natecostello/van_two_point_oh/README.md

# van_two_point_oh
Our second rodeo.

This is repository of design information for our second van build.  Ideally the contents will someday back a website.

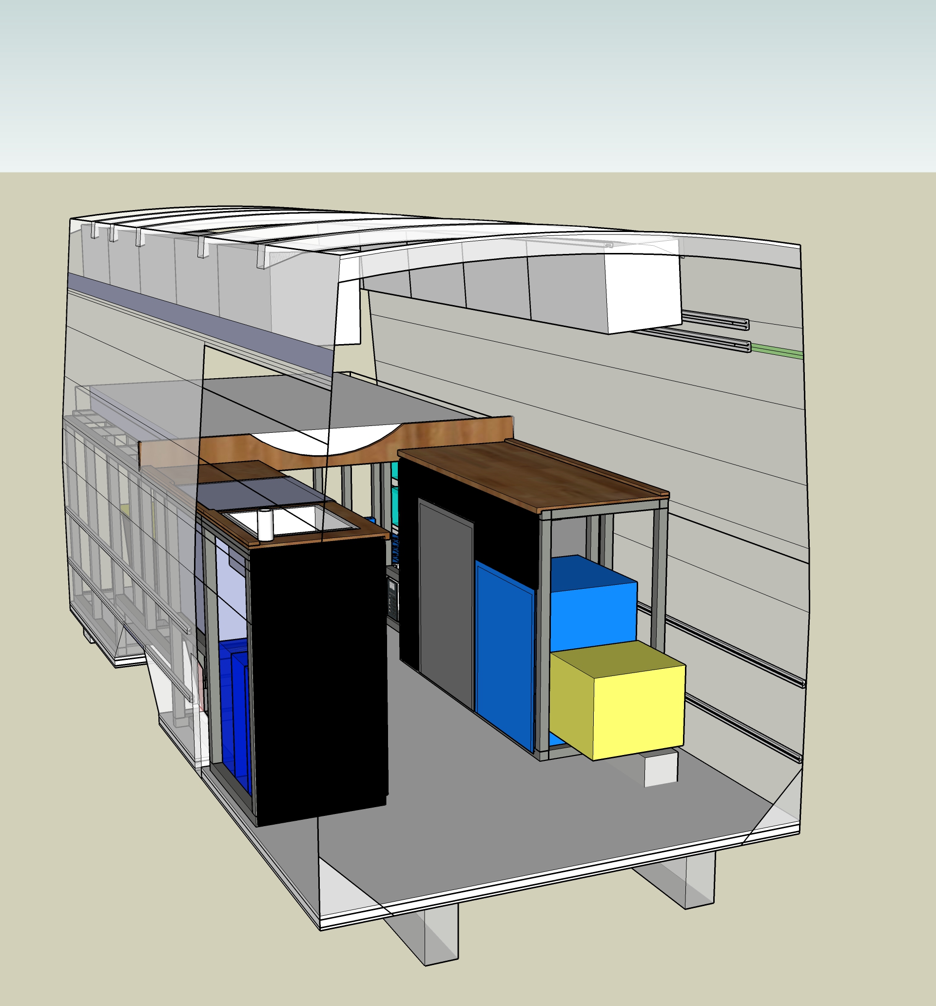
[picture p1: transit-layout-3D.jpg]
