natecostello/van_two_point_oh/van/mechanical/mechanical_overview/mechanical.mdx

---
type: categorypage
section: van
categories: 
 # one or more categories is permitted
 - structural
 - mechanical

title: '"relating to, governed by, or in accordance with the principles of mechanics"'
navTitle: Mechanical
author: Nate
date: 2021-06-06
tags:
	# no tags
metatags:
	# no metatags
cover: 
	# image file
 img: mechanical.jpeg
	# if attribution is needed
 source: Van One Point Oh
	# url: url
tldr:
---

This page provides an overview of all things mechanical.

# Structures
The structures in the van are build primarily from 8020 extrusions.

# Anchoring
All structures in the van are anchored by way of L-Track or 8020 that is inturn fastened to the van using bolts and plus-nuts.

# Fluid Systems
Water is blah
Gas is Blah.
