natecostello/van_two_point_oh/blog/2021-11-11-bus-bar-plating/bus-bar-plating.md

2021-11-10:
Plated for a few hours

2021-11-11:
Plated all remaining parallel bars

2022-2-7
Plated all remaining bars

3-16-22
Electroplated negative output bus bars

3-17-22
Electroplated positive output bus bars
