natecostello/van_two_point_oh/blog/2021-12-31-propane-system/propane-tank.md

2021-12-31
Designed and ordered propane tank brackets
Ordered bracket hardware

2022-1-4
Finished propane system design and ordered all pieces

2022-1-10
Fit check of tank + brackets (SAT)
Need to pick up two 1/4 MNPT couplings.
Installed all couplings on tank
Installed, torqued, locktited tank.

2022-1-24
Routed Propane Line

2022-1-25
Soph routed solenoid/level sensor wiring

2022-2-11
Soph primed/painted tank brackets

2022-2-15
Soph wired the stove and solenoid (internal) and relay
Soph wired the solenoid and level sensor

2022-3-26
Torqued compression fittings
Tested solenoid electrically

2022-3-27
Got tank filled
Leak tested with soap bubble test - SAT
Tested stove - SAT
