natecostello/van_two_point_oh/blog/2021-12-31-wall-panels/wall-panels-raw.md

2021-11-9:
Picked up 6 sheets of 1/4 PVC
Cut wall panel pieces (not sure if we actually used these)

12-31-2021
Confirmed upper factory holes are M8-1.25 and that thread starts ~ 1/2 below surface of wall/neoprene (so add to any length).
Also confirmed that lower strip of L-track will interfere with any bolt heads using those holes.

1-3-2022
Designed and placed order for wall panel stiffener brackets.

1-4-2022
Designed and placed order for wall panel 8020 attachment brackets.

1-6-2022
Cut two wall stiffeners
Modified one wall stiffener with wood "wedges" to account for angle.

1-11-2022
Test fit "wedged stiffener, to much wedge, not worth it
Upholstered sliding door panel as a trial and installed

1-12-2022
Cut wall panel 8020 brackets

1-13-2022
Cut wall stiffener brackeets
Soph installed plus nuts in wall stiffiner brackets
Soph installed puls nuts in wall panel 8020 brackets

1-15-2022
Marked, drilled, primed, painted holes for stiffiner bracket plus nuts
Cut 2 additional stiffiner panels
Angle drilled 8020 bolting holes to ensure flush/perpendicular bolting

1-16-2022
Installed plusnuts for angle stiffener brackets
Installed stiffener brackets and locktited
Installed wall panel 8020 brackets and locktited
Temp installed wall stiffeners for templating
Ordered fasteners and threaded inserts for fan and light switch mounting

Notes:
Fan Mount plate thickness for fastener length: 0.5 inches
Wall panel thickness for fastener length: 0.5 inches
Stiffener thickness for fastener length: 0.5 inches
Fan fastener head max diameter: 0.27 inches
Therefore need 1.25-1.5 inch long fasteners ([these](https://www.mcmaster.com/98164A444/)). 
(went short to allow mouting up in stiffener bracket region)

Light switch thickness for fastener length: 1.06 inches
Wall panel thickness for fastener length: 0.5 inches
Stiffener thickness for fastener length: 0.5 inches
Therefore need 1.75 to 2 inch long fastener

1-17-2022
Templated wall stiffener panels for fan, espar, and panel fasteners
Picked up two more expanded PVC sheets at homedepot

1-18-2022
Finished templating wall stiffener panels
Drilled wall panel stiffeners
Gun didn't work so couldn't urethane
Cut wall panels to width and length (except fwd panel)
Fitup wall panels and marked holes with transfer screws and random fasteners

1-19-2022
Added holes to passenger and driver side mid and aft wall panels.
Fit checked holes in passenger and driver mid and aft wall panels.
Sophia Upholstered passenger and driver side mid and aft wall panels.

1-20-2022
4 coats of spar urethane on wall panel stiffeners
Installed threaded inserts in passenger stiffener
Sophia added holes to the upholstered panels
Added disconnects to Passenger Fan
Added mating disconnects to Passenger Fan wiring (next time offset connectors for easier feed through)
Modified light switch to come apart easier
Installed passenger wall panels (holes are tight).  Requires stove bracket loosening and sliding stove forward...keep in mind.
Installed light switch
Installed passenger fan

1-23-2020
Sophia installed threaded inserts on panels
Sophia swapped L-track spacers for 1/2 inch

1-26-2022
Soph added 5/16 plus nut for passenger fwd panel fastening
Soph added through bolted passenger fwd panel in two more locations on fwd edge
Soph increased hole size on driver side panel
Soph installed driver mid panel

1-31-2022
Installed driver aft panel
Installed driver fan
Tested both fans SAT

2-28-22
Soph cut forward driver panel

3-1-22
Soph covered and installed forward driver panel
