natecostello/van_two_point_oh/blog/2021-7-4-battery-interconnect-fab-trial/battery-interconnect-fab-trials.md

---
type: post
section: blog
categories: 
 # one or more categories is permitted
 - electrical
navTitle: 
title: Battery Interconnect Fabrication Trials
author: Nate
date: 2021-07-04
tags:
 - build
 - electrical
 - battery
 
metatags:
	# no metatags
cover: 
	# image file
 img: interconnect-cover.jpeg
	# if attribution is needed
	# source: [vecteezy]
	# url: url
tldr: 'We performed some fabrication trials of our series and parallel interconnects.  We concluded that portions of the design were not able to fabricated.  Based on these lessons we planned another design iteration.'
---
**TLDR: We performed some fabrication trials of our series and parallel interconnects.  We concluded that portions of the design were not able to fabricated.  Based on these lessons we planned another design iteration.**

We laid out our plans and design for our battery interconnects in a [previous post](/blog/2021-6-26-battery-interconnect-design/battery-interconnect-design).  Start there if you want some context.  This is post is about the difference between theory and practice.  Hah.  

## The Process

We received our initial (test) batch of flat copper bus bars from [sendcutsend.com](http://sendcutsend.com) on Friday, and got super excited.  We spend Saturday thinking about how we might actually form them into the desired shape.  Honestly, we'd been mulling that over since the design post or before, but nothing focuses the thought like the immediacy of a task.  Despite a lack of a final plan, we went to Home Depot to pick up some M6 bolts, nuts, wood dowels, and some bar stock that we figured would be useful in any case.
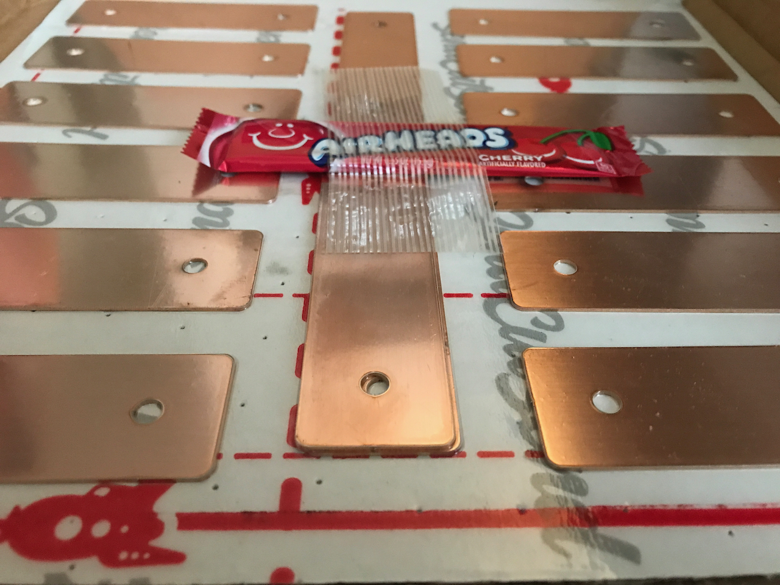
[picture p106: blog/2021-7-4-battery-interconnect-fab-trial/sendcutsend.jpeg]
sendcutsend delivery

_These people rock.  Seriously.  Fast service, accurate tolerancing, and free airheads.  What!_

One of us awoke this morning with a vision for bending and set off for the garage and the table saw within it.  The sensible other joined later.

Our approach involved all wooden parts, except the bolts and nuts.  We use a short piece of dowel cut in half to start the bend.  We help that by driving the ends of the busbar inward.  The wood pieces are sized to fit together so that when everything is fully scrunched, the holes are in the right locations.  That was the idea at least.

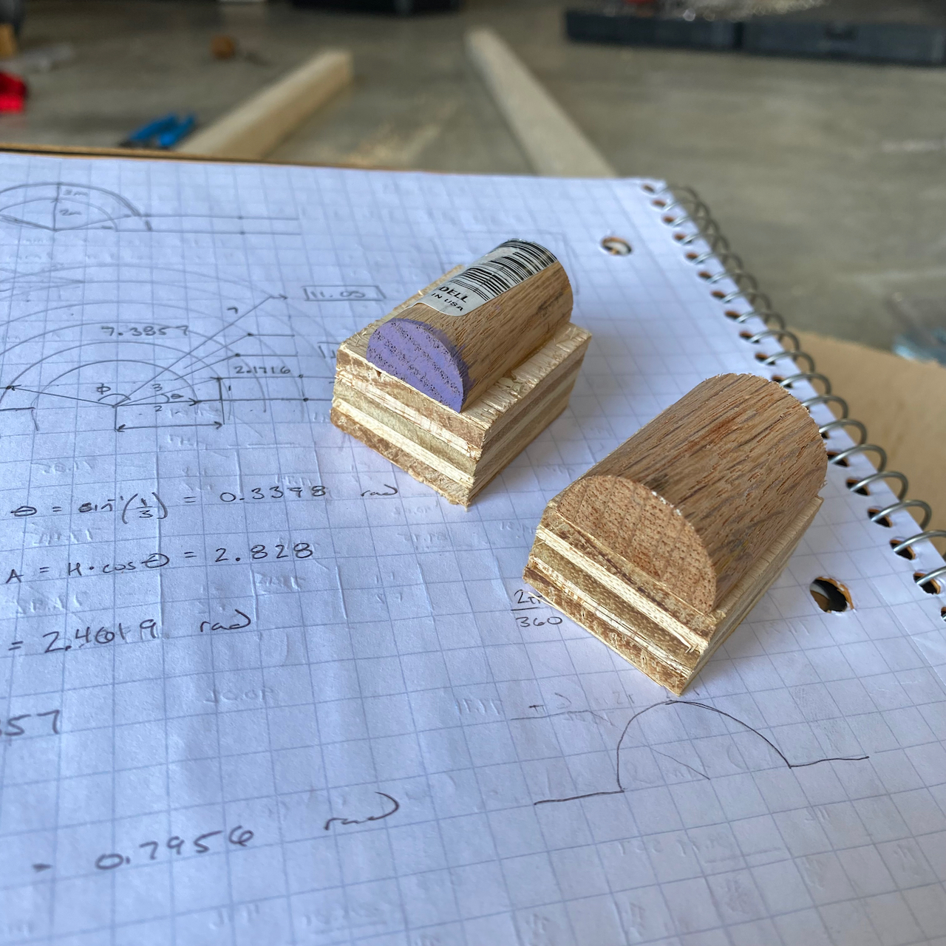
[picture p107: blog/2021-7-4-battery-interconnect-fab-trial/mandrels.jpeg]
mandrels

_These are two mandrels, one for 3/4 inch diameter bends, and one for 1 inch diameter bends (just in case).  They are sitting on some bending math_

The flat bus bar passes over two M6 bolts on two independent pieces of wood that can slide closer or farther from each other.  Those pieces of wood are kept from moving "out of plane" by two other pieces of wood that hold them down but let them slide.
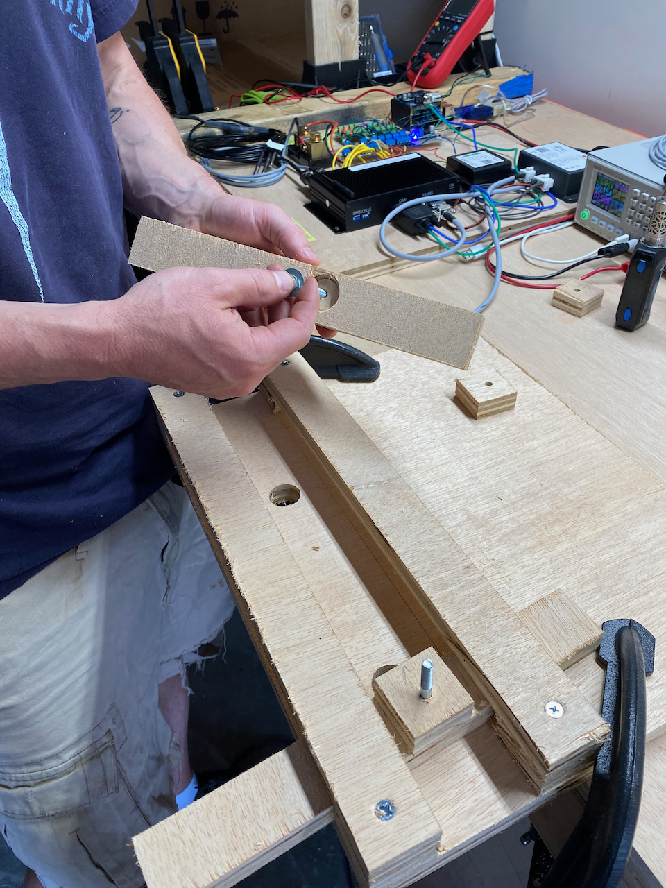
[picture p108: blog/2021-7-4-battery-interconnect-fab-trial/wood-bolt.jpeg]
wood sliders


Two more peices of wood go over the bolts and it all gets tightened down with nuts and washers.  Then come the "mandrel" and clamps.  We use one clamp to force the mandrel down into the bus bar.  Then we use the other clamp to push the two sliding pieces of wood toward each other.

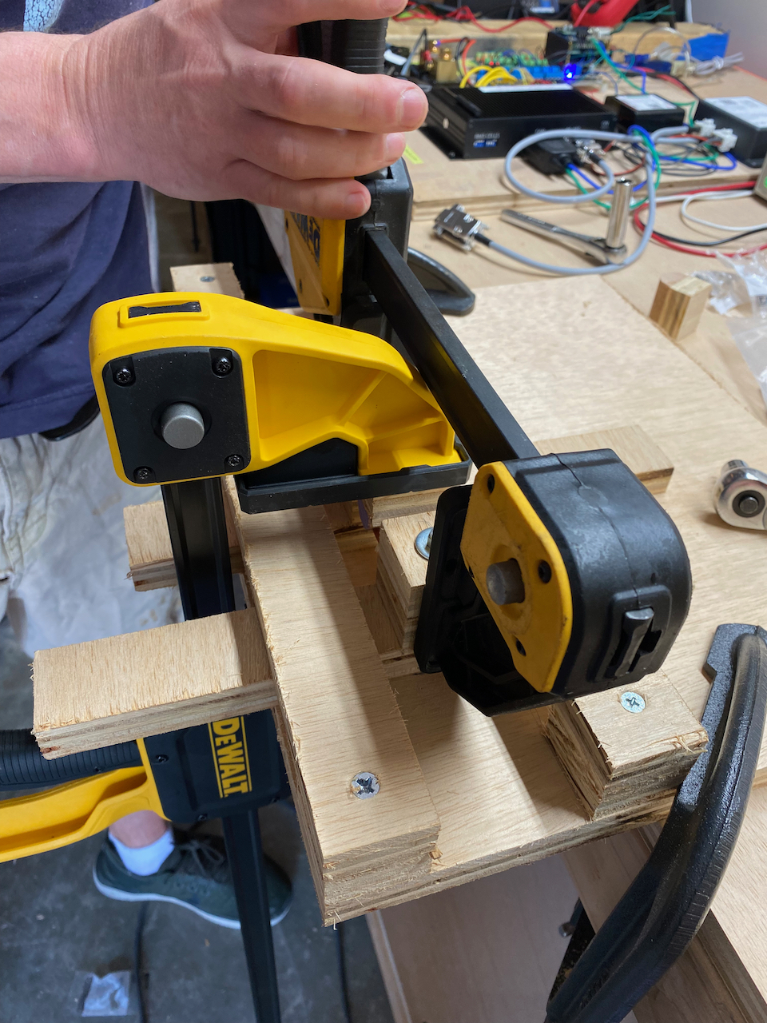
[picture p109: blog/2021-7-4-battery-interconnect-fab-trial/clamps.jpeg]
clamps


We alternate the clamps until the two sliders are as close to each other as they can get.  At that point they are touching the mandrel which prevents further movement.  Thats it.  You have a fully formed busbar.  

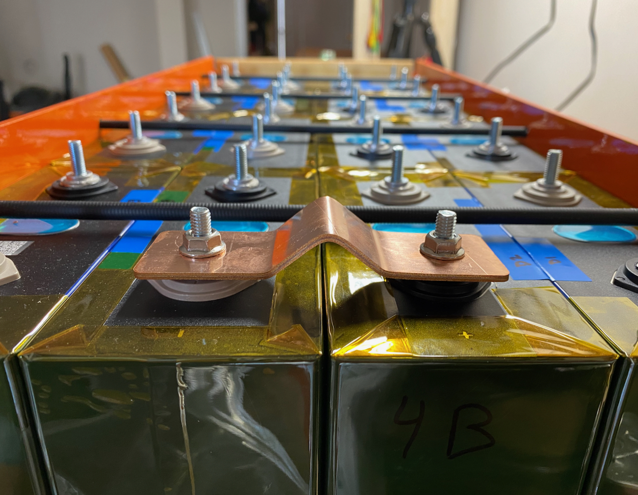
[picture p110: blog/2021-7-4-battery-interconnect-fab-trial/interconnect-installed.jpeg]
Final interconnect


I'm sure that all sounds confusing.  This time-lapse will make it more clear.

`vimeo: https://vimeo.com/571057210`

## The Learning

We learned a few things:

- We might want to go slightly larger on the holes.  Like 0.25 mm or something.  They are pretty tight on the posts.
- We are able to form a stack of two bars at once so the parallel connection fabrication method is proven.
- The process produces triangular vs round bends (no surprise given the process).
- We CANNOT form a stack of five bars at once.  We think we are at the limits of geometry and copper compliance.  But we think we have a solution with using multiple sets of slightly longer bars and different mandrels to make a stack of five stack tightly.  This is required for the endmost series connection which is in the athwart direction.

Based on that last lesson, we may retreat to straight slotted bars for the other series connections due to the lower fore-aft cell growth and no concern about contact area for those connections.

Then we watched fireworks.  Happy July 4th!
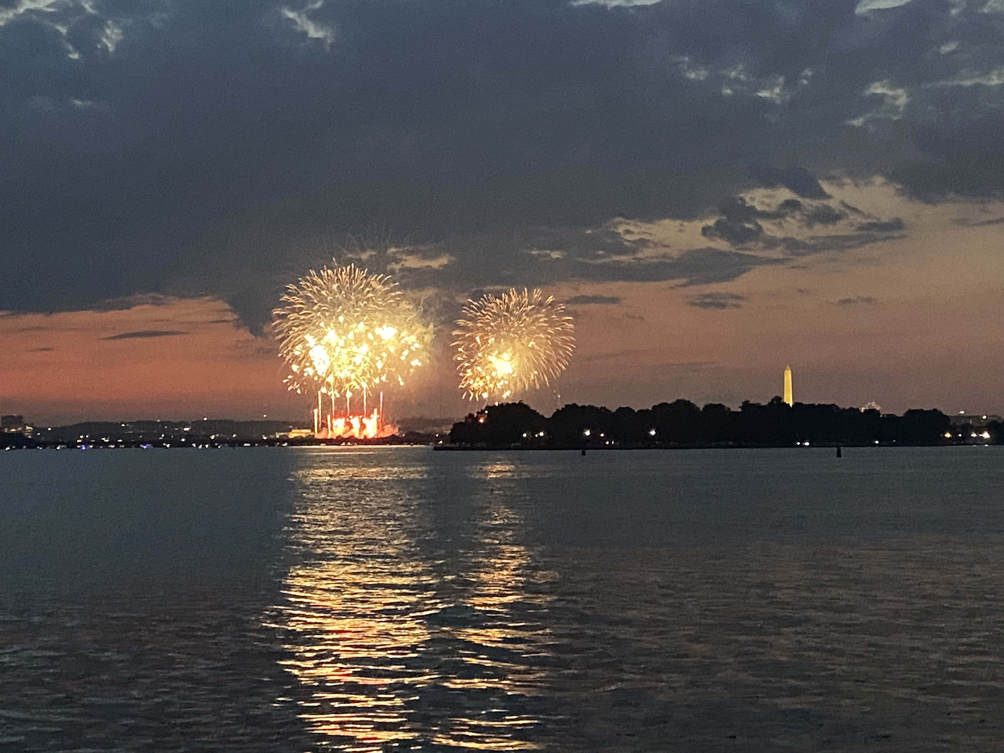
[picture p111: blog/2021-7-4-battery-interconnect-fab-trial/fireworks.jpg]
fireworks over the potamac
