natecostello/van_two_point_oh/blog/2022-10-19-mistygate/mistygate.md

Going the slider route.

These are low-profile enough to clear the door:
https://www.accuride.com/en-us/products/2907-light-duty-low-profile-slide-with-over-travel

The length will be the 24" model.
Weight: 

Will need to double up 8020 to mount on bottom, maybe top.  Will mount flat overhanging bar to the face, and then tuck 1/4 wood panel behind, hole saw'ed out in an array for ventilation.

Can mount to 80/20 using https://www.tnutz.com/product/qt-015/ #8-32 tnuts and screws.  Will need to source low head #8 machine screws.  These [screws](https://www.mcmaster.com/90357A003/) could/might/did work.

Will VHB 1/8 by 3" Flat bar to top and bottom slider
Weight: 24"*2 is 1.76 lbs

Grate material will VHB behind the flat bar.

10-19-2022
Ordered low profile 8-32 1/2" screws.
Ordered sliders.

10-29-2022
Installed sliders

?
Purchased grate material

12-16-2022
Purchased Aluminum flat bar

1-1-2023
Installed aluminum bar with VHB
Installed grate, but too floppy and not holding (should have scuffed)

1-2-2023
Ordering 1/2 1/8 aluminum flat bar for verticals
https://docs.google.com/spreadsheets/d/1BjMtbgCNEiRAJeGTX1tJmbIwtguQ2OwXgFV9McPPzyY/

1-3-2023
Picked up flat bar
Wrapped in black contact paper and VHB'd into place
Realized it was to easy to turn into a parallelagrem
Trimmed grate to fit in front of bars and zip tied into place
Zip ties to large and bump 8020 on open and close

1-4-2023
Replaced zipties with smaller ones, now no interferance
Disabled lower lock on sliders with metal clips

2-16-2023
Disassembled mistygate and drilled out lower locking mechanism.  Much smoother.

2-17-2023
Rebuilt mistygate with rub between lower rail and nosing eliminated, better ziptie-ing.  Works great.
