natecostello/van_two_point_oh/blog/2022-2-11-main-lights/main-lighting.md

2022-2-11
Routed new 12/2 cable from panel area to upper d-pillar
crimped extensions on LED strips
Cut and installed track
installed LED strips
wired controller
installed controller with 3m super velcro to top of driver's l-track
wired controller, and synced controls.
test SAT!
