natecostello/van_two_point_oh/blog/2022-2-3-overhead-shelf/overhead-shelf.md

2022-2-3
Soph installed the van-wife shelf
Open question about extra brackets (soph emailed them)
