natecostello/van_two_point_oh/blog/2022-3-5-side-tables/sidetables.md

3-5-2022
Picked up okoume for side tables
Cut side tables at wood shop

3-6-22
Formica'd one side table top

3-8-22
Formica's one side table top
Trimmed formica
Eurethaned side table panels

3-10-22
Finished side table design
Cut end panels
Added pocket screw holes
Cut tops

3-12-22
Urethaned all side table pieces
Assembled one side table

UPDATE:
Assembled second side table 3-14?
Installed side tables 3-14?
Installed outlets?
