natecostello/van_two_point_oh/blog/2022-3-8-reading-lights/reading-lights.md

3-7-2022
Soph drilled, fitcheck panels, painted and primed.

3-8-2022
Installed and wired reading lights into panels using and installed panels usng spacers and clipnuts and #6 hardware.
Wired reading lights.
