natecostello/van_two_point_oh/blog/2022-3-?-slider-storage/slider-storage.md

not sure
installed slider structure

not sure
installed sliders

3-25-22
Cut and drilled slider angle

3-26-22
Cut and urethaned slider drawer panels
Pocket drilled slider panels
Build slider drawer

5-9-22
uninstalled slider and replaced with bins

test-delete
