natecostello/van_two_point_oh/blog/2022-5-14-BMS-firmware-update/firmware.md

REC provided a [firmware update](bms_1Q_1845_end_voltage_drop_zero_curent.bin) that should provide the cycling behavior we desire.  Specifically, once the battery is full, all charging should stop and the battery should discharge until a given point until charging reverts to bulk.

Got a hardware/software mismatch message when resetting BMS.
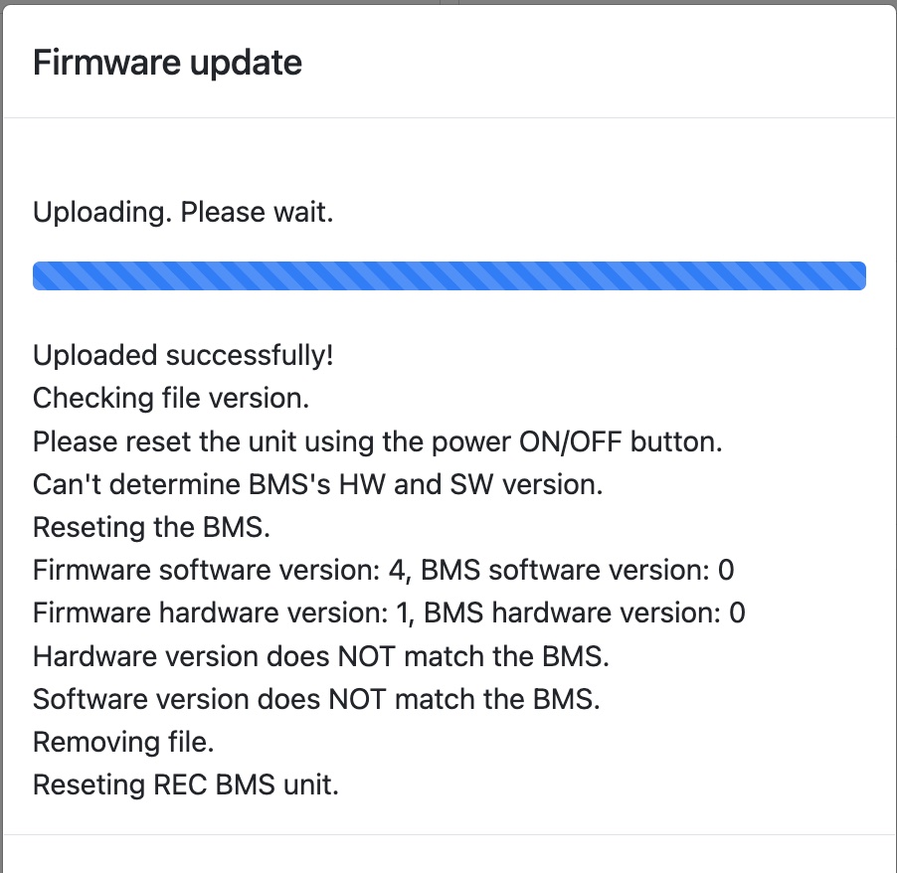
[picture p154: blog/2022-5-14-BMS-firmware-update/update-message.jpg]


Will try to reset with shorepower applied so router remains powered and connection to wifi module is maintained in case this is the problem.

This worked and update occurred successfully.
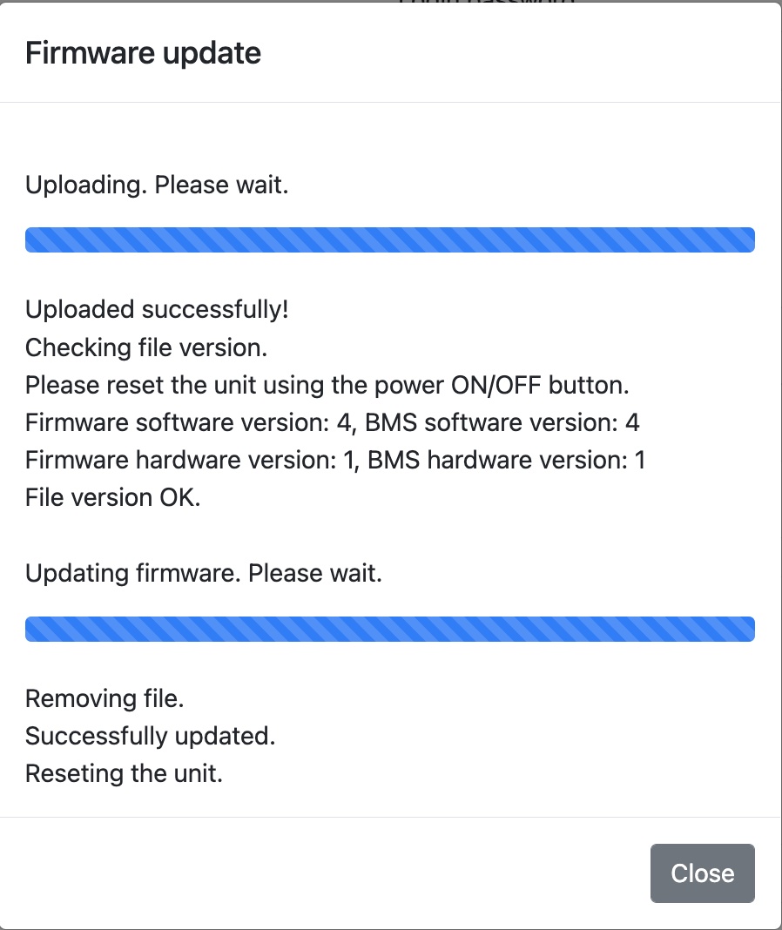
[picture p155: blog/2022-5-14-BMS-firmware-update/update-message-successful.jpg]


BMS Software version is now 2.8 (was 2.6).

Will run a shorepower charge to observe behavior at end of charge.  Recall SOCH is 0.15 so it should cycle down to 85% SOC prior to resuming a bulk charge.

2022-5-19
Based on emails from Tine, begrudgingly set CHAR to 3.5V and MAXH to 0.15 (MAXC-CHAR).

5-27-2022
Terminated logging pi with a DTM connector to interface with wakespeed CAN and ring terminals for 12V power.
Unsolderd/Soldered logging pi for standard vs OBD2 can.

2022-5-29
Connected loggingPi to power, and verified accessible over SSH.

Connected wakespeed to Victron CERBO, removed Victron CAN terminator, and added wakespeed CAN terminator at wakespeed.

Connected loggingPI to wakespeed CAN via harness DTM connector.

Verified REC was still communicating with CERBO via the local web interface.

Verified loggingPI can read REC data over CAN using this script: https://github.com/natecostello/REC-BMS_CAN

2022-6-10
Identified that SOC has dropped below 85% yet charging hasn't started.  Based on a read of the manual for the latest firmware, this is because SOC must be < 100 - SOCH AND Max cell Voltage < CHAR - CHIS.  In our case that is equal to 3.25V.  Based on this we are going to modify CHIS to adjust for our lower CHAR.  Default: CHAR (3.58) - CHIS (0.25) = 3.33. Cell voltage should be below 3.33V at 85% SOC, so we will us CHIS = 3.5-3.33 = 0.17

Based on this change we saw PV charging start and the CCL ramp from zero up to 280A.

Also modified BMS auto testing code to log charging events (or any event).  Charging off shore at near multiplus limit and logging response (to finally get some detailed data).

2022-6-29
Changed SOCH to 0.6 to allow to cycle down to 40% SOC.  With Alternator charging its been cycling 80-100 daily.  Will reconsider once a switch for alternator charging is implemented.
