natecostello/van_two_point_oh/van/electrical/alternator_charging/alternator_charging.md

---
type: article
section: van
categories: 
 # one or more categories is permitted
 - electrical
navTitle: 
title: Alternator Charging
author: Nate
date: 2020-10-26
tags:
 - 24v
 - design
 - concept
 - electrical
 - van
 - alternator
 - charging
 - factory

metatags:
	# no metatags
cover: 
	# image file
 img: alternator-cover.JPG
	# if attribution is needed
	# source: [vecteezy]
	# url: url
tldr:
---

**TLDR:** The APS [24V 185A alternator](185-hpi-series-high-output-alternators.pdf) will provide a ~4800KW charge rate during highway driving (70 mph) and SEIC high idle (2050 RPM) conditions.

Alternator charging using a dedicated 24V alternator will provide for rapid battery charging.  We plan to make use of Ford's Stationary Elevated Idle Control (SEIC) to maximize charge while parked and needing to charge.

## Factory Alternator Charging

Factory alternator charging was originally being considered to supplement the dedicated 24V alternator.  This could add up to ~2000W charge rate.  We elected not to implement this due to lack of need, additional complexity and weight.  See the deprecated version of this page for design information related to this option and lots of additional save-for-posterity information.

## Second Alternator Charging

Two alternators are under consideration for the second alternator charging source.  Nations, per discussions via email, can provide a [24V 150A alternator](24v-150-specs.pdf).  American Power Systems, per telephone discussion, can provide a [24V 185A alternator](185-hpi-series-high-output-alternators.pdf).

APC vs Nations
_Note: 630 RPM is base idle, 800 RPM is the SEIC minimum, 2050 RPM is 70 mph cruise, 2400 is the SEIC maximum._ 

### Comparison Details

The details are in this [google spreadsheet](https://docs.google.com/spreadsheets/d/1PZ28vauZOBcX5VKHcEtaARwbSTpMoWLsqBCX2Hrulv8/edit?usp=sharing). I took the data sheets for the two candidate alternators, and used a 6th order polynomial fit on the performance data points.  The crank pulley diameter is 6 inches, inferred from APS alternator test data and help from the forum.  From the polynomial fit and the respective pulley ratios, the estimated performance curves can be overlaid.  The 3.5 pulley ratio was taken from the Nations datasheet as "typical" but is not confirmed.

While the idle performance of the Nations alternator is superior, substantially higher charge rates are possible with the APC alternator under higher SEIC and cruise conditions.  On that basis, we have selected the APS.  Based on an email with Jim at APS, the APS alternator cuts off below 1905 RPM.  In a followup email he confirmed the cutoff occurs at 1905 alternator-RPM which corresponds to 650 engine-RPM.  This cutoff would predict no alternator charging at idle.  **Update:** Based on testing, this prediction is correct.  The APS option does not provide any charging at normal minimum idle.

### Regulator

We plan to use a Wakespeed WS500 for regulation and charge control from the second alternator.  It is proven to integrate well with the REC BMS and Victron ecosystem.

### Snubber

We will use this [Stirling Alternator Protection Device](sterling-alternator-protection-device) to function as a last line of defense to an inadvertent "load shed" that can damage an alternator.  If the alternator is sourcing high current to a load (i.e. battery) and the connection is broken without warning a high voltage is developed at the output of the alternator that can fail the high power rectifier diodes in the output stage of the alternator.  This voltage transient is either due to the alternator suddenly being in a max field, high speed, yet open circuit condition OR due to inductive kick from the alternator's inductance trying to maintain current flow under a step change to high impedance.  Probably the latter, maybe both.  I haven't gone into the details but know from experience the transient is completely credible and likely.  This should never happen.  Before the BMS ever opens the main contactor as a protective measure, it is supposed set its Charge Current Limit to 0 amps via CANBus and set CHARGE-ENABLE to "low" seconds before it opens the relay.  But in case the software protection fails, and the primary hardware backup protections fails, this provides a second hardware backup to physically limit the magnitude of the transient voltage developed by the alternator.
