natecostello/van_two_point_oh/van/electrical/circuits/circuits.md

---
type: article
section: van
categories: 
 # one or more categories is permitted
 - electrical
navTitle: 
title: Circuits
author: Nate
date: 2020-10-26
tags:
 - wiring
 - design
 - concept
 - electrical
 - van

metatags:
	# no metatags
cover: 
	# image file
 img: circuits.jpeg
	# if attribution is needed
	# source: [vecteezy]
	# url: url
tldr:
---

This article describes the power circuits planned for the van and evaluates required wire gauge for those circuits.  All calculations are contained in [this google spreadsheet](https://docs.google.com/spreadsheets/d/1JnF0Kgj202dYR1sIlWKawStD7OvVsGdwfCOEQsTpghI/edit?usp=sharing).

## Outlet, Switch, Control Locations

120VAC outlets will be in the following locations:

* Comm Area
* Garage Area
* Counter Level - Driver Side 
  * [This](https://www.farmandfleet.com/products/148585-carlon-shallow-box.html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) (1.25 depth) or [This](https://www.zoro.com/cantex-electrical-box-square-pvc-ez08sf/i/G3145073/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) (1.25 depth) could place these against bed
* Counter Level - Passenger Side
* Under Counter - Driver Side
* Under Counter - Passenger Side
* Slide Door Area

USB C Outlets will be in the following locations:

* Counter Level - Driver Side
* Counter Level - Passenger Side

12VDC Outlets will be in the following locations:

* Upper Shelf - Driver Side
* Comm Area

Heater Control will be located in/on the driver side bed side cabinet.

Max Fan Control will be located in/on the driver side bed side cabinet.

Water Pump On/Off will be located on the side of the sink cabinet, easily accessible from outside with the door open.

Gas Solenoid On/Off will be integrated into the oven on/off switch.

Light On/Off/Dim will be located on the side of the sink cabinet, easily accessible from outside with the door open.  There will also be a switch located in the bed area on the passenger side in the bed side cabinet.

## 120VAC Circuits

Based on the 30A rating of our Shorepower ELCI Breaker and the AC Main Breaker, all AC wire between the Shorepower connection and the AC Main Breaker Panel will be 12AWG triplex marine wire.  Branch circuit AC wire and AC wire between the factory-alternator-inverter will be 14AWG triplex marine wire.

### Shorepower

The shorepower circuit will run from the outlet under the driver side rear bumper, up inside the D-pillar, forward through the driver wall void to the shorepower ELCI main breaker.  From that breaker it will tie locally to the shorepower/factory-alternator-inverter transfer switch.  The transfer switch will then tie to the AC input power connection on the Multiiplus 24/3000.  One way length is 11.8 ft (93+24+24").

### Factory-Alternator-Inverter

The factory-alternator-inverter circuit will run from the inverter location, forward of the freezer cabinet, aft through the driver wall void to the transfer switch adjacent to the AC Main Panel.  One way length is: 10.7 ft (80+48").

### Branch Circuit

The branch circuit will run from the AC Main Panel, aft through the driver wall void, to a GFCI outlet in the driver side rear garage, forward through the driver wall void, to an outlet inside the aft most driver galley cabinet, up to an outlet in the driver bed/counter region, down to the driver wall void, up and inside the C-pillar, across the C-pillar roof beam, down and inside the passenger C-pillar, into the passenger wall void, to an outlet inside the aft most passenger galley cabinet, up to an outlet in the passenger/counter region, down through the passenger galley to an outlet on the side of the sink cabinet.  The one way length is: panel to driver side rear garage and back (93+24+93+24) + inside the driver galley and up to the driver counter and back (60+60) + down to, up though over, and down through the c-pillar (268) + to passenger cabinet and up to passenger counter and back (68+68) + to end of sink cabinet (67).  Total one way length is 68.75 ft.  [Post-install update: we added a short run of triplex from the outside rectangular hole in the by the bumper to parallel off the GFCI]

## 24VDC Circuits

### Water Pump

The Water Pump is a Shurflo Aqua King II Supreme 5.0.  Shutoff current is 6A at 25.6V.  Open flow current is 2A at 25.6V.  The pump will be located in the sink cabinet.  The feed and return will run from the 24V electrical panel up and inside the driver C-pillar column, across the C-pillar roof beam, down and inside the passenger C-pillar column and into the sink cabinet.  Estimated round-trip length is 55.8ft (2x(268+67)").  Acceptable wire gauge is 12AWG.

### Fridge and Freezer

The Fridge and Freezer combined are 83W, corresponding to ~3.5A at 24V.  They will share a circuit.  The feed and return will run from the 24V electrical panel, forward through the driver wall void, and into the top of the fridge cabinet (where the fridge and freezer compressor are located).  Estimated round-trip length is 13.3 ft (2x80").  Acceptable wire gauge is 16AWG.

### Air Compressor

The onboard air system will notionally use a [Viair 400C](viair-300c-manual.pdf) compressor with a peak draw of 12A.  Based on the wire diagram for the dual compressor configuration, separate relays are controlled by the pressure switch, thus separate feeds from the power source are fine.  Thus we assume 12A and will add a second wire run for a dual system if desired down the road. The feed and return will run from the 24V electrical panel forward through the driver wall void, though the C-pillar, down through a wall void floor cut, under the van along frame and to the passenger rear corner.  Estimated round trip length is 33 ft (2x(93+77+30)").

Based on the wire gauge guide in the manual, it follows the ABYC Critical (3%) voltage drop guidance for 24V assuming the manual wire length is round trip.  Based on this, required wire guage is 10AWG or sharpen the pencil on length (cutting 30" gets below 3% with 12AWG).

### USB Outlets

USB outlets will be located PORT and STBD at the foot of the bed/start of counter.  Each side will have a bluesea below deck panel, modified with a 24V breaker, and will house two double-USB sockets.  The USB PD spec allows for power up to 100W via USB-C.  We will assume this standard, which would require 200W at each outlet location.  This corresponds to 8.3A each, thus they will each have their own circuit.

The driver feed and return will run from the 24V electrical panel up to the outlet.  Estimated round trip length is 10 ft (2x60").  Acceptable wire guage is 16AWG.

The passenger feed and return will run from the 24V electrical panel forward through the driver wall void, up and inside the driver C-pillar column, across the C-pillar roof beam, down and inside the passenger C-pillar column, aft through the passenger wall void, and up to the outlet.  Estimated round trip length is 56 ft (2x(268+68)").

Required wire gauge (using passenger side limiting case) is: 10AWG.  Assuming 12AWG at 25C, voltage drop is 3.15, and under 3% if 36" can be eliminated.  We will plan to use 12AWG.

__Note: The USB PD 3.1 spec allows for power up to 240W via USB-C.  The cable requirements to supply two 240W sockets at 24V is excessive (8AWG or greater).__

### LED Strip Lights

Four runs of LED strip lighting will run fore-aft in the van along the ceiling and walls.  [This Govee package](/van/functional/lighting/lighting) is the preferred option.  Power for the full length is 60W corresponding to 2.5A.  One switch will be located on the side of the sink cabinet near the entry way.  Another switch will be located on one side of the bed.  The dimmer/control will be located adjacent to the switch by the bed.  Feed and return will run from the 24V electrical panel, forward through the driver wall void, up and inside the driver C-pillar column, across the C-pillar roof beam, down and inside the passenger C-pillar column, out and up to the switch on the forward side of the sink cabinet.  From that switch it will run back inside the passenger wall void aft of the c-pillar and up to a switch by the passenger side bed.  [Post-install update: For the run between the galley and bed switches, we ran 12x3 triplex since three wires are required.]

Estimated round trip length is 78.3 ft (2*(268+67+67+68)"). Acceptable wire gauge is 12AWG.

We will also want to run two sets of 4 wire to splice in after the controller that runs to the start of the LED strip lighting.  The best location for the start of the LED strip lighting is the forward edge of the ceiling. [Post-install update: For the run from the lighting controller to the lights we ran two sets of 16x4 ancor trailer wire.]

**Update:**

We are pivoting to [these](https://www.ledsupply.com/led-strips/tunable-white-cob-led-strip-lights) lights instead and wireless controls.  We are also moving theh lower light strips down to the surface of the bed side tables and counter top.  We are ending the ceiling lights at the curved transition of the roof.  This means four run that are > 12ft.  This corresponds to a total load of 205W or 8.5A up to the driver.  From the driver on to the LED strips it is 2.2A.  Driver will be located above ceiling panel on driver side at rear.  Estimated round trip length to driver is 32.2 ft (2*(93+80+20)) at 8.5A.  From the driver, the limiting run is over to passenger side, down d-pillar, up to aft end of side table (plus margin) for 30 ft 2*(40+80+40+20) at 2.2A.  Based on these numbers, 12AWG duplex from the panel to the driver is acceptable.  14AWG triplex from the driver to lights is acceptable.

Wireless (Battery Powered) Controllers will be located at the passenger door and near foot of bed.

### Reading Lights

The two reading lights will be located in the rear overhead pillar.  The feed and return will be run from the electrical panel aft through the driver wall void, up and inside the D-pillar and to the overhead rear pillar.  Estimated round trip length is 42.3 ft (2*254"). Acceptable wire gauge is 16AWG.

### Exterior Lighting:

Exterior lighting will be handled in the future.  It will probably consist of four separate circuits (Front, rear, PORT, STBD).

### Bed-side Fans

The two Sirocco II fans combined are ~12W corresponding to ~0.5A at 24V.  They will share a circuit.  The feed and return will run from the 24V electrical panel, up to the driver fan, down, forward through the driver wall void, up and inside the driver C-pillar column, across the C-pillar roof beam, down and inside the passenger C-pillar column, aft through the passenger wall void, and up to the passenger fan.  Estimated round-trip length is 76 ft (2x(60+60+268+68)").  Acceptable Wire gauge is 16AWG.

### Propane Solenoid

The propane solenoid load is ~20W corresponding to ~0.8A at 24V.  The feed and return will run from the 24V electrical panel up and inside the driver C-pillar column, across the C-pillar roof beam, down and inside the passenger C-pillar column and into the stove cabinet to a relay, from the relay into the passenger wall void, though a wall void floor cut, under the van along the frame to the propane tank behind the rear differential.  Estimated round-trip length is 72.7 ft (2x(268+36") + 2x(36+36+60)".  Acceptable wire gauge is 16AWG.

### Outlets (Driverside Overhead Shelf)

Originally planned for this cable to be 12V however the required guage is a deal breaker, so we will run 24V and convert locally if needed.  This cable run will be for future expansion.  Assume 200W at 8.33A load.  The feed and return will run from the 24V fuse block forward though the driver wall void, up and inside the C-pillar, forward through the upper driver wall void to the overhead shelf region.  Estimated round trip length is 41.2 ft (2x247").  Acceptable wire gauge is 12 AWG.

## 12VDC

### Communication/Computation

These loads are all local to the 12V fuse block such that their wiring will not be factored into any bulk cable purchase/size determination.

### Heater:

The B4L max load is <= 100W corresponding to ~8A at 12V.  The feed and return will run from the 12V fuse block aft through the driver wall void, to the heater ~~just aft of the driver rear wheel~~ just forward of the freezer.   Estimated round trip length is ~~2x52"~~ 2x(68+40).  Required wire gauge is 12AWG.  [Post-install Update: We just used the stock power line from the heater, which should be sized appropriately.]

### MaxxFan

The MaxxFan load is ~38W corresponding to ~3A at 12V.  The feed and return will run from the 12V fuse block aft though the driver wall void, up inside the D-pillar, across the D-pillar roof beam to the fan.  Estimated round trip length is 2x254".  Wire gauge is 12AWG.

### Oven

The oven max load is not listed in the manual but is expected to be minimal (LEDs, sparkers, and relay modification) and bounded by any other 12V components.  The feed and return will run from the 12V fuse block up and inside the driver C-pillar column, across the C-pillar roof beam, down and inside the passenger C-pillar column and into the stove cabinet.  Estimated round trip is 50.7 ft (2x(268+36)").  Acceptable wire guage is 16AWG.

## Routing Length Notes

* 24V electrical panel forward through the driver wall void, up and inside the driver C-pillar column, across the C-pillar roof beam, down and inside the passenger C-pillar column = 268"  
* Passenger C-pillar column, out and up to the switch on the forward side of the sink cabinet = 67"
* 24V electrical panel, forward through the driver wall void, and into the top of the fridge cabinet = 80"
* Passenger C-pillar to foot of passenger side of bed = 68"
* 24V panel to foot of driver side of bed = 60"
* 24V panel to base of driver D-pillar = 93"
* Base of driver D-pillar, down to passenger D-pillar = 77"
* Base of passenger D-pillar to compressor mounting area = 30"
* Driver C-pillar to forward of freezer estimated to 40"
