natecostello/van_two_point_oh/van/electrical/inverter/inverter.md

---
type: article
section: van
categories: 
 # one or more categories is permitted
 - electrical
navTitle: 
title: Inverter
author: Nate
date: 2020-11-03
tags:
 - inverter
 - design
 - concept
 - electrical
 - van

metatags:
	# no metatags
cover: 
	# image file
	# img: img
	# if attribution is needed
	# source: [vecteezy]
	# url: url
tldr:
---

The van will use an inverter/charger to convert DC to AC power to supply AC loads.  It will also allow battery charging while on shore power.

## Selection

Based on our experience, we will be using a Victron inverter/charger.  The two choices, given our 24V DC system, are the Multiplus 3000VA  and the Multiplus Compact 2000VA inverter/chargers.

Advantages/Disadvantages
