natecostello/van_two_point_oh/van/electrical/knock-off-panels/knock-off-panels.md

This is a place holder for custom panels for contura switches and usb plugs.
