natecostello/van_two_point_oh/van/electrical/ShorePower-AuxSolar-Connection/Shore-Power-and-Aux-Solar-Connection.md

---
type: article
section: van
categories: 
 # one or more categories is permitted
 - electrical
navTitle: 
title: Shore Power and Auxilliary Solar Connection
author: Nate
date: 2020-10-26
tags:
 - shore power
 - solar
 - design
 - concept
 - electrical
 - van

metatags:
 # none
cover: 
	# image file
	# img: img
	# if attribution is needed
	# source: [vecteezy]
	# url: url
tldr:
---

Our shore power and auxilliary solar panel connection will copy the Lorax by connecting under the rear pillar.  He provides some details in [this post](https://www.fordtransitusaforum.com/threads/the-lorax-build-thread.72698/post-1074290). 

The solar panel connection is from AM Solar, [here](https://amsolar.com/rv-connections/plug-prtbl-batt-8ga).
