natecostello/van_two_point_oh/van/functional/heating/espar_location.md

---
type: article
section: van
categories: 
 # one or more categories is permitted
 - functional

title: Heating
navTitle: 
author: Nate
date: 2020-11-04
tags:
 - van
 - functional
 - concept
 - design
 - heating
 - espar
 - hvac
 - climate
	# no tags
metatags:
	# no metatags
cover: 
	# image file
	# img: img
	# if attribution is needed
	# source: [vecteezy]
	# url: url
tldr:
---

The Espar EasyStart Pro controller appears to be an improvement on the EasyStart Timer we used for Van 1.0.  It has integrated diagnostics and an integrated temperature sensor.  It's about $195 at [esparparts.com](https://www.esparparts.com/).  Their Transit kit includes the EasyStart Pro.

[Link to forum post of transit under-passenger-seat install](https://www.fordtransitusaforum.com/threads/successful-espar-b4l-m2-heater-install-notes.82387/post-1071077)

[Link to forum post of transit behind-driver-seat install](https://www.fordtransitusaforum.com/threads/need-espar-heater-location-pros-and-cons.82516/post-1072428)
