natecostello/van_two_point_oh/van/functional/refrigeration/refrigerator.md

---
type: article
section: van
categories: 
 # one or more categories is permitted
 - functional

title: Refrigeration
navTitle: 
author: Nate
date: 2020-11-17
tags:
 - van
 - functional
 - refrigeration
 - concept
 - design
 - appliance
	# no tags
metatags:
	# no metatags
cover: 
	# image file
 img: fridge-cover.jpeg
	# if attribution is needed
	# source: [vecteezy]
	# url: url
tldr:
---

**TLDR: For lots of reasons (arrangement flexibility, efficiency, maintainability, etc) we are going with Vitrifrigo.**

Fridge: Vitrifrigo 4.7cuft 62.6lb 24V - Model: C130RBP4-F-1 (FRIDGE ONLY)

Freezer: Vitrifrigo 1.8cuft 60 lbs - Model: C55RBN4-F-1

## Fridge/Freezer Options

Vitrifrigo has a separate compressor/condenser that might be good for arranging and optimizing airflow.  Thats what was used by [Lorax](https://www.fordtransitusaforum.com/threads/the-lorax-build-thread.72698/post-997532).  Local dealer is Annapolis Cruisair 410-224-0970

Note: the C75 External is equivalent external to the C60 Internal cooling model.

I took some measurements of our Isotherm Cruise 130 to establish our current usable volume.  If you just discount space for the cooling unit, we have 119L.  If you also discount for the freezer, which has never really been used, you get 95L.  Usable volume of the Vitrifrigo 75 and 55 is 130L total,  75L of fridge volume and 55L of freezer volume.  A standard RedBaron frozen pizza fits on its edge vertically, and standard ice cube trays also fit.

A forum user found some online materials that suggest the external cooling unit can be placed up to [4 ft away from the fridge/freezer](https://www.fordtransitusaforum.com/threads/the-lorax-build-thread.72698/post-1073410).

@DaveInSeattle provided a [lot more information](https://www.fordtransitusaforum.com/threads/the-lorax-build-thread.72698/post-1073460) after I asked:

> Here's the deal: The external compressor is connected with 2 lines of soft copper tubing, about 4' long. You can position the unit anywhere you like subject to these restrictions:
>
> 1. You need at least 36" square inches of ventilation on the front side of the unit - cooler air flowing into the unit.
> 2. You need at least 36" square inches of ventilation on the back side of the unit where the slightly warmer air can be moved away with minimal resistance.
> 3. Copper tubing will break if you mess with it too much. Design your build so that the frig and compressor can be installed and removed with minimal flexing of the tubing.
> 4. I see a build up of dust and whatever on the cooling fins of the radiator. Best if you can place it where a soft brush vacuum can hit it once or twice a year to keep the cooling as efficient as possible.

The point about accessibility for cleaning is another benefit I hadn't considered, but is substantial.

We've decided to maximize fridge and freezer space which is reflected in our preferred candidate arrangement.  Specifically:

### Fridge

Vitrifrigo 4.7cuft 62.6lb 12V/24V/120VAC

Model: C130RBP4-F-1 is the Fridge only version (verified with Vitrifrigo Rep)

Supplier Quote $1196

Ordered 3/3/21 for Delivery 5/20/21

### Freezer

Vitrifrigo 1.8cuft 60 lbs 12V/24V/120VAC

Model: C55RBN4-F 

Supplier Quote $1333

Ordered 3/3/21 for Delivery 5/20/21

### Operational Observations Notes

12-31-2022 0000-1200
Turned of all loads except:
Fridge and Freezer
Archer C7
Cerbo
Logging Pi
Freezer Ran continuously until ~0528, then began cycling.
Fridge cycles on and off every 70 seconds or so (about a 50% duty cycle)
Van Internal Temps: 76-72F

Average F/F Power was 60.5W for 12 hour period
Average F/F Power was 53.6W for period when freezer was cycling
Running F/F Power is 88W.
