natecostello/van_two_point_oh/van/parietal/adhesives/adhesives.md

---
type: article
section: van
categories: 
 # one or more categories is permitted
 - parietal
navTitle: 
title: Adhesives
author: Nate
date: 2021-07-05
tags:
 - adhesives
 - parietal
 - van
metatags:
	# no metatags
cover: 
	# image file
	# img: img
	# if attribution is needed
	# source: [vecteezy]
	# url: url
tldr:
---

We need adhesives for:
- minicell to sheet metal per hein recommended installation
- neoprene to wall panels
- vinyl to neoprone
- neoprene to sheet metal
- felt to sheet metal
- thinsulate to sheet metal

[Thread](https://www.fordtransitusaforum.com/threads/alternatives-to-the-3m-90-spray-adhesive.84812/) on alternatives to 3M 90:
- Hein suggest Loctite 300 or gorilla glue spray adhesive.
- [A tape alternative for thinsulate to sheetmetal](https://www.fordtransitusaforum.com/threads/alternatives-to-the-3m-90-spray-adhesive.84812/post-1120020)

A forum member [recommends](https://www.fordtransitusaforum.com/threads/covering-exposed-metal-with-fabric.65553/post-939864) weldwood Landau.  That version of Weldwood is recommended for automotive, is labled as heat-resistant.
