natecostello/van_two_point_oh/van/structural/8020-panel-mount/8020-panel-mounting.md

---
type: article
section: van
categories: 
 # one or more categories is permitted
 - structural

title: 8020 Panel Mount Design
navTitle:
author: Nate
date: 2021-12-28
tags:
 - van
 - structural
 - '8020'
 - concept
 - design
metatags:
	# no metatags
cover: 
	# image file
# img: cover.jpeg
	# if attribution is needed
	# source: [vecteezy]
	# url: url
tldr:
---

There does not appear to be a cheap, solid, turn-key solution to mounting inset (half-inch) panels in 8020 framing.

Catalog solutions:

Custom solutions:

1/4-20 drop in t-nuts are available for 15 series 8020 from tnutz.com.  Using 1/4-20 hard

10-32 drop in t-nuts are also available for 15 series 8020 from tnuts.com.  Using #10 hardware will minimize likelihood of head interference with the perpendicular angle surface. Half-inch fastners will work with 1/16th thick angle and the 8020.  For mounting half-inch thick panels a 3/4 inch fastener will work for that connection.

For quarter-inch thick panels we would want 1x1x1/16 aluminum angle.  For half-inch thick panels we would want 1x1/2x1/16 aluminum angle.

For the holes the panels mount to, we can use clip nuts which are available from mcmaster.

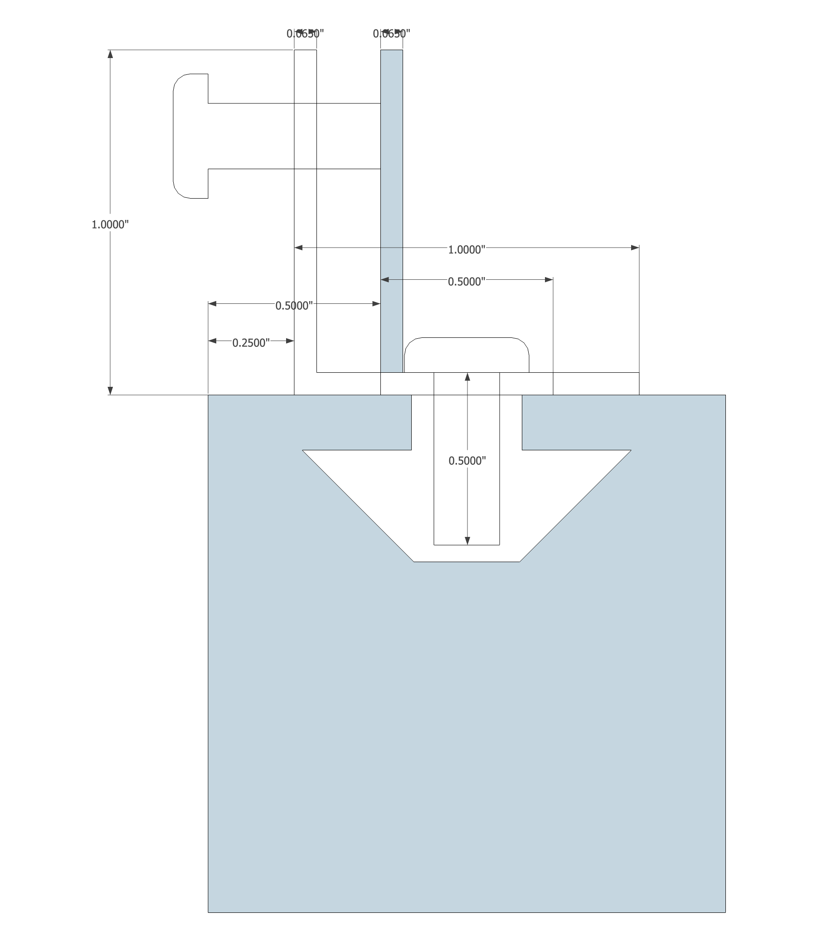
[picture p177: van/structural/8020-panel-mount/panel-mount-10-hardware.png]
sketch
