natecostello/van_two_point_oh/van/structural/bed-surface/bed-surface.md

Weight of bed surface panel from model: 5.78 lbs
