natecostello/van_two_point_oh/van/structural/overhead_storage/overhead_storage.md

---
type: article
section: van
categories: 
 # one or more categories is permitted
 - structural
 - functional

title: Overhead Storage
navTitle:
author: Nate
date: 2020-10-27
tags:
 - van
 - structural
 - functional
 - storage
 - concept
 - design
metatags:
	# no metatags
cover: 
	# image file
	# img: img
	# if attribution is needed
	# source: [vecteezy]
	# url: url
tldr:
---

Based on available L-track placements, we need to look at 14x14 inch bags.

TODO: Measure wall and ceiling L-track

Candidates:

[30x15x14](https://www.duffelbags.com/duffel-bags/travel-gear-bag-xlarge): Not clear which dimension is H or W.  ~$35 SKU:EV-1015XL - Via Phone: 14Hx15W

[30x15Wx14H](https://www.duffelbags.com/duffel-bags/large-polyester-duffel-3sizes): ~$75 SKU:NP-5275-77

[30x14x14](https://www.duffelbags.com/duffel-bags/classic-gear-bag-large): $34 SKU:EV-1005LD

[30x15Wx14H](https://www.duffelbags.com/duffel-bags/duffelgear-grand-canyon-duffel-30inch): $24 SKU:DFL30-36

Based on a crude fit test on Monday 8-30-2021, we've narrowed the sizes to 14x14 and 14Hx15W Bags.  Once we do an actual fit test with L-track in place this could change, but for now, those will be our first trials.

Eliminated Candidates (for now):

[Unknown but interesting](https://www.duffelbags.com/duffel-bags/deluxe-club-sports0bag): 
~$30 SKU:NUC-DB1204 - Via Phone 20X10X10

[25x12Wx13H](https://www.duffelbags.com/duffel-bags/duffelgear-1000series-tuffduffel-25inch): $30 DFL1025

[36x16x15](https://www.amazon.com/gp/product/B08NRNSSX6/ref=ox_sc_act_title_1?smid=A2C1PAWGD7RAJ1&psc=1): ~45

[15x15x30](https://www.outdoorshopping.com/os/Outdoor-Products-Black-Mountain-Duffle-Bag-Large-Gym-Travel-Work-15-inchesX-30-inches.html)
