natecostello/van_two_point_oh/van/structural/pass-throughs/Pass-throughs.md

---
type: article
section: van
categories: 
 # one or more categories is permitted
 - structural

title: Cable and Hose Pass-Throughs
navTitle:
author: Nate
date: 2021-01-12
tags:
 - van
 - structural
 - wire
 - hose
 - gland
 - pass-through
 - concept
 - design
metatags:
	# no metatags
cover: 
	# image file
	# img: img
	# if attribution is needed
	# source: [vecteezy]
	# url: url
tldr:
---

# Requirements

* Waterproof
* Room for future expansion
* Maintainable/Servicable

# Underside Pass-throughs

My favored concept uses a 3 inch threaded PVC nipple.  It will pass through a ~3 inch hole drilled/cut though a flat area in the steel floor as well as the insulation and top floor as well as a waterproof junction box with a ~3 inch hole in its base.  3 inch female threaded PVC flanges will capture the nipple between the inside floor outside as well as capture the waterproof junction box.  Sealing material will be used at the perimeter of the junction box and the junction box hole between the box and the exterior floor.  Holes will be drilled into 4 sides of the junction box with cable glands providing the waterproof barrier into the junction box.

[Example junction box](https://www.amazon.com/LeMotech-250mm-150mm-130mm-IP67/dp/B075DJ642L/ref=psdc_495308_t4_B0786ZT7G3?th=1)

[Example PVC nipple](https://www.supplyhouse.com/Spears-889-030-3-x-3-PVC-Sch-80-Threaded-Nipple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)

[Example PVC flange](https://www.pvcfittingsonline.com/855-030-3-schedule-80-pvc-van-stone-flange.html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)

# Roof Pass-throughs

The roof pass through will use a similar technique, though multiple smaller holes and PVC may be used to accomodate large dimensioned terminal boxes to maximize room for expansion.  VBH would aid in securing.

To keep below the top of the rail and allow nestling under "deck" or solar panels, height is of interest:

[2.3" high 3x4 10mm diameter wire](https://www.amazon.com/YXQ-Electrical-Connector-Dustproof-Waterproof/dp/B071ZRQN42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)

[~2" high possibly up to 6 inputs up to 15mm](https://www.amazon.com/Junction-Waterproof-Connector-Electrical-Protection/dp/B08MTKNN4X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)

[1.65" high up to 3, inputs up to 10mm](https://www.amazon.com/dp/B08MNX6NC6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)

[2.17" high 3 and 3 or 4 and 4 high not sure gland size](https://www.amazon.com/dp/B08MYV93S2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)

This is the best option I've seen so far: [2.16" (internal) high 4 glands up to 15mm](https://www.amazon.com/Electrical-Junction-Vane-Waterproof-Connector/dp/B07JJDF6T6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)

[2" (internal) 8 glands up to 15mm ](https://www.amazon.com/Electrical-Junction-Vane-Waterproof-Connector/dp/B07JWJTCBT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)

[2.2" (internal i think) plenty of glands not sure of gland size](https://www.amazon.com/dp/B075WZFWFV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)

[2.3" lots of room for glands, could probably support up to 14mm diameter cable](https://www.amazon.com/Otdorpatio-Waterproof-Electrical-Electronic-200x120x75/dp/B09B6Q9FS3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)

[2" three glands, up to 15mm](https://www.amazon.com/Junction-Waterproof-Connector-Electrical-Protection/dp/B08PT5CWY9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)

This might be the one [2.44" 10 glands, up to 14mm.](https://www.amazon.com/Waterproof-Junction-Electrical-Connector-Terminal/dp/B07VGCZD2D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)

[2.44" many variants up to .55 wire (PEBA)](https://www.amazon.com/Waterproof-Junction-Electrical-Connector-Terminal/dp/B07VN5D2QW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)

[1.41" 3 and 2 glands up to .55 (MAKARELE)](https://www.amazon.com/Waterproof-External-Junction-Connector-Electric/dp/B098DJWYFL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)
