natecostello/van_two_point_oh/van/structural/reading-light-mount/reading-light-mount.md

All fastener holes are clearance for #6.

We'll need shortish #6-32 for attaching light to mount.  We'll need longer #6 32 screw and nuts for attaching mount to van. - nope used clip nuts and machine screws used fro mounting wall fans.
