natecostello/van_two_point_oh/van/technical/tools/tools.md

---
type: article
section: van
categories: 
 # one or more categories is permitted
 - technical

title: Tools
navTitle: 
author: Nate
date: 2020-11-13
tags:
 - tools
 - technical
 - van
metatags:
	# no metatags
cover: 
	# image file
 img: 
	# if attribution is needed
 source: 
	# url: url
tldr:
---

The right tool for the right job!  This [thread](https://www.fordtransitusaforum.com/threads/must-have-tools-for-camper-conversion.79127/#post-1038918) is a good startingn point.

**Transfer Punch Set** - These are used to "transfer" a pattern of holes from one piece to another.  Note, when transfering holes from thin materials, the raised part that dimples the material can prevent the circumference of the transfer punch from locating itself relative to a hole.

Examples: [Harbor Freight Transfer Punch set](https://www.harborfreight.com/28-piece-transfer-punch-set-3577.html)

**Centering Transfer Center Punch** - This is useful if there isn't enough "meat" or thickness around a hole to locate a traditional transfer punch.  An example is trying to center a hole through L-track where the bottom of the chamfer is too thin to properly locate a transfer punch.

Examples: [Penn Tool Hole Transfer Center Punch](https://www.penntoolco.com/precise-econo-pic-hole-transfer-center-punch-3-16-1-1-16-tt-551/)

**Transfer Screw Set** - These are useful to locate holes on the backside of a piece.  Say I have 4 1/4-20 threaded holes in a wall and you need to mount a panel to that wall.  You insert the transfer screws int to the threaded holes, place the panel against the wall, and dimple the backside by pressing the panel against the transfer screws.  Remove and drill the proper locations.

Examples: [Transfer Screw Set on Amazon](https://www.amazon.com/HHIP-3601-0250-Piece-Transfer-Screw/dp/B00N411MCC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)

**Center Scribe** - Useful to scribe a center line down a long strip of metal (e.g. 1/2 series 80/20 or L-track) to aid in drilling/transfering holes.

Example: [Center Scribe](https://www.amazon.com/Center-Finder-Tweippy-Woodworking-Marking/dp/B0823ZPC1X)

**Metal Saw** - For cutting 80/20 and other stuff.

Humble Road uses the [Makita LC1230](https://www.makitatools.com/products/details/LC1230) which runs about $540.

I have been looking at [Evolution S380CPS](https://store.evolutionpowertools.com/collections/evolution-chop-saws/products/s380cps) which runs about $440.

I think the Evolution has the edge.

**Stop Block System** - Useful for cutting precise lengths of 80/20.

Example: [Kreg system](https://www.kregtool.com/shop/cutting/miter-saw-cutting/precision-trak-stop-kit/KMS8000.html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) ($140)

**Hot Wire Foam Cutter** - Will be used to cut the foam used to fill the channels in the van before the top upper layer of XPS.

Example: [Hercules Hot Wire Foam Cutter](https://www.amazon.com/gp/product/B07HY8PFD8/ref=ox_sc_act_title_1?smid=A2IGZ09LPUKLVH&psc=1) ($140)

**Cheap But Accurate DMM (Logging a plus)** - Will be used for battery construction and cell balancing.

Example:[ut61e](https://www.eevblog.com/forum/testgear/new-uni-t-ut61-series-(ut61e)/)

Look into sigrok for logging without installing stupid software.  Also considering picking up one of [these](https://www.ebay.ca/itm/AD584-High-Precision-Voltage-Reference-Module-4-Channel-2-5V-7-5V-5V-10V/311498494419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) to check it.  Note, the 61e+ is not supported by sigrok.  The 61e is supported.  There are also good python repositories that support the 61e.

**Oscilloscope with CAN Decode** - Would be useful.  And I've always wanted one. UPDATE: GIFTED!

Example: [Siglent 4 Channel with CAN etc](https://www.amazon.com/Siglent-SDS1104X-oscilloscope-channels-standard/dp/B0771N1ZF9?ref_=ast_slp_dp) ($499)

**Top Balancing System** - Will be used to top balance cells for battery construction.

Example: [ESP32 based system](https://diysolarforum.com/threads/top-balancing-setup-w-arduino-monitoring.15773/).  This system uses a [HRPG-300-3.3](https://www.mouser.com/datasheet/2/260/HRPG-300-SPEC-1511701.pdf) which is capable of 60A at 3.8V.  This would charge 16 280AH cells in approximately 37 hours from 50% SOC.  It would require use of [shotty diodes](https://www.digikey.com/en/products/detail/stmicro/STPS20SM60D/2827130) in parallel detailed in that the above thread.

**High Capacity DC PSU** - Could be used to top balance cells and to test the 12V and 24V electrical system ahead of battery light off.  Can also be used as a virtual solar array to provide input to MPPT.

Example:[Riden RD6018](https://www.amazon.com/dp/B08JPKQD41/ref=cm_sw_r_tw_dp_2KKXKZ460C1FY0MTXQV3) ($199)

**Capacity Tester** - This will be used to test individual cell capacity to allow matching/verifying cells.  The example below all so has serial out, so logging of tests via raspberry pi should be pretty easy.

Example: [Atorch 4-wire](https://www.amazon.com/Electronic-upgraded-electronic-adjustment-discharge/dp/B08MQG1FQ8) ($100)

**Plus-Nut Setting Tool** - This Tool is used to set plus nuts consistantly

Example: [Astro Pnuematic Tool 1450](https://www.amazon.com/gp/product/B01JBNNJ3Q/ref=ppx_yo_dt_b_asin_title_o05_s04?ie=UTF8&psc=1) is recommended in this [forum thread](https://www.fordtransitusaforum.com/threads/must-have-tools-for-camper-conversion.79127/post-1038821).

Example: [Air Powered Option](https://www.amazon.com/KIARUO-Self-locking-Gun%EF%BC%8CQuick-Change-Industrial-Adjustable/dp/B07Y73GDYW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) is highly recommended by this [youtube video](https://www.youtube.com/watch?v=sHiorTMzo1U).

THIS WAS A GAME CHANGER!

**Air Compressor** - Due to the scarcity and price increases of spray adhesives, we are purchasing sprayable adhesive in liquid form and will spray with compressed air.  This requires an air compressor.

Example: [Central Pneumatic 10 Gal 2.5 HP](https://www.harborfreight.com/air-tools-compressors/air-compressors-tanks/10-gallon-25-hp-125-psi-oil-lube-air-compressor-62441.html) (178.97) - This compressor has greater than 6CFM at 40 PSI so it will support the HVLP guns we are looking at.

**Spray Gun** - One for spraying adhesive, and one for urethane.

Example: [Central Pneumatic HVLP](https://www.harborfreight.com/20-oz-hvlp-gravity-feed-air-spray-gun-62300.html) (16.99) - Not sure if we need the version with the regulator.

**Hand Planer** - used to match thickness of foam and ribs
Example: Ryobi
