natecostello/van_two_point_oh/van/technical/workbench/workbench_notes.md

## Cut potential notes:

73.5" - longest 80/20 cut
6' 1.5" - longest 80/20 cut

Assume left of blade is 12"
right of blade is 1.5"
=> assume anything less than 13" must be cut on right side of blade, which means you need 11.5" on the right (if you hang over the extra. 12.5")
=> you need 5' 2" on left (if you hang over the extra 8")
5' 2" + 1' 1.5" + 11.5" = 6' + (2 + 1.5 + 11.5)" = 6' + 15" = 7' 3" 
8' - 10" = 7' 2"

## Bench Shopping List
For 2.5' x 8':
2.5' x 8' 3/4 (2)
8' 2x4 (4)
2' 3" 2x4 (4)
2' 3" 2x4 (3)
6" 4x4 (3)
7' 11.5" 2x4 (1)

## Shelf Shopping List:
93 5/8" 2x4 (6)
48" 2x4 (4) * These need to be the same length, fairly precise
93 5/8" - 7 7/16" = 86 3/16"   (2)
10 pieces total (~ $50)
