natecostello/van_two_point_oh/van/vehicular/exterior_lighting/exterior_lighting_notes.md

---
section: "van"
category: "vehicle"
title: "Exterior Lighting"
author: "Stello"
data: " 2020-12-8"
tags: ["vehicle", "lighting", "exterior", "control"]
tldr:
---

For control of exterior lighting/stuff [consider this](https://www.switchpros.com/).
