natecostello/van_two_point_oh/van/vehicular/front_bumper/front_bumper_notes.md

---
type: article
section: van
categories: 
 # one or more categories is permitted
 - vehicular
navTitle: 
title: Front Bumper
author: Nate
date: 2020-12-13
tags:
 - bumper
 - vehicular
 - design
 - concept
 - van

metatags:
	# no metatags
cover: 
	# image file
	# img: img
	# if attribution is needed
	# source: [vecteezy]
	# url: url
tldr:
---

[This post identifies a good product for animal protection](https://www.fordtransitusaforum.com/threads/using-brush-guard-from-different-vehicle-on-ford-transit-250.82864/post-1077009).  At least one person was able to get a hitch receiver.  If it had recovery points it'd be perfect.

The Aluminess bumper is also under consideration.  We need to confirm that it is compatible with the adaptive cruise (and not just parking sensors).  Email sent.

Per 2020-07-07 Phone Call:
Bumper is compatible with adaptive cruise and has area for relocation of sensor (see small black plexiglass blank).  Addition of front hitch receiver does not interfere with adaptive cruise.

[This product is also promising.](https://portal.ecb.com.au/products/224176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)
