natecostello/van_two_point_oh/van/vehicular/rear-door-carriers/rear-door-carriers.md

---
type: article
section: van
categories: 
 # one or more categories is permitted
 - vehicular
navTitle: 
title: Rear Door Carriers
author: Nate
date: 2021-07-04
tags:
 - cargo
 - vehicular
 - design
 - concept
 - van

metatags:
	# no metatags
cover: 
	# image file
	# img: img
	# if attribution is needed
	# source: [vecteezy]
	# url: url
tldr:
---

Aluminess makes a driver side tire carrier/ladder combination that works for us.  They also make a passenger side box carrier that should work for mounting a mini-splits.

The tire carrier/ladder combination is compatible with our hinge type (180 degree).  We need to confirm that the passenger side is also compatible with the 180 degree hinge (email sent).

Per 2020-07-07 Phone Call:

Both rear door carriers are compatible with both hinges types.

Lead time for the driver side ladder/tire carrier combo: Mid-October +/- 2 weeks
Lead time for the passenger side box carrier: Mid-September, but could be Mid-October +/- 2 weeks
Order placed with deposit of ~1/2 total

I asked about weights and got the following response:

> * Transit driver side rear door ladder: Approximate weighs 25 pounds.
> * Tire carrier and a passenger side rear door box carrier (no box): Approximate weighs 18 pounds.

Related, according to the forum, the [spare tire weighs 74 lbs](https://www.fordtransitusaforum.com/threads/oem-steel-vs-aluminum-wheel-weight.12562/post-199434).
