natecostello/van_two_point_oh/van/vehicular/roof_arrangement/roof_rack_and_arrangement_notes.md

---
type: article
section: van
categories: 
 # one or more categories is permitted
 - vehicular
navTitle: 
title: Roof Rack and Arrangement Evaluation
author: Nate
date: 2021-01-16
tags:
 - '8020'
 - design
 - concept
 - aluminess
 - vehicular
 - roof
 - van
metatags:
	# no metatags
cover: 
	# image file
	# img: img
	# if attribution is needed
	# source: [vecteezy]
	# url: url
tldr:
---

**TLDR:** We selected a rack design using Hein's roof rack mounting feet and Aluminum angle.  This rack design results in minimum weight, minimum cost, and minimum aerodynamic impact.  It also is extremely flexible.  Unfortunately, it has the least usable roof space after solar is installed.  It also doesn't look the coolest.  The Aluminess touring rack was strongly considered.  The low pro rack is incompatible with our fan location, so that was a dealbreaker.

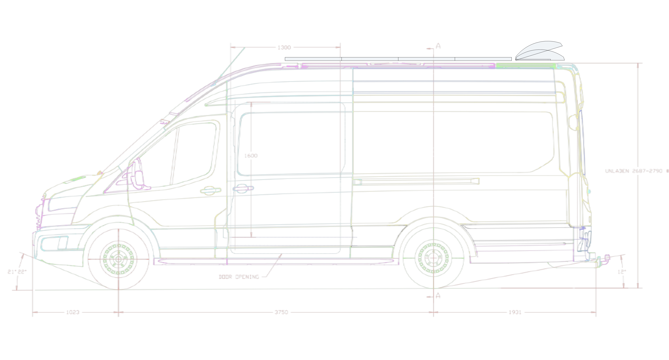
[picture p198: van/vehicular/roof_arrangement/transit-roof-layout-section.jpg]
section view of roof

_A section view of the selected arrangement.  Smooth air flow was an important consideration to us._

## Weight

### Aluminess 

I haven't been able to pin down a weight for an Aluminess rack.  [Barefoot theory](https://bearfoottheory.com/aluminess-review-sprinter-van-roof-rack-accessories/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,of%20holes%20in%20your%20roof.) states hers is 125 lbs. With a longer touring style rack, I'd estimate ours would be at least 150 lbs.

### 80/20

Two 136 inch runners and three 58 inch crossbars yield 50 lbs (plus a lb or so for hardware) for standard or 35 lbs for the ultra light.  It does look like the maximum length for shipping is 102 inches, so this would be a special trip.

### Aluminum Angle

1.75x1.75x0.25 inch 6061-T6 Angle is 0.0783 lbs/in and is available from Metal Supermarket.  Two 136 inch angle runners and three 58 inch standard 15 series 80/20 crossbars yield 40 lbs (plus a lb or so for hardware).  This would yield a near flush mount for the top of the Rich Solar panels (1.4" thick) and flush mount for 80/20 crossbars.  The crossbars would need a chamfer on the lower edge to avoid interfering with the web on the angle.  Moment of Inertia is ~0.222 in<sup>4</sup>.  I think this is the pick.  We'll order 150 inch lengths for margin.

1.75x1.75x0.125 inch 6063-T52 Angle is 0.0417 lbs/in and is available from Metal Supermarket.  Two 136 inch angle runners and three 58 inch standard 15 series 80/20 crossbars yield 30 lbs (plus a lb or so for hardware).

## Aerodynamic Impact

### Aluminess 

Difficult to quantify.  Barefoot theory states she lost 2-3 mpg with her aluminess rack.  Placing solar panels at maximum forward position would certainly interrupt flow off the slopped portion of the roof.  Placing solar panels starting that the flat portion might mitigate things somewhat.

### 80/20

Difficult to quantify, but certainly will definitely perform better than the Aluminess rack.  It will also allow for an air damn to aid air flow easily.

### Aluminum Angle

Difficult to quantify, but certainly will definitely perform better than the Aluminess rack and a little better than the 80/20 option due to the lower height.  This option places the panels closest to the roof.  It will also allow for an air damn to aid air flow easily.

## Cost

### Aluminess 

$4450 with shipping (not including tax).  Aluminess [stated](email_with_alumines_shipping_cost.pdf) the cost for shipping to MD would be $650 to home or $500 to a commercial address.

### 80/20

$272 for the extrusions (no shipping or tax), $390 for Hein's mounts. 

### Aluminum Angle

$170 for the 6063 angle (no shipping or tax), $93 for the extrusions (no shipping or tax), $390 for Hein's mounts. 

$333 for the 6061 angle (no shipping or tax), $93 for the extrusions (no shipping or tax), $390 for Hein's mounts. 

## Solar

### Aluminess

Aluminess has [confirmed](emails_with_aluminess.pdf) that width shown in thier [dimensioned drawing](Transit_148_EB_Tall Roof.PDF) is center to center of the lower loop of the rack and that the inner width of the upper loop is 63".    [Panasonic 330W](https://panasonic.net/lifesolutions/solar/pdf/96/spec/N330_325SJ47Datasheet_190401_ol_LS.PDF) solar panel dimensions are 62.6" so they will tuck between the upper rails with a custom mounting solution.  Four [Grape Solar](https://grapesolar.com/wp-content/uploads/GS-STAR-190W-US-Spec-Sheet.pdf) 190W or four [Rich Solar](https://richsolar.com/products/200-watt-24-volt-solar-panel) 200W panels could be used at the expense of roof space for roof deck.  Placing the panels so they don't interrupt flow of the sloped roof negates some arrangement benefit of Aluminess.  Total solar would be 660W, 760W, 800W with the Aluminess rack option.

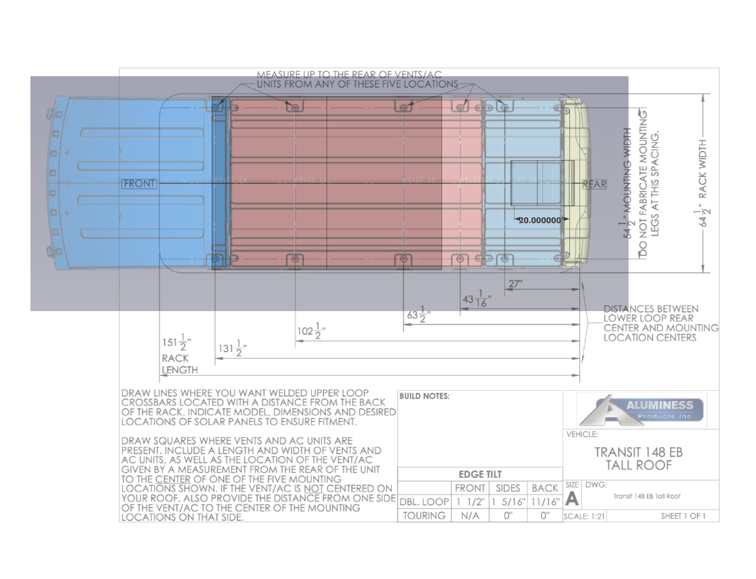
[picture p199: van/vehicular/roof_arrangement/Transit_Roof_Layout_Aluminess.jpg]
Aluminess


### 80/20

[Panasonic 330W](https://panasonic.net/lifesolutions/solar/pdf/96/spec/N330_325SJ47Datasheet_190401_ol_LS.PDF) panels would overhang the 80/20 rails too much for our taste.  

[Grape Solar](https://grapesolar.com/wp-content/uploads/GS-STAR-190W-US-Spec-Sheet.pdf) 190W panels (58.3 x 26.6 x 1.6 in) will rest just under 1/2 inch inside the outer edge of the 80/20 rails.  To clear the curvature of the roof they need to rest on top anyways (with a spacer if using Hein's lowest mounts).  Total solar would be 760W.  To provide voltage headroom over a 24V system, the Grape Solar panels (12V) would need to be wired in series requiring an even number of panels. A small amount of room to sit with legs hanging over the back would remain.

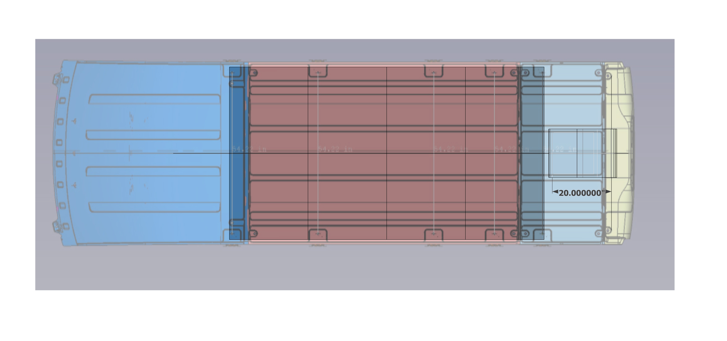
[picture p200: van/vehicular/roof_arrangement/Transit_Roof_Layout_8020.jpg]
80/20


[Rich Solar](https://richsolar.com/products/200-watt-24-volt-solar-panel) panels (58.7 x 26.8 x 1.4 in) will rest just under 1/4 inch inside the outer edge of the 80/20 rails. To clear the curvature of the roof they need to rest on top (with a spacer if using Hein's lowest mounts).  Total solar would be 800W.  These panels will provide voltage headroom over a 24V system in series or parallel (V<sub>mp</sub> 37.6V).  A small amount of room to sit with legs hanging over the back would remain.

### Aluminum Angle

Panasonic 300W panels would overhang the angle AL rails too much for our taste.  

[Grape Solar](https://grapesolar.com/wp-content/uploads/GS-STAR-190W-US-Spec-Sheet.pdf) 190W panels (58.3 x 26.6 x 1.6 in) will rest inside the inner edge of the angle AL rails.  They will clear the curvature of the roof with Hein's new higher mounts.  Total solar would be 760W.  To provide voltage headroom over a 24V system, the Grape Solar panels (12V) would need to be wired in series requiring an even number of panels. A small amount of room to sit with legs hanging over the back would remain.

[Rich Solar](https://richsolar.com/products/200-watt-24-volt-solar-panel) panels (58.7 x 26.8 x 1.4 in) will rest inside the outer edge of the 80/20 rails. They will clear the curvature of the roof with Hein's new higher mounts.  Total solar would be 800W.  These panels will provide voltage headroom over a 24V system in series or parallel (V<sub>mp</sub> 37.6V).  A small amount of room to sit with legs hanging over the back would remain.

### Low Pro Rack

Spacing between athwart rack supports on the Low Pro Rack is under 58".  Panasonic panels would over hang substantially.  [Grape Solar](https://grapesolar.com/wp-content/uploads/GS-STAR-190W-US-Spec-Sheet.pdf) would sit above almost flush (due to inward angle at the top of the athwart supports).  Total solar would be 760W.  To provide voltage headroom over a 24V system, the Grape Solar panels (24V) would need to be wired in series requiring an even number of panels.  [Rich Solar](https://richsolar.com/products/200-watt-24-volt-solar-panel) would sit above almost flush (due to inward angle at the top of the athwart supports).  Total solar would be 800W.  These panels will provide voltage headroom over a 24V system in series or parallel (V<sub>mp</sub> 37.6V).

## Fan Location

The fan will be mounted behind the rear-most roof rib, as forward as possible.  Based on the interior measurements, this would but the forward edge of the roof cut 20" from the door rib (note this will involve drilling through the lip of the rear-most-roof_rib).  The door rib location is estimated on the roof model.

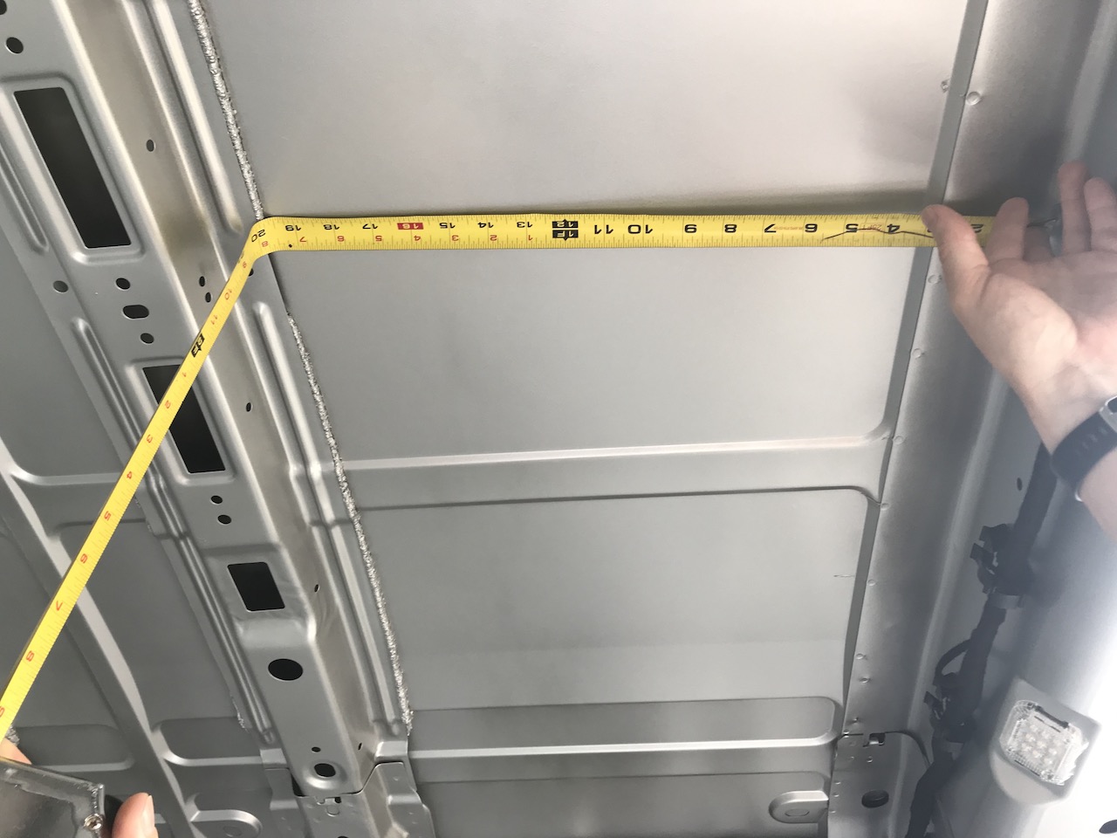
[picture p201: van/vehicular/roof_arrangement/rear_to_ceiling_rib_small.jpeg]


### Aluminess

The rear-most cross brace and the rear loop the Aluminess rack will clear the fan.

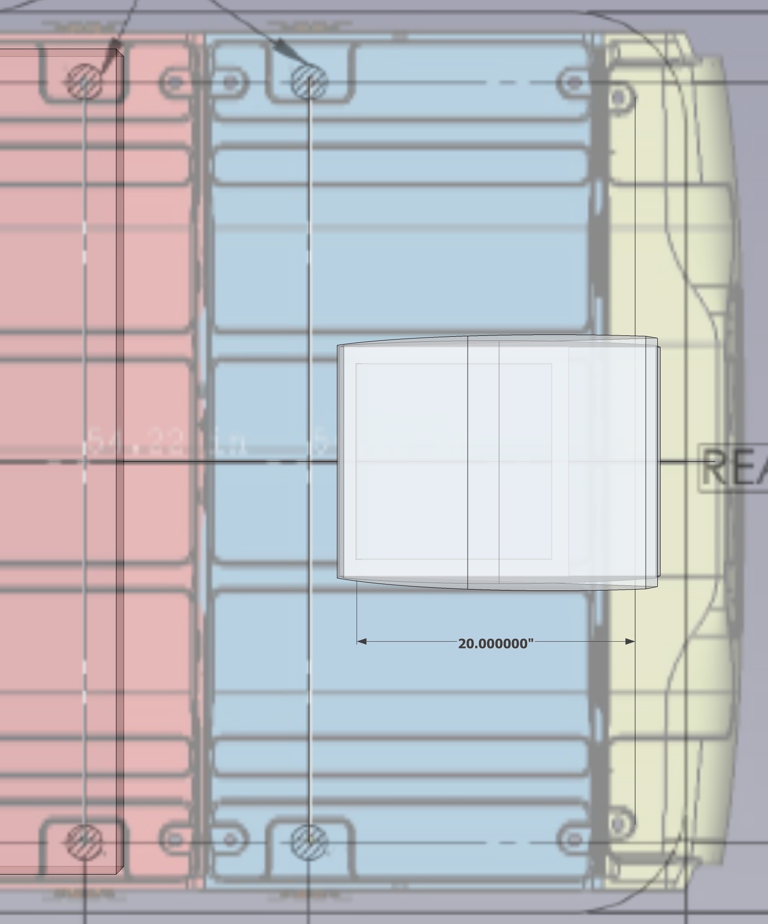
[picture p202: van/vehicular/roof_arrangement/fan_behind_rear_most_rib_alumness.jpg]


### 80/20 and Aluminum Angle

As the location of all cross braces can be chosen at will, the 80/20 and Aluminum angle rack are compatible with the planned fan install location.

### Low Pro Rack

The Low Pro Rack is not compatible with the planned fan location.  Upon that determination it wasn't looked at any further.  

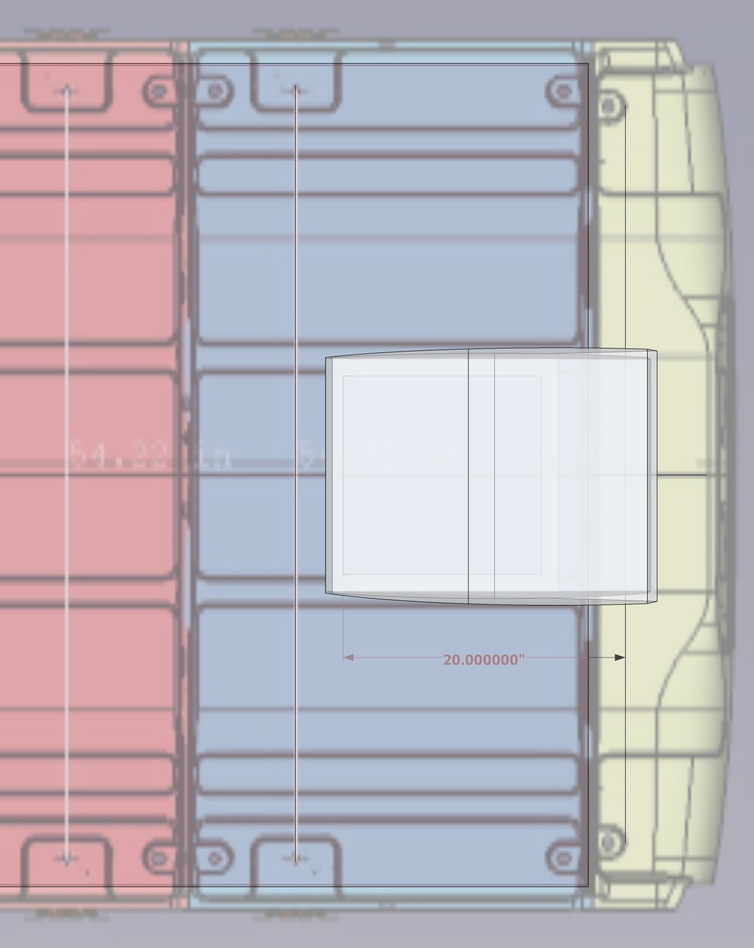
[picture p203: van/vehicular/roof_arrangement/fan_behind_rear_most_rib_low_pro.jpg]


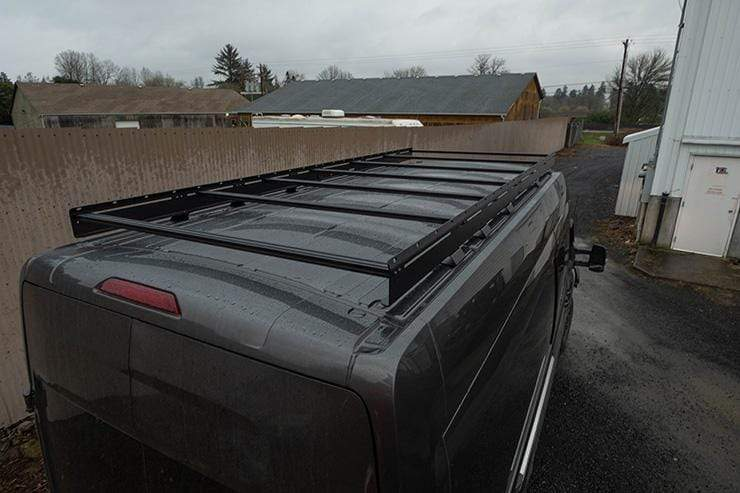
[picture p204: van/vehicular/roof_arrangement/transit-low-pro-roof-rack-148-high-roof-3_1800x1800.jpg]


This interference was confirmed by the company.  The provided the following dimension that confirms it, given that the fan itself is 23" long when closed:

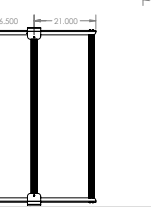
[picture p205: van/vehicular/roof_arrangement/rear_mount_to_rear_cross_brace.png]


I could add a flat bracket that bolts to where the rear cross-beam is and shifts the rear crossbar backwards.  That would be pretty easy to fab, but creates and even longer cantilevered rear.

## Antenna

The forum has stated that all 2020 Transits have a shark fin antenna.  Best we can tell the antenna location would interfere with the roof arrangements being considered.  The BEMM provides relocation guidance.  TODO: Evaluate antenna location/relocation/integration with other comms and roof arrangements.
