natecostello/van_two_point_oh/van/vehicular/weight-balance/weight-balance.md

---
type: article
section: van
categories: 
 # one or more categories is permitted
 - vehicular
navTitle: 
title: Weight and Balance
author: Nate
date: 2021-07-16
tags:
 - design
 - concept
 - weight
 - vehicular
 - balance
 - van
metatags:
	# no metatags
cover: 
	# image file
	# img: img
	# if attribution is needed
	# source: [vecteezy]
	# url: url
tldr:
---

To the extent that it doesn't significantly impact usability and maintainability, we will attempt to locate components in a way to optimize load and balance between axles and sides of the van.

[This spreadsheet](https://docs.google.com/spreadsheets/d/19zj8zePUruV7xZi8W45DDLBeJLT8us-NeaLOh08bvxs/edit?usp=sharing) is useful for calculating axle loading and athwart-van balance.
