natecostello/van_two_point_oh/blog/2022-11-3-starlink/starlink-12-or-120-volt-and-wifi-router-delete-ver2.pdf

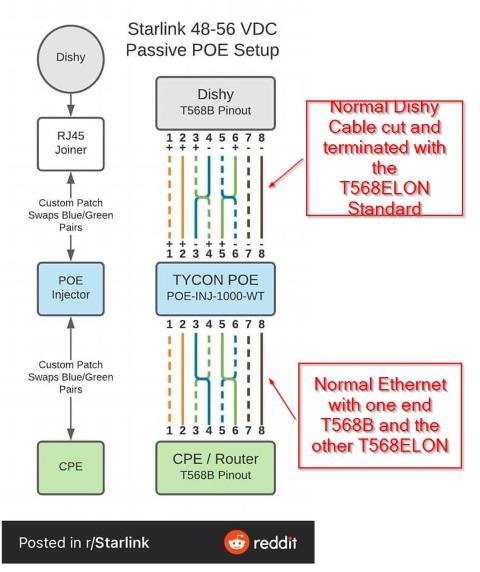
[picture p206: figure]

JBAT | Page | 1

# Starlink 12 volt and WiFi Router Delete Square Dishy

### (updated 6/12/2022)

## Intro

You may not know, but you can eliminate the Starlink router, and power your square Dishy with 12 volts DC or 120 volts AC as long as you convert it to 48 volts DC. This is great for Boaters or RV’ers.

## Wireing

Most of this information is floating around Facebook Groups, and Reddit. I did not figure out the RJ45 pinouts. I modified the picture from Reddit that explains the connectors a bit better. Most of the world uses the RJ45 standard T568B, but to get Power over the correct pairs using Power over Ethernet (PoE), then you need to swap pairs of wires going into and out of the PoE. I call this new standard T568ELON.

Most PoE’s are not a match for Starlink, so you need to swap wires 3,4 and 5,6 to get the correct polarity, but then the cable will not work for data. So you swap those pairs before the PoE injector, and then swap them back after the PoE injector. That way the pinouts will be correct on both the far ends for data transfer.

## Cut and Exposed

I cut the wire about 2’ from the router end. It is shielded twisted pair ethernet. Here is what it looks like before trimming back the shielding and clear plastic coat.

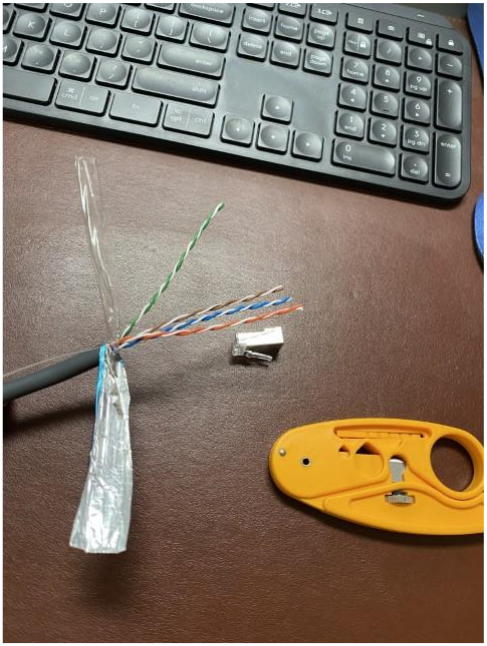
[picture p207: figure]

## Layout of the T568ELON standard

This wire is the 2’ chunk going into the old Starlink router. This makes a great one to practice on. I’m doing this so I can use a shielded RJ45 coupler, and connect the wire back together in case I want to use the Starlink router again.

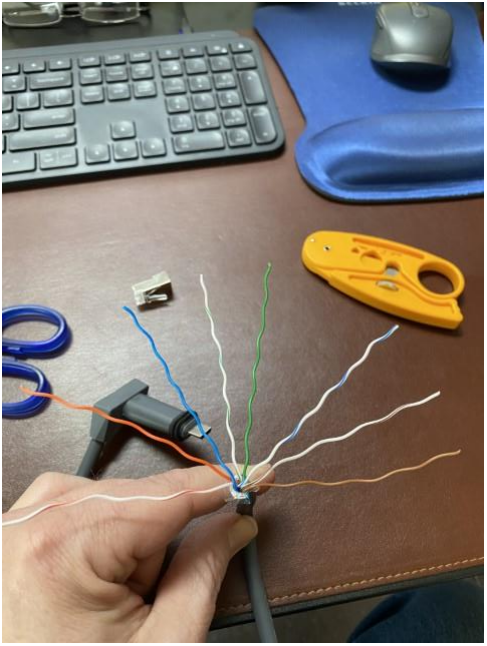
[picture p208: figure]

## Specs are for the square dishy

Specs are for the square dishy are 95w but others that have tested found it to peak in the 70-ish watt range. There’s a good post on Reddit with data tracking the draw with a similar setup.

From left to right. With the clip down and pointing away from you.

T-568ELON
Orange-White
Orange

Blue
Green-White

Green
Blue-White

Brown-White
Brown

================
Normal is T-568B

Orange-White
Orange

Green-White
Blue

Blue-White
Green

Brown-White
Brown

## Pig tail for the original SL Router

My Starlink Router to inline coupler pig tail is done. Again this will only be used if I want to go back to using the system like it came from the factory.

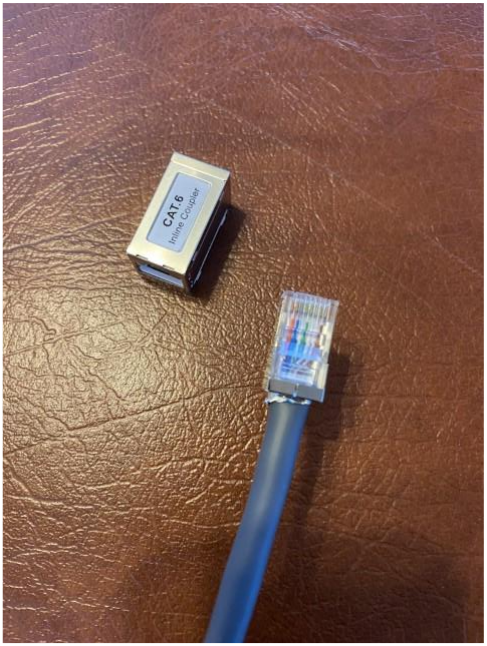
[picture p209: figure]

## Pig tail for my Personal Router

I made a pig tail from a commercial shielded ethernet cable. I just cut one end off and put on an RJ45 end with the T568ELON standard. This will connect from the PoE to my personal Asus Router.

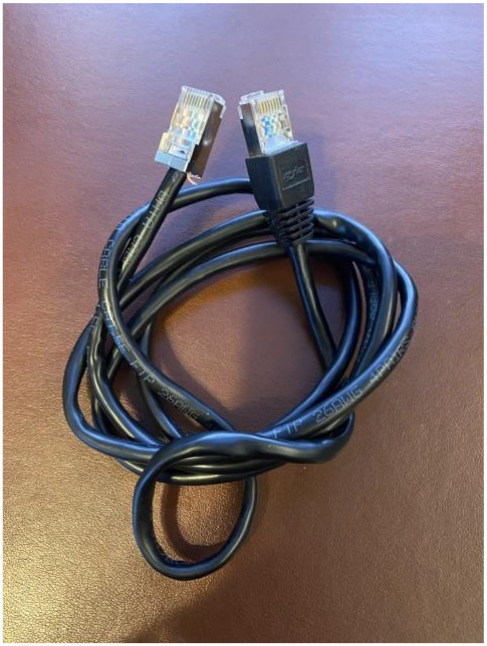
[picture p210: figure]

## The Dishy Cable

This is the other end of my, now, 73’ cable. With RJ45 end using the T568ELON standard.

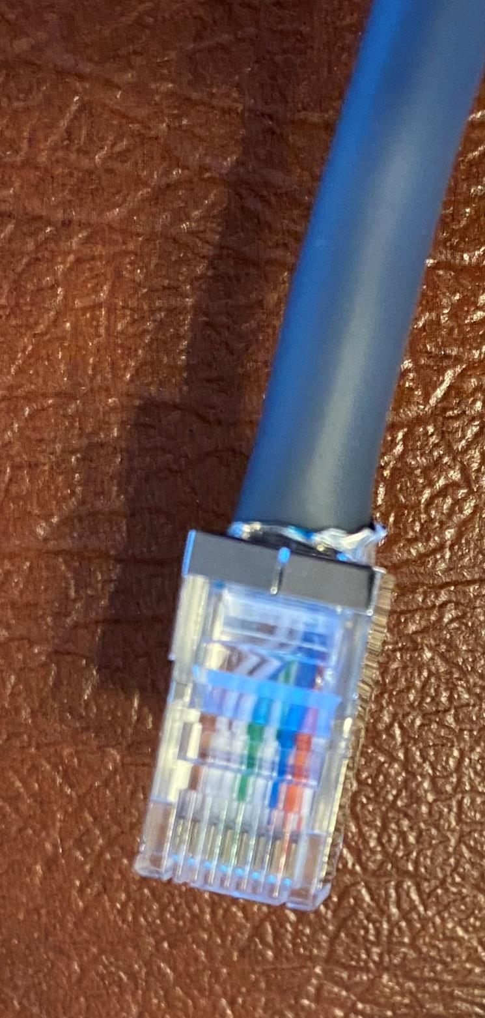
[picture p211: figure]

## Power!!

This is the 12 volt to 48 volt Power supply, and PoE Injector I got off of Amazon. The dishy needs 48 Volts. I have had problems with not enough amps on my 12v input. If you have problems test your 48 voltage during a dish boot up.

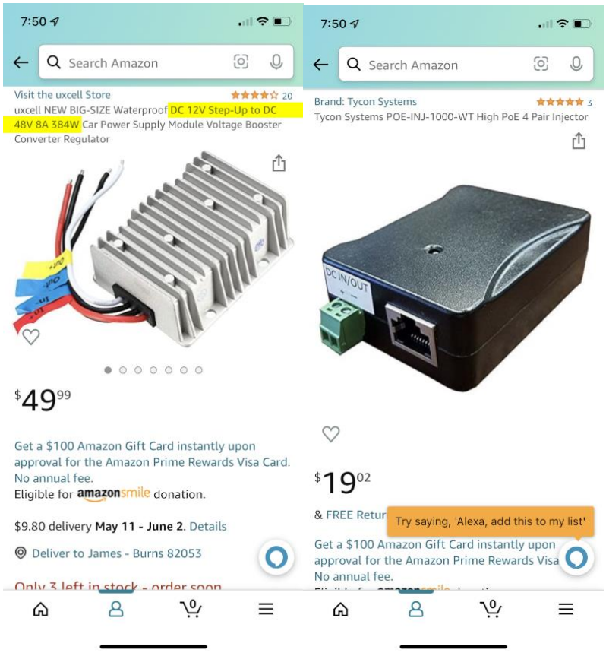
[picture p212: figure]

## 120 V AC Version

Do the same thing but use 120 volt AC to power your dishy, just swap out the power supply, and use the same POE injectors. I’m using this for my 120 Volt applications, like in my house, and even in my RV using the inverter.

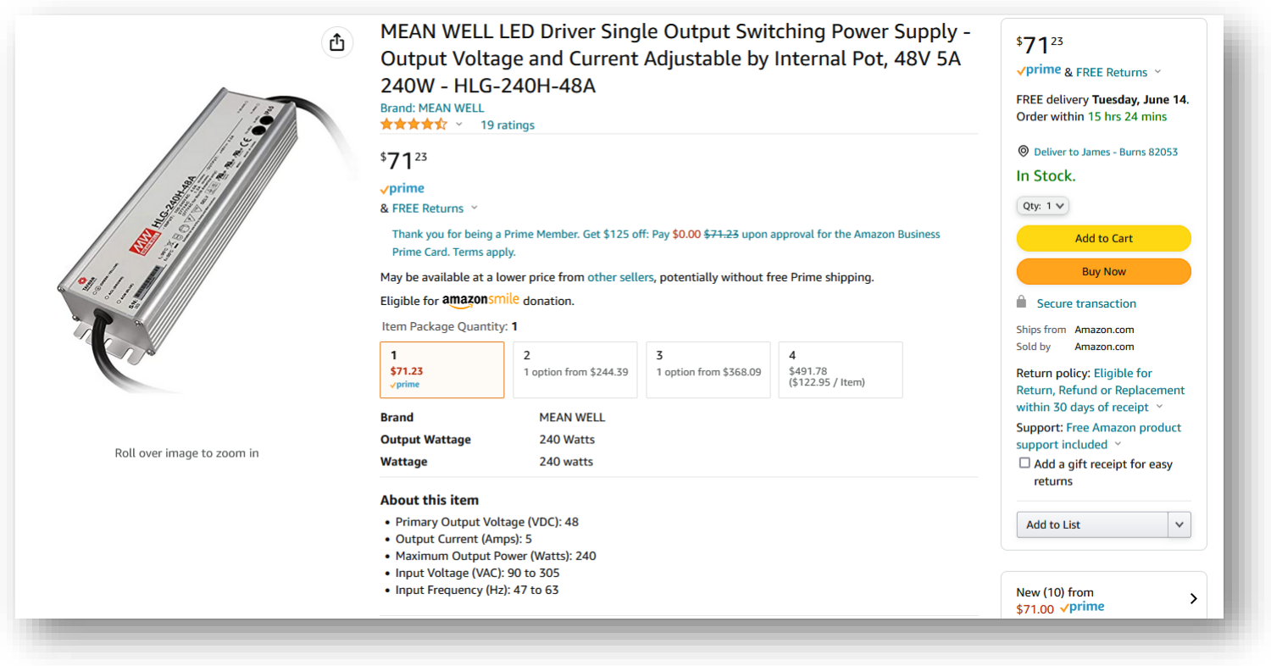
[picture p213: figure]

## Not all POE’s are the same

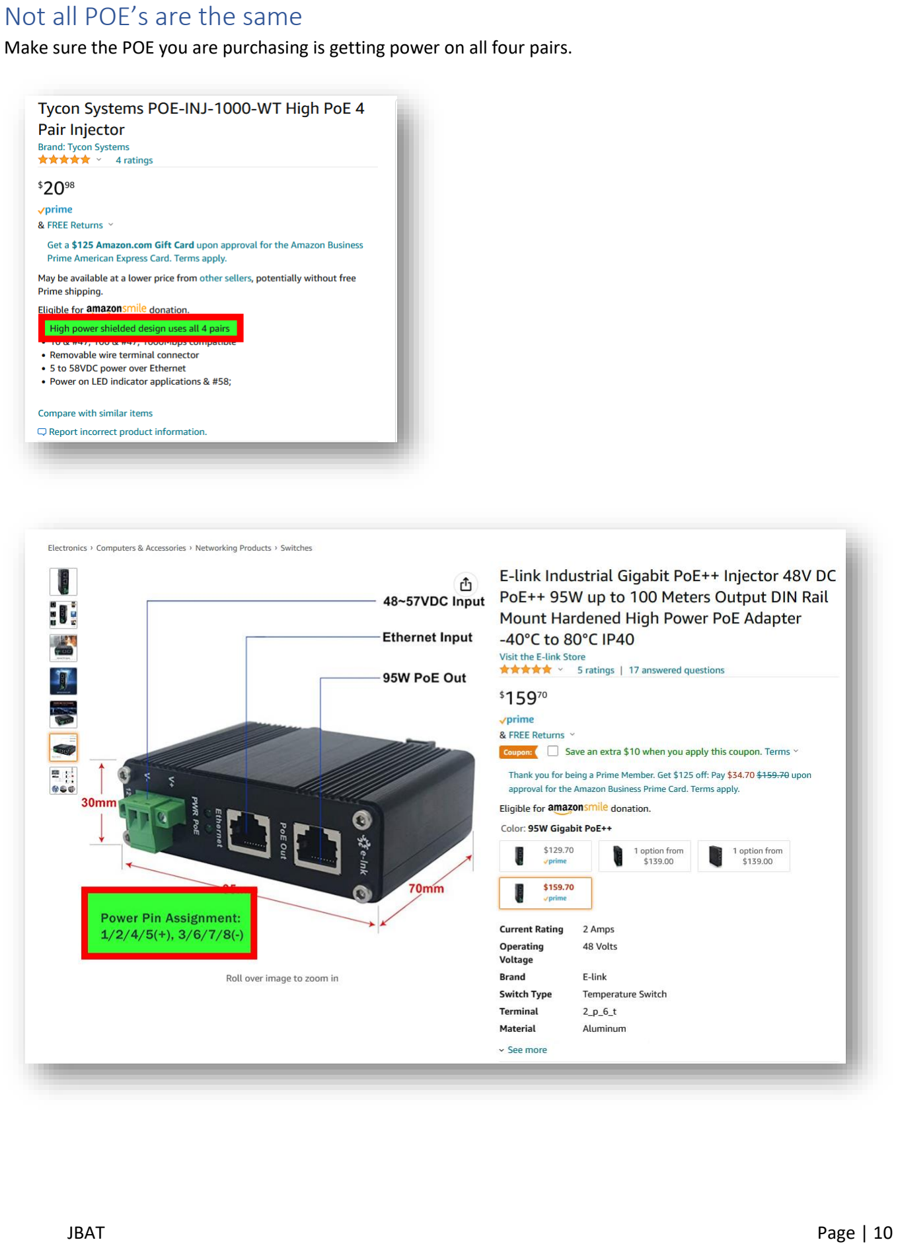
[picture p214: page 10]

Make sure the POE you are purchasing is getting power on all four pairs.

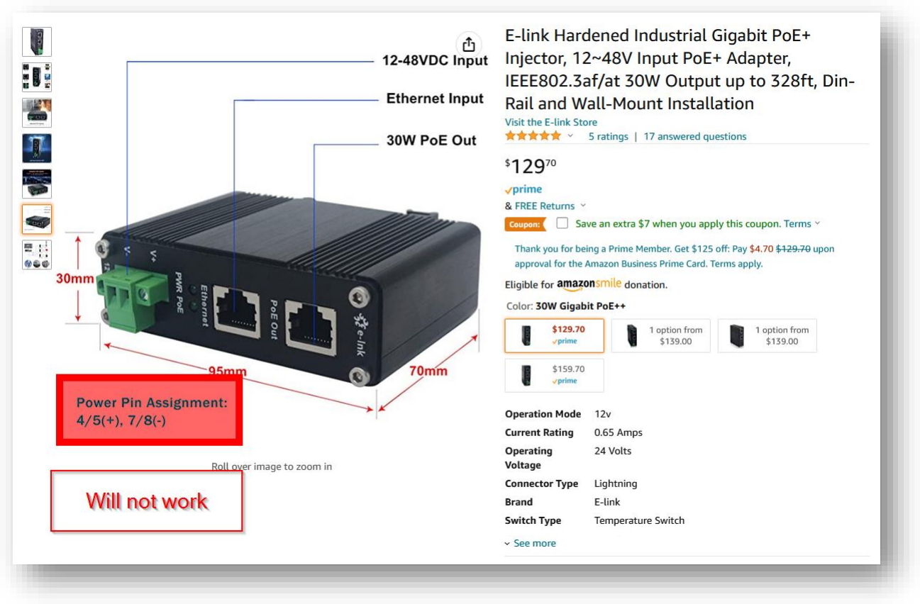
[picture p215: figure]

## Testing

Hook up and testing power before powering the dishy. 12.02v DC in and 47.97v out… I will take it!

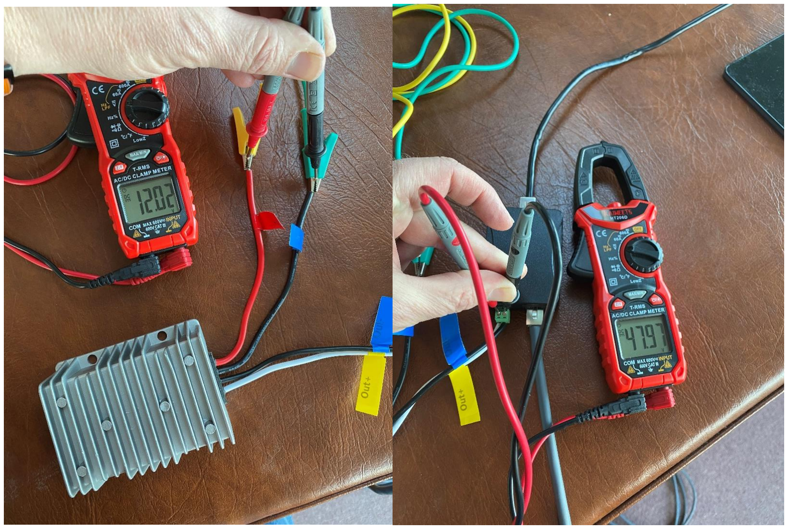
[picture p216: figure]

## Hooked up!

I’m using a 120V AC to 12V DC power supply for testing before putting into the RV.

12v Power supply into my 12V to 48V step up power supply, and then from there connected to my PoE injector.

DATA: The original 73’ cable is leaving the POWERED side of the PoE injector going to dishy. The short ethernet pig tail is going to my WAN connection on my WiFi router.

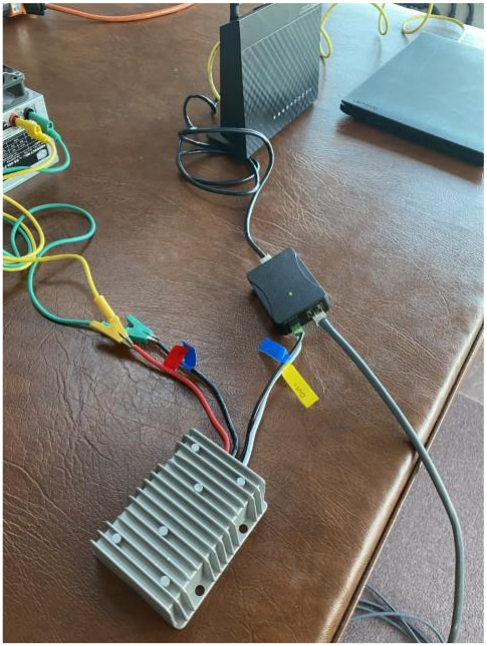
[picture p217: figure]

I have my laptop plugged into the LAN connection of my Asus router, and I have a tablet connecting to my Asus router.

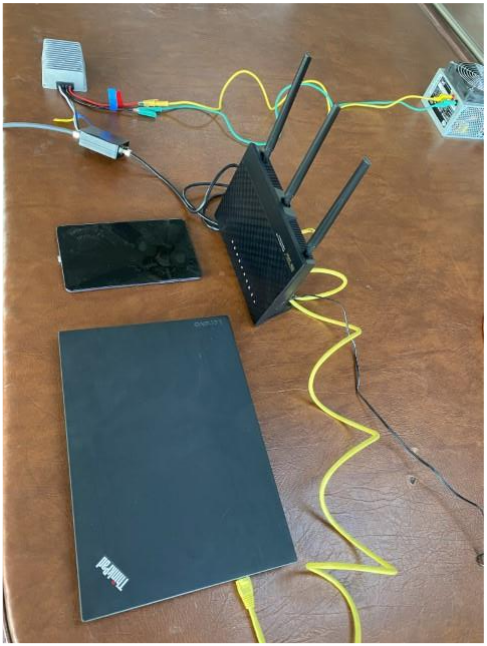
[picture p218: figure]

## The Starlink App

The Starlink app still works, but the NETWORK settings and the name of the WiFi SSID does not show up (of course).

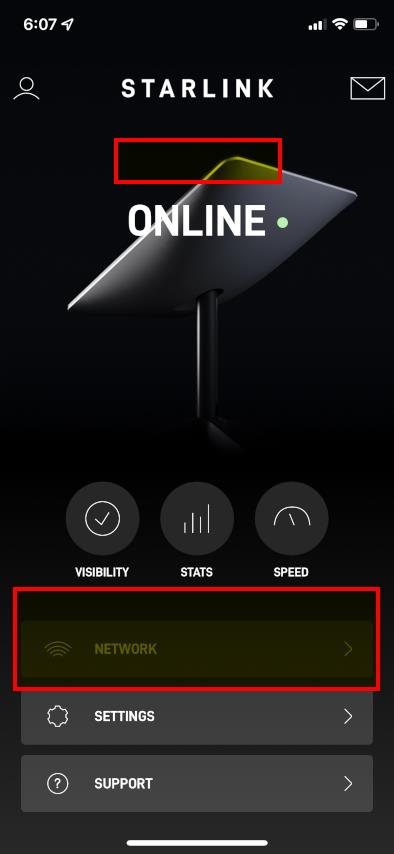
[picture p219: figure]

The Speed test works, but only for the Phone to the Internet. Since Starlink doesn’t know your router, it can’t give you ROUTER to INTERNET and PHONE to ROUTER speeds.

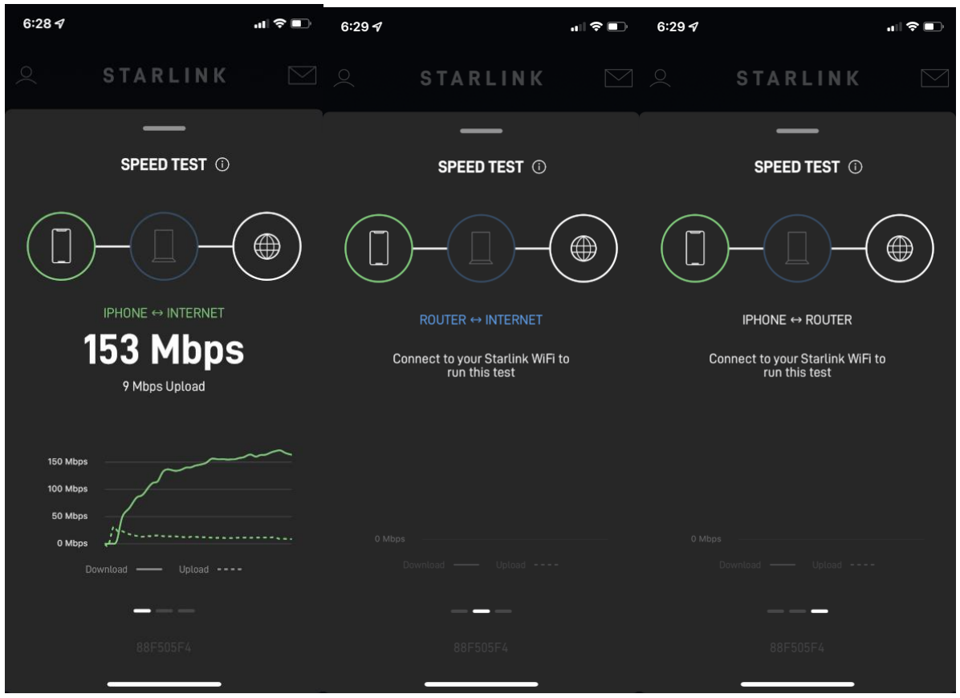
[picture p220: figure]

## Back to factory

Here it is setup like factory. The only difference is that I have a shielded RJ45 inline coupler connecting my two RJ45 ends using the T568ELON standard.

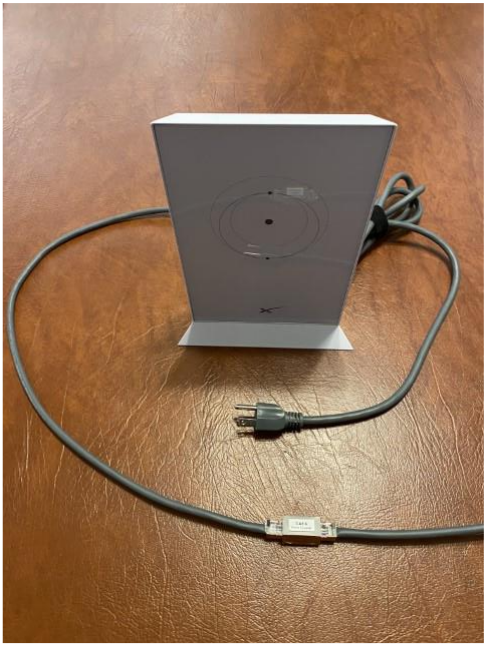
[picture p221: figure]

## Connectors

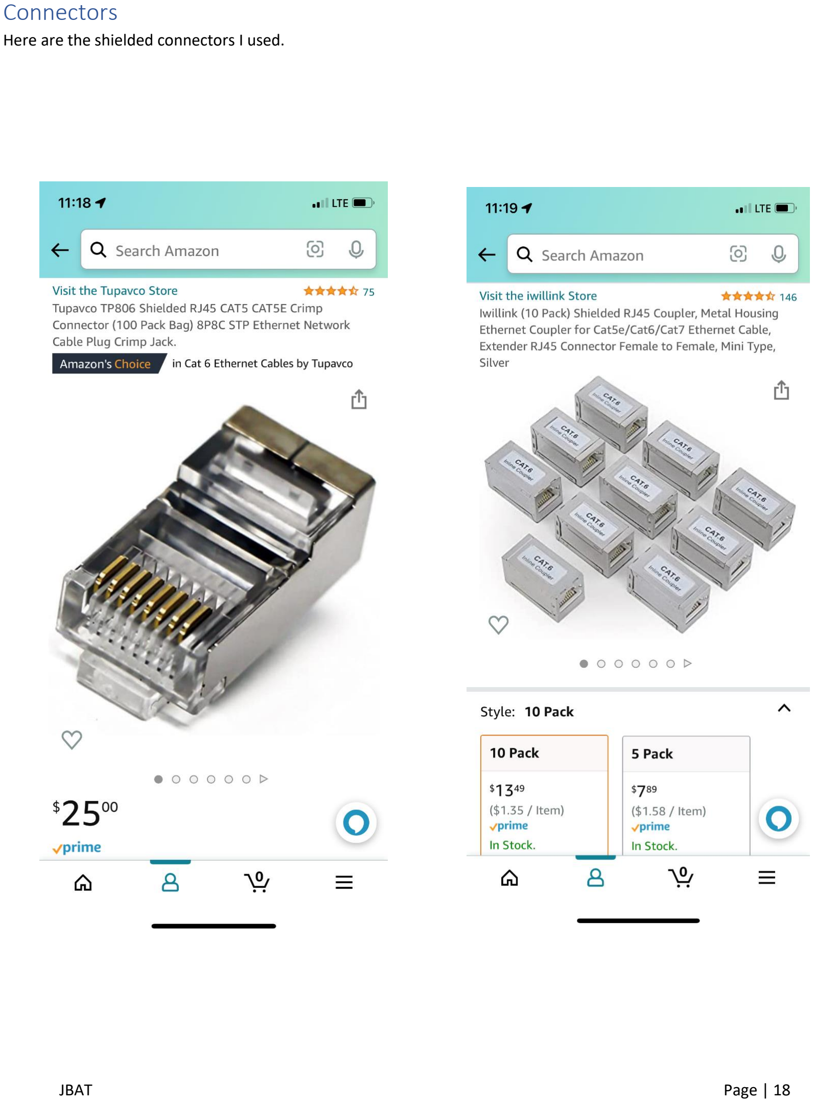
[picture p222: page 18]

Here are the shielded connectors I used.

## Summary

I had my own RJ45 crimper, if you don’t have one you will need to get one. I don’t like to use RJ45 passthrough connectors, but if you are not experienced in putting RJ45 ends on, I would suggest you get passthrough connectors. The wires slide in the connector extra long and then get cut of during the crimping process. It is a lot easier to handle long wires and get them in the correct order.

If you wanted to run this in your house, so you didn’t have to have the Starlink Ethernet port adapter, you would need to get a powered PoE that can supply 48volts and enough amps to run the dish.

I’m very happy with this, as I will use it in my RV, along with a Pepwave router/cell modem, that also runs on 12V, so that I can have redundancy with two cellular providers and my Starlink. The cell providers give me internet as I go down the road, and Starlink will give me fast unlimited data internet at my camp site. Using 12v means I don’t’ have to turn on my inverter to have internet.

I have used the Pepwave Max BR1 Mini LTE Router with much success, but it is only 2.4G wifi. I now use the Pepwave Max Transit Duo Router. It will stay connected to both cell providers at the same time and has 2.4 and 5G WiFi. 5gstore.com and mobilemusthave.com are two good places to get Pepwaves.

## Update for 6/12/2022

This has been updated, with typed color RJ45 layout, information on good POE's and bad POE's, and a good 120V AC power supply.

JBAT
