natecostello/van_two_point_oh/van/functional/functional_overview/functional_overview.mdx

---
type: categorypage
section: van
categories: 
 # one or more categories is permitted
 - functional

title: '"of or having a special activity, purpose, or task; relating to the way in which something works or operates"'
navTitle: Functional
author: Nate
date:
tags:
	# no tags
metatags:
	# no metatags
cover: 
	# image file
 img: functional.jpeg
	# if attribution is needed
 source: Van One Point Oh
	# url: url
tldr:
---

This page provides an overview of all things functional.  Like, it heats, it cooks, it lights, etc.
