natecostello/van_two_point_oh/van/parietal/parietal_overview/parietal_overview.mdx

---
type: categorypage
section: van
categories: 
	# one or more categories is permitted
	- parietal
title: '"of or relating to the walls of a part or cavity"'
navTitle: Parietal
author: Nate
date: 2021-06-04
tags:
	# no tags
metatags:
	# no metatags
cover: 
	# image file
 img: parietal.jpeg
	# if attribution is needed
 source: Van One Point Oh
	# url: url
tldr:
---

The walls, floor, and ceiling are composed of a mixture of aesthetic, structural, and sound and thermal insulating material.
