natecostello/van_two_point_oh/van/vehicular/vehicular_overview/vehicular_overview.md

---
type: categorypage
section: van
categories: 
 # one or more categories is permitted
 - vehicular

title: '"involving or by means of a vehicle"'
navTitle: Vehicular
author: Nate
date: 2020-10-26
tags:
	# no tags
metatags:
	# no metatags
cover: 
	# image file
 img: vehicular.JPG
	# if attribution is needed
 source: Van One Point Oh
	# url: url
tldr:
---

This section is primarily about vehicle upgrades and factory information.

Useful references:

The December 2020 [Body And Equipment Mounting Manual](2020-12-bemm.pdf) which covers the 2021 Ford Transit.

The 2021 [Body Builders Layout Book](2021-bblb.pdf).

The 2021 [Ford Transit Owner's Manual](2021-ford-transit-owners-manual-version-2_om_en-us_04_2021.pdf).

A 2016 [Bulletin on SEIC](sve-bulletin-q-239-stationary-elevated-idle-control).
