natecostello/van_two_point_oh/blog/2021-11-4-overhead-storage/overhead-storage.md

---
type: post
section: blog
categories: 
 # one or more categories is permitted
 - functional
navTitle: 
title: Overhead Storage
author: Nate
date: 2021-11-20
tags:
 - functional
 - storage
 - build
 
metatags:
	# no metatags
cover: 
	# image file
 img: cover.jpeg
	# if attribution is needed
	# source: [vecteezy]
	# url: url
tldr: "We modified dufflebags with grommets and stiffeners to form our overhead storage.  Think Mule bags without the expense.  It's light, cheap, and soft"
---

**TLDR: We modified dufflebags with grommets and stiffeners to form our overhead storage.  Think Mule bags without the expense.  It's light, cheap, and soft.**

Based on our Van 1.0 experience, we planned to do similar dufflebag based overhead storage on Van 2.0 from the git-go.  Here's our Van 1.0 approach: 

<blockquote
  class="instagram-media"
  data-instgrm-captioned
  data-instgrm-permalink="https://www.instagram.com/p/CAS6YS3JhLP/?utm_source=ig_embed&amp;utm_campaign=loading"
  data-instgrm-version="14"
  style="
    background: #fff;
    border: 0;
    border-radius: 3px;
    box-shadow: 0 0 1px 0 rgba(0, 0, 0, 0.5), 0 1px 10px 0 rgba(0, 0, 0, 0.15);
    margin: 1px;
    max-width: 540px;
    min-width: 326px;
    padding: 0;
    width: 99.375%;
    width: -webkit-calc(100% - 2px);
    width: calc(100% - 2px);
  "
>
  <div style="padding: 16px">
    <a
      href="https://www.instagram.com/p/CAS6YS3JhLP/?utm_source=ig_embed&amp;utm_campaign=loading"
      style="
        background: #ffffff;
        line-height: 0;
        padding: 0 0;
        text-align: center;
        text-decoration: none;
        width: 100%;
      "
      target="_blank"
    >
      <div style="display: flex; flex-direction: row; align-items: center">
        
        <div
          style="
            display: flex;
            flex-direction: column;
            flex-grow: 1;
            justify-content: center;
          "
        >

        </div>
      </div>
      
      <div
        style="display: block; height: 50px; margin: 0 auto 12px; width: 50px"
      >
        <svg
          width="50px"
          height="50px"
          viewBox="0 0 60 60"
          version="1.1"
          xmlns="https://www.w3.org/2000/svg"
          xmlnsXlink="https://www.w3.org/1999/xlink"
        >
          <g stroke="none" stroke-width="1" fill="none" fill-rule="evenodd">
            <g transform="translate(-511.000000, -20.000000)" fill="#000000">
              <g>
                <path
                  d="M556.869,30.41 C554.814,30.41 553.148,32.076 553.148,34.131 C553.148,36.186 554.814,37.852 556.869,37.852 C558.924,37.852 560.59,36.186 560.59,34.131 C560.59,32.076 558.924,30.41 556.869,30.41 M541,60.657 C535.114,60.657 530.342,55.887 530.342,50 C530.342,44.114 535.114,39.342 541,39.342 C546.887,39.342 551.658,44.114 551.658,50 C551.658,55.887 546.887,60.657 541,60.657 M541,33.886 C532.1,33.886 524.886,41.1 524.886,50 C524.886,58.899 532.1,66.113 541,66.113 C549.9,66.113 557.115,58.899 557.115,50 C557.115,41.1 549.9,33.886 541,33.886 M565.378,62.101 C565.244,65.022 564.756,66.606 564.346,67.663 C563.803,69.06 563.154,70.057 562.106,71.106 C561.058,72.155 560.06,72.803 558.662,73.347 C557.607,73.757 556.021,74.244 553.102,74.378 C549.944,74.521 548.997,74.552 541,74.552 C533.003,74.552 532.056,74.521 528.898,74.378 C525.979,74.244 524.393,73.757 523.338,73.347 C521.94,72.803 520.942,72.155 519.894,71.106 C518.846,70.057 518.197,69.06 517.654,67.663 C517.244,66.606 516.755,65.022 516.623,62.101 C516.479,58.943 516.448,57.996 516.448,50 C516.448,42.003 516.479,41.056 516.623,37.899 C516.755,34.978 517.244,33.391 517.654,32.338 C518.197,30.938 518.846,29.942 519.894,28.894 C520.942,27.846 521.94,27.196 523.338,26.654 C524.393,26.244 525.979,25.756 528.898,25.623 C532.057,25.479 533.004,25.448 541,25.448 C548.997,25.448 549.943,25.479 553.102,25.623 C556.021,25.756 557.607,26.244 558.662,26.654 C560.06,27.196 561.058,27.846 562.106,28.894 C563.154,29.942 563.803,30.938 564.346,32.338 C564.756,33.391 565.244,34.978 565.378,37.899 C565.522,41.056 565.552,42.003 565.552,50 C565.552,57.996 565.522,58.943 565.378,62.101 M570.82,37.631 C570.674,34.438 570.167,32.258 569.425,30.349 C568.659,28.377 567.633,26.702 565.965,25.035 C564.297,23.368 562.623,22.342 560.652,21.575 C558.743,20.834 556.562,20.326 553.369,20.18 C550.169,20.033 549.148,20 541,20 C532.853,20 531.831,20.033 528.631,20.18 C525.438,20.326 523.257,20.834 521.349,21.575 C519.376,22.342 517.703,23.368 516.035,25.035 C514.368,26.702 513.342,28.377 512.574,30.349 C511.834,32.258 511.326,34.438 511.181,37.631 C511.035,40.831 511,41.851 511,50 C511,58.147 511.035,59.17 511.181,62.369 C511.326,65.562 511.834,67.743 512.574,69.651 C513.342,71.625 514.368,73.296 516.035,74.965 C517.703,76.634 519.376,77.658 521.349,78.425 C523.257,79.167 525.438,79.673 528.631,79.82 C531.831,79.965 532.853,80.001 541,80.001 C549.148,80.001 550.169,79.965 553.369,79.82 C556.562,79.673 558.743,79.167 560.652,78.425 C562.623,77.658 564.297,76.634 565.965,74.965 C567.633,73.296 568.659,71.625 569.425,69.651 C570.167,67.743 570.674,65.562 570.82,62.369 C570.966,59.17 571,58.147 571,50 C571,41.851 570.966,40.831 570.82,37.631"
                ></path>
              </g>
            </g>
          </g>
        </svg>
      </div>
      <div style="padding-top: 8px">
        <div
          style="
            color: #3897f0;
            font-family: Arial, sans-serif;
            font-size: 14px;
            font-style: normal;
            font-weight: 550;
            line-height: 18px;
          "
        >
          View this post on Instagram
        </div>
      </div>
      
      <div
        style="
          display: flex;
          flex-direction: row;
          margin-bottom: 14px;
          align-items: center;
        "
      >
        <div>

        </div>
        <div style="margin-left: 8px">

        </div>
        <div style="margin-left: auto">

        </div>
      </div>
      <div
        style="
          display: flex;
          flex-direction: column;
          flex-grow: 1;
          justify-content: center;
          margin-bottom: 24px;
        "
      >
        
        </div
    ></a>
    <p
      style="
        color: #c9c8cd;
        font-family: Arial, sans-serif;
        font-size: 14px;
        line-height: 17px;
        margin-bottom: 0;
        margin-top: 8px;
        overflow: hidden;
        padding: 8px 0 7px;
        text-align: center;
        text-overflow: ellipsis;
        white-space: nowrap;
      "
    >
      <a
        href="https://www.instagram.com/p/CAS6YS3JhLP/?utm_source=ig_embed&amp;utm_campaign=loading"
        style="
          color: #c9c8cd;
          font-family: Arial, sans-serif;
          font-size: 14px;
          font-style: normal;
          font-weight: normal;
          line-height: 17px;
          text-decoration: none;
        "
        target="_blank"
        >A post shared by The Sticky Bandits (@agreenstellovan)</a
      >
    </p>
  </div>
</blockquote>

Our early sketchup models told us that we wanted squarish bags, with dimensions of 12-16 inches wide by 13-16 inches tall.  Note, in the mounted orientation, "tall" becomes "wide" and "wide" becomes "tall".

A couple other bag features are important:  
 * We want thin compartments on the square sides to allow insertion of stiffening material.  
 * We want a top (which will be front) closure system that provides good loading access.  A single straight length-wise zip is not ideal, a swooping zipper or double zip is ideal.
 * We an pockets on the long sides to be oriented such that they are on the "bottom" side when the bags are mounted, since the "top" side won't be accessible.

We started with about 8 contenders.  We'd link them, but have found the internet lives of dufflebags are ethereal.

Upon van delivery we were able to identify exactly where our ceiling and wall L-track would run based on available factory holes.  This allowed us to make some mockups (i.e. cardboard squares) based on the contender's height-width.  This let us get a real sense of how much a bag would protrude into our head space.  Based on this evaluation we narrowed down the desired sizes to 14Wx14H or 15Wx14H (meaning no more than 14 inches protrusion towards the center of the van when mounted).  Those dimensions, in concert with our other desired features led us to order one each of these two options:

* [30x14Wx14H](https://www.duffelbags.com/duffel-bags/classic-gear-bag-large): $34 SKU:EV-1005LD
* [30x15Wx14H](https://www.duffelbags.com/duffel-bags/duffelgear-grand-canyon-duffel-30inch): $24 SKU:DFL30-36

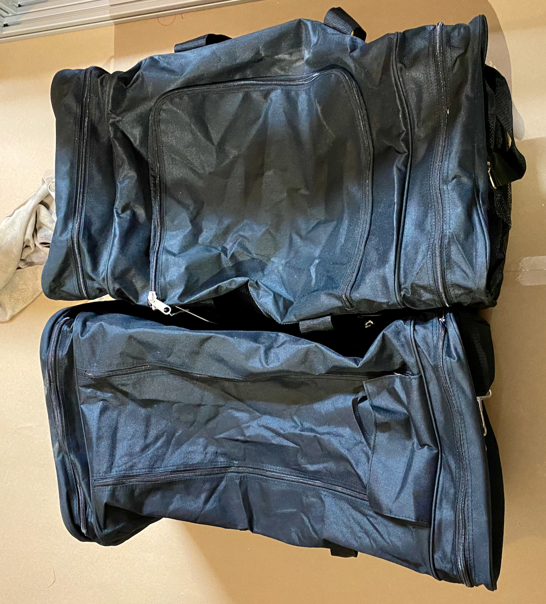
[picture p225: blog/2021-11-4-overhead-storage/contenders.jpeg]
two contenders

_These are the two we decided to move forward to the prototype phase._

Once we had our L-track installed, we added grommets and installed the 14x14 bag as a prototype. Based on its size, shape, and functionality we decided that was [the one](https://www.duffelbags.com/duffel-bags/classic-gear-bag-large), so we ordered seven more.

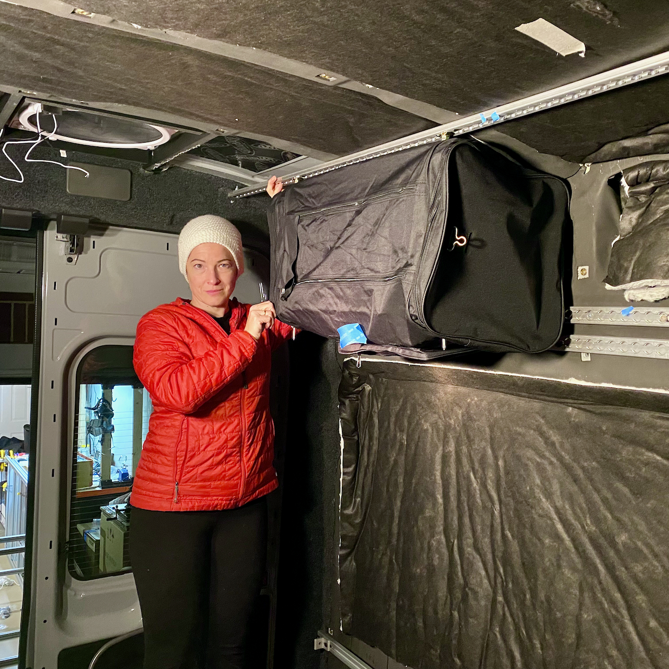
[picture p226: blog/2021-11-4-overhead-storage/trial-fit.jpeg]
trial fit

_We were happy enough with the first prototype to skip bothering with the second bag._

We mount the bags to the L-track using four of[these 3/8-24 studs](https://www.amazon.com/gp/product/B07YZ4CQ7D/) per bag, two in the top, two in the rear.  The studs are installed with a thin nut that holds them in place irrespective of whether a bag is installed.  The bag is installed by placing the grommet over the stud, against the thin nut, and captured with a washer and another nut.

We take one bag and hold it up in place and mark where the four L-track studs will pass through the grommets.  We then install grommets that will pass over a 3/8 inch stud.  We purchased our [grommet kit](https://www.amazon.com/gp/product/B07FKHHTMZ/) from amazon.  Update: We later reinforced the bags by sewing [webbing](https://www.amazon.com/gp/product/B01KTVB9E0/) into these locations and re-grommeting.  We'd recommend doing that unless you are lightly loading the bags.  

For stiffeners, we use 1/4" expanded PVC sheet.  It's light, can't mold or grow anything, and is available from home depot.  Each bag gets a 14x14 inch stiffener that goes in the square compartments on each end.  Then we add a 14x29ish inch stiffener that sits in the bottom (in the mounted orientation).  These allow help the bags retain their physical shape when loaded.  Update:  We later rounded the corners on these to eliminate a wear point against the bag material when loaded.

Our last step was to use a steamer to steam the bags to get all those little wrinkles out.  This purely for aesthetics, but really improves the look.

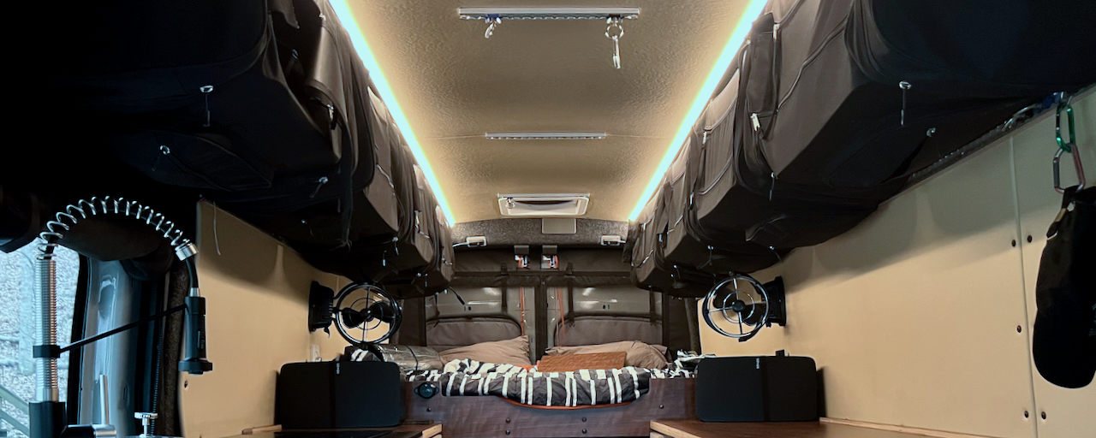
[picture p227: blog/2021-11-4-overhead-storage/complete.jpeg]
complete and installed

_Here they are installed, steamed, and loaded._

## What We Would Change

Nothing from the final configuration, we love them.  We would have sewn in the reinforcement webbing upon initial grommeting, rather than waiting to see them fail!  We also would have rounded the stiffener corners from start.

## Timeline:

Note, this doesn't reflect full time effort.  It's mostly evenings and partial days, limited by work, shakedown failures, etc.

* Cardboard fit test, narrowed the sizes to 14x14 and 14Hx15W bags (8-30-2021) 
* Fabricated the first prototype and installed.  Ordered 7 more of the selected bag. (2021-11-4)
* Cut stiffeners from expanded PVC sheet for the prototype (11-11-2021)
* Grommeted and installed the remaining 7 bags (11-20-2021)
* Cut stiffeners for the remaining 7 bags (11-21-2021)
* Reinforced the grommeted areas with webbing after a few shakedown voyage failures and rounded stiffener corners (4-8-2022)
