natecostello/van_two_point_oh/blog/2021-6-27-fridge-freezer-unboxing/fridge-unboxing.md

---
type: post
section: blog
categories: 
 # one or more categories is permitted
 - functional
navTitle: 
title: Unboxing the Refrigerator and Freezer
author: Sophia
date: 2021-06-27
tags:
 - build
 - functional
 - galley
 
metatags:
	# no metatags
cover: 
	# image file
 img: fridge-cover.jpeg
	# if attribution is needed
	# source: [vecteezy]
	# url: url
tldr: "This is Sophia's first post.  It describes our unboxing... which is very great and interesting."
---
**TLDR: This is Sophia's first *post*.  It describes our unboxing... which is very great and interesting.**  

I could go on and on and on and on... but first I would like to offer more details on how to open a box.

## How to Open a Box

First you get a box, and then you cut a hole in the box.  Hopefully there is a Vitrifrigo refrigerator in it, otherwise you will get an awful surprise!!!

And then you will want to know... some more things about removing tape.
