natecostello/van_two_point_oh/blog/2022-1-20-booth-seat/booth-seat.md

1-20-2022
Foam delivered
Soph started making cushions for booth seat.

1-21-2022
Soph finished all cushions for booth seat.

1-23-2022
Design review of booth

1-25-2022
Ordered all booth 8020

2-11-2022
Soph installed booth 8020

2-15-2022
Cut booth panels

2-18-2022
Swapped orientation of inboard fore-aft upper 8020 piece to allow espar panel to work
Formica'd booth panels

2-19-2022
Flushcut, sanded, masked

2-22-2022
urethaned all booth panels

2-25-22
installed booth panels
