natecostello/van_two_point_oh/van/functional/ventilation/ventilation.md

---
type: article
section: van
categories: 
 # one or more categories is permitted
 - functional

title: Ventilation
navTitle: 
author: Nate
date: 2021-07-15
tags:
 - van
 - functional
 - hvac
 - cooling
 - climate
	# no tags
metatags:
	# no metatags
cover: 
	# image file
	# img: img
	# if attribution is needed
	# source: [vecteezy]
	# url: url
tldr:
---

We'll be doing a maxair fan, same as before, but only one this time.

We'll also be doing two [Sirocco II fans](https://seekr.caframobrands.com/products/seekr/marine/fans.html), which are out of stock.
