natecostello/van_two_point_oh/blog/2022-3-11-24v-alternator/sterling-alternator-protection-device.pdf

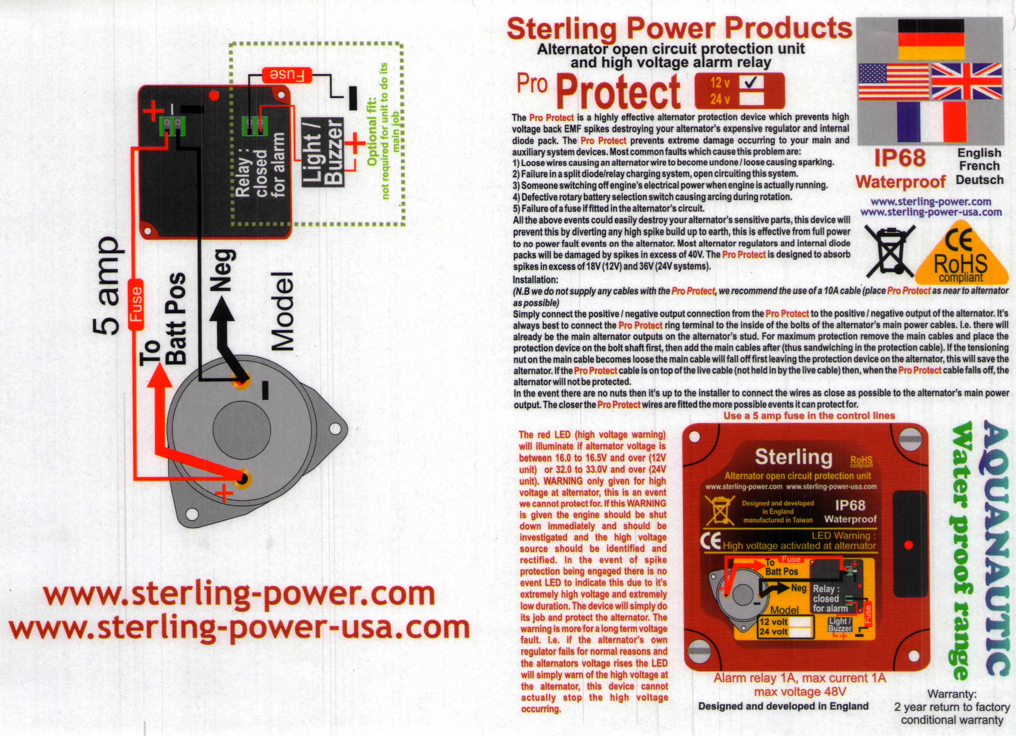
[picture p229: page 1]
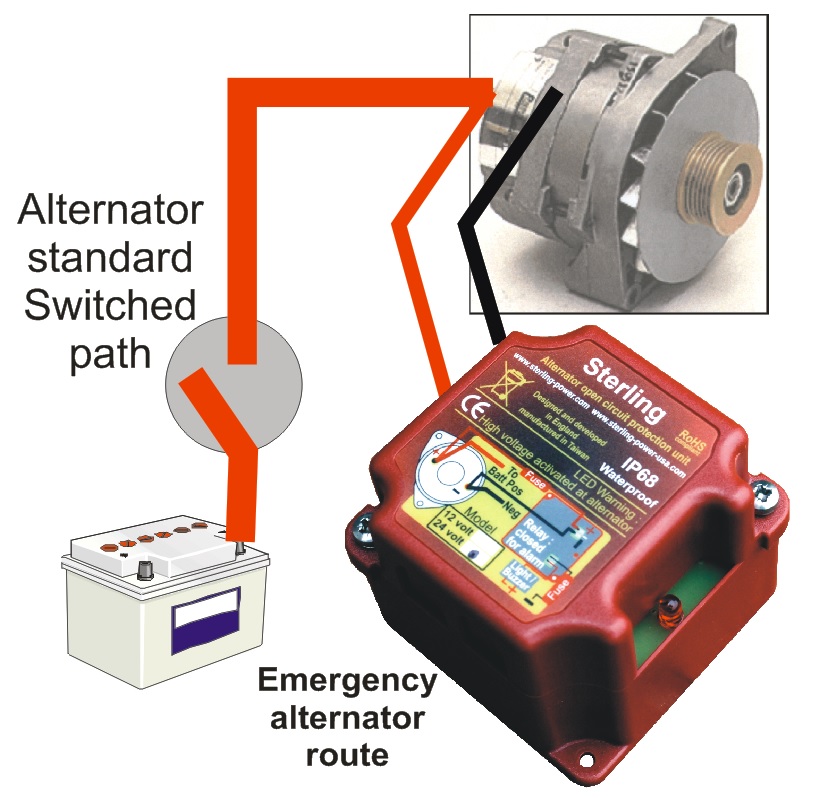
[picture p230: page 2]
