natecostello/van_two_point_oh/van/tactical/2020-10-10 Van Planning - Categories.pdf

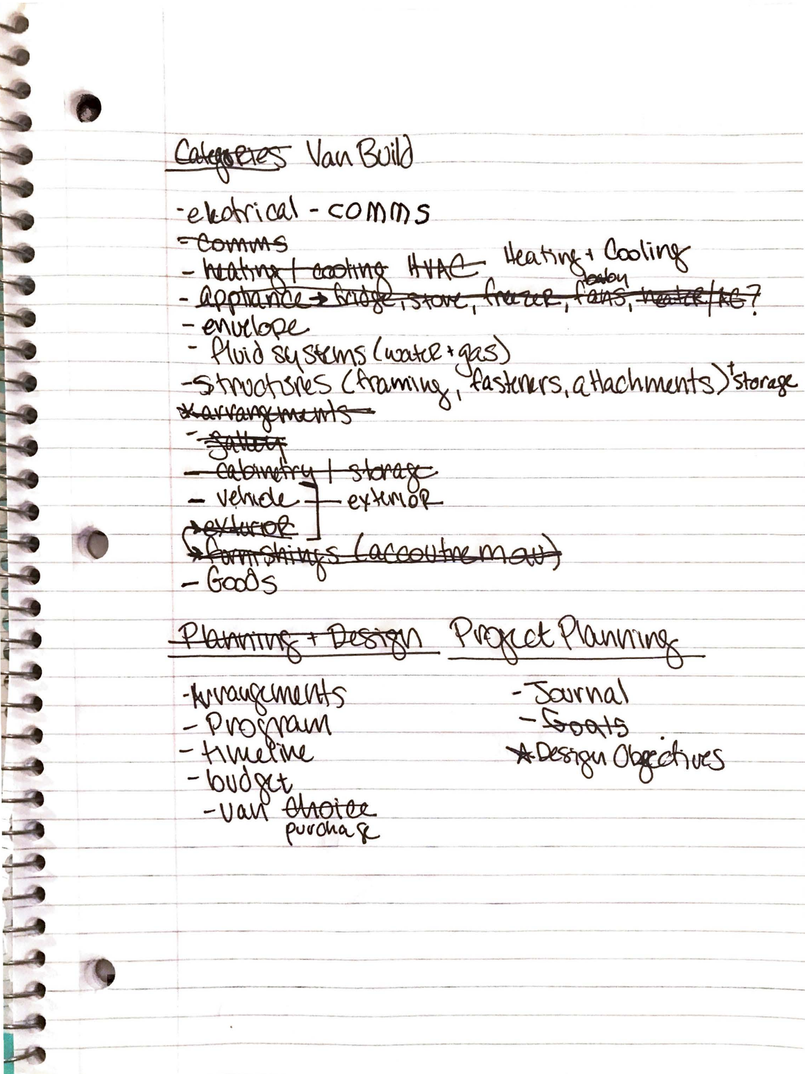
[picture p231: page 1]

r
I | t:lt
~ | -- - | -----

;_

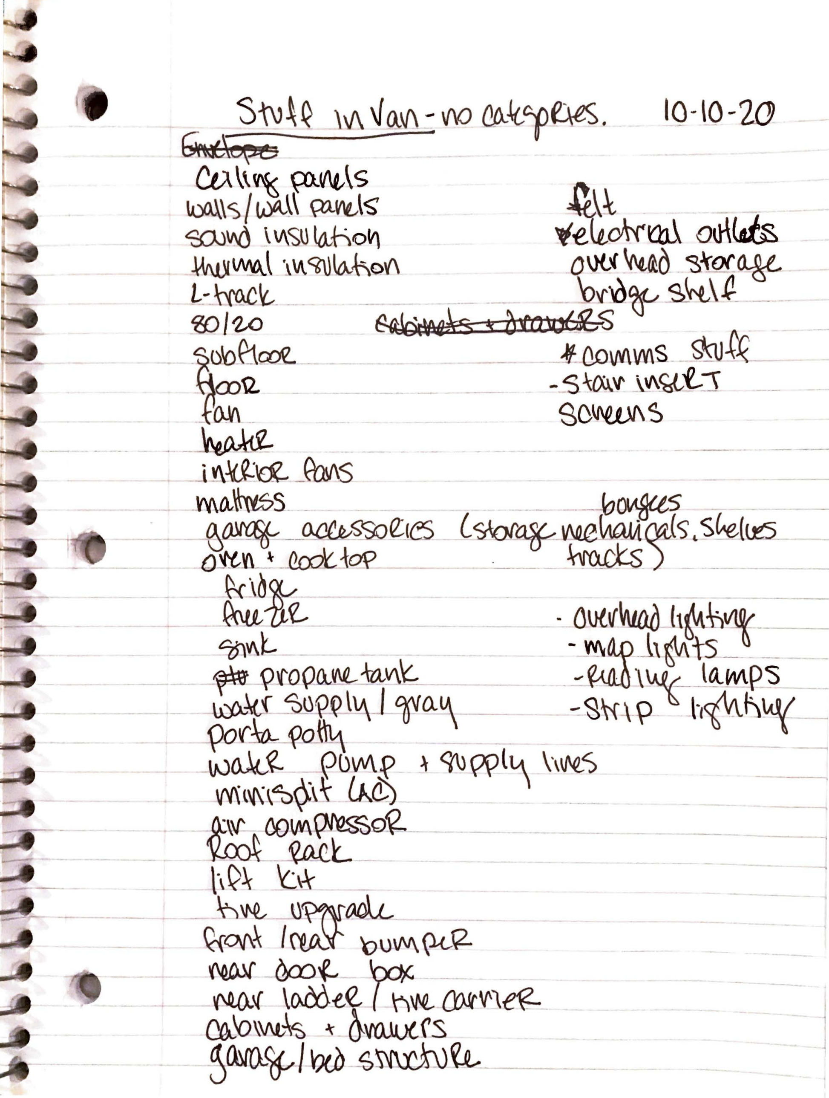
[picture p232: page 2]

I
~

~ ~ -· .

~
~
~ 1~
~ -
L...t

~
~ -
_..
,.....
_.

~
~
~ --
~
~
~
~
~
