natecostello/van_two_point_oh/blog/2021-6-26-battery-interconnect-design/battery-interconnect-cover.jpg

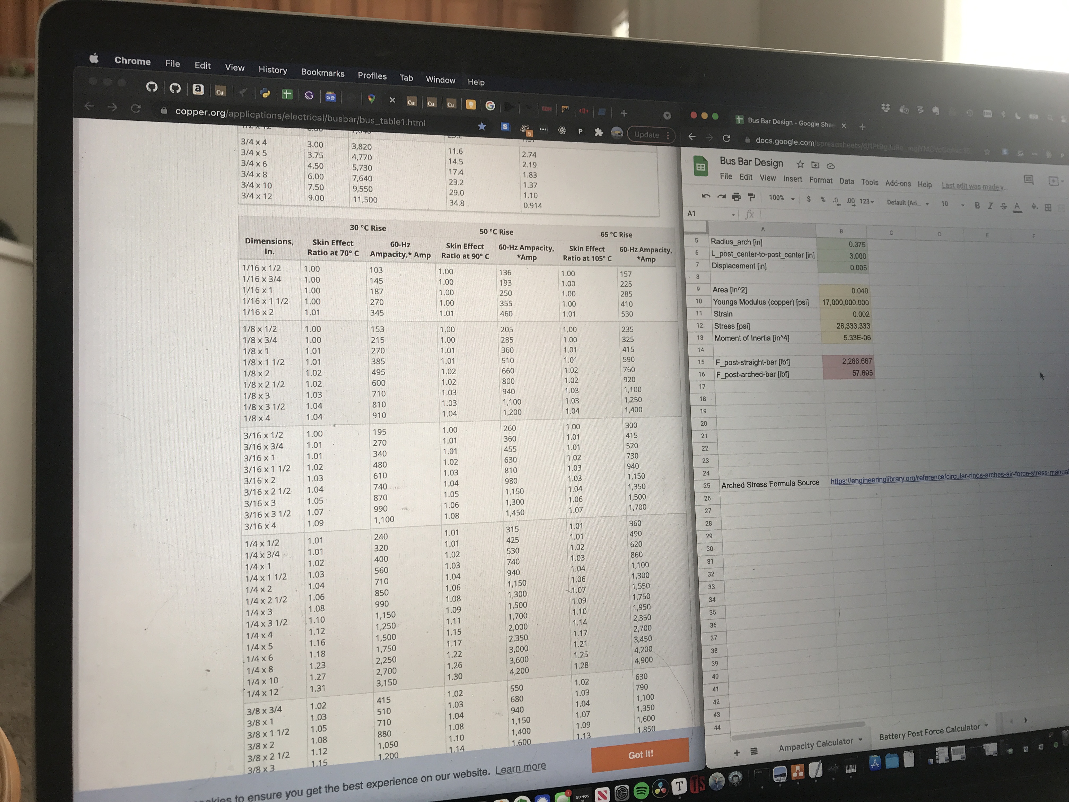
blog/2021-6-26-battery-interconnect-design/battery-interconnect-cover.jpg
