natecostello/van_two_point_oh/blog/2021-7-5-battery-interconnect-redesign/battery-interconnect-v2-cover.jpeg

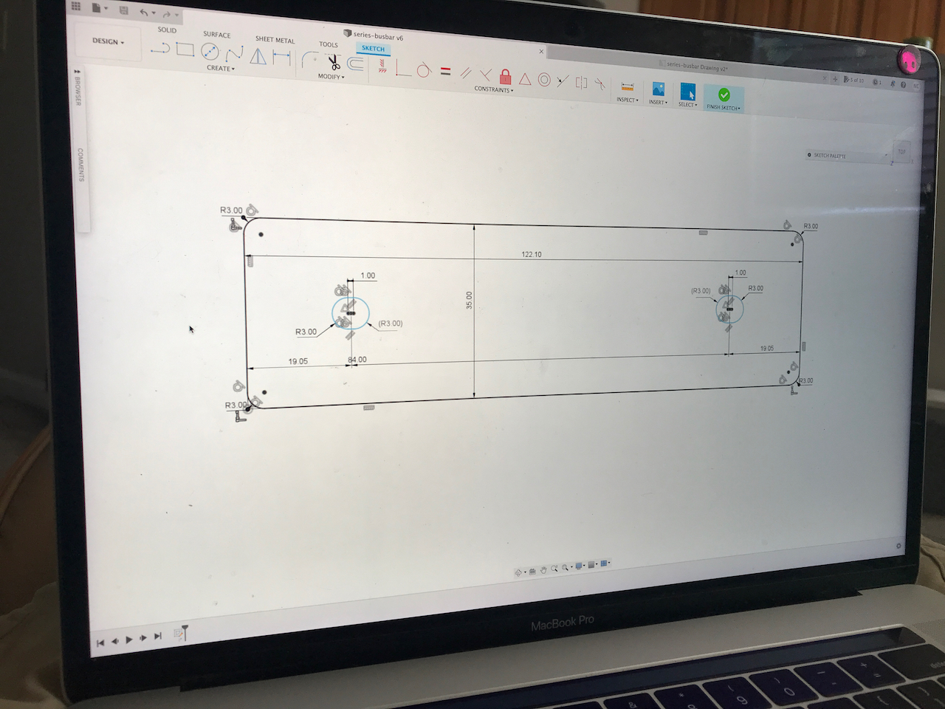
blog/2021-7-5-battery-interconnect-redesign/battery-interconnect-v2-cover.jpeg
