natecostello/van_two_point_oh/blog/2021-7-5-battery-interconnect-redesign/series-busbar-drawing.png

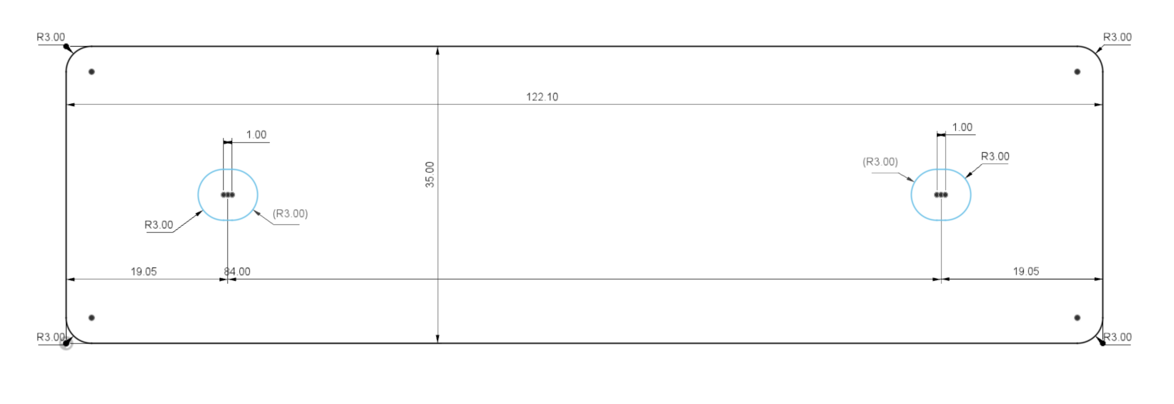
blog/2021-7-5-battery-interconnect-redesign/series-busbar-drawing.png
