natecostello/van_two_point_oh/blog/2021-9-3-structural-design-and-mockup/mockup-cover.jpeg

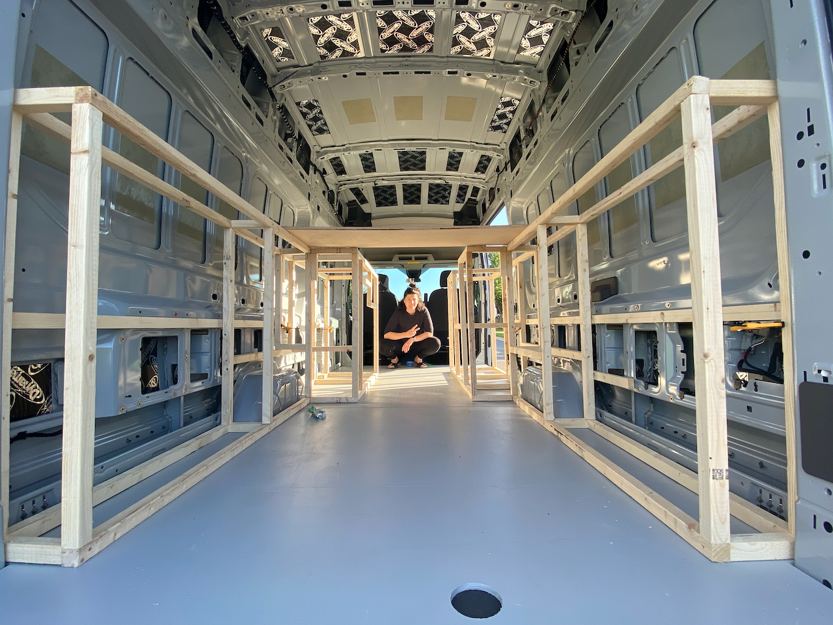
blog/2021-9-3-structural-design-and-mockup/mockup-cover.jpeg
