natecostello/van_two_point_oh/blog/blog_overview/blog-overview.JPG

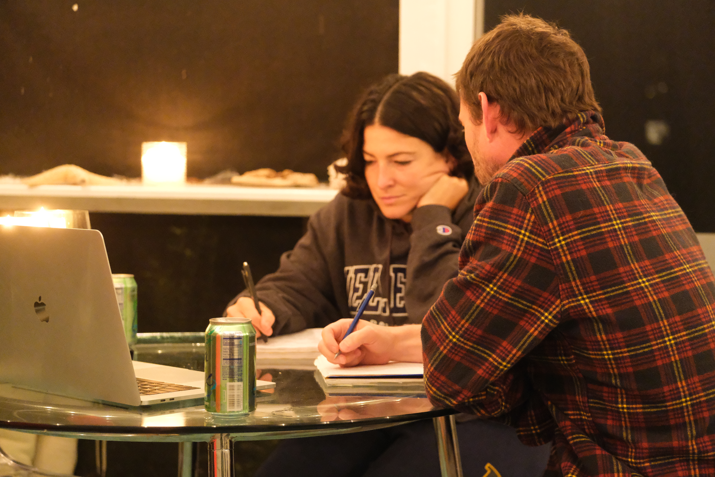
blog/blog_overview/blog-overview.JPG
