natecostello/van_two_point_oh/van/electrical/electrical_overview/rando-van-elec.jpeg

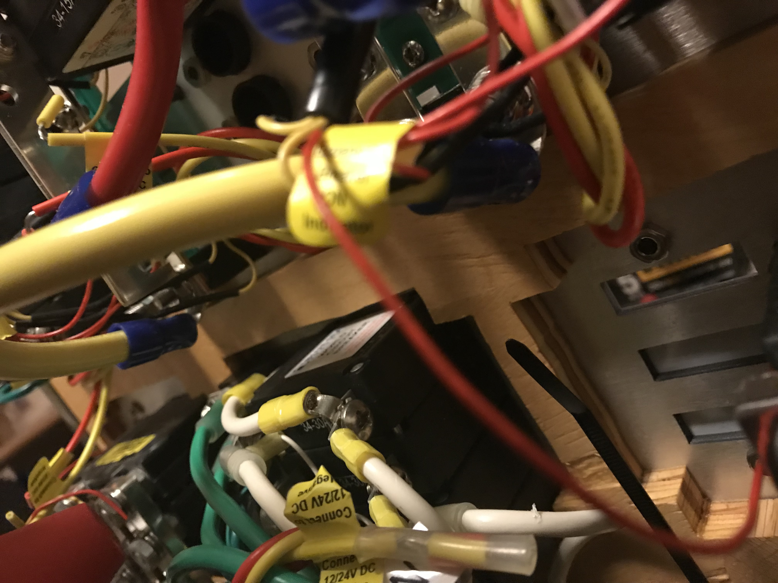
van/electrical/electrical_overview/rando-van-elec.jpeg
