natecostello/van_two_point_oh/van/electrical/schematic/schematic.jpg

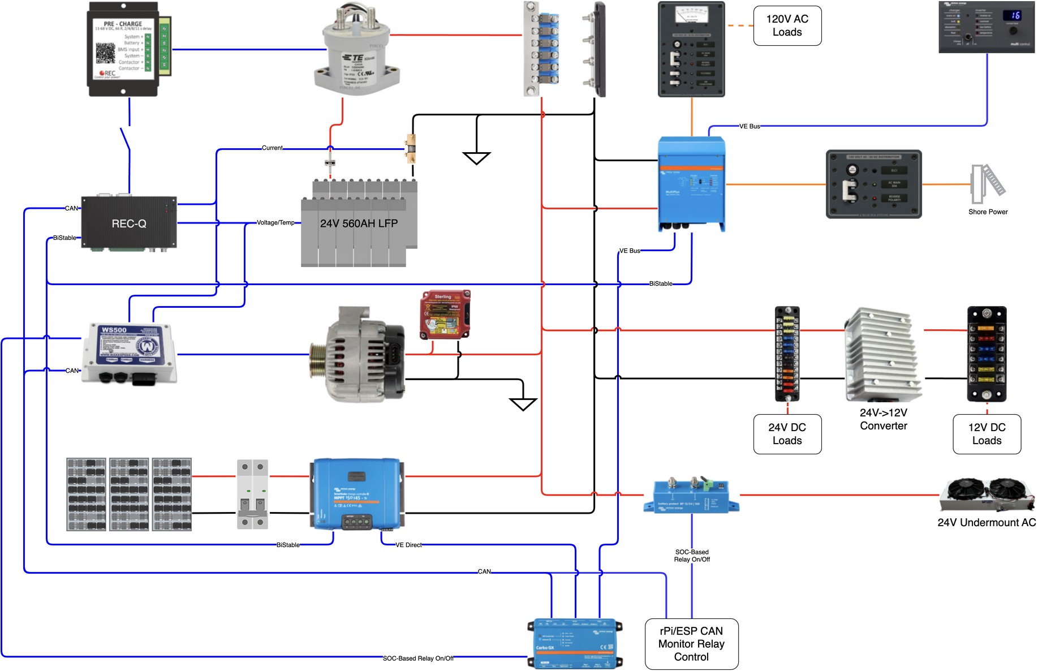
van/electrical/schematic/schematic.jpg
