natecostello/van_two_point_oh/van/functional/functional_overview/functional.jpeg

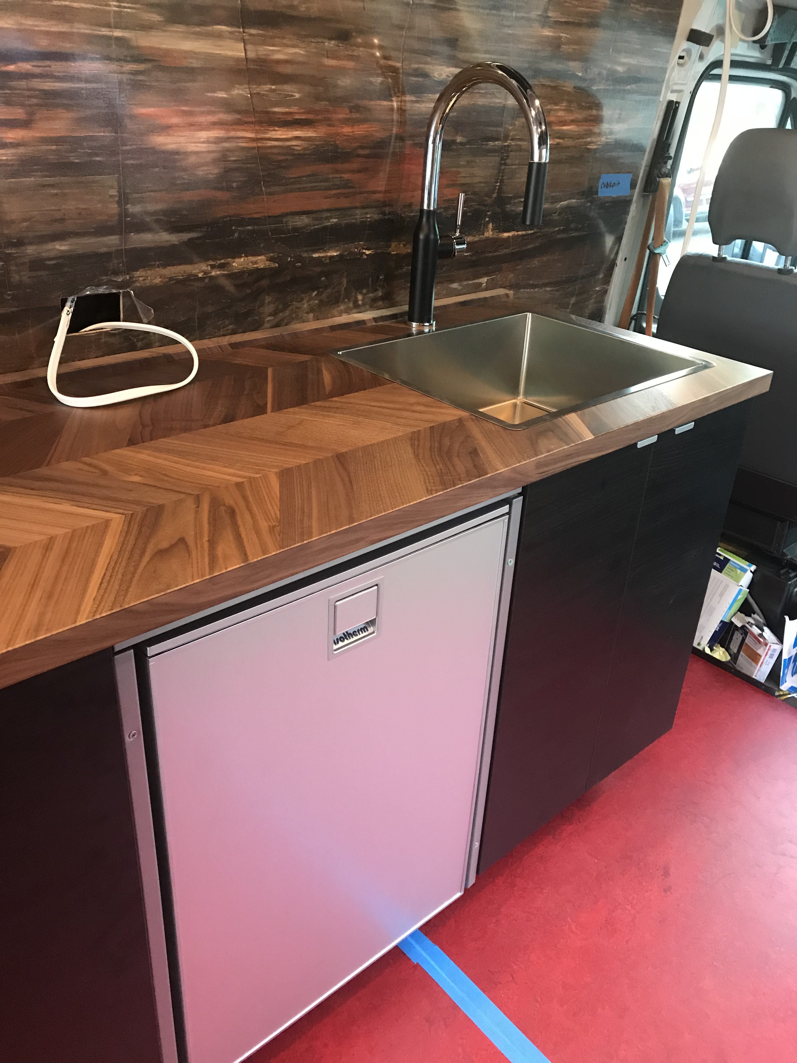
van/functional/functional_overview/functional.jpeg
