natecostello/van_two_point_oh/van/functional/lighting/Bottom Plate Spec a.png

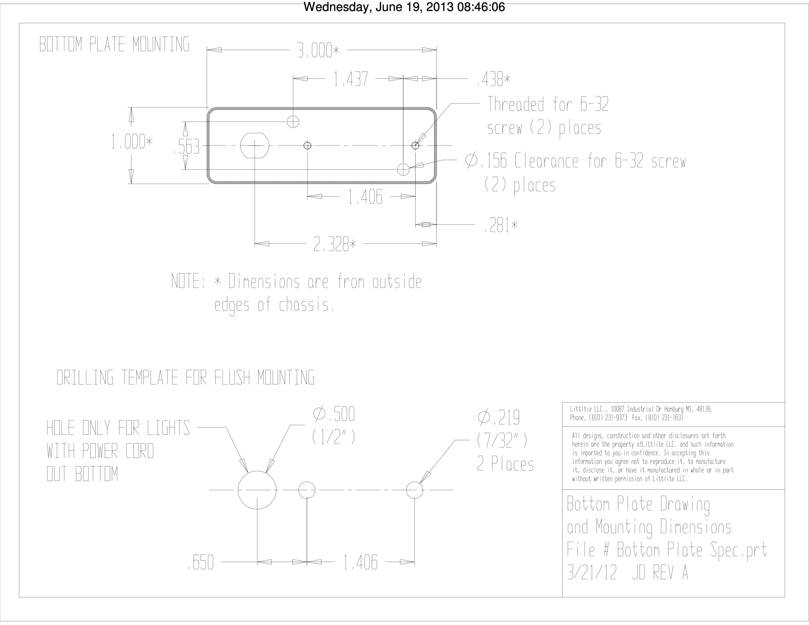
van/functional/lighting/Bottom Plate Spec a.png
