natecostello/van_two_point_oh/van/mechanical/mechanical_overview/mechanical.jpeg

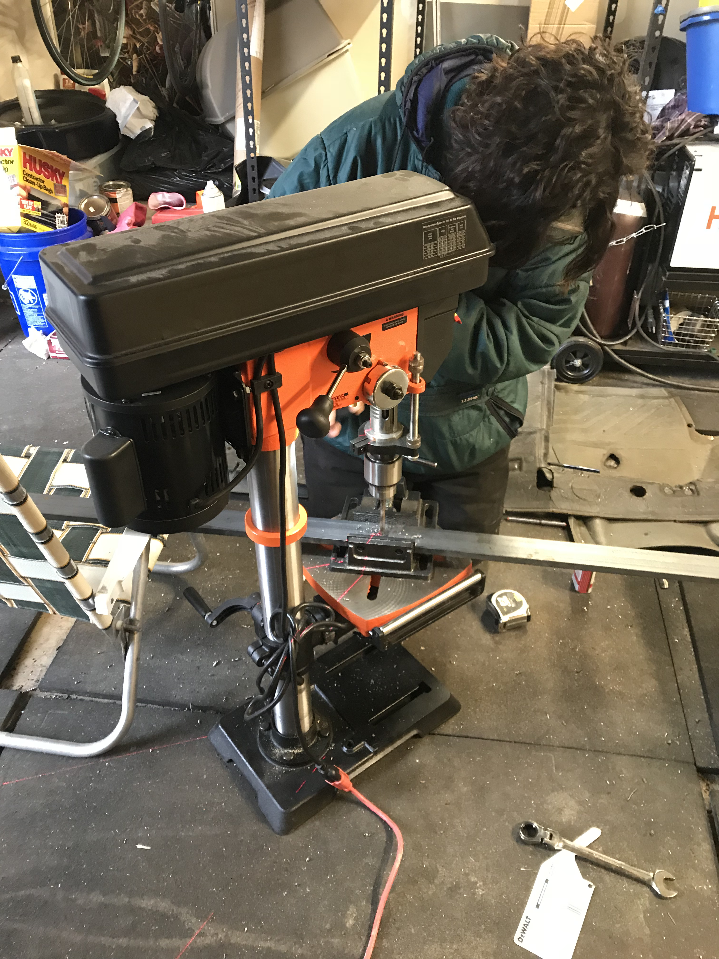
van/mechanical/mechanical_overview/mechanical.jpeg
