natecostello/van_two_point_oh/van/mechanical/propane/cover.jpeg

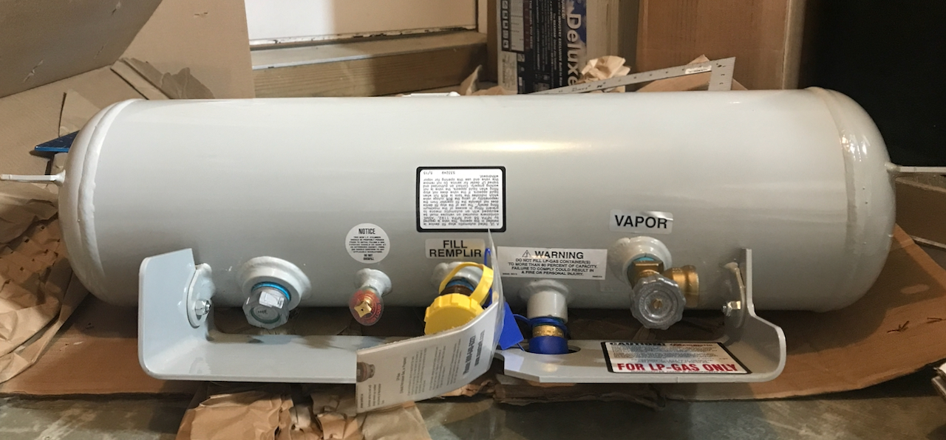
van/mechanical/propane/cover.jpeg
