natecostello/van_two_point_oh/van/parietal/parietal_overview/parietal.jpeg

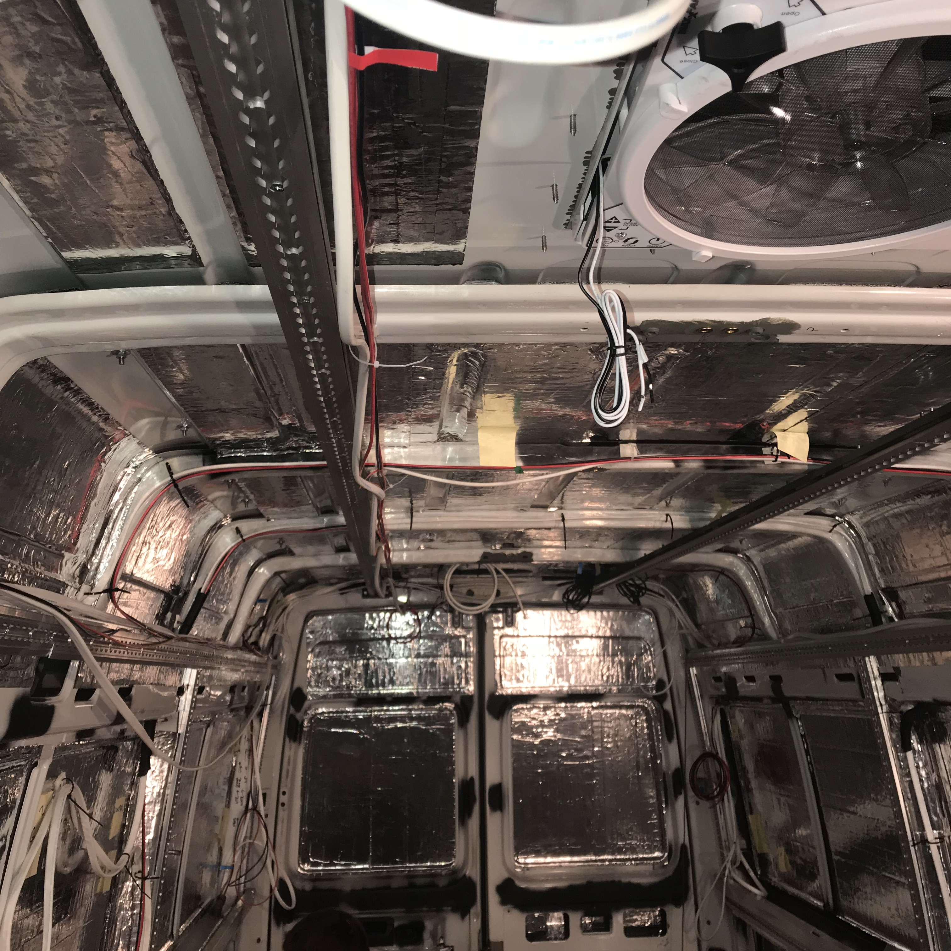
van/parietal/parietal_overview/parietal.jpeg
