natecostello/van_two_point_oh/van/structural/structural_overview/structural.JPG

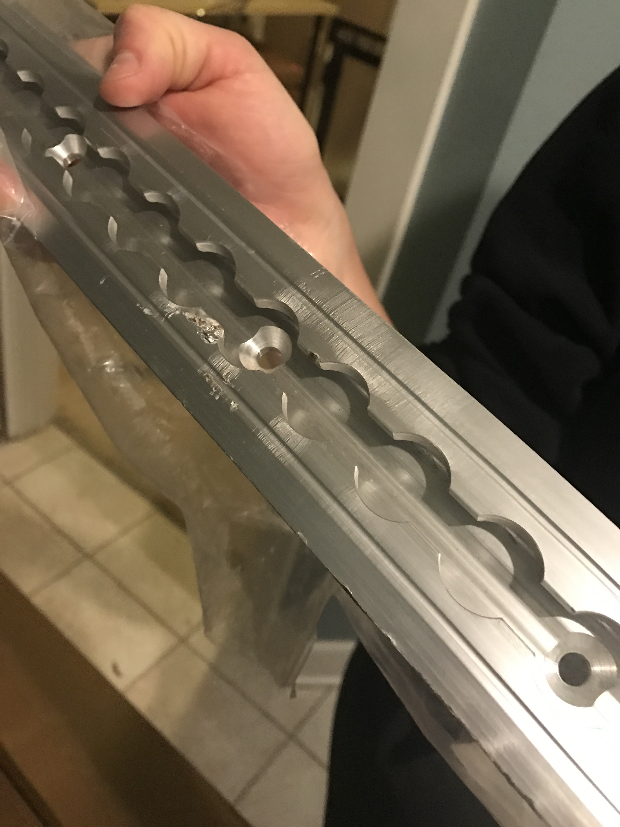
van/structural/structural_overview/structural.JPG
