natecostello/van_two_point_oh/van/van_overview/transit-layout-3D.jpg

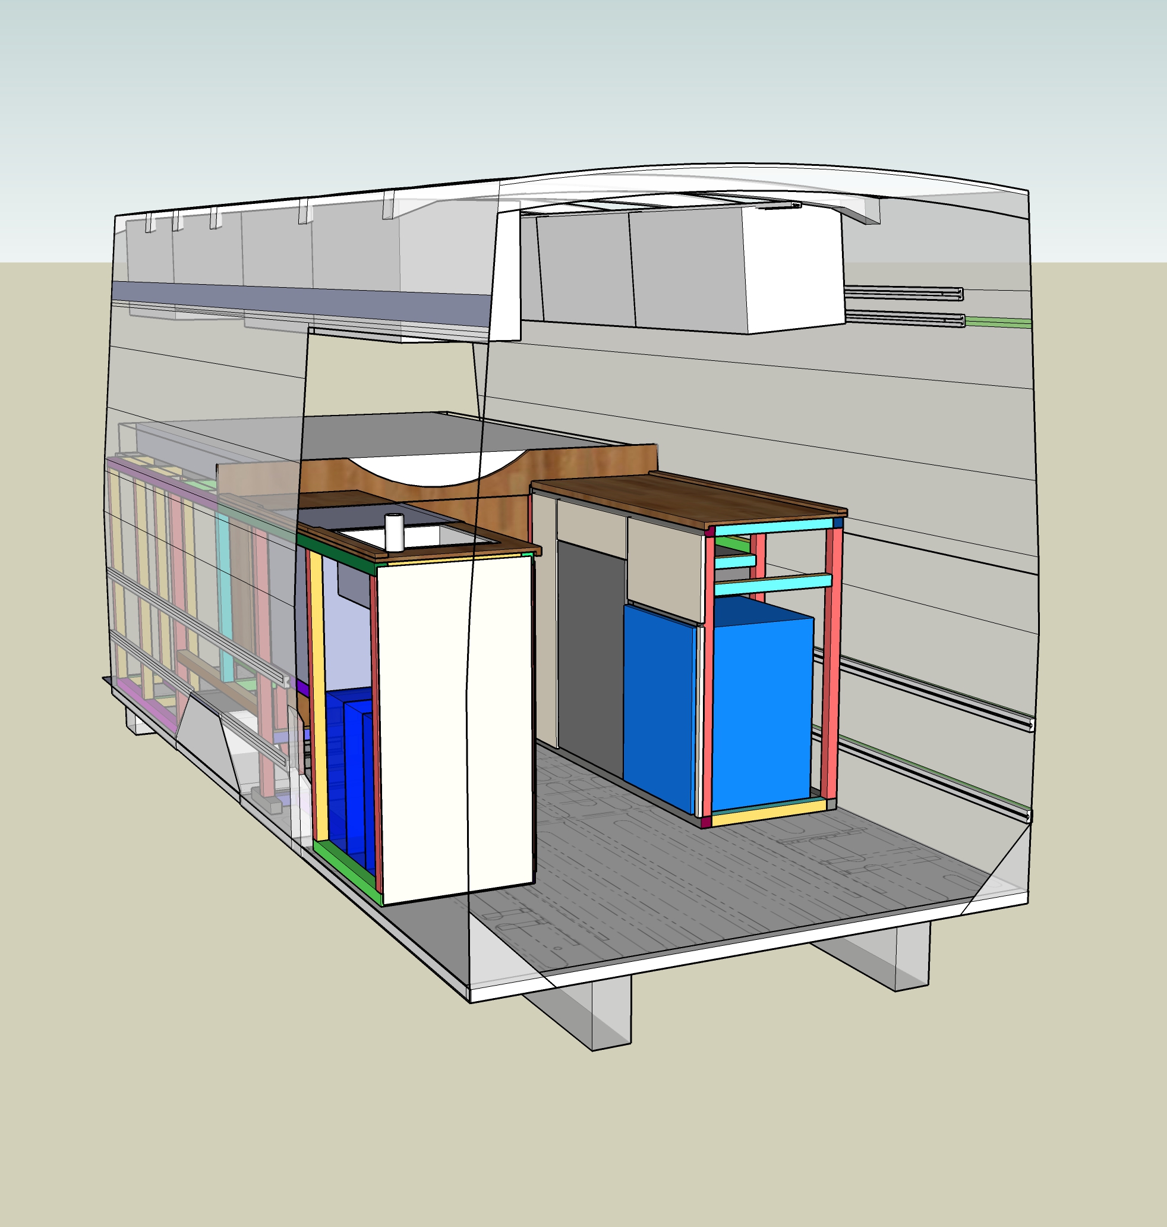
van/van_overview/transit-layout-3D.jpg
