natecostello/van_two_point_oh/van/vehicular/vehicular_overview/vehicular.JPG

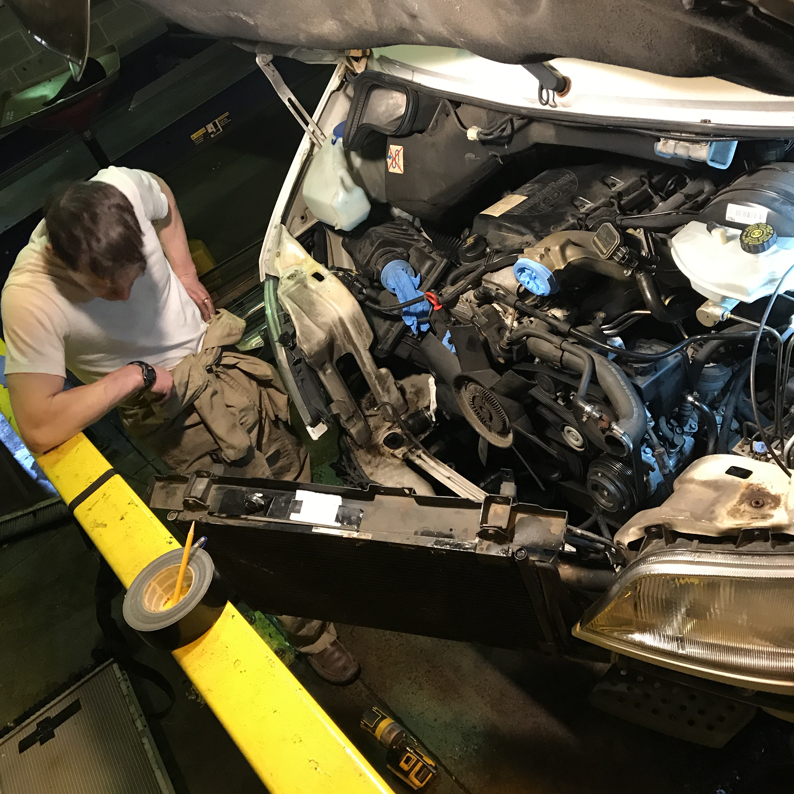
van/vehicular/vehicular_overview/vehicular.JPG
