natecostello/van_two_point_oh/van/vehicular/order_progress/order_progress.md

Convo with Nick 2/6/2021

Still not scheduled.  Sitting in the order bank.  Sent Ford another email.  

Next check in: Next Saturday.
