natecostello/van_two_point_oh/blog/2020-12-15-vehicle-order/cover.jpeg

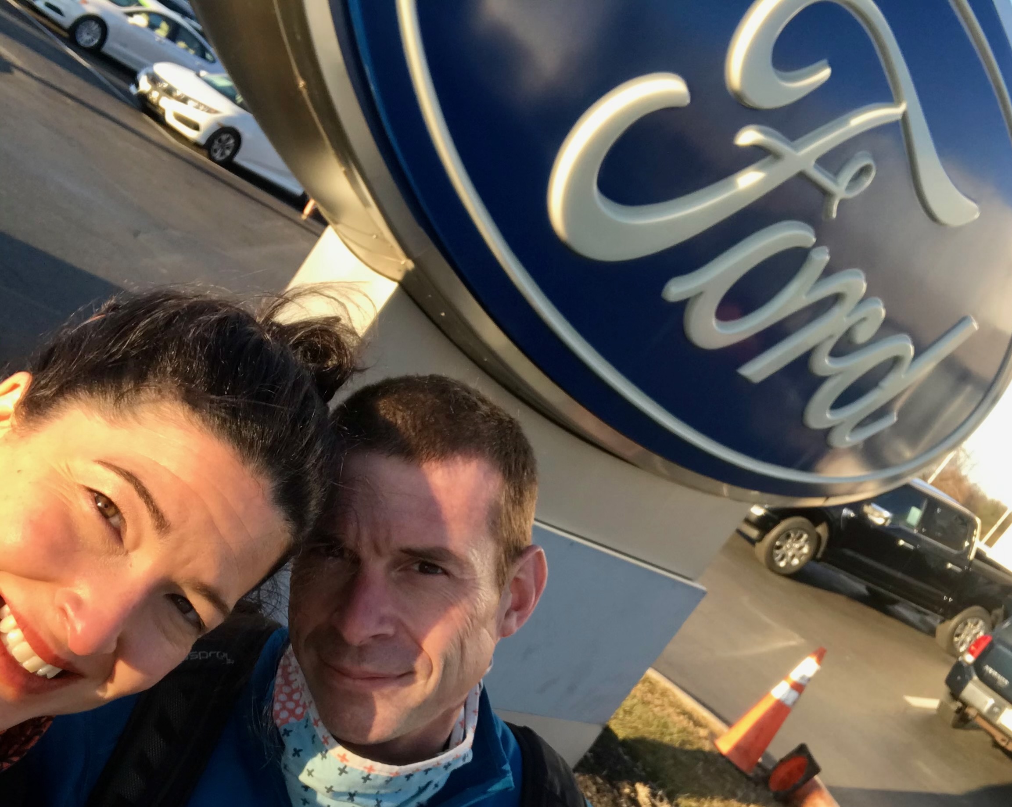
blog/2020-12-15-vehicle-order/cover.jpeg
