natecostello/van_two_point_oh/van/vehicular/order_options/cover.jpeg

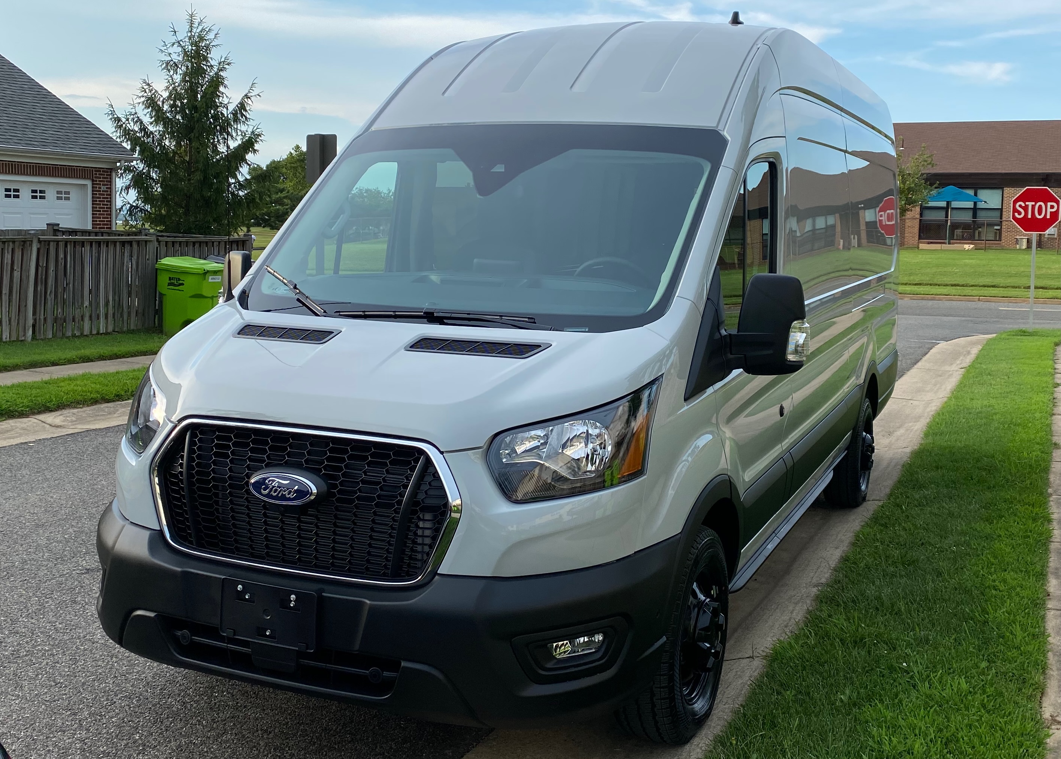
van/vehicular/order_options/cover.jpeg
