natecostello/van_two_point_oh/van/electrical/main-control-panel/main-control-panel.dxf

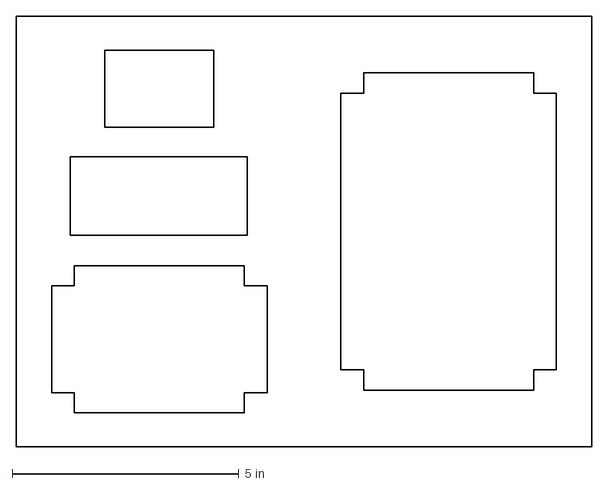
[picture p256: CAD file, 2025-05-10]
van/electrical/main-control-panel/main-control-panel.dxf
12.7 x 9.50 in
