natecostello/van_two_point_oh/blog/2021-12-13-smartplug-mount/outlet-plate-order.dxf

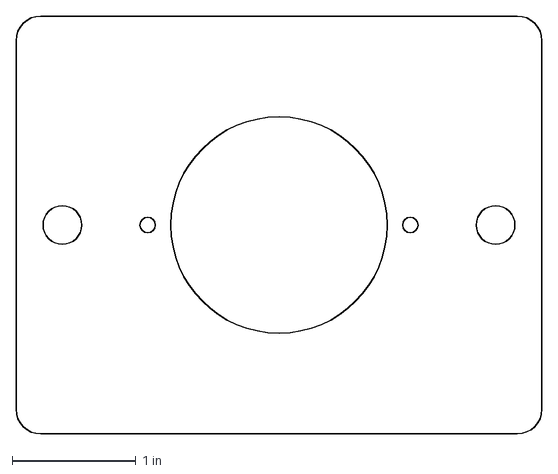
[picture p257: CAD file, 2025-05-10]
blog/2021-12-13-smartplug-mount/outlet-plate-order.dxf
4.26 x 3.38 in
