natecostello/van_two_point_oh/blog/2021-7-5-battery-interconnect-redesign/series-bar-v2.dxf

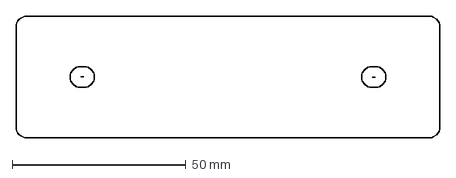
[picture p258: CAD file, 2025-05-10]
blog/2021-7-5-battery-interconnect-redesign/series-bar-v2.dxf
122.1 x 35.0 mm
