natecostello/van_two_point_oh/blog/2022-1-15-8020-panels/flat-bracket.dxf

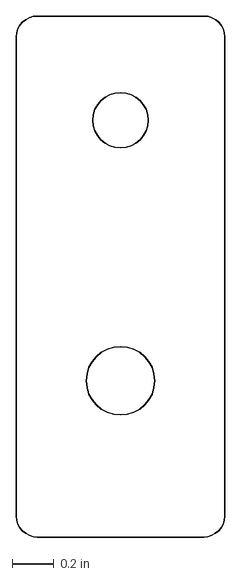
[picture p259: CAD file, 2025-05-10]
blog/2022-1-15-8020-panels/flat-bracket.dxf
1.00 x 2.50 in
