natecostello/van_two_point_oh/blog/2022-11-3-starlink/Starlink-Dish-Rectangular.step

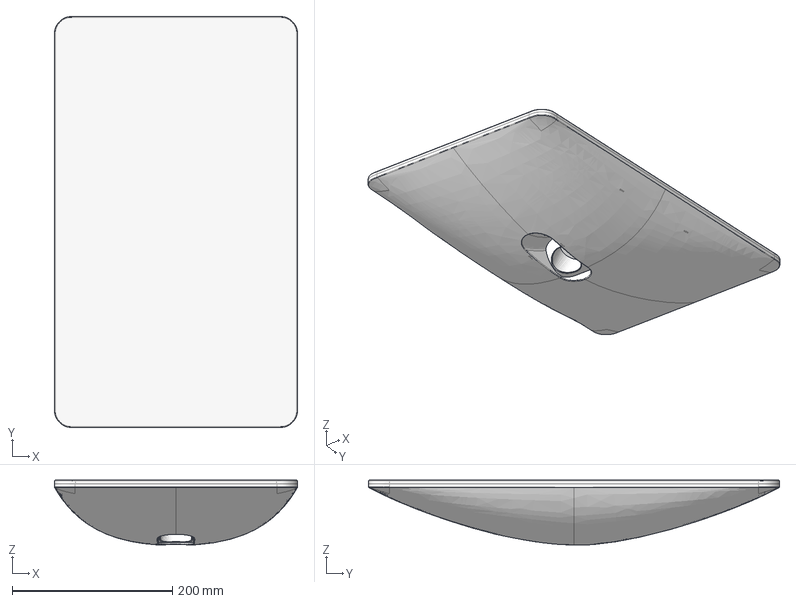
[picture p260: CAD file, 2025-05-10]
blog/2022-11-3-starlink/Starlink-Dish-Rectangular.step
303.3 x 512.7 x 80.9 mm
