natecostello/van_two_point_oh/blog/2022-8-27-bike-rack/bike-spacer.dxf

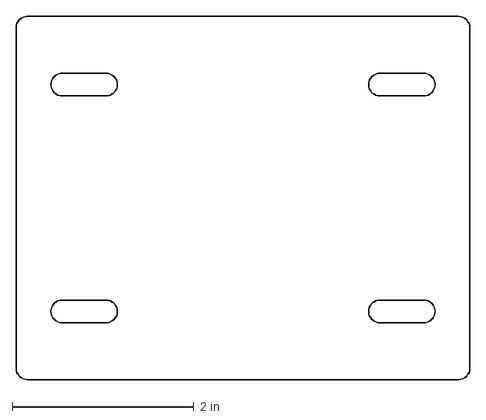
[picture p261: CAD file, 2025-05-10]
blog/2022-8-27-bike-rack/bike-spacer.dxf
5.00 x 4.00 in
