natecostello/van_two_point_oh/blog/2023-2-18-aux-solar/panel-storage-bracket.dxf

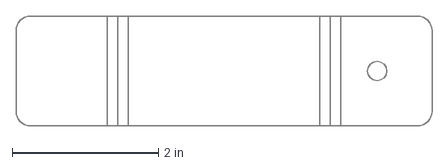
[picture p262: CAD file, 2025-05-10]
blog/2023-2-18-aux-solar/panel-storage-bracket.dxf
5.69 x 1.50 in
