natecostello/van_two_point_oh/blog/2023-3-04-galley-top-trim/galley-top.dwg.dxf

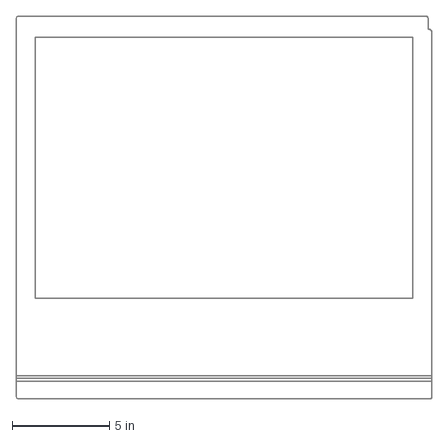
[picture p263: CAD file, 2025-05-10]
blog/2023-3-04-galley-top-trim/galley-top.dwg.dxf
21.4 x 19.7 in
