natecostello/van_two_point_oh/blog/2023-3-15-air-cond-install/LHS-bracket.dxf

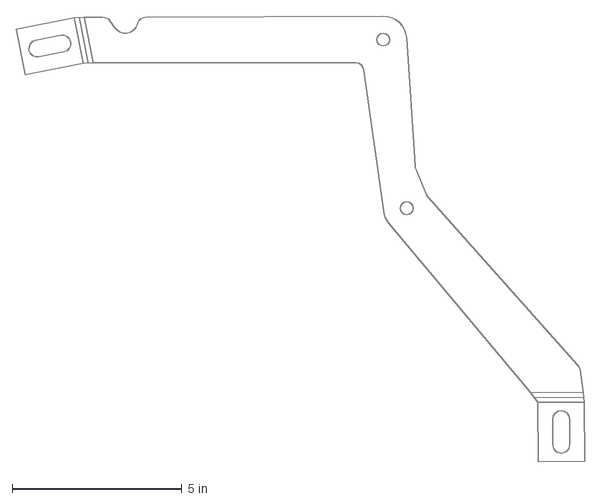
[picture p264: CAD file, 2025-05-10]
blog/2023-3-15-air-cond-install/LHS-bracket.dxf
16.7 x 13.1 in
