natecostello/van_two_point_oh/blog/2023-4-9-air-compressor-mounting/air-compressor-mount.dxf

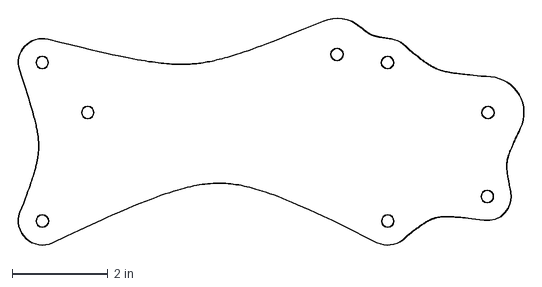
[picture p265: CAD file, 2025-05-10]
blog/2023-4-9-air-compressor-mounting/air-compressor-mount.dxf
10.6 x 4.82 in
