natecostello/van_two_point_oh/van/electrical/battery/battery-output-busbar.dxf

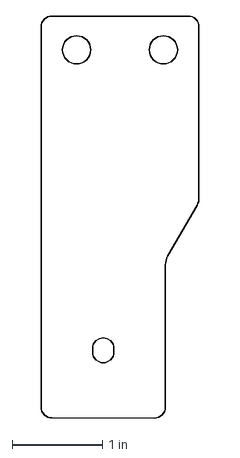
[picture p266: CAD file, 2025-05-10]
van/electrical/battery/battery-output-busbar.dxf
1.75 x 4.45 in
