natecostello/van_two_point_oh/van/electrical/knock-off-panels/usb-double.dxf

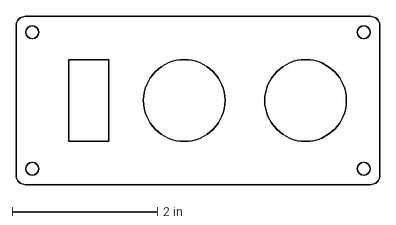
[picture p267: CAD file, 2025-05-10]
van/electrical/knock-off-panels/usb-double.dxf
5.00 x 2.31 in
