natecostello/van_two_point_oh/van/functional/tables/b-pillar-mount-order-drawing.dxf

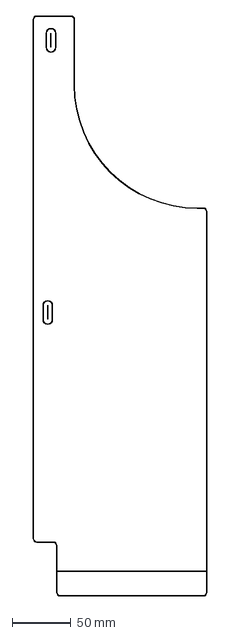
[picture p268: CAD file, 2025-05-10]
van/functional/tables/b-pillar-mount-order-drawing.dxf
148.0 x 495.0 mm
