natecostello/van_two_point_oh/van/structural/ceiling-panel-mounting/ceiling-bracket.dxf

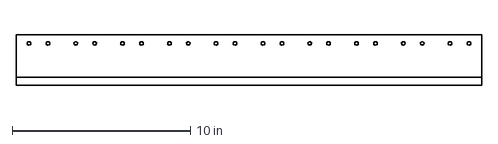
[picture p269: CAD file, 2025-05-10]
van/structural/ceiling-panel-mounting/ceiling-bracket.dxf
26.1 x 2.81 in
