natecostello/van_two_point_oh/van/structural/propane-mount/propane-mount.dxf

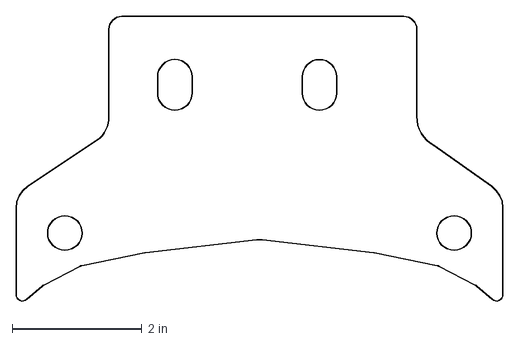
[picture p270: CAD file, 2025-05-10]
van/structural/propane-mount/propane-mount.dxf
7.50 x 4.39 in
