natecostello/van_two_point_oh/van/structural/reading-light-mount/reading-light-mount.dxf

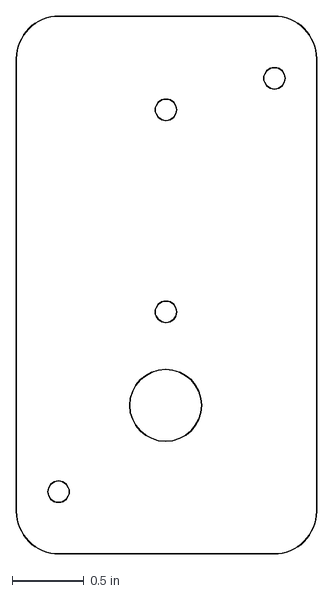
[picture p271: CAD file, 2025-05-10]
van/structural/reading-light-mount/reading-light-mount.dxf
2.09 x 3.74 in
