natecostello/van_two_point_oh/van/structural/wall-panel-reinforcement/bracket-order.dxf

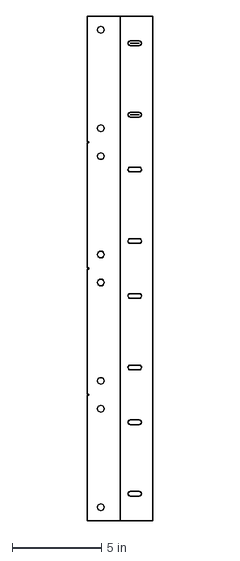
[picture p272: CAD file, 2025-05-10]
van/structural/wall-panel-reinforcement/bracket-order.dxf
3.64 x 28.2 in
