natecostello/van_two_point_oh/blog/2021-12-13-smartplug-mount/smartplug-plate-order.dxf

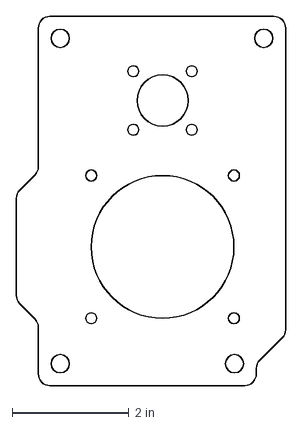
[picture p273: CAD file, 2025-05-10]
blog/2021-12-13-smartplug-mount/smartplug-plate-order.dxf
4.61 x 6.31 in
