natecostello/van_two_point_oh/blog/2022-8-27-bike-rack/Bike Spacer v6.step

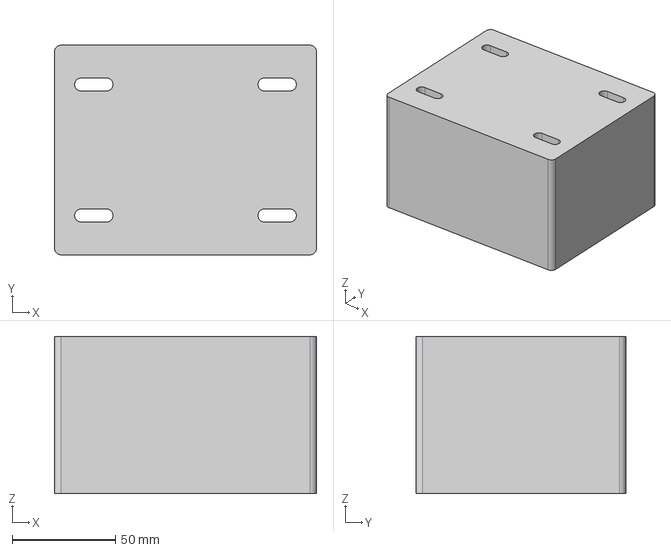
[picture p274: CAD file, 2025-05-10]
blog/2022-8-27-bike-rack/Bike Spacer v6.step
127.0 x 101.6 x 76.2 mm
