natecostello/van_two_point_oh/blog/2023-2-18-aux-solar/lhs-bracket.dxf

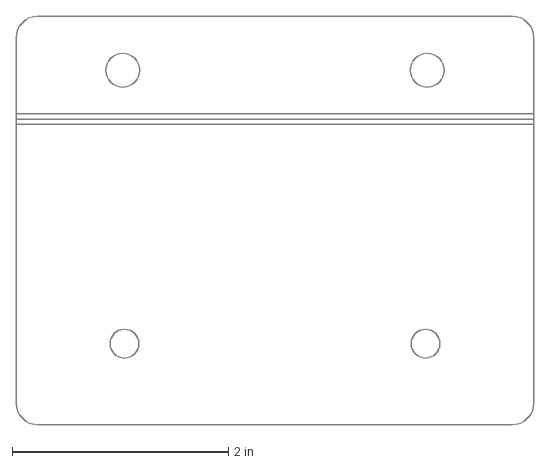
[picture p275: CAD file, 2025-05-10]
blog/2023-2-18-aux-solar/lhs-bracket.dxf
4.78 x 3.78 in
