natecostello/van_two_point_oh/blog/2023-3-15-air-cond-install/condenser-bracket-modified.dxf

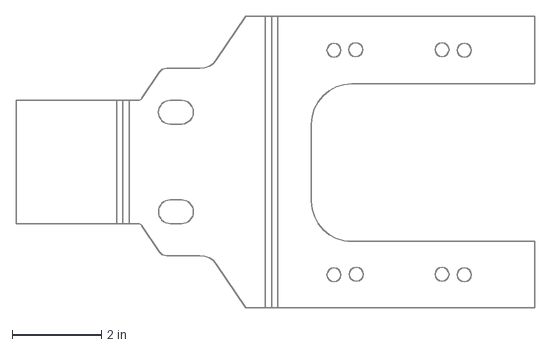
[picture p276: CAD file, 2025-05-10]
blog/2023-3-15-air-cond-install/condenser-bracket-modified.dxf
11.6 x 6.52 in
