natecostello/van_two_point_oh/blog/2023-4-9-air-compressor-mounting/switch-air-connection-mount.dxf

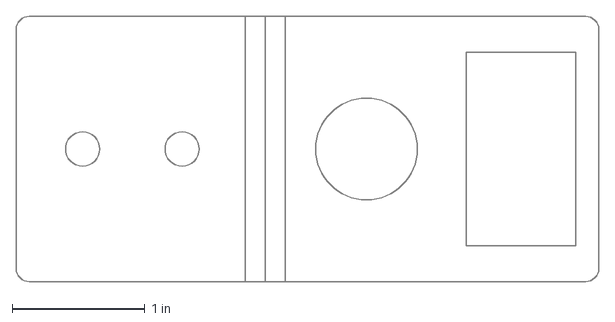
[picture p277: CAD file, 2025-05-10]
blog/2023-4-9-air-compressor-mounting/switch-air-connection-mount.dxf
4.39 x 2.00 in
