natecostello/van_two_point_oh/van/electrical/battery/sideplates_bends_r1.dxf

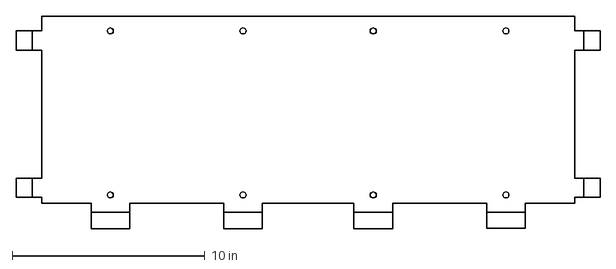
[picture p278: CAD file, 2025-05-10]
van/electrical/battery/sideplates_bends_r1.dxf
30.3 x 11.0 in
