natecostello/van_two_point_oh/van/electrical/knock-off-panels/contura-double.dxf

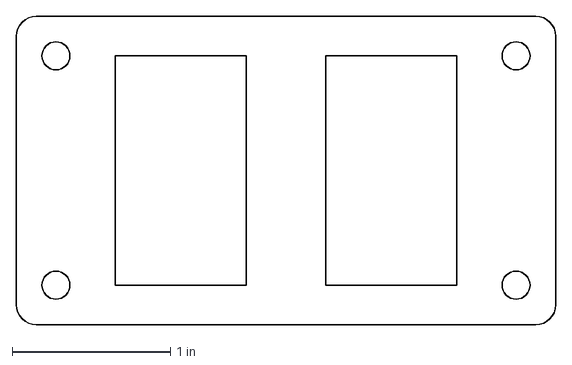
[picture p279: CAD file, 2025-05-10]
van/electrical/knock-off-panels/contura-double.dxf
3.41 x 1.95 in
