natecostello/van_two_point_oh/van/structural/wall-panel-reinforcement/wall-panel-8020-bracket-order.dxf

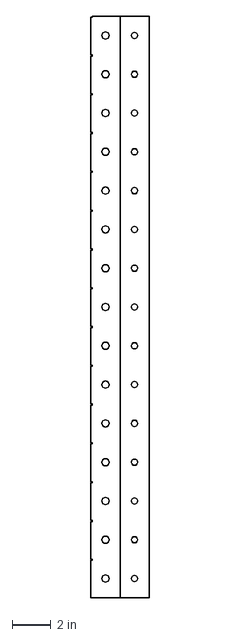
[picture p280: CAD file, 2025-05-10]
van/structural/wall-panel-reinforcement/wall-panel-8020-bracket-order.dxf
2.99 x 30.0 in
