natecostello/van_two_point_oh/blog/2022-8-27-bike-rack/window-guard.dxf

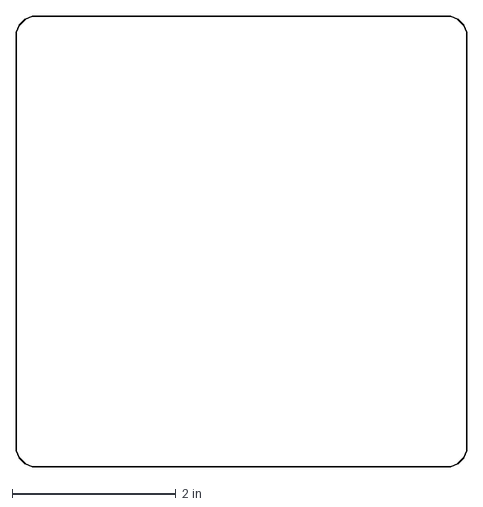
[picture p281: CAD file, 2025-05-10]
blog/2022-8-27-bike-rack/window-guard.dxf
5.50 x 5.50 in
