natecostello/van_two_point_oh/blog/2023-2-18-aux-solar/rhs-bracket.dxf

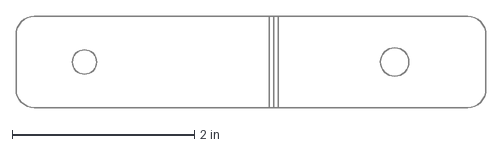
[picture p282: CAD file, 2025-05-10]
blog/2023-2-18-aux-solar/rhs-bracket.dxf
5.15 x 1.00 in
