natecostello/van_two_point_oh/blog/2023-3-15-air-cond-install/condenser-bracket.dxf

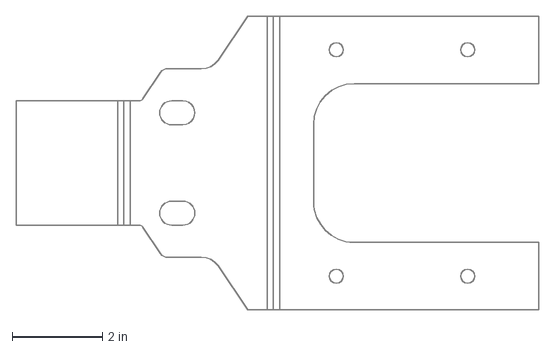
[picture p283: CAD file, 2025-05-10]
blog/2023-3-15-air-cond-install/condenser-bracket.dxf
11.6 x 6.52 in
