natecostello/van_two_point_oh/van/electrical/battery/battery-90-busbar-extents-removed.dxf

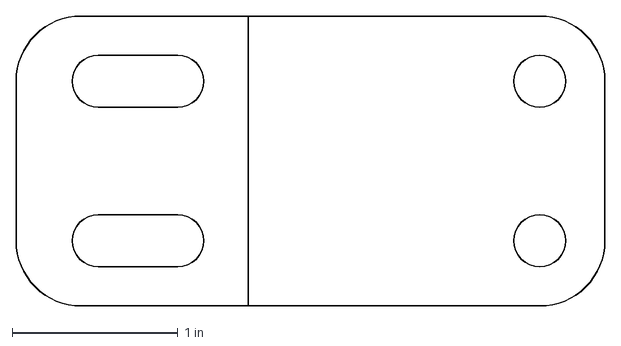
[picture p284: CAD file, 2025-05-10]
van/electrical/battery/battery-90-busbar-extents-removed.dxf
3.55 x 1.75 in
