natecostello/van_two_point_oh/blog/2023-3-15-air-cond-install/duct.step

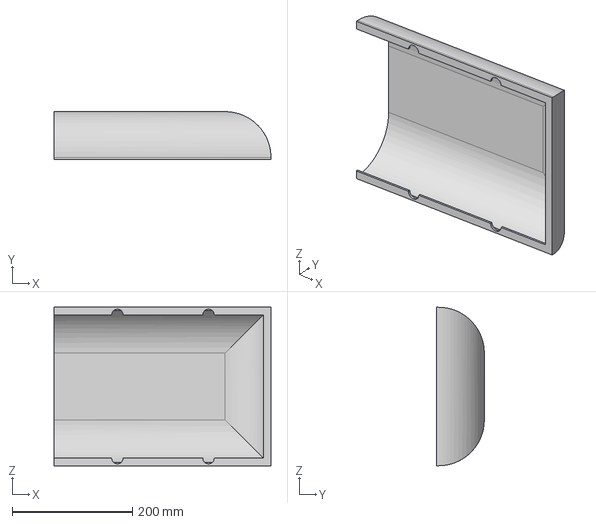
[picture p285: CAD file, 2025-05-10]
blog/2023-3-15-air-cond-install/duct.step
360.8 x 79.4 x 263.5 mm
