natecostello/van_two_point_oh/van/electrical/battery/battery-90-busbar.dxf

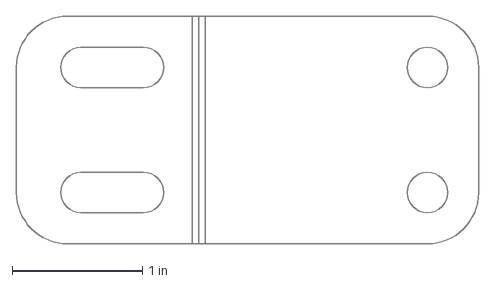
[picture p286: CAD file, 2025-05-10]
van/electrical/battery/battery-90-busbar.dxf
3.55 x 1.75 in
