natecostello/van_two_point_oh/van/electrical/battery/battery-neg-jumper-busbar.dxf

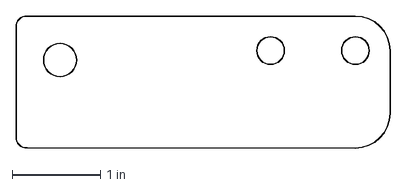
[picture p287: CAD file, 2025-05-10]
van/electrical/battery/battery-neg-jumper-busbar.dxf
4.25 x 1.50 in
