natecostello/van_two_point_oh/van/electrical/battery/aluminum_thermal_diffuser.dxf

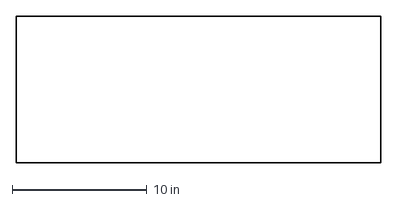
[picture p288: CAD file, 2025-05-10]
van/electrical/battery/aluminum_thermal_diffuser.dxf
27.0 x 10.9 in
