natecostello/van_two_point_oh/(list of files, cad)

Other CAD files:
van/reference/vehicle_dimensions/ford_drawings.dwg
blog/2021-6-26-battery-interconnect-design/parallel-interconnect.skp
blog/2021-7-24-battery-interconnect-fab/bend-tooling-imperial.skp
blog/2021-7-5-battery-interconnect-redesign/parallel-interconnect-v2.skp
blog/2022-11-3-starlink/starlink-mount.skp
blog/2023-3-15-air-cond-install/prop bracket.f3d
van/architectural/Transit_Dimensions_measured.skp
van/architectural/Transit_Layout_1.0.skp
van/architectural/Transit_Layout_3D_1.0.skp
van/architectural/Transit_Layout_3D_2.0.skp
van/architectural/Transit_Roof_Layout.skp
van/architectural/battery_configuration.skp
van/architectural/battery_sideplate_dimensioned.skp
van/architectural/electrical-arrangement.skp
van/architectural/internal-arrangement/driver-galley-study.skp
van/architectural/structure-final.skp
van/architectural/transit_layout_van_3_concept-EW Bed.skp
van/architectural/transit_layout_van_3_concept.skp
van/functional/cooking/greystone.skp
van/functional/fire-pit/fire-pit.skp
van/functional/lighting/switch-template.skp
van/scratch/Battery Box.skp
van/scratch/Battery.skp
van/scratch/BoothDesign.skp
van/structural/1_4-20+Build-A-Bolt.skp
van/structural/8020-panel-mount/panel-mount.skp
van/structural/bed-surface/bed-surface.skp
van/structural/ceiling_ltrack_mount/ceiling_ltrack_mount_design.skp
van/structural/floor_8020_mount/floor_8020_mount.skp
van/structural/side_door_step/Transit_Side_door_step.skp
van/technical/workbench/workbench_layout.skp
