natecostello/van_two_point_oh/blog/2021-12-17-fridge-freezer-install/fridge-freezer.md

2021-12-16:
Soph started installing foam base for fridge and freezer

2021-12-17
Soph cut and painted (kilz primer) wood blocks
Moved fridge and freezer into van

2021-12-18
Took down 8020 structure, found an interference on 8020 above freezer, removed and will cut back about 1/8.
Moved f/f into place and got refrigerent lines sitting ok, no obvious kinks (fingers crossed).

2021-12-19
Electrically test both fridge and freezer, SAT

2021-12-28
VBH'd the freezer blocks in place
added a clearence to the foam
filled clearence with neoprene
decided to not do that to the refrigerator (will see if it squeaks - rocking it did not)

2021-12-29
Shimmed freezer
Reinstalled fridge/freezer 8020

2021-12-30
Soph insulated under fridge and freezer with thinsulate and added some neo for thermal break.

2022-1-05
Started fabricating brackets for fridge/freezer

2022-1-06
Fabricated fridge/freezer brackets
Installed two fridge freezer brackets

2022-1-8
Tweaked brackets
Installed remaining (but one) fridge freezer brackets

2022-1-10
Soph installed last fridge bracket
Locktited and torque all the others

2022-1-13
Soph secured compressors (VHB)
Soph insulated fridge and freezer (just a little left)
