natecostello/van_two_point_oh/blog/2021-12-29-oven-install/oven-install.md

12-29-2021
Fitup/loose install of oven

1-10-2022
Fabricated oven brackets
Installed (and loctited) oven brackets

1-24-2022
Hacked stove switch
