natecostello/van_two_point_oh/blog/2021-6-16-battery-dry-fit/battery-assembly-dry-fit.md

---
type: post
section: blog
categories: 
 # one or more categories is permitted
 - electrical
navTitle: 
title: Battery Assembly Dry-fit
author: Nate
date: 2021-06-16
tags:
 - build
 - electrical
 - battery
 
metatags:
	# no metatags
cover: 
	# image file
 img: cover-battery.jpeg
	# if attribution is needed
	# source: [vecteezy]
	# url: url
tldr: 'We assembled our LFP cells and other components to ensure everything fit up properly.  We verified our battery design was physically sound.'
---
**TLDR: We assembled our LFP cells and other components to ensure everything fit up properly.  We verified our battery design was physically sound.**

We are doing a trial of the battery assembly to make sure we can get good final dimensions (primarily for cell interconnections) and verify the physical design works.

Step 1:  Cover the metal portions of the structure with kapton tape.

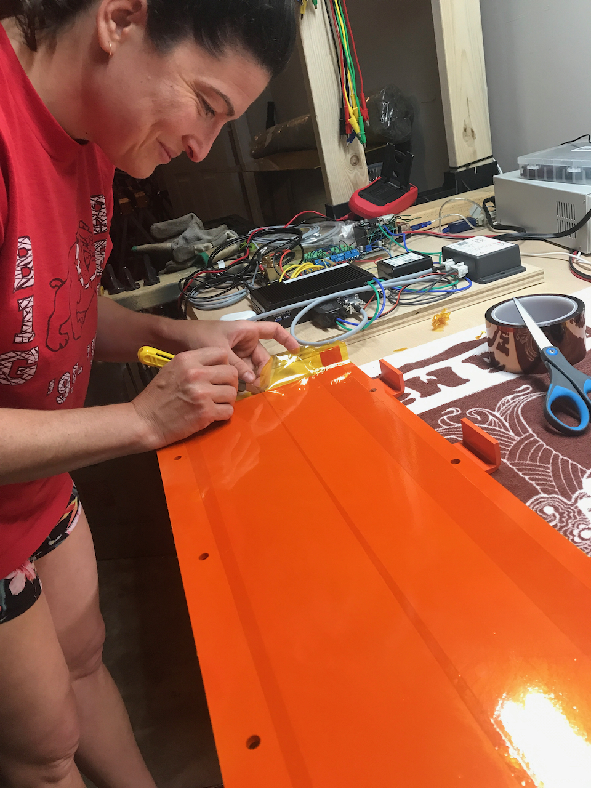
[picture p306: blog/2021-6-16-battery-dry-fit/kapton-sides.jpeg]


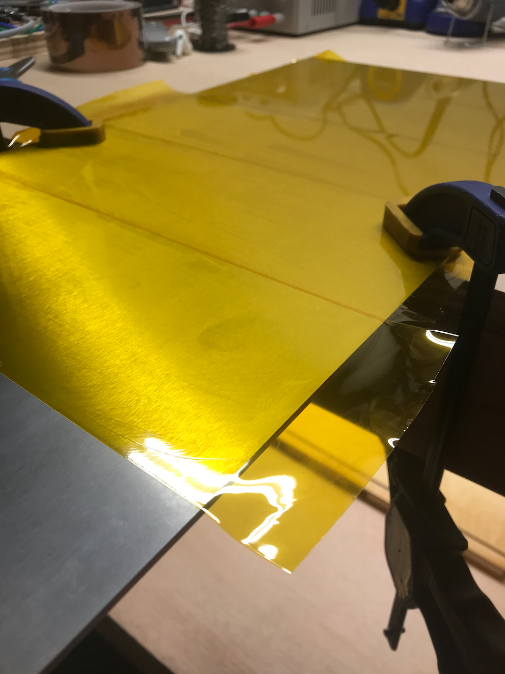
[picture p307: blog/2021-6-16-battery-dry-fit/kapton-bottom.jpeg]


Step 2:  Pair the cells by thier internal resistance provided by the supplier.  Per X on the diysolarpower forum, we should use the "Ri1" values to do this.  We sorted the data and grouped them accordingly.

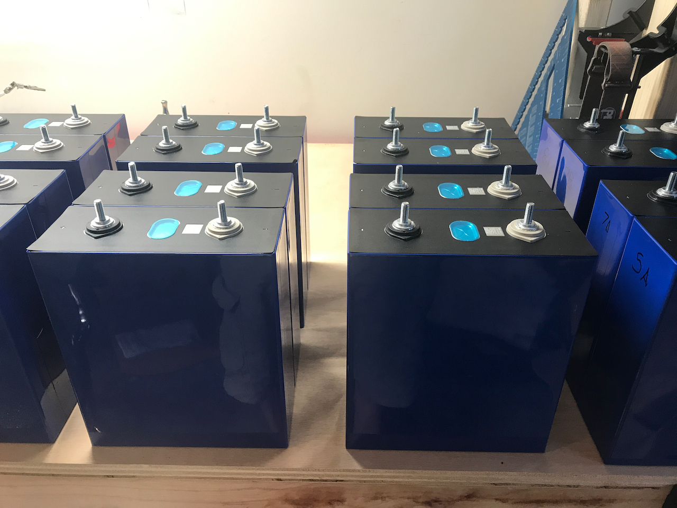
[picture p308: blog/2021-6-16-battery-dry-fit/paired-cells.jpeg]


Step 3: Cover the outer sides of the paired cells with kapton tape.

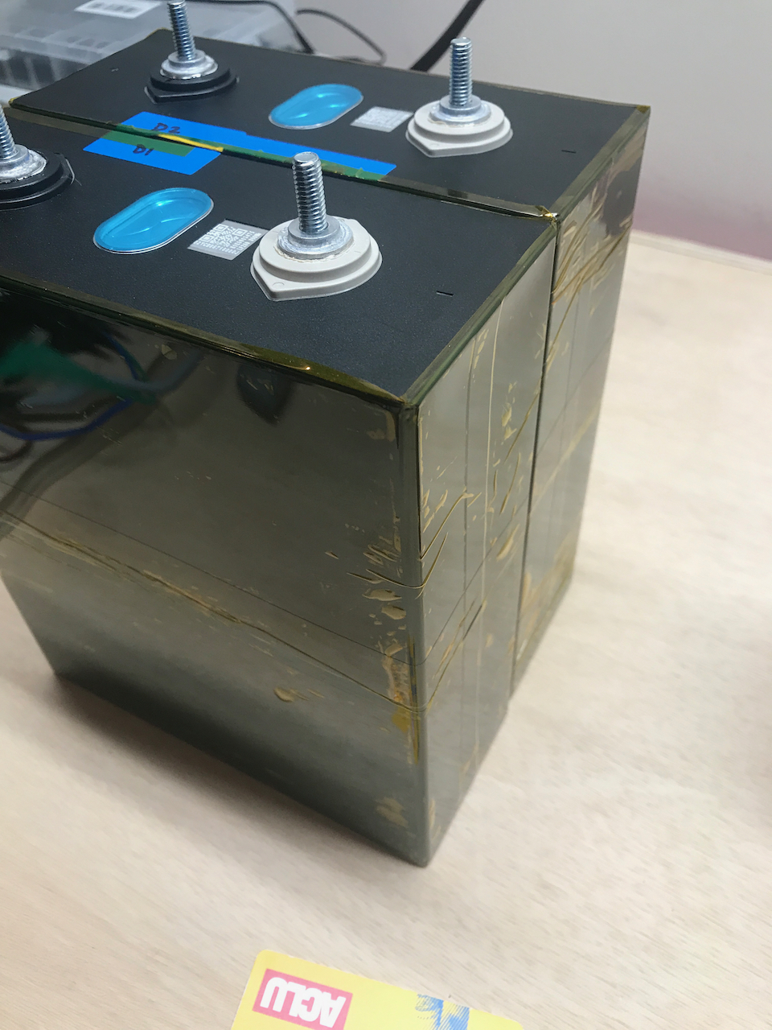
[picture p309: blog/2021-6-16-battery-dry-fit/kapton-cells.jpeg]


Step 4: Rack 'em

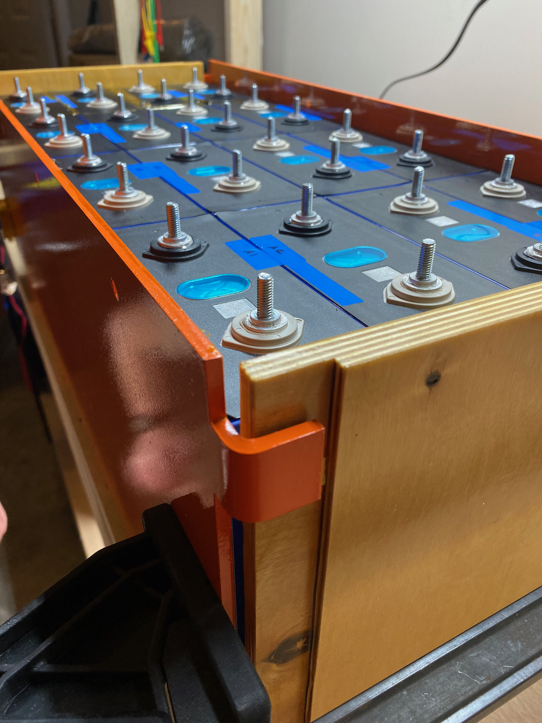
[picture p310: blog/2021-6-16-battery-dry-fit/full-battery.jpeg]


Step 5: Measure battery width

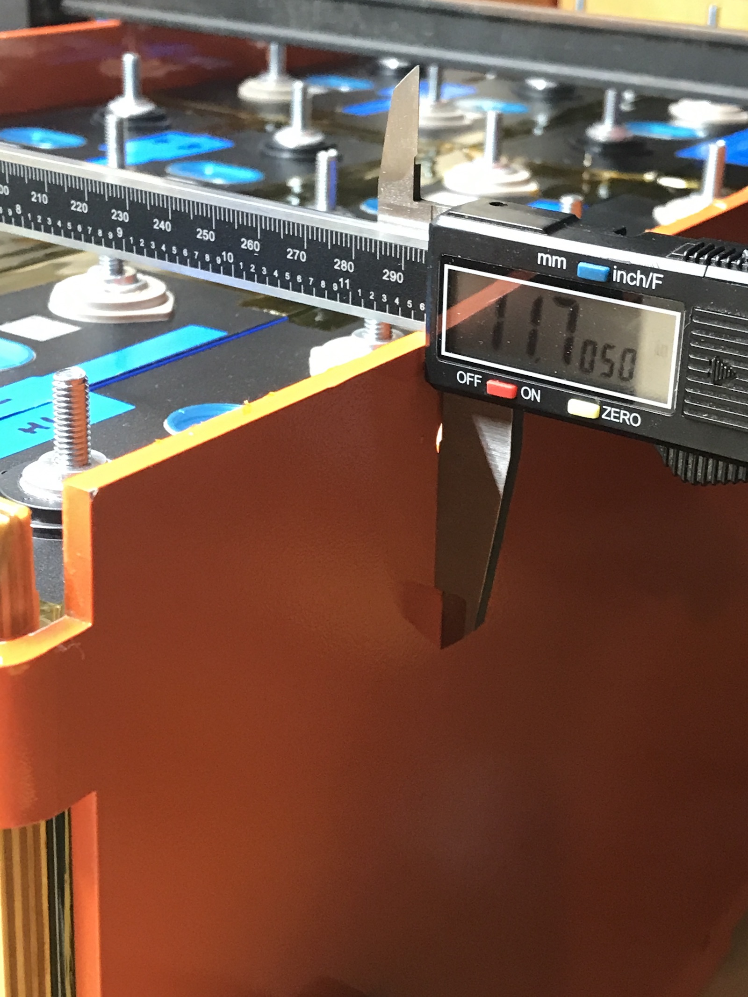
[picture p311: blog/2021-6-16-battery-dry-fit/measure.jpg]


Step 6: Cut the threaded rod

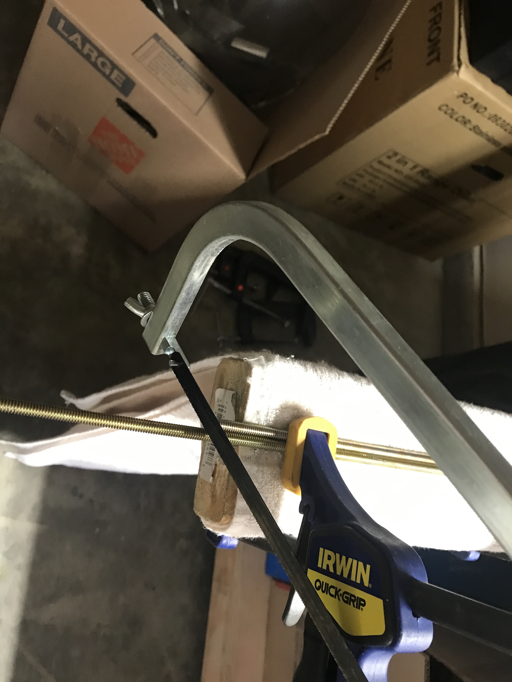
[picture p312: blog/2021-6-16-battery-dry-fit/cutrod.jpg]


Step 7: Loc-tite nuts on one end

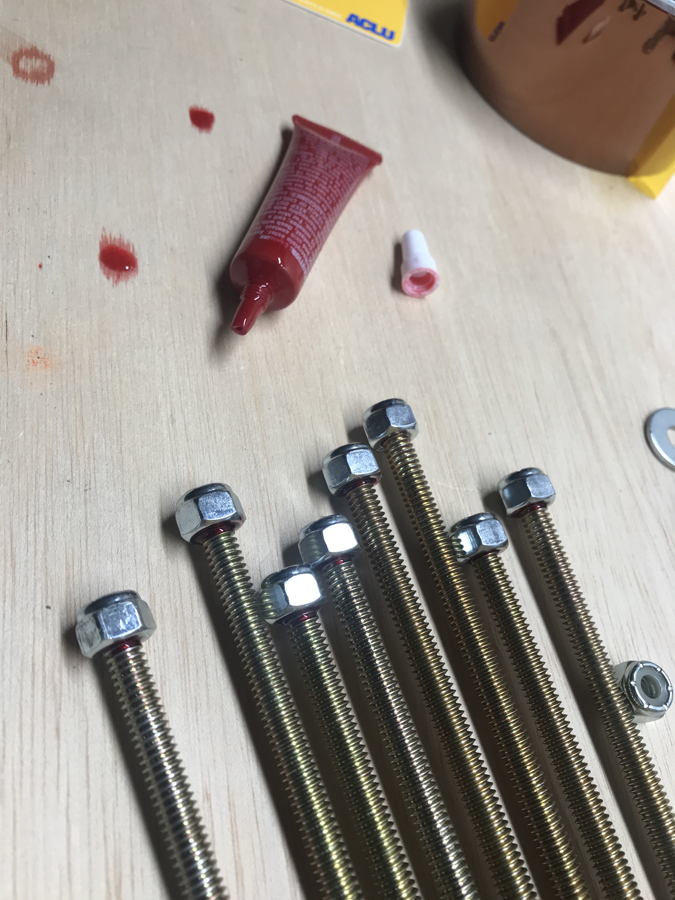
[picture p313: blog/2021-6-16-battery-dry-fit/loctite.jpg]


Step 8: Heat shrink

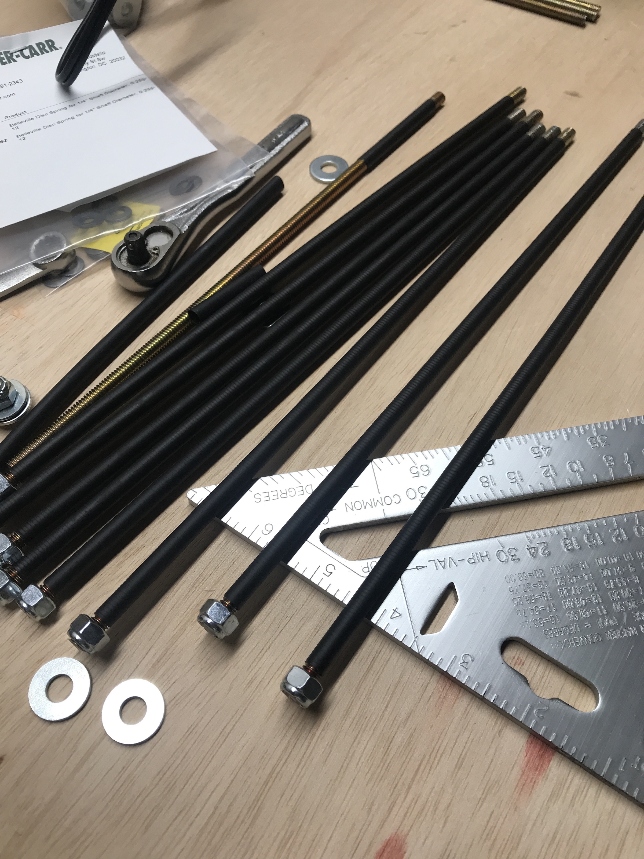
[picture p314: blog/2021-6-16-battery-dry-fit/heatshrink.jpg]


Step 9: Install and snug

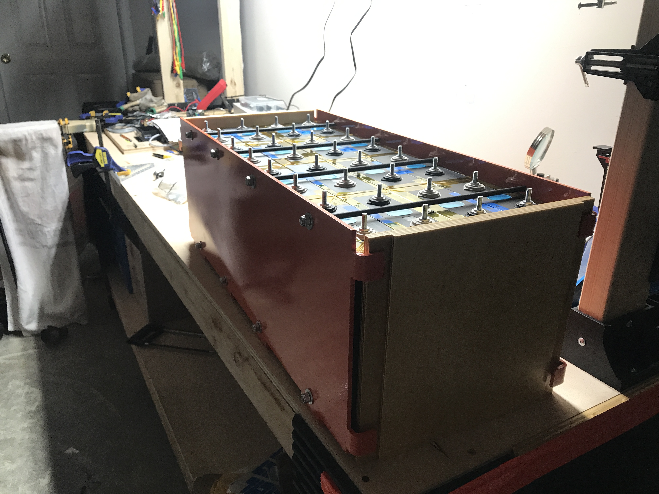
[picture p315: blog/2021-6-16-battery-dry-fit/install.jpg]


## Findings
Our initial plan was to tighten the all-thread nuts to fully compress belleville washers in order to set a known compressive force on the batteries in the low SOC (and un-swollen) state.  We settled on [these](https://www.mcmaster.com/9712K62/) from McMaster which would provide 115lbf or 4.2 psi when compressed flat.  From the dry fit, it is clear that the displacement associated with the belleville washers is too small to allow for this approach (even when doubled up in series).  So we are going to pivot to using springs, compressed solid, to set the initial compression for the low SOC state.  Our first candidate is the [LHL 625B 01](https://www.leespring.com/compression-springs-hefty?search=LHL625B01) from Lee Spring which will provide 105 lbf or 3.8 psi when compressed solid.
