natecostello/van_two_point_oh/van/electrical/BMS_wiring_logic/ws500-quick-start-guide-09-30-2022-V3.pdf

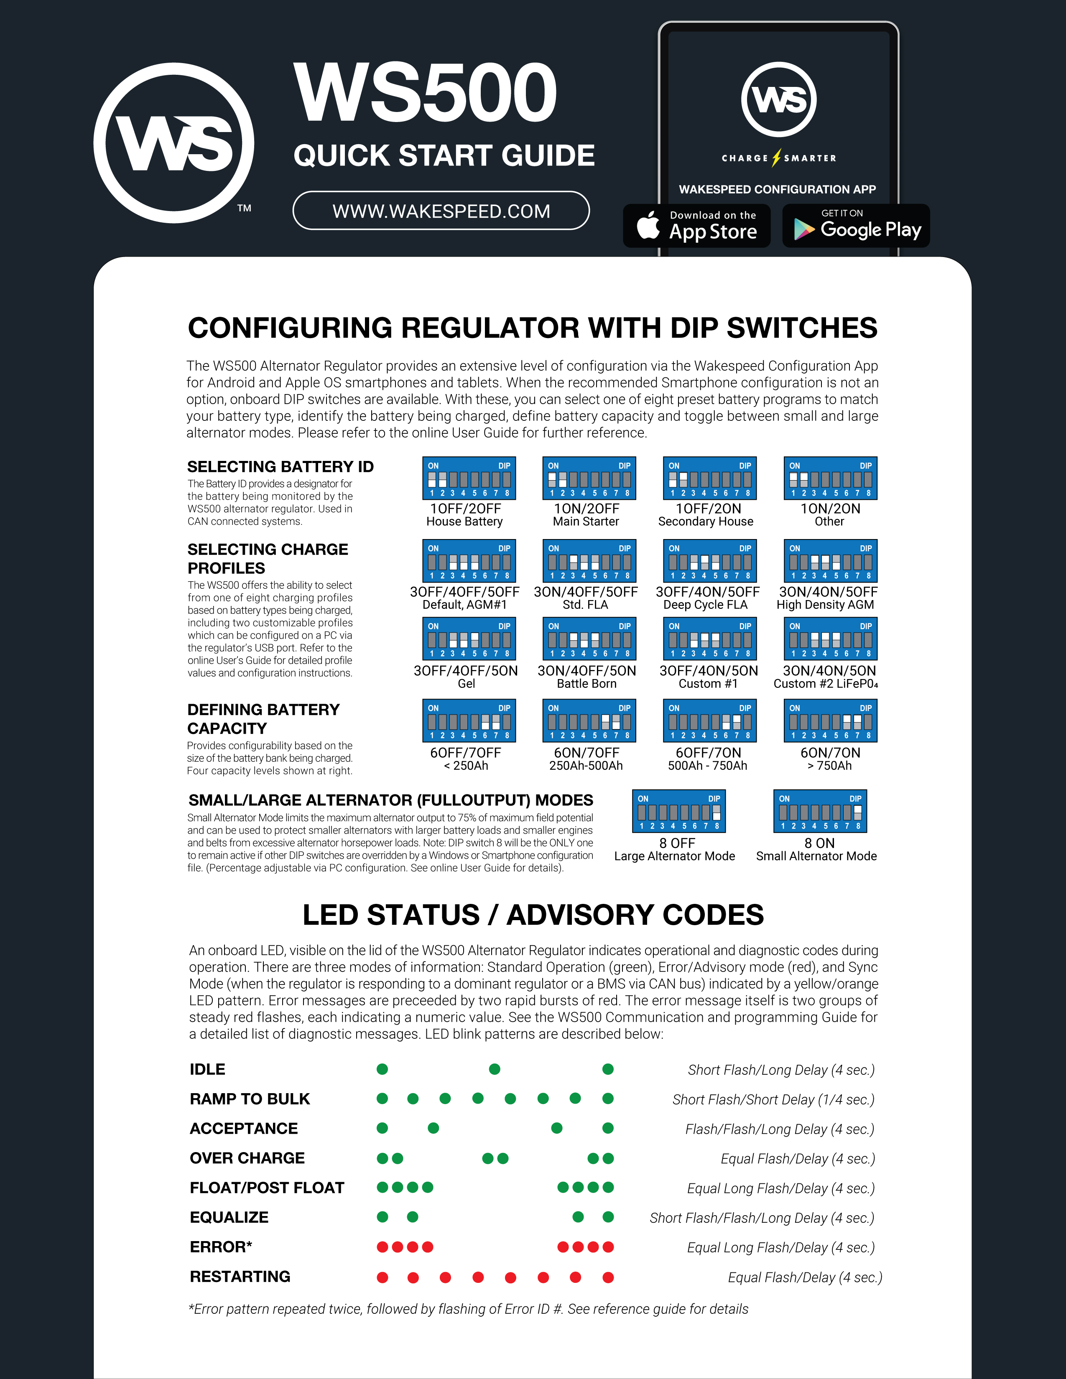
[picture p330: page 1]
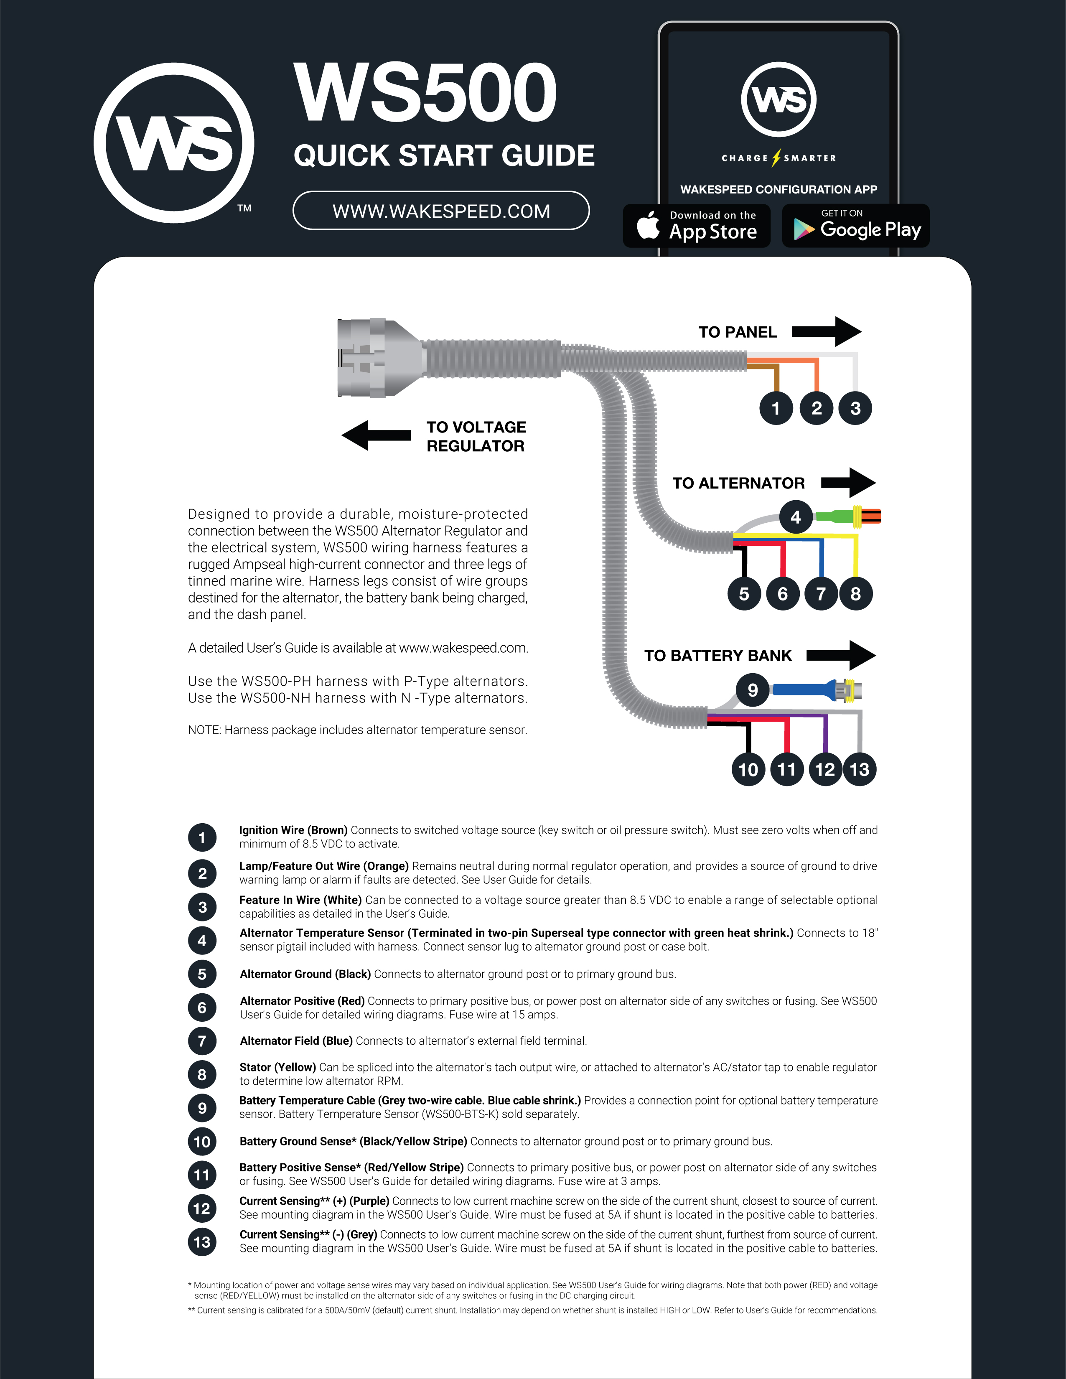
[picture p331: page 2]
