natecostello/van_two_point_oh/van/reference/vehicle_dimensions/manual_measurements/notes.pdf

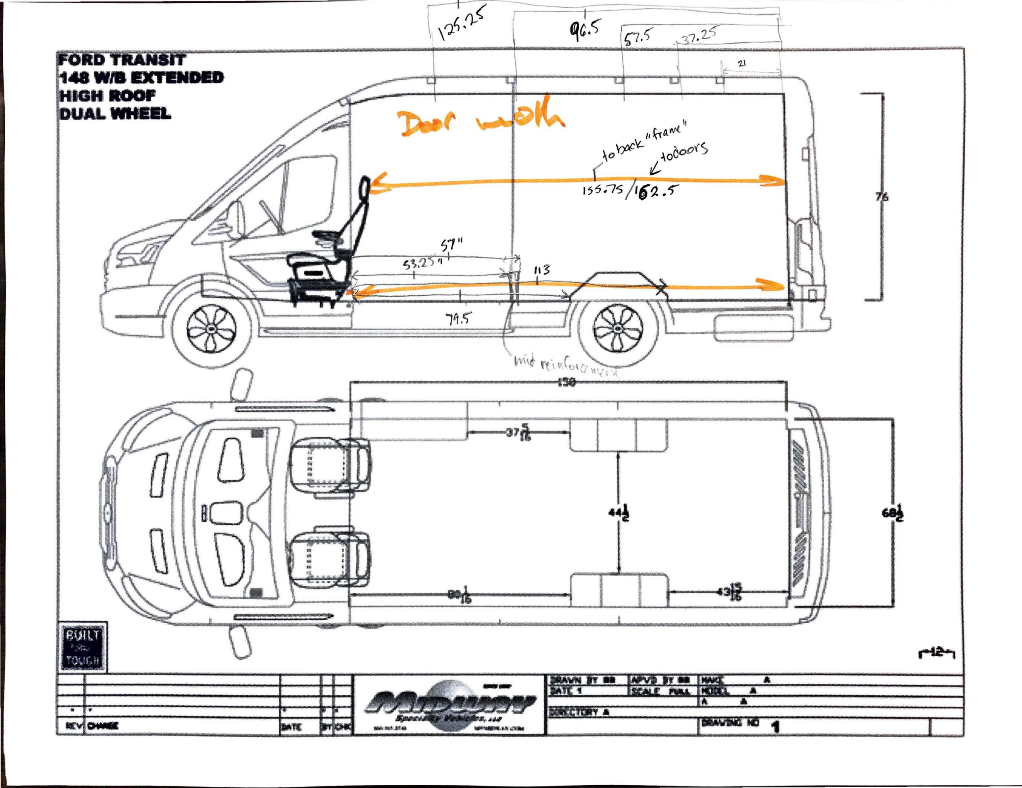
[picture p332: page 1]

# ~---' iif

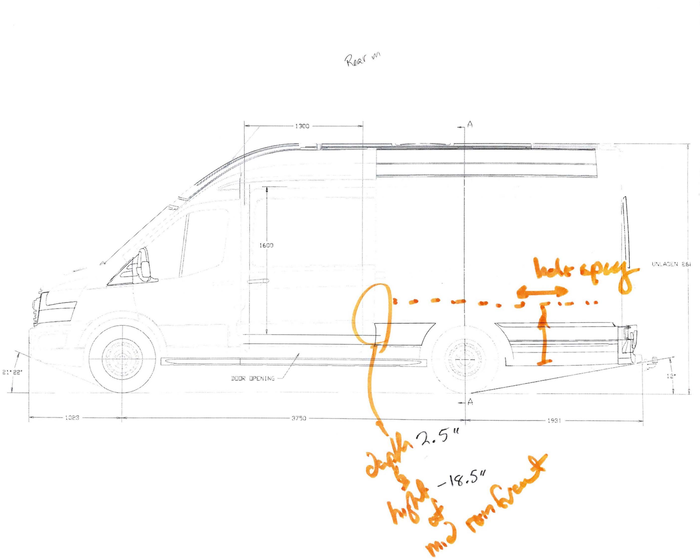
[picture p333: page 2]

,o
w

n;

,,,<, .- '. , .,:

,. , I •'

## .- ____ j I , ----

~ ·!

# --- + _ _J

J>

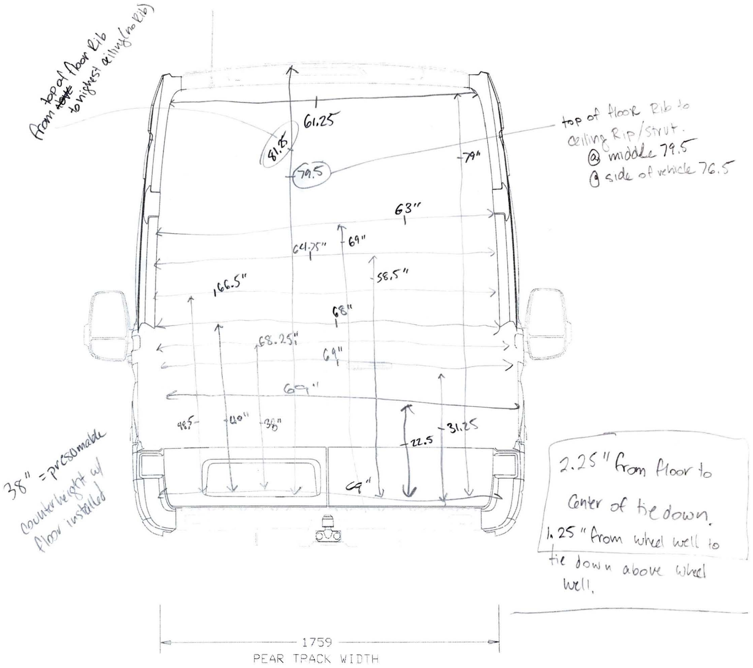
[picture p334: page 3]

-o

fTl
p

;;o

·-I

A

-o

,-- .I> ,J

C) (jJ
T ...0 C J - I

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
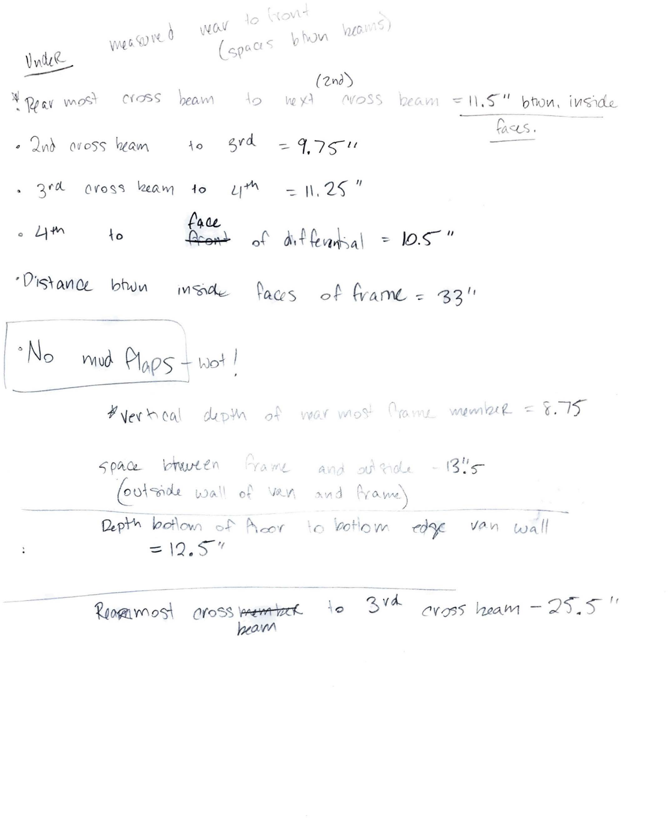
[picture p335: page 4]

~ | (-z_vi J')
~ V-f_ t 'I lf'.A oc,, \. | C < rf'5 c; | ~"' y~ | f1('0SS bau~I -=- 1, .~ '' bnv111, ll/1 'is1lt.Q., -·--- ft\q__,S ,
0 | l-j f\'\ | {o

### f~OL

-Wo~1 | of 0:, ~ ~ Vl~tt\ -=- ID.~ II
- D·1s\ £XV1 OL bhvl/\ | ,vi~C4:., | ~llCeS | o t wa.mt., -:;: ~3 ,,
,S-pO\,CL | ~f_l\ | ( •. IL | I
'J | r,_, | ei,
:) . ~

(:: __ l) ~ ""in~ C•.J <,\. ¹
I | O ~' | t,'-... f
- | -·- (1,?~ loor\cvn n S' ~ ce·r | Wt\. II

:::; \? • s-,,

~ ()~VV\os-\ | Cfo$~ 'fAt,v~ 1v;d.. | \ o 3 vd.. (1'{'75') l,u"'-wi - :)~)
11
| b(a,vv'\
