natecostello/van_two_point_oh/blog/2021-11-2-8020-install/cover.jpeg

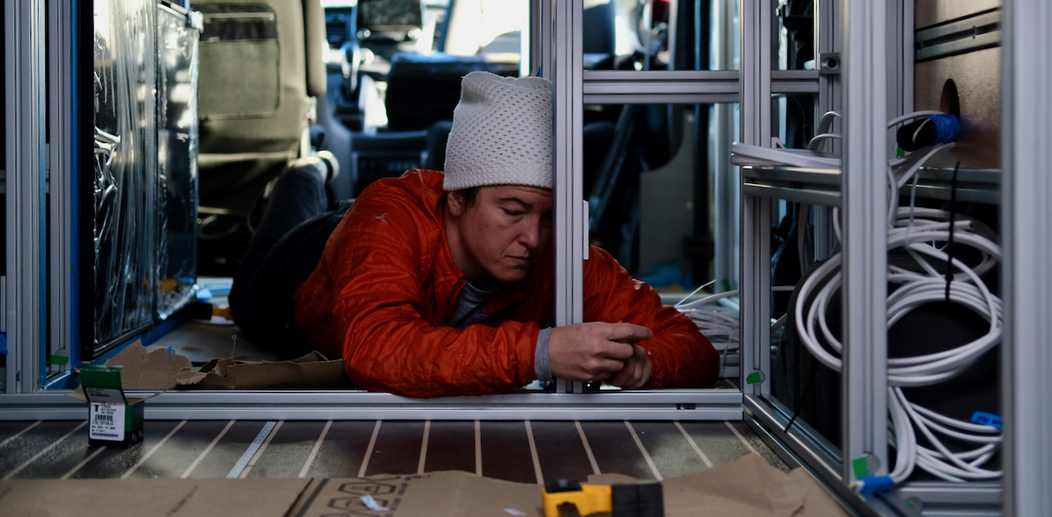
blog/2021-11-2-8020-install/cover.jpeg
