natecostello/van_two_point_oh/blog/2021-11-2-8020-install/cutting-jig.jpeg

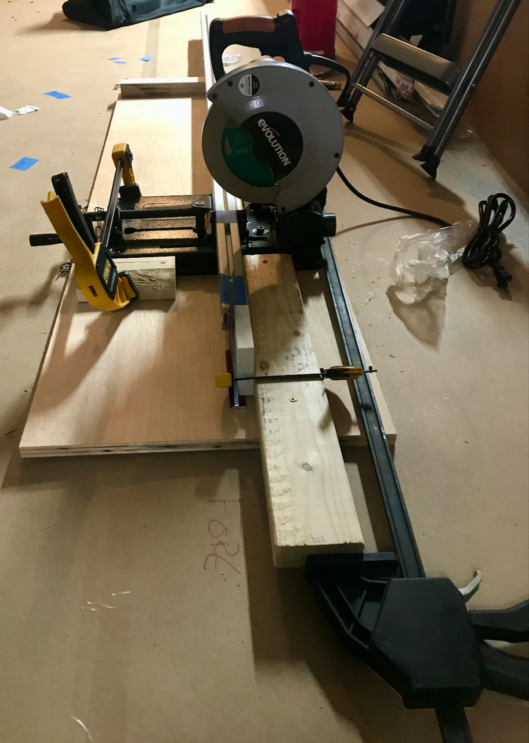
blog/2021-11-2-8020-install/cutting-jig.jpeg
