natecostello/van_two_point_oh/blog/2021-12-17-fridge-freezer-install/DSCF4894.jpeg

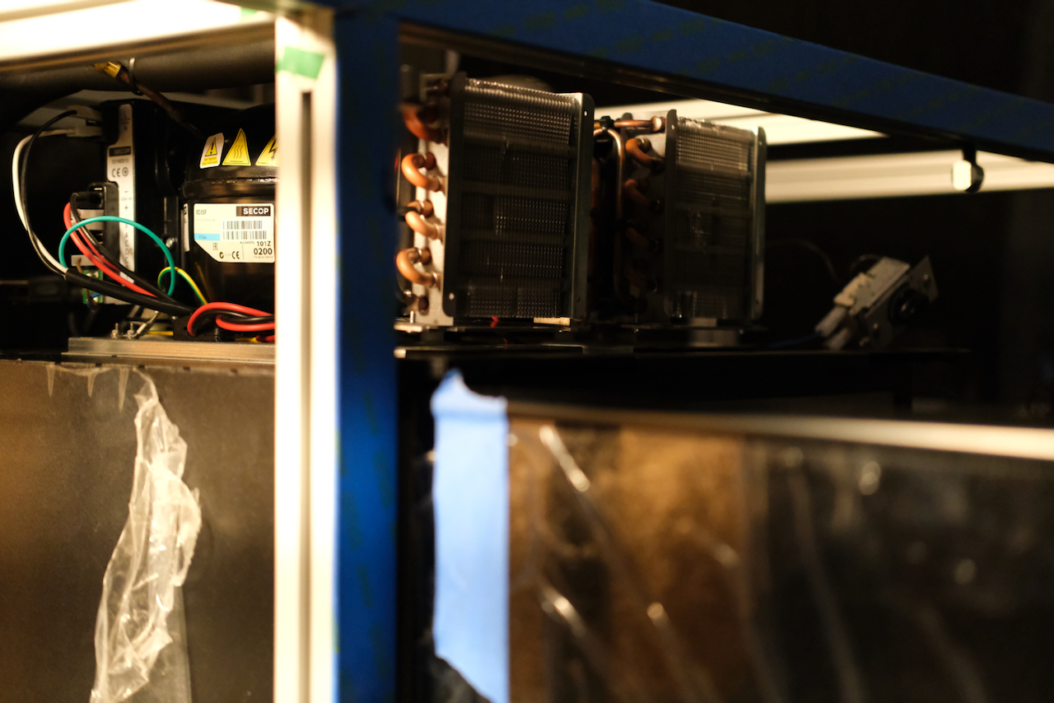
blog/2021-12-17-fridge-freezer-install/DSCF4894.jpeg
