natecostello/van_two_point_oh/blog/2021-12-17-fridge-freezer-install/IMG_8350.jpeg

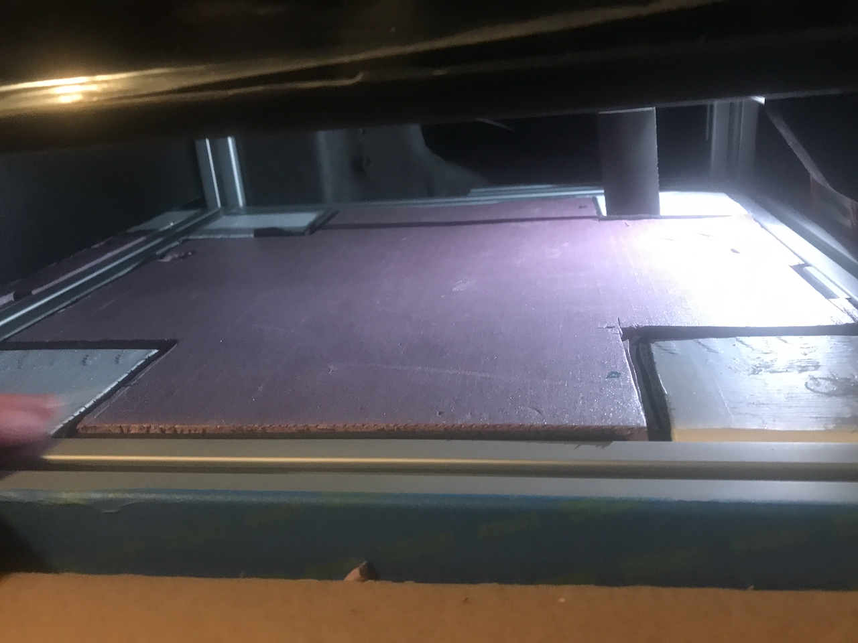
blog/2021-12-17-fridge-freezer-install/IMG_8350.jpeg
