natecostello/van_two_point_oh/blog/2021-12-31-wall-panels/stiffener-installed.jpeg

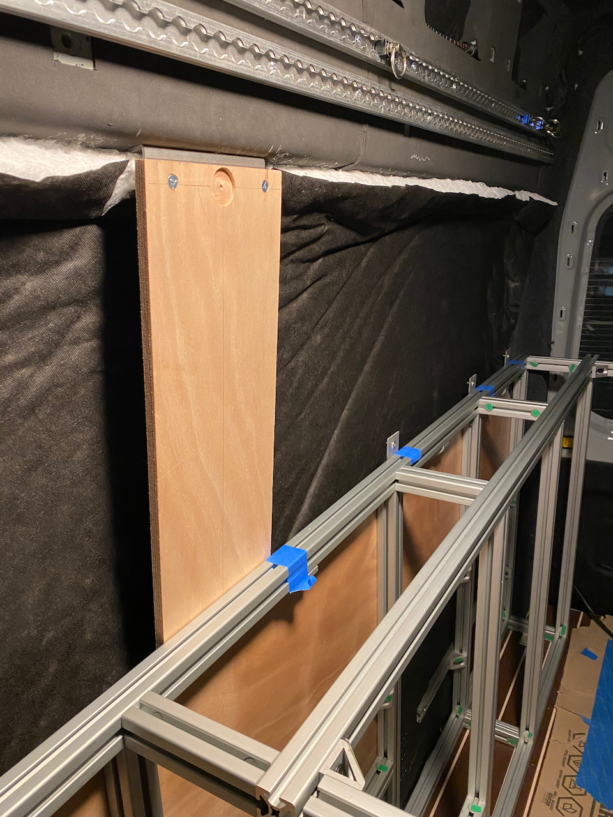
blog/2021-12-31-wall-panels/stiffener-installed.jpeg
