natecostello/van_two_point_oh/blog/2022-1-1-espar-install/vhb.jpeg

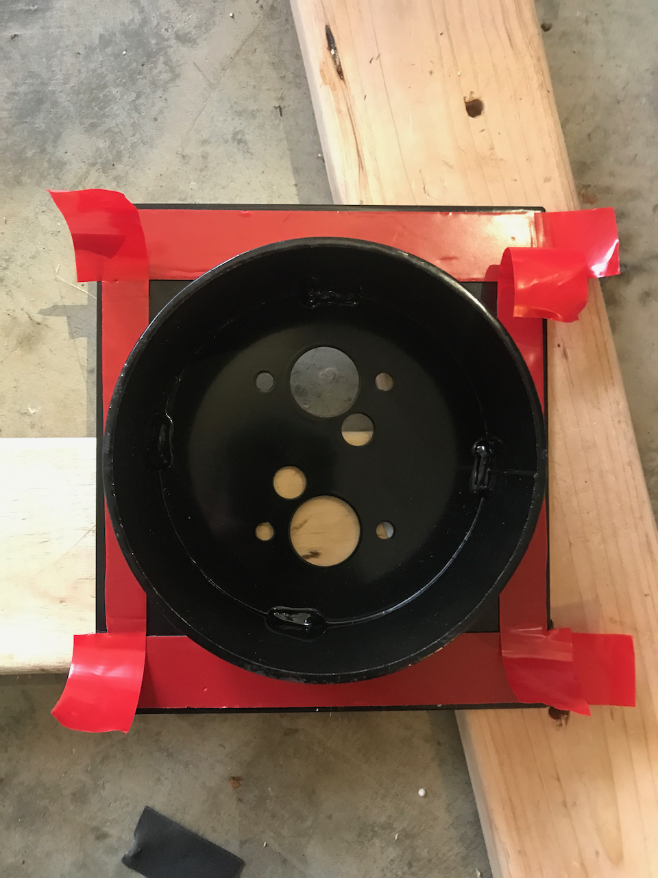
blog/2022-1-1-espar-install/vhb.jpeg
