natecostello/van_two_point_oh/blog/2022-1-1-espar-install/wiring-diagram-from-sprinter-source.jpeg

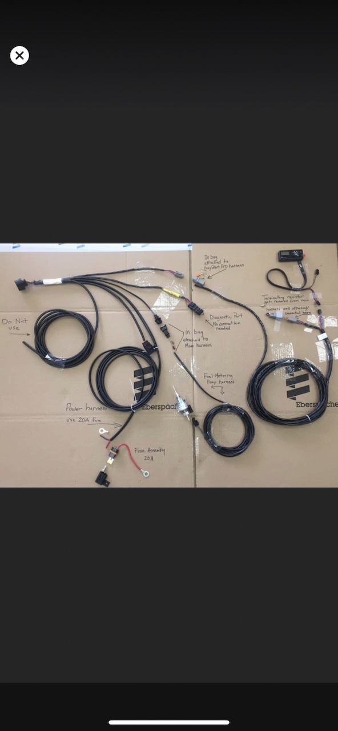
blog/2022-1-1-espar-install/wiring-diagram-from-sprinter-source.jpeg
