natecostello/van_two_point_oh/blog/2022-1-24-roof-rack-install/cover.jpeg

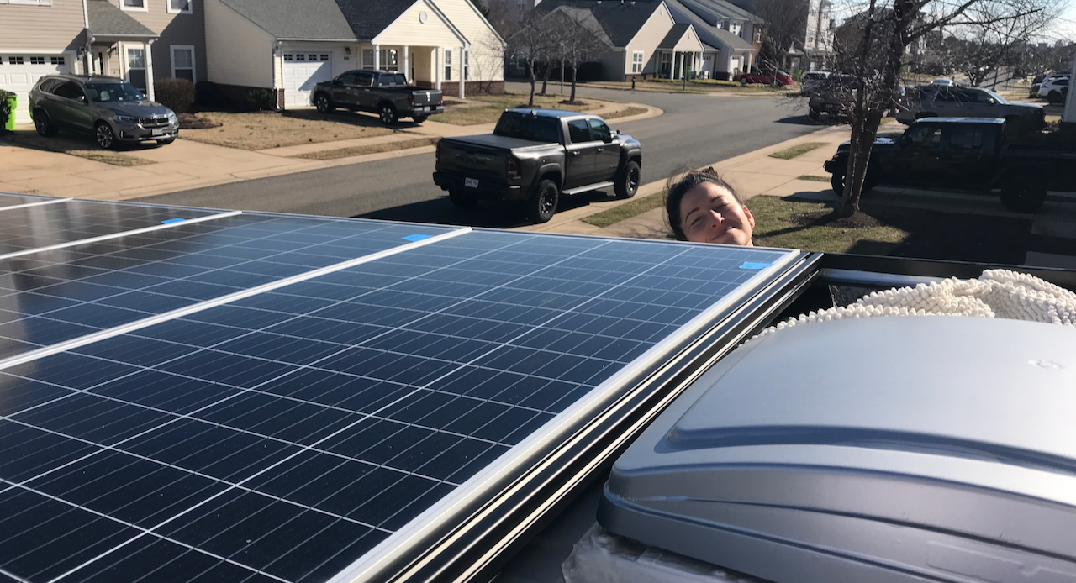
blog/2022-1-24-roof-rack-install/cover.jpeg
