natecostello/van_two_point_oh/blog/2022-2-9-battery-assembly-initial-charge/SDS00001.png

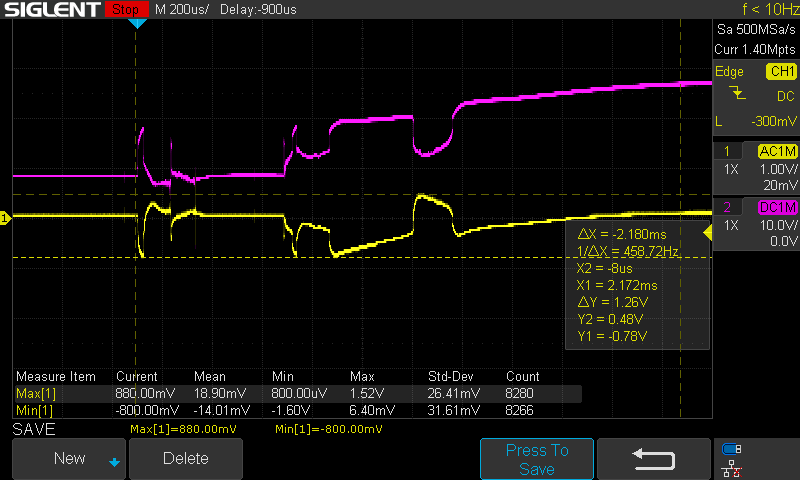
blog/2022-2-9-battery-assembly-initial-charge/SDS00001.png
