natecostello/van_two_point_oh/blog/2023-3-15-air-cond-install/angle-drill-locations-side-modified.png

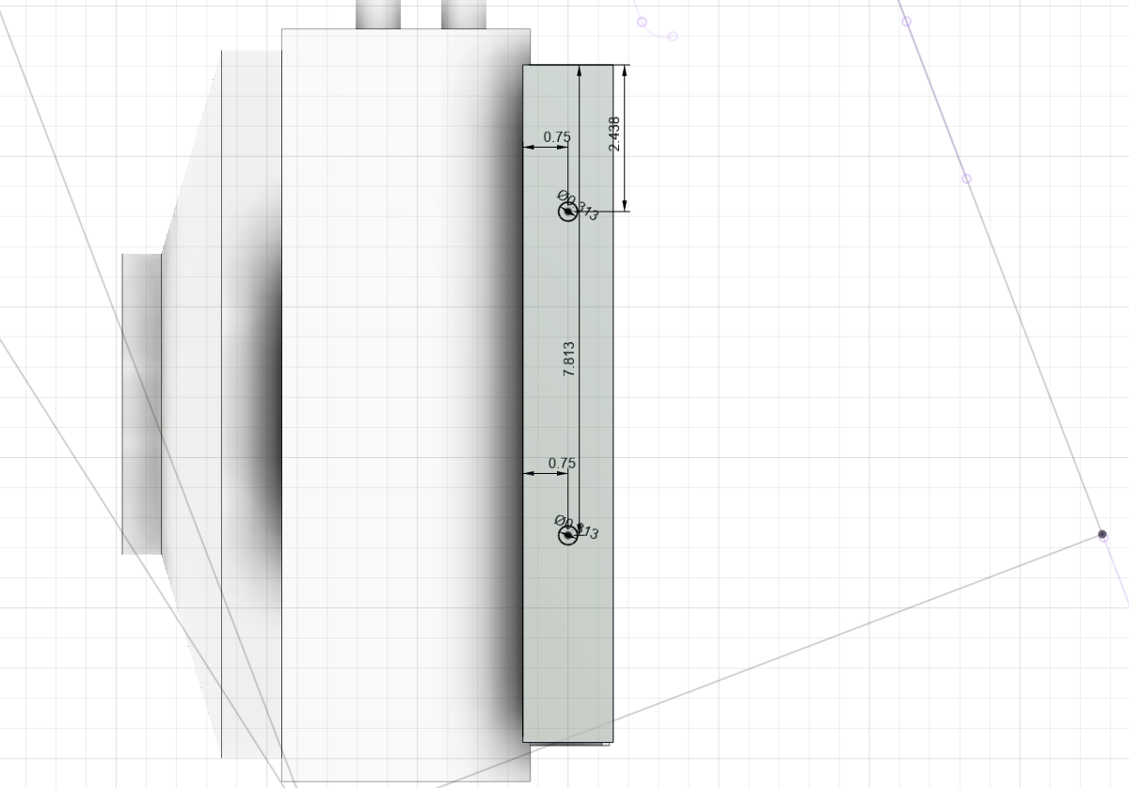
blog/2023-3-15-air-cond-install/angle-drill-locations-side-modified.png
