natecostello/van_two_point_oh/blog/2023-3-15-air-cond-install/floor-pass-through.jpeg

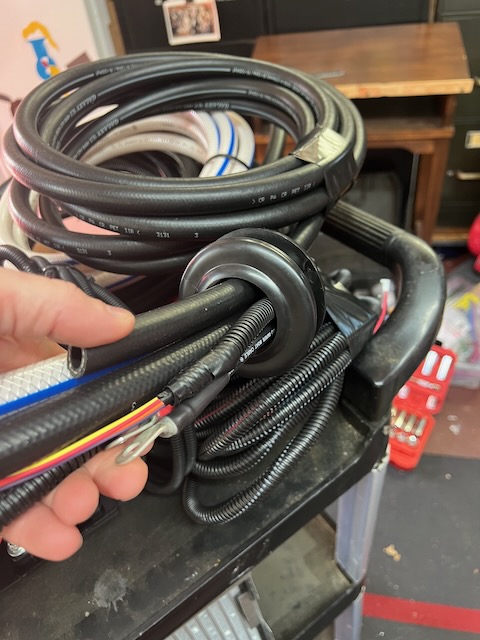
blog/2023-3-15-air-cond-install/floor-pass-through.jpeg
