natecostello/van_two_point_oh/blog/2023-3-15-air-cond-install/side-view.jpg

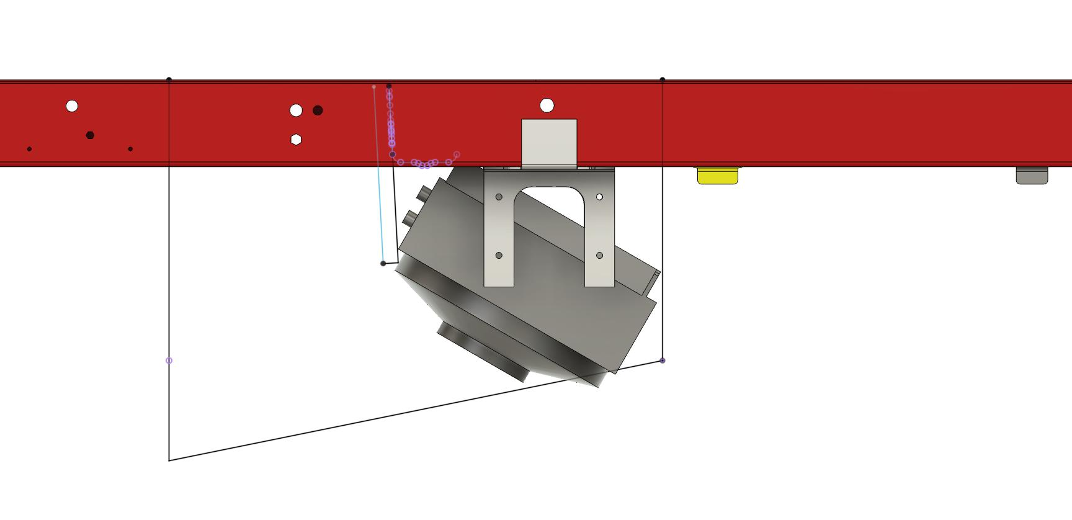
blog/2023-3-15-air-cond-install/side-view.jpg
