natecostello/van_two_point_oh/blog/2023-3-15-air-cond-install/transit-bracket-mount-location.png

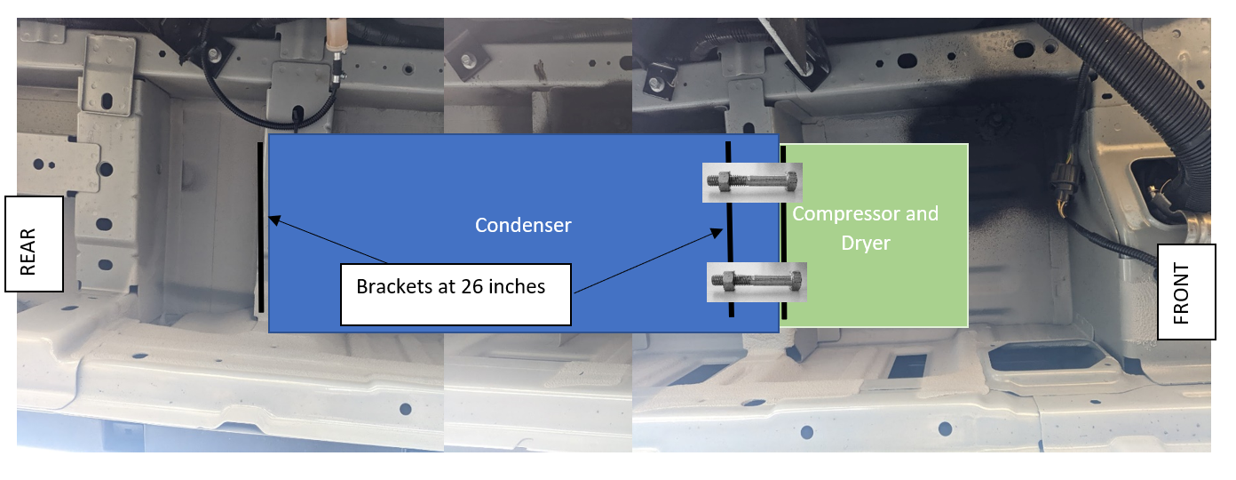
blog/2023-3-15-air-cond-install/transit-bracket-mount-location.png
