natecostello/van_two_point_oh/van/electrical/BMS_wiring_logic/rec-bms.jpeg

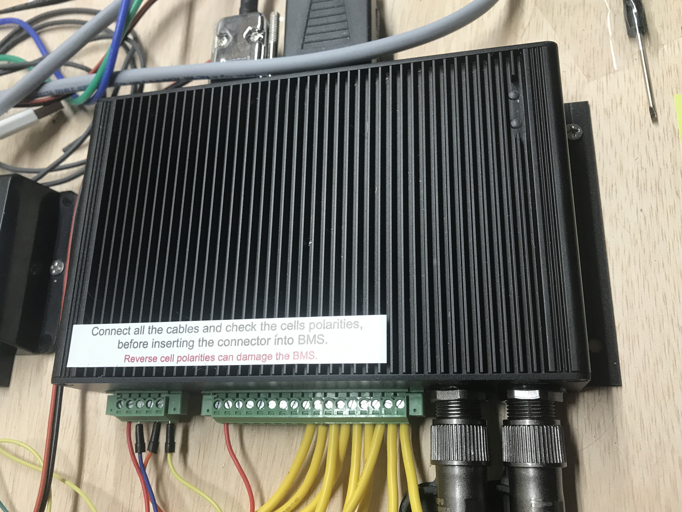
van/electrical/BMS_wiring_logic/rec-bms.jpeg
