natecostello/van_two_point_oh/van/reference/pictures/slider_step1.jpg

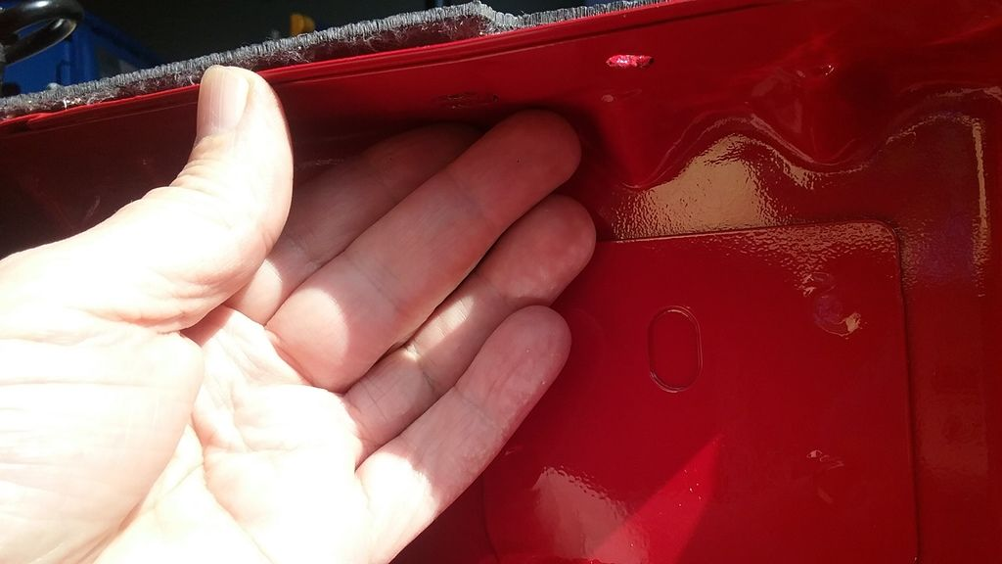
van/reference/pictures/slider_step1.jpg
