natecostello/van_two_point_oh/van/reference/pictures/slider_step2.jpg

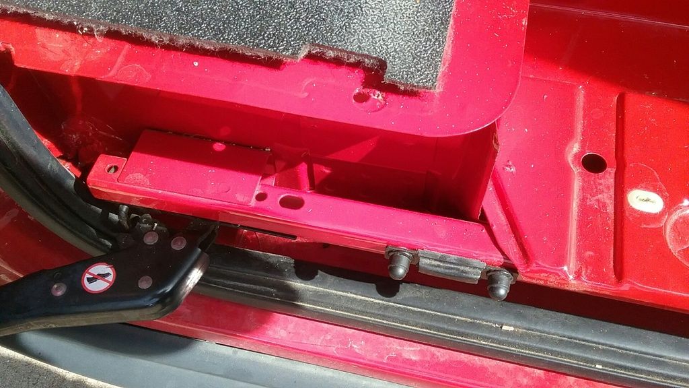
van/reference/pictures/slider_step2.jpg
