natecostello/van_two_point_oh/van/reference/pictures/slider_step3.jpg

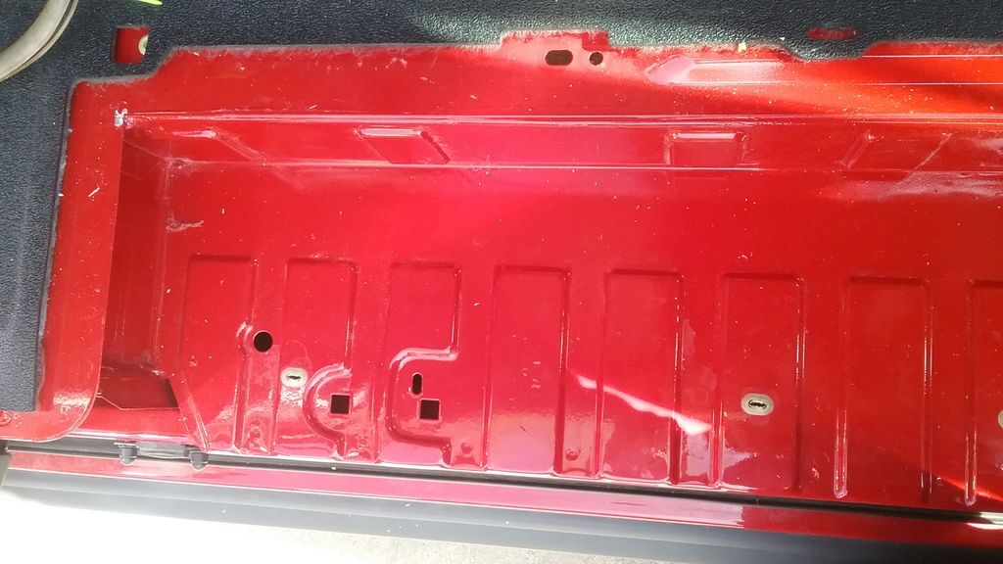
van/reference/pictures/slider_step3.jpg
