natecostello/van_two_point_oh/van/reference/pictures/slider_step.jpg

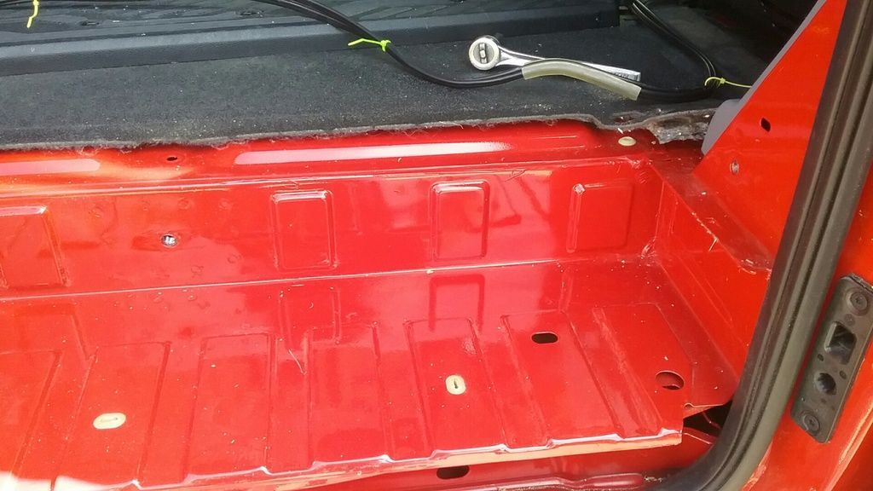
van/reference/pictures/slider_step.jpg
