natecostello/van_two_point_oh/van/reference/vehicle_dimensions/Layout_Guide_Transit_148_EX_WB.jpg

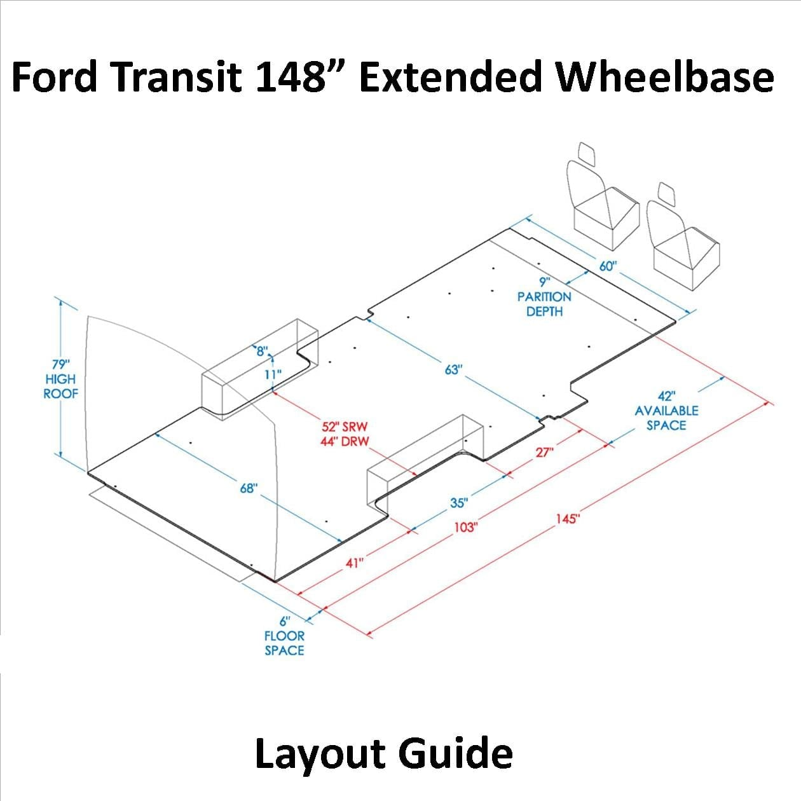
van/reference/vehicle_dimensions/Layout_Guide_Transit_148_EX_WB.jpg
