natecostello/van_two_point_oh/van/reference/vehicle_dimensions/manual_measurements/images/ceiling_rib_holes5_small.jpeg

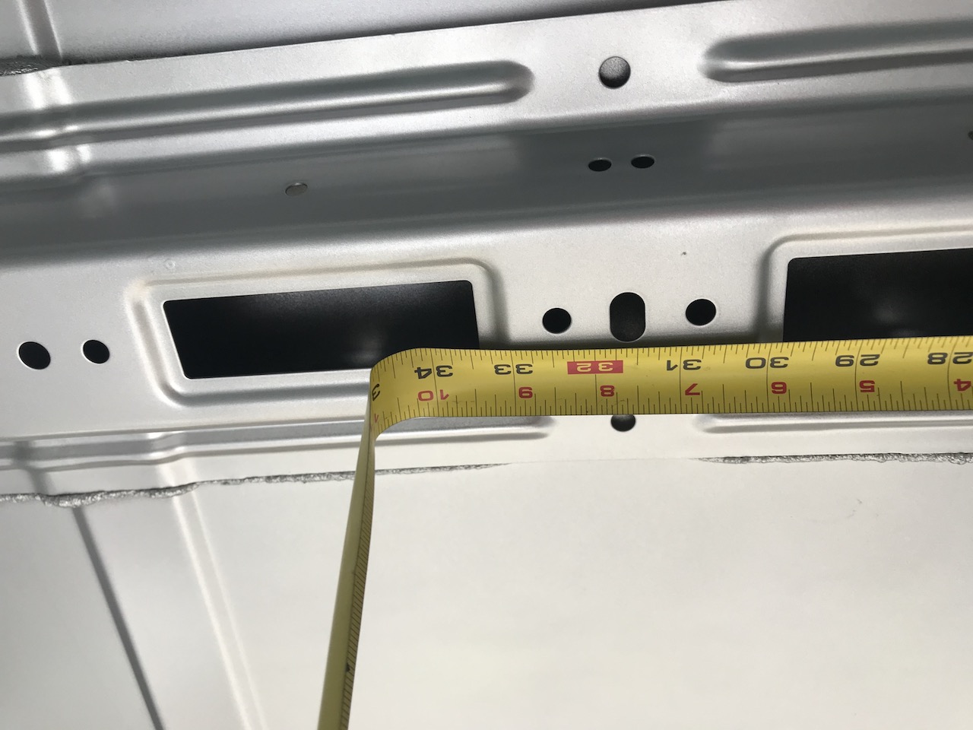
van/reference/vehicle_dimensions/manual_measurements/images/ceiling_rib_holes5_small.jpeg
