natecostello/van_two_point_oh/van/reference/vehicle_dimensions/manual_measurements/images/ceiling_ribs5_small.JPG

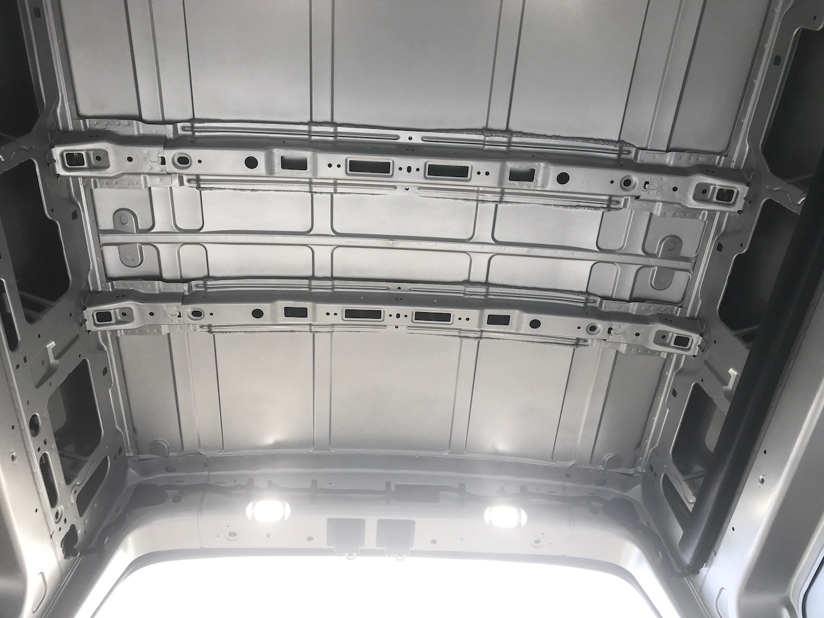
van/reference/vehicle_dimensions/manual_measurements/images/ceiling_ribs5_small.JPG
