natecostello/van_two_point_oh/van/reference/vehicle_dimensions/manual_measurements/images/floor6_small.JPG

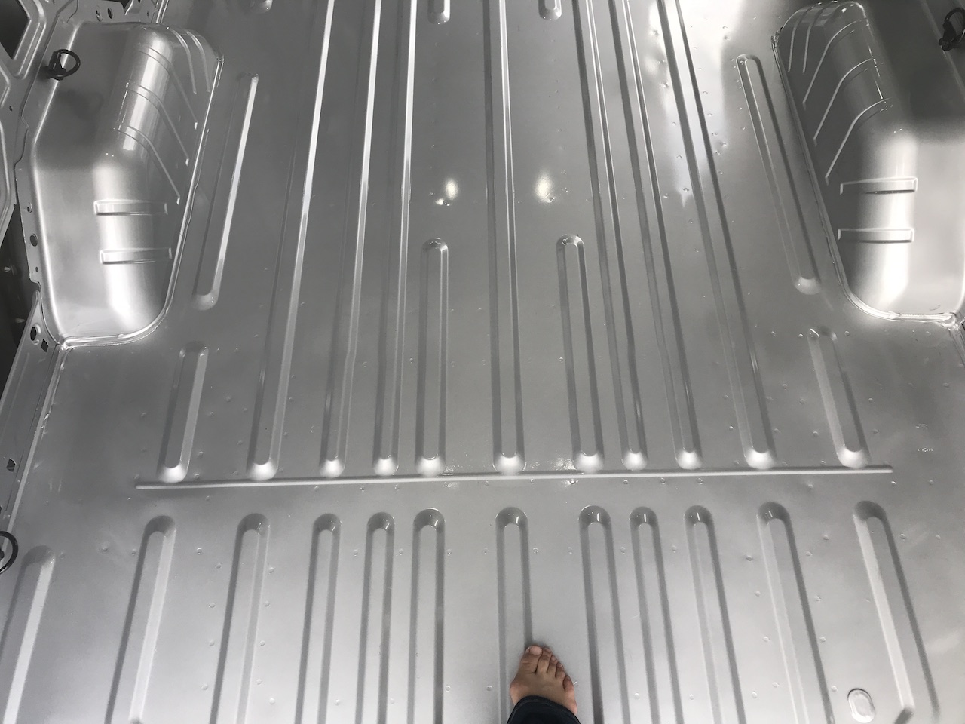
van/reference/vehicle_dimensions/manual_measurements/images/floor6_small.JPG
