natecostello/van_two_point_oh/van/reference/vehicle_dimensions/manual_measurements/images/floor_rib_spacing1_small.JPG

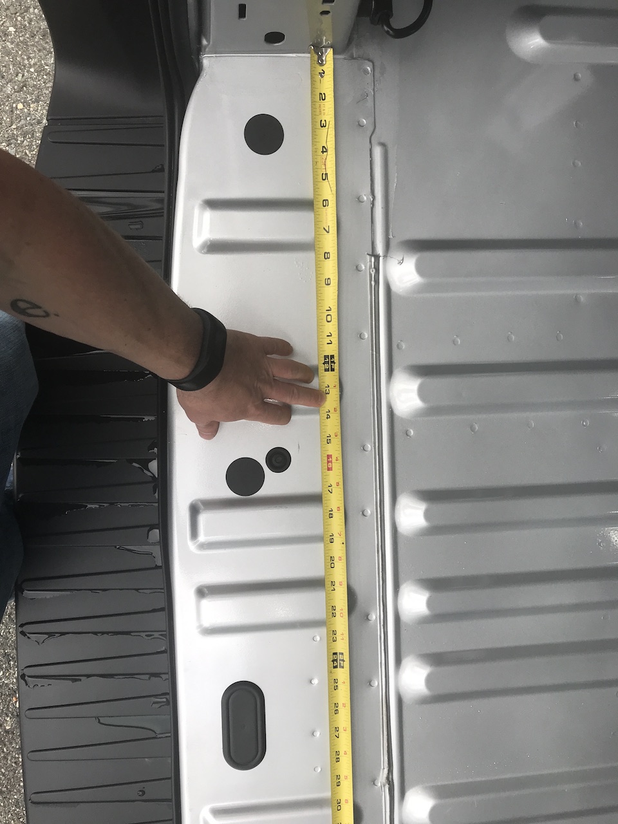
van/reference/vehicle_dimensions/manual_measurements/images/floor_rib_spacing1_small.JPG
