natecostello/van_two_point_oh/van/reference/vehicle_dimensions/manual_measurements/images/floor_to_door_bottom_small.JPG

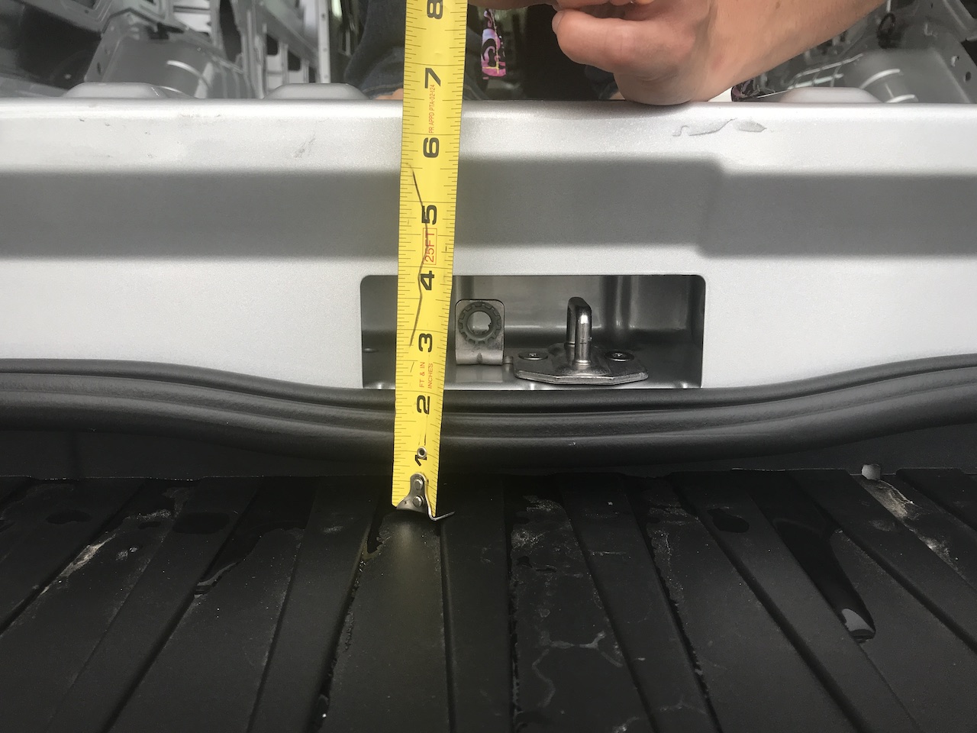
van/reference/vehicle_dimensions/manual_measurements/images/floor_to_door_bottom_small.JPG
