natecostello/van_two_point_oh/van/reference/vehicle_dimensions/manual_measurements/images/interior_full3_small.JPG

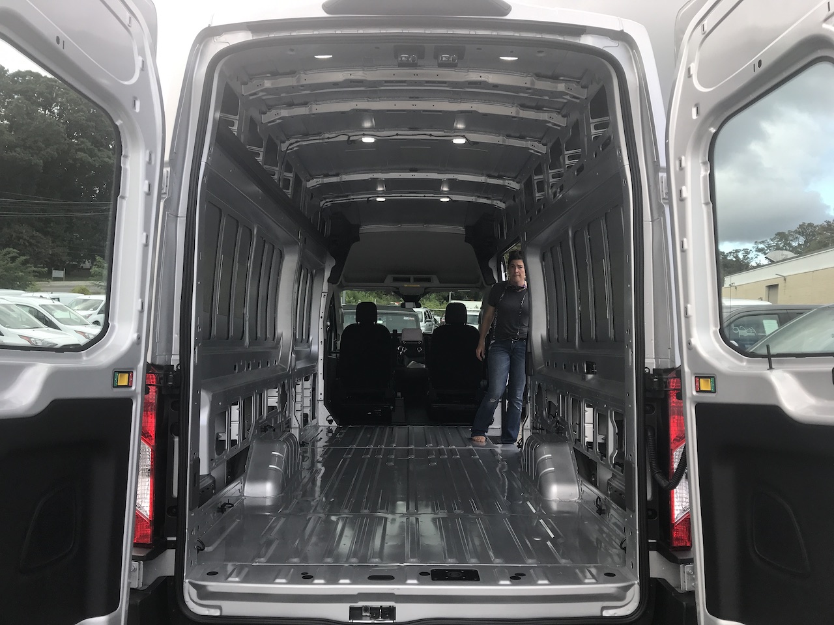
van/reference/vehicle_dimensions/manual_measurements/images/interior_full3_small.JPG
