natecostello/van_two_point_oh/van/reference/vehicle_dimensions/manual_measurements/images/length_at_center_ctx_small.jpeg

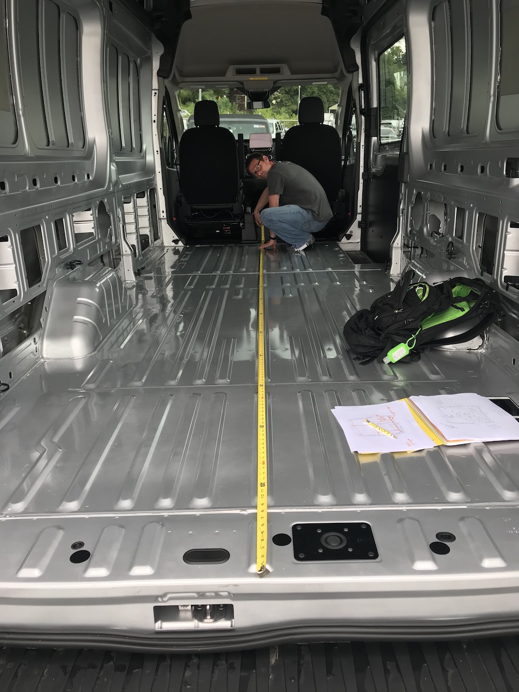
van/reference/vehicle_dimensions/manual_measurements/images/length_at_center_ctx_small.jpeg
