natecostello/van_two_point_oh/van/reference/vehicle_dimensions/manual_measurements/images/length_at_center_small.jpeg

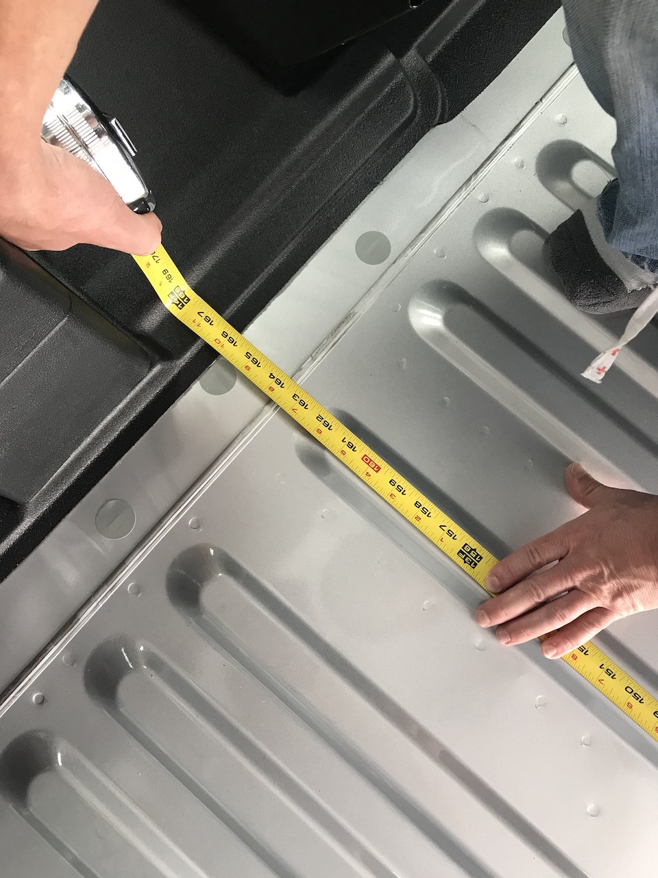
van/reference/vehicle_dimensions/manual_measurements/images/length_at_center_small.jpeg
