natecostello/van_two_point_oh/van/reference/vehicle_dimensions/manual_measurements/images/lower_holes_horizontal_ctx_small.jpeg

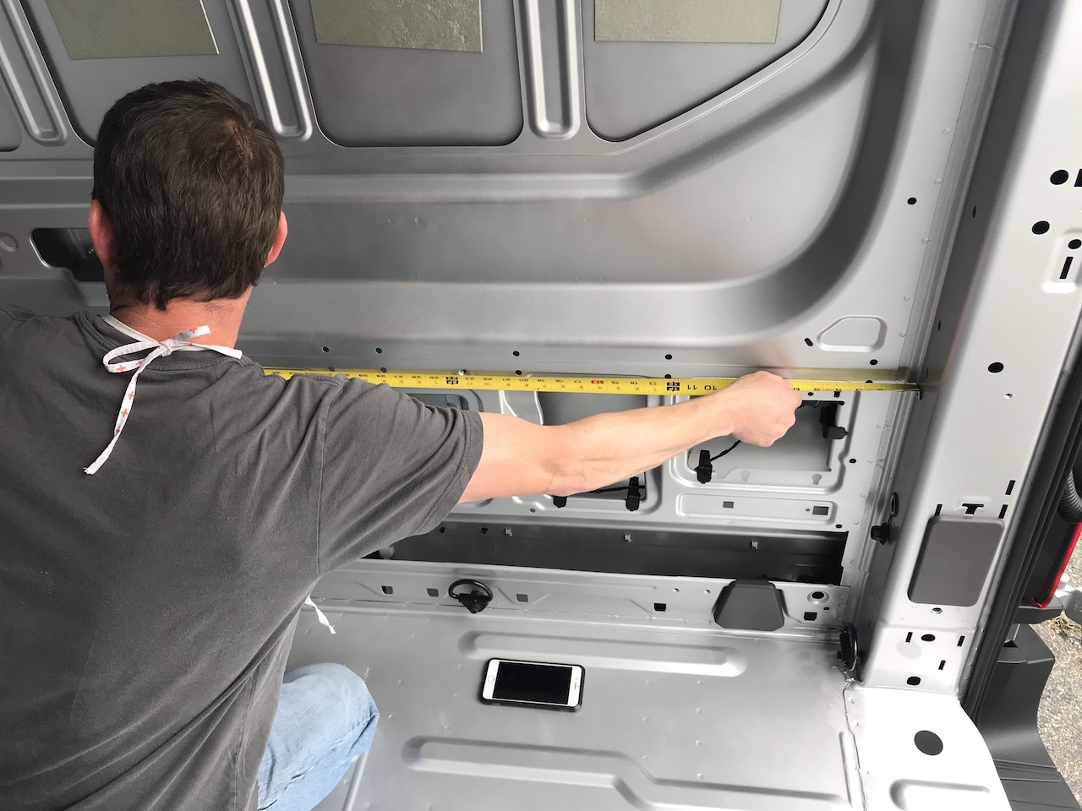
van/reference/vehicle_dimensions/manual_measurements/images/lower_holes_horizontal_ctx_small.jpeg
