natecostello/van_two_point_oh/van/reference/vehicle_dimensions/manual_measurements/images/lower_holes_vertical4_bumpout_small.jpeg

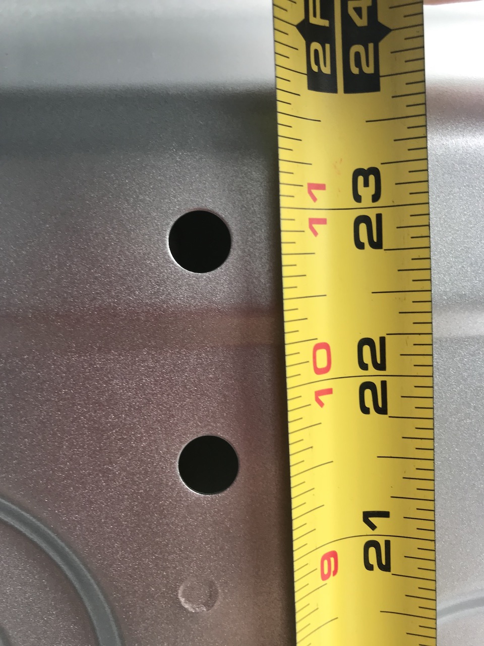
van/reference/vehicle_dimensions/manual_measurements/images/lower_holes_vertical4_bumpout_small.jpeg
