natecostello/van_two_point_oh/van/reference/vehicle_dimensions/manual_measurements/images/lower_wall_cavity_depth2_small.JPG

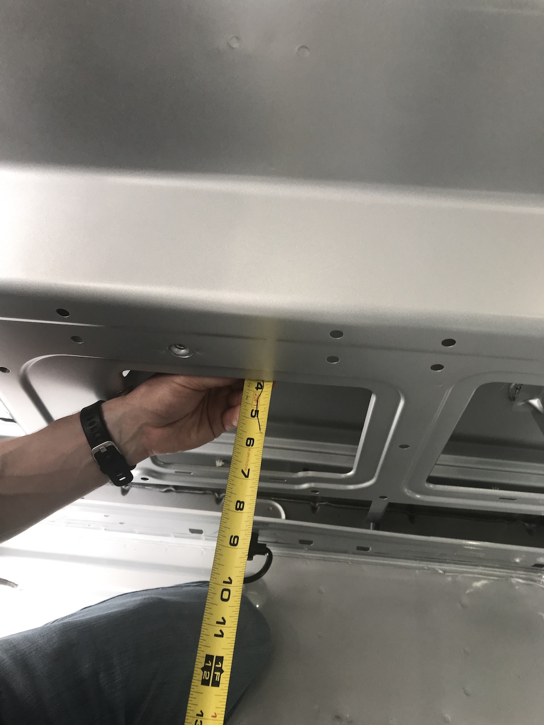
van/reference/vehicle_dimensions/manual_measurements/images/lower_wall_cavity_depth2_small.JPG
