natecostello/van_two_point_oh/van/reference/vehicle_dimensions/manual_measurements/images/mid_reinforcement2_small.jpeg

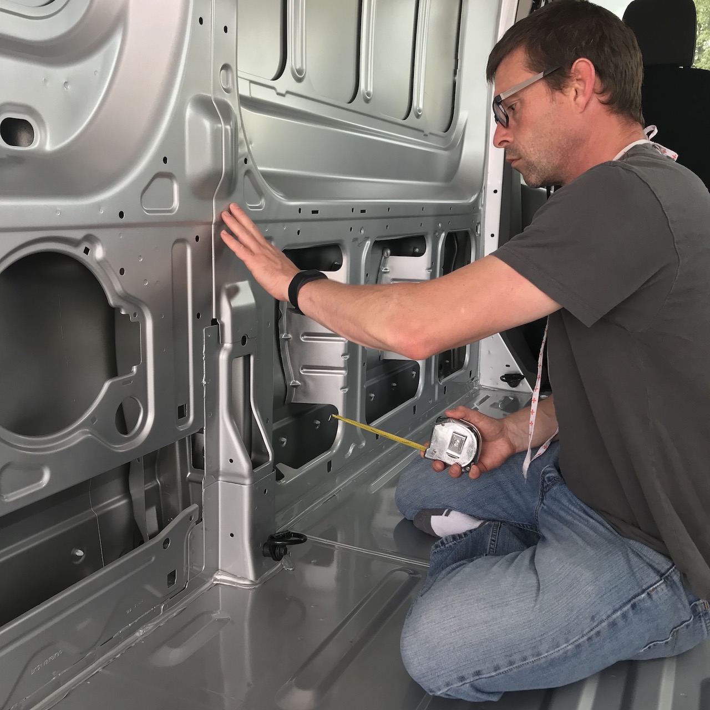
van/reference/vehicle_dimensions/manual_measurements/images/mid_reinforcement2_small.jpeg
