natecostello/van_two_point_oh/van/reference/vehicle_dimensions/manual_measurements/images/mid_reinforcment_vertical_ctx_small.jpeg

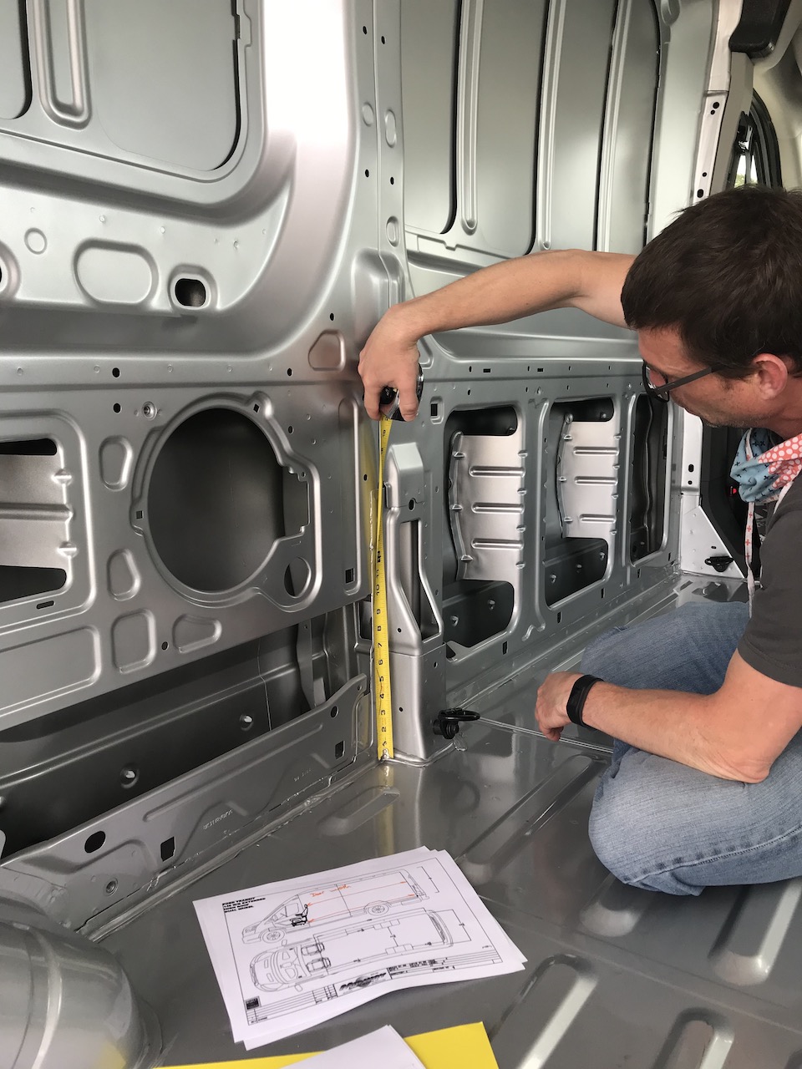
van/reference/vehicle_dimensions/manual_measurements/images/mid_reinforcment_vertical_ctx_small.jpeg
