natecostello/van_two_point_oh/van/reference/vehicle_dimensions/manual_measurements/images/power_door1_small.jpeg

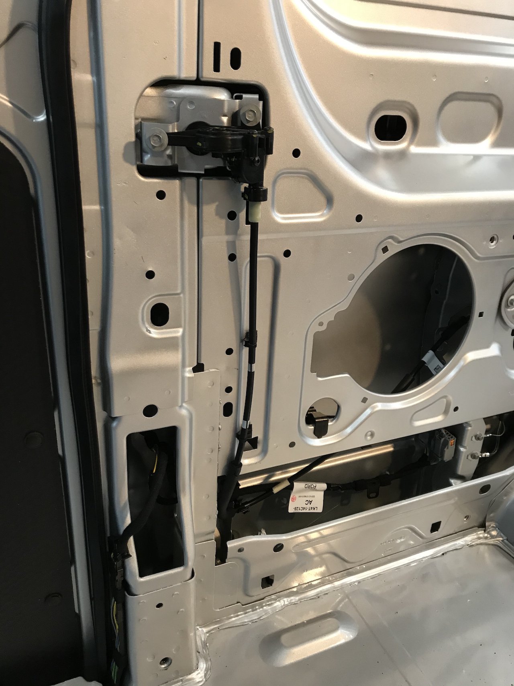
van/reference/vehicle_dimensions/manual_measurements/images/power_door1_small.jpeg
