natecostello/van_two_point_oh/van/reference/vehicle_dimensions/manual_measurements/images/rear_pillar_access_small.JPG

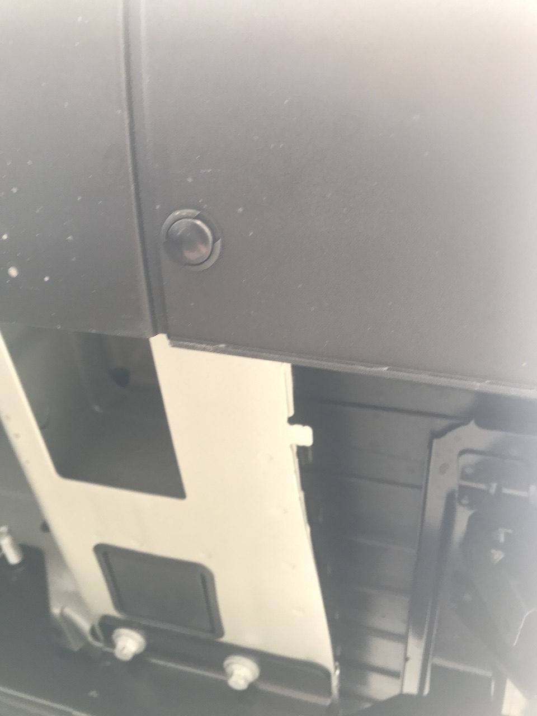
van/reference/vehicle_dimensions/manual_measurements/images/rear_pillar_access_small.JPG
