natecostello/van_two_point_oh/van/reference/vehicle_dimensions/manual_measurements/images/rear_pillar_internal_small.JPG

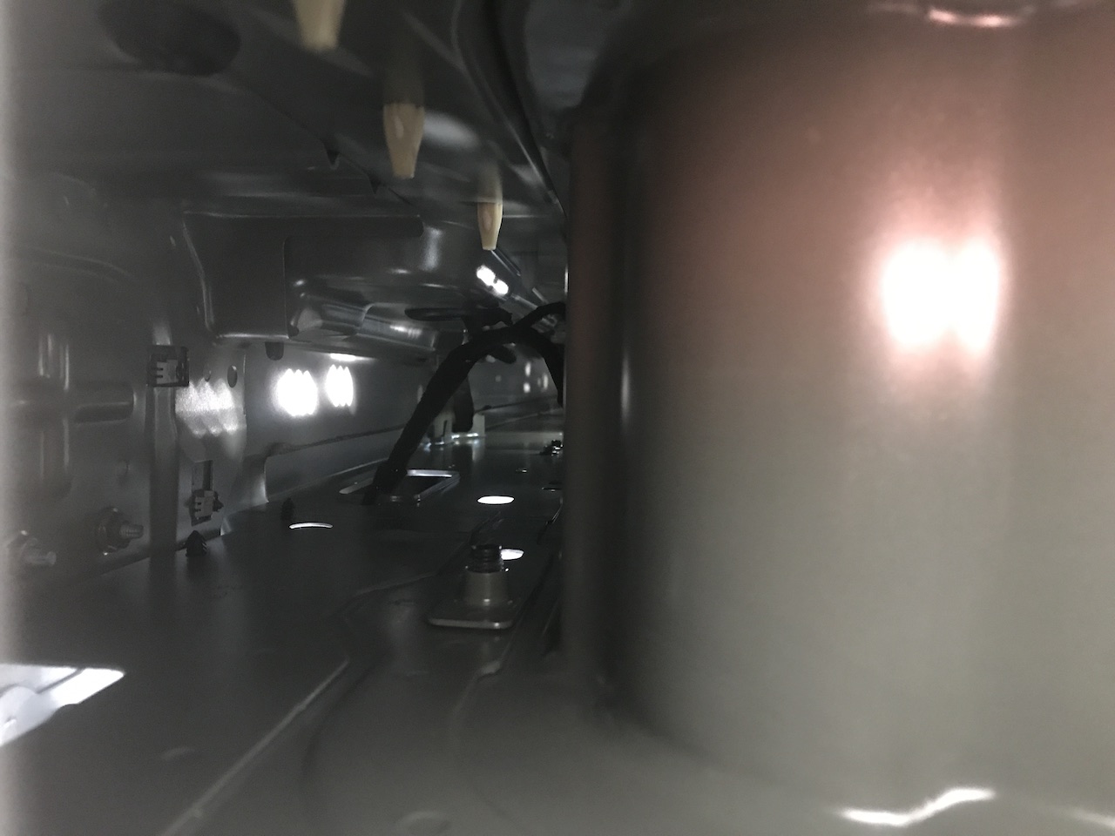
van/reference/vehicle_dimensions/manual_measurements/images/rear_pillar_internal_small.JPG
