natecostello/van_two_point_oh/van/reference/vehicle_dimensions/manual_measurements/images/rear_to_ceiling_rib2_small.jpeg

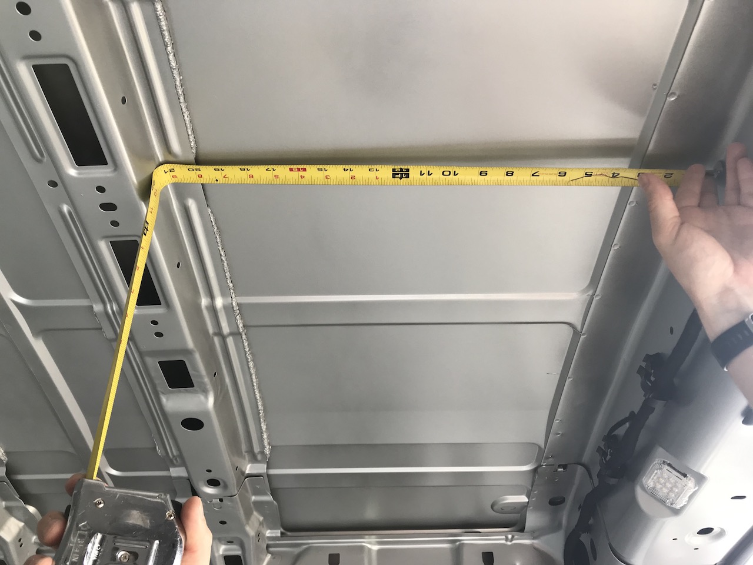
van/reference/vehicle_dimensions/manual_measurements/images/rear_to_ceiling_rib2_small.jpeg
