natecostello/van_two_point_oh/van/reference/vehicle_dimensions/manual_measurements/images/shelf4_small.JPG

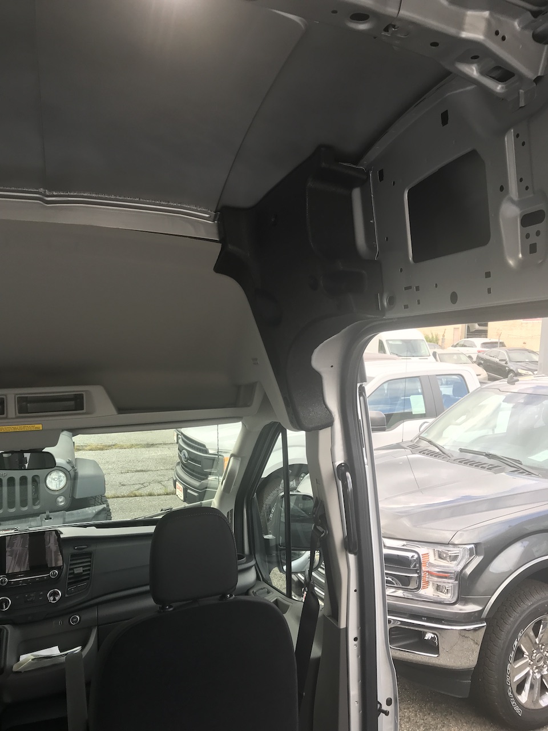
van/reference/vehicle_dimensions/manual_measurements/images/shelf4_small.JPG
