natecostello/van_two_point_oh/van/reference/vehicle_dimensions/manual_measurements/images/underside_exhaust_and_diff_small.JPG

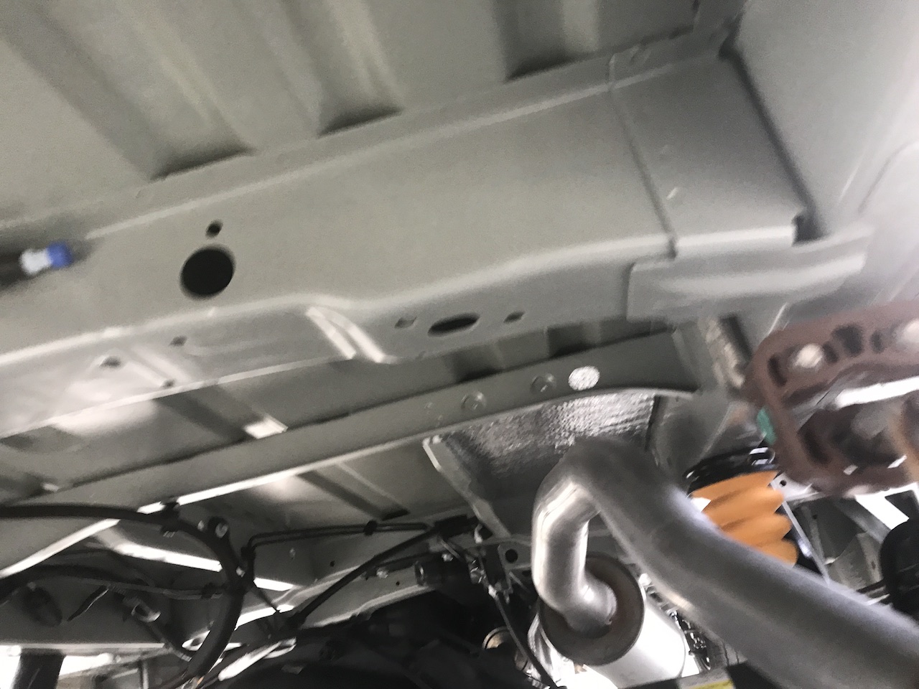
van/reference/vehicle_dimensions/manual_measurements/images/underside_exhaust_and_diff_small.JPG
