natecostello/van_two_point_oh/van/reference/vehicle_dimensions/manual_measurements/images/underside_floor_to_wall_overhang_small.JPG

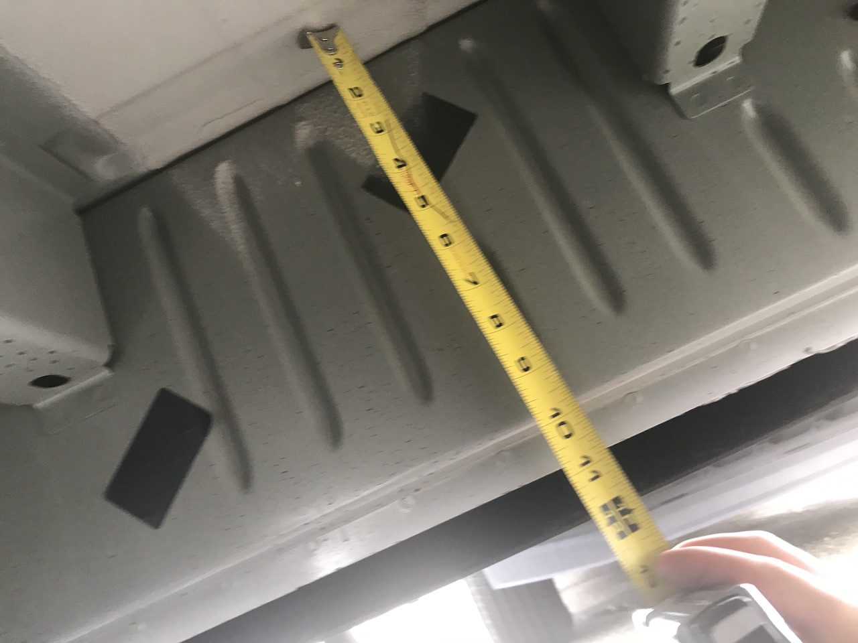
van/reference/vehicle_dimensions/manual_measurements/images/underside_floor_to_wall_overhang_small.JPG
