natecostello/van_two_point_oh/van/reference/vehicle_dimensions/manual_measurements/images/underside_fwd_of_spare_small.JPG

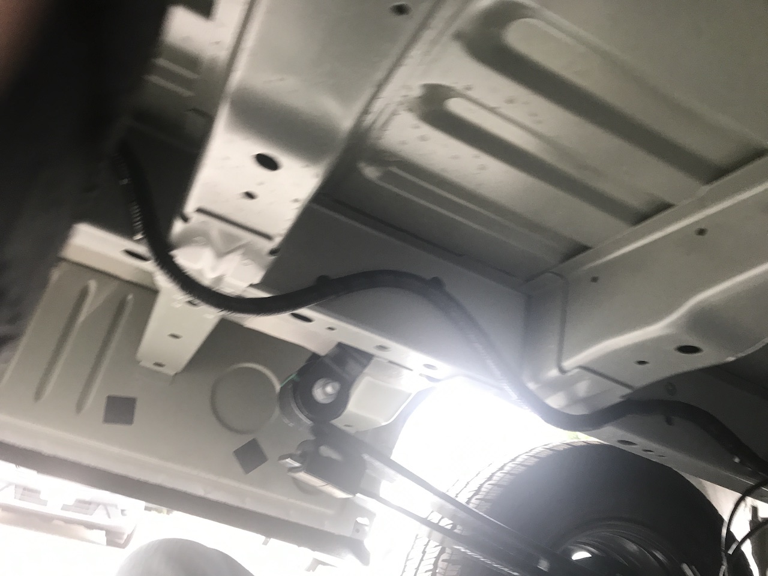
van/reference/vehicle_dimensions/manual_measurements/images/underside_fwd_of_spare_small.JPG
