natecostello/van_two_point_oh/van/reference/vehicle_dimensions/manual_measurements/images/underside_leaf_spring_connection_small.JPG

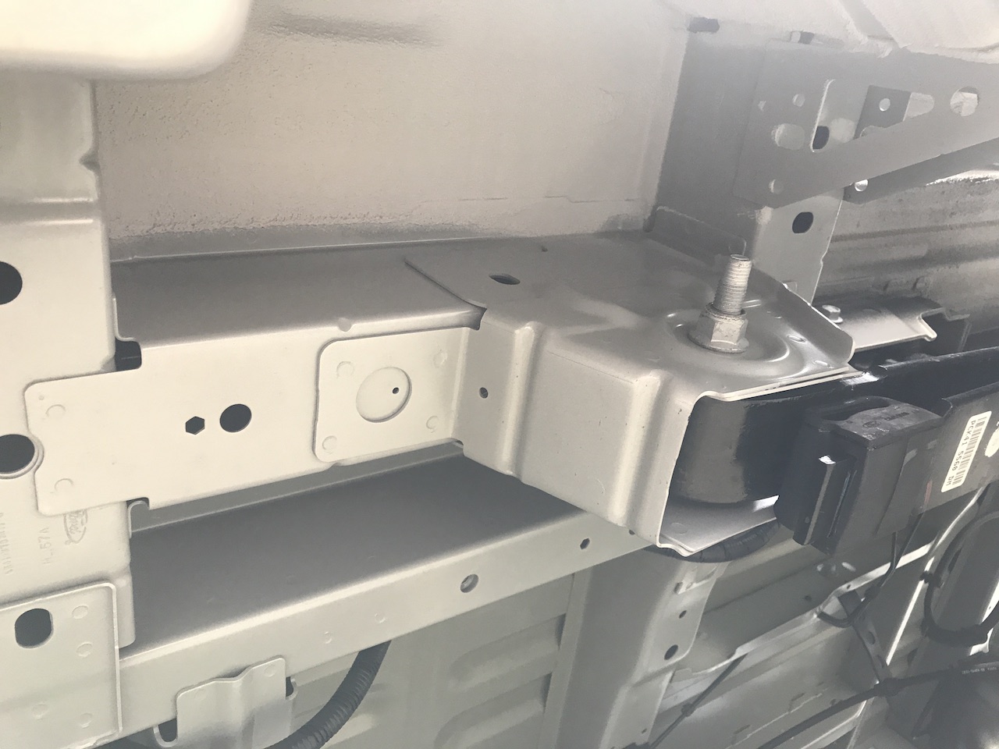
van/reference/vehicle_dimensions/manual_measurements/images/underside_leaf_spring_connection_small.JPG
