natecostello/van_two_point_oh/van/reference/vehicle_dimensions/manual_measurements/images/underside_rear_bumpstop_small.jpeg

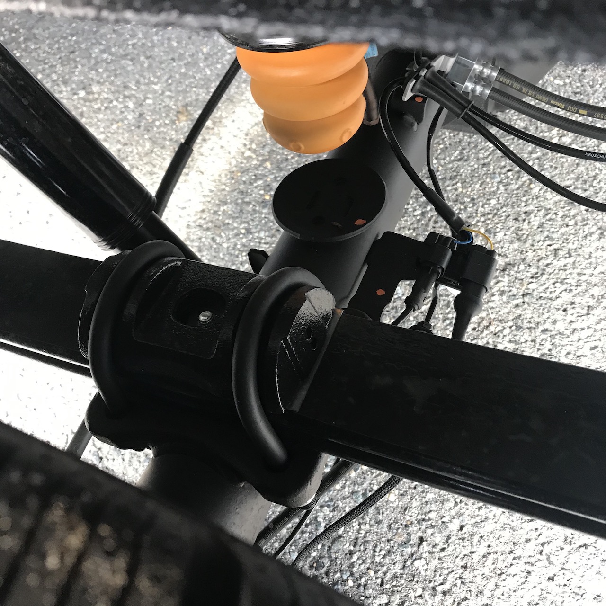
van/reference/vehicle_dimensions/manual_measurements/images/underside_rear_bumpstop_small.jpeg
