natecostello/van_two_point_oh/van/reference/vehicle_dimensions/manual_measurements/images/underside_wall_cavity_access_small.JPG

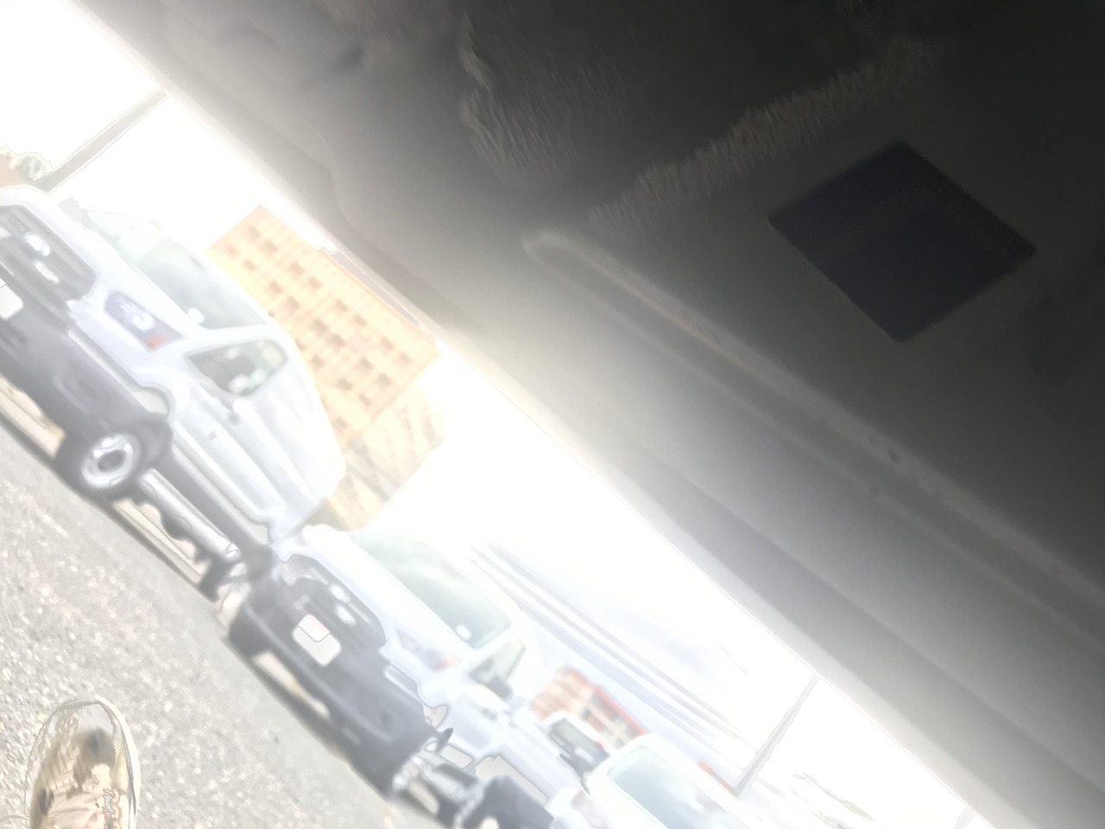
van/reference/vehicle_dimensions/manual_measurements/images/underside_wall_cavity_access_small.JPG
