natecostello/van_two_point_oh/van/reference/vehicle_dimensions/manual_measurements/images/upper_holes_horizontal_over_door_small.jpeg

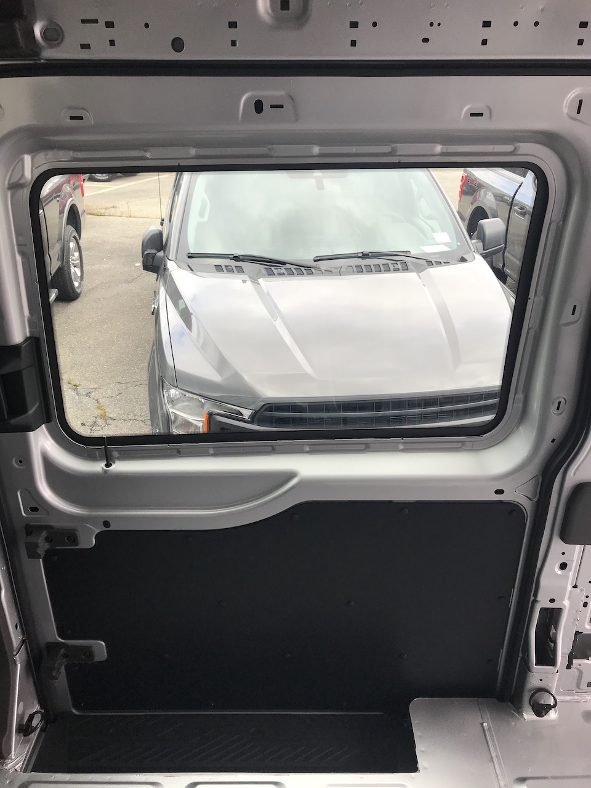
van/reference/vehicle_dimensions/manual_measurements/images/upper_holes_horizontal_over_door_small.jpeg
