natecostello/van_two_point_oh/van/reference/vehicle_dimensions/manual_measurements/images/upper_wall_holes_horizontal_small.jpeg

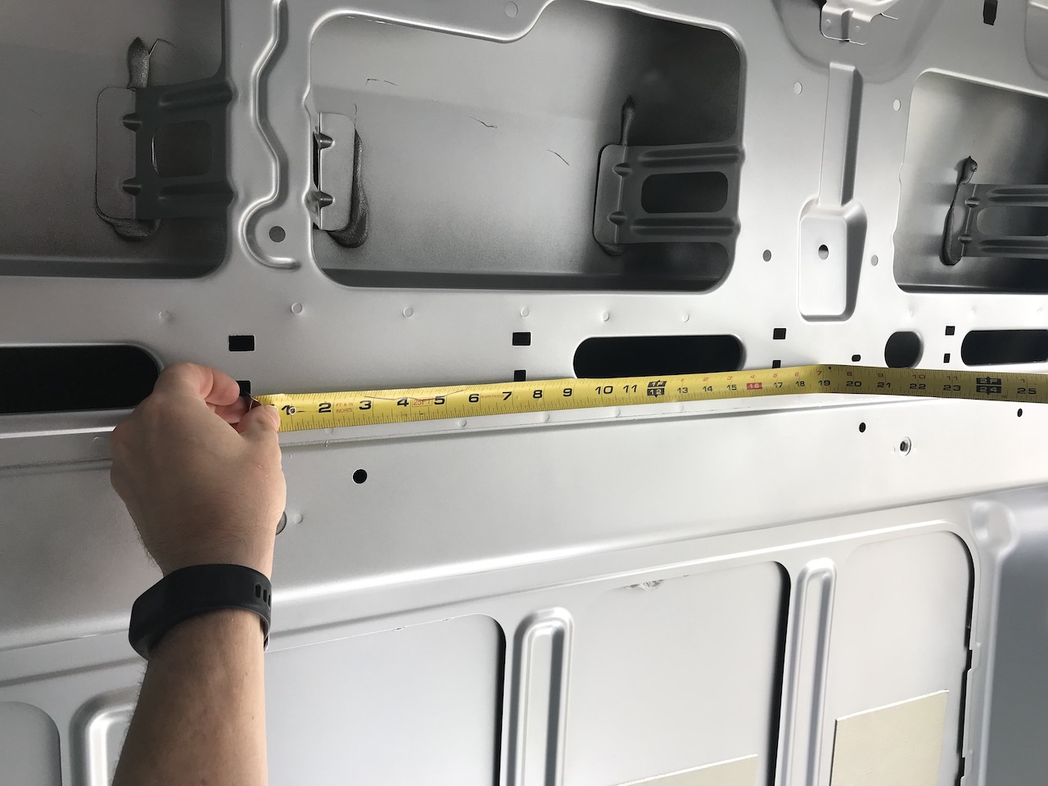
van/reference/vehicle_dimensions/manual_measurements/images/upper_wall_holes_horizontal_small.jpeg
