natecostello/van_two_point_oh/van/reference/vehicle_dimensions/manual_measurements/images/walls12_small.JPG

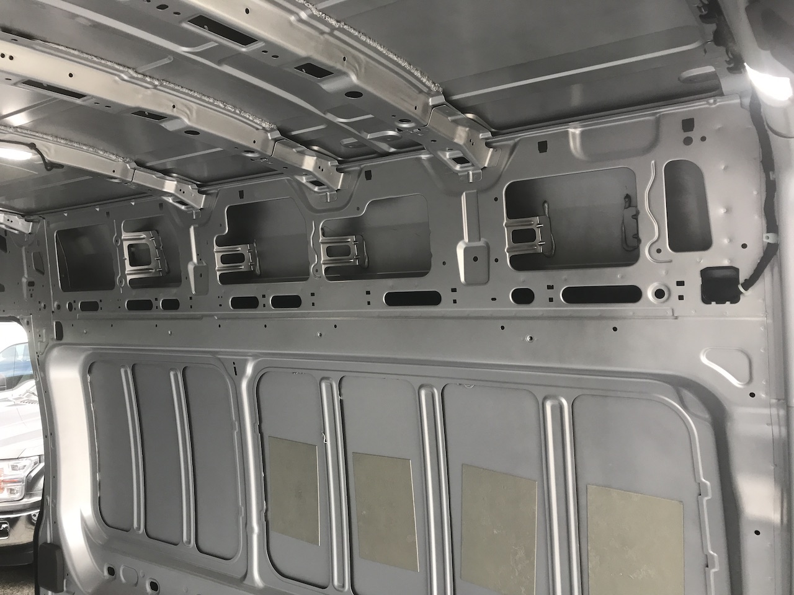
van/reference/vehicle_dimensions/manual_measurements/images/walls12_small.JPG
