natecostello/van_two_point_oh/van/reference/vehicle_dimensions/manual_measurements/images/wheel_well_thickness1_small.JPG

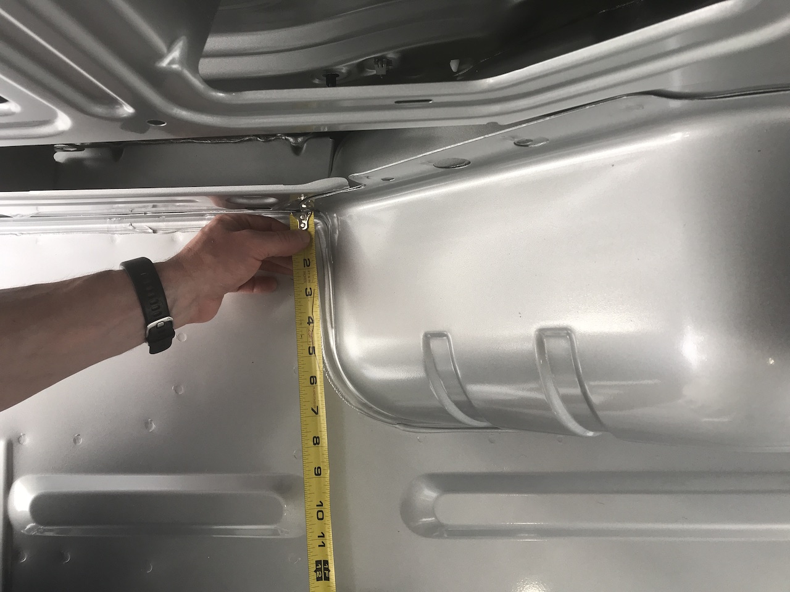
van/reference/vehicle_dimensions/manual_measurements/images/wheel_well_thickness1_small.JPG
