natecostello/van_two_point_oh/van/reference/vehicle_dimensions/manual_measurements/images/wheel_well_thickness2_small.JPG

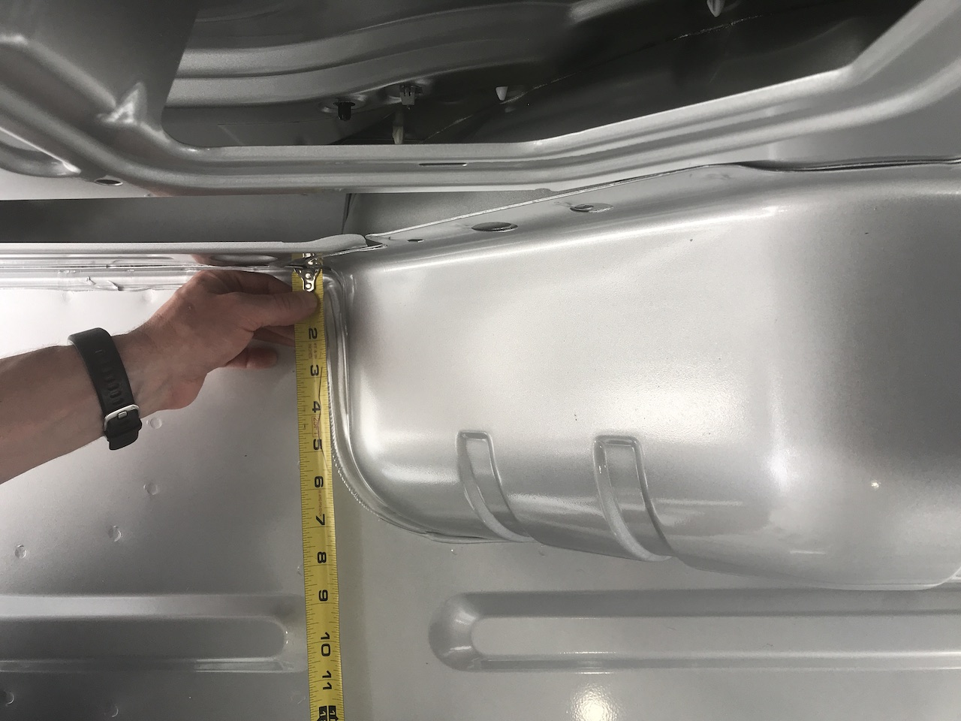
van/reference/vehicle_dimensions/manual_measurements/images/wheel_well_thickness2_small.JPG
