natecostello/van_two_point_oh/van/reference/vehicle_dimensions/manual_measurements/images/width_at_floor_bumpout_ctx_small.jpeg

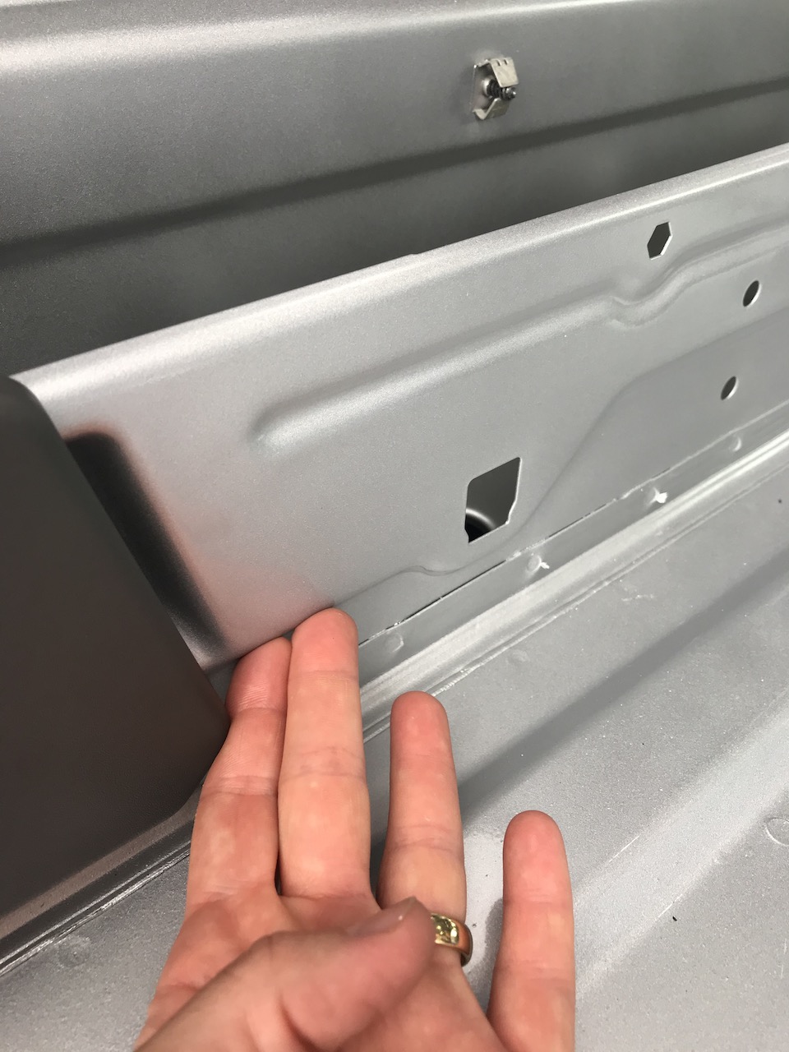
van/reference/vehicle_dimensions/manual_measurements/images/width_at_floor_bumpout_ctx_small.jpeg
