natecostello/van_two_point_oh/van/reference/vehicle_dimensions/manual_measurements/images/width_at_floor_small.jpeg

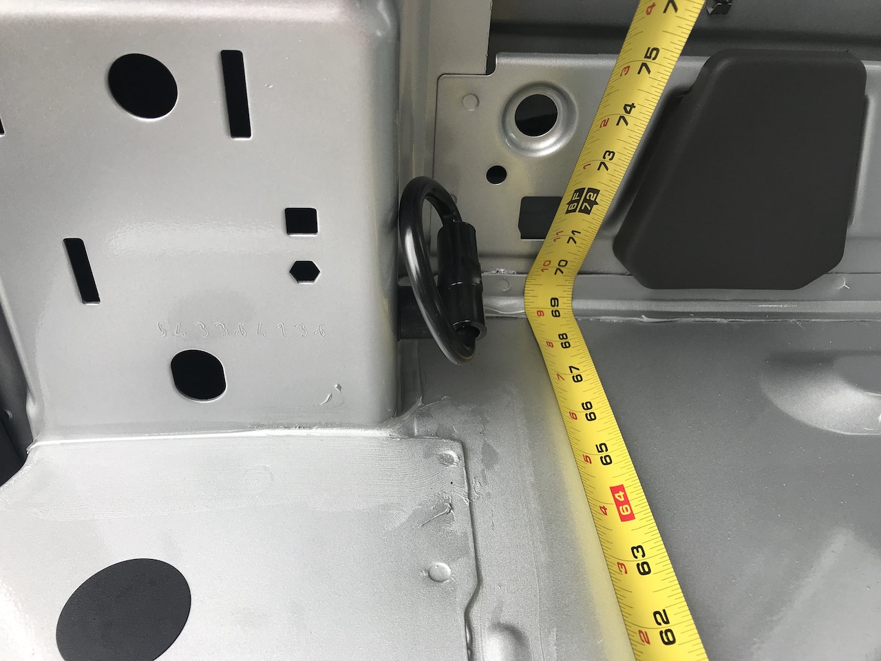
van/reference/vehicle_dimensions/manual_measurements/images/width_at_floor_small.jpeg
