natecostello/van_two_point_oh/van/reference/vehicle_dimensions/manual_measurements/images/width_between_rear_pillars_small.jpeg

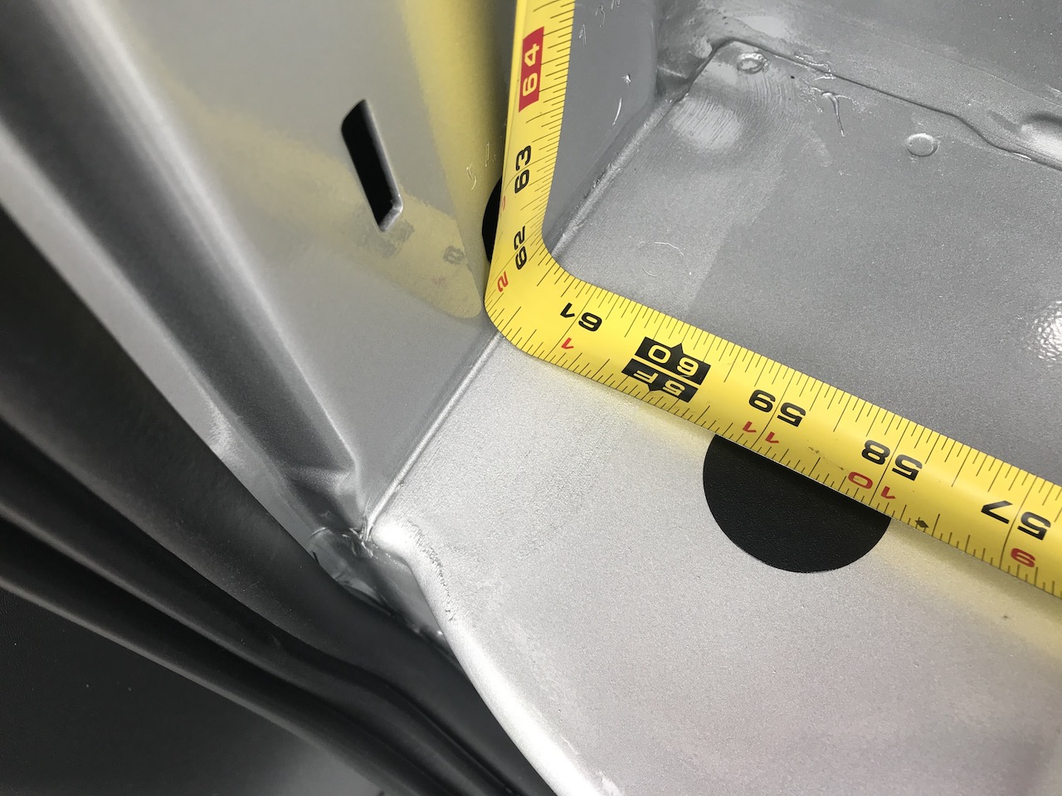
van/reference/vehicle_dimensions/manual_measurements/images/width_between_rear_pillars_small.jpeg
