natecostello/van_two_point_oh/van/structural/side_door_step/Transit_Side_door_step_option_E.jpg

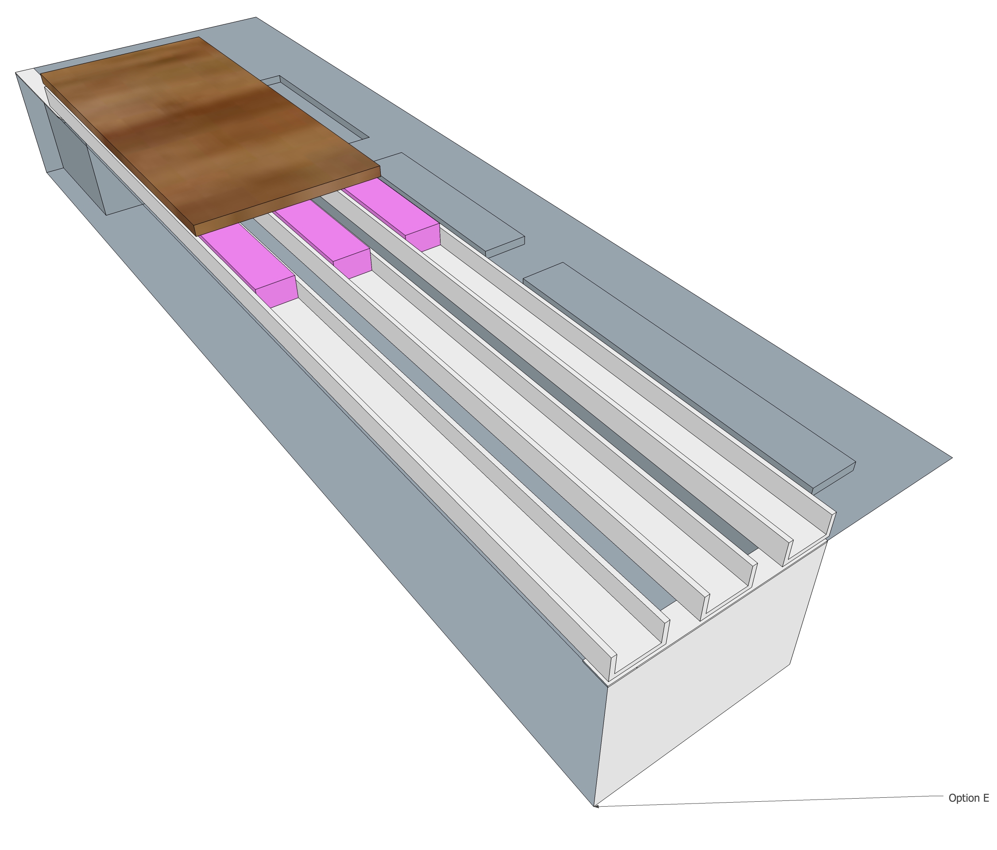
van/structural/side_door_step/Transit_Side_door_step_option_E.jpg
