natecostello/van_two_point_oh/van/tactical/build_flow_chart/Van_Flow_Chart.jpg

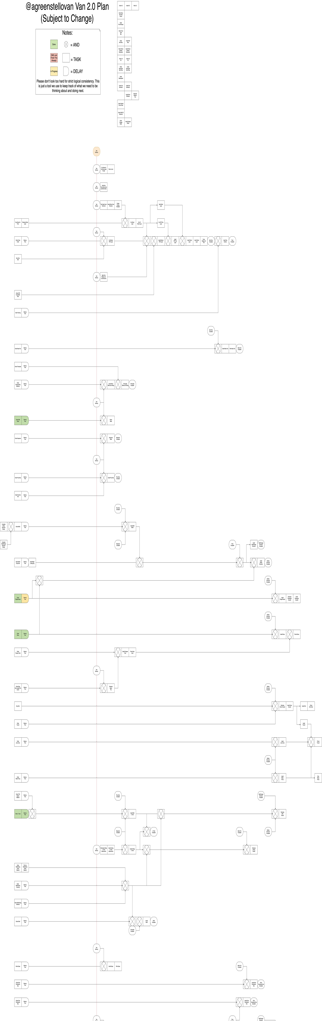
van/tactical/build_flow_chart/Van_Flow_Chart.jpg
