natecostello/van_two_point_oh/blog/2021-8-5-bms-testing/rising_temperature_test.csv

time | rd6018.Voltage Setting.V | rd6018.Current Setting.A | rd6018.Voltage Output.V | rd6018.Current Output.A | rd6018.Power Output.W | rd6018.External Temperature.C | rec-q-binary.internal_relay.binary | rec-q-binary.charge_enable.binary | rec-q-binary.system_plus.binary | rec-q-binary.contactor.binary | rec-q-can.CVL.V | rec-q-can.CCL.A | rec-q-can.DVL.V | rec-q-can.DCL.A | rec-q-can.SOC.% | rec-q-can.SOH.% | rec-q-can.SOC_HR.% | rec-q-can.Battery Voltage.V | rec-q-can.Battery Current.A | rec-q-can.Battery Temp.C | rec-q-can.Min Cell Voltage.V | rec-q-can.Max Cell Voltage.V | rec-q-can.Min Temperature.C | rec-q-can.Max Temperature.C | rec-q-can.Rated Capacity.AH | rec-q-can.Remaining Capacity.AH | rec-q-can.Warning Bits.binary | rec-q-can.Alarm Bits.binary
2021-08-05 21:35:45.190454 | 26.0 | 6.94 | 26.01 | 0.06 | 1.56 | 26 | 1 | 1 | 0 | 1 | 28.7 | 70.0 | 23.1 | 0.0 | 1 | 100 | 1.99 | 25.98 | 0.0 | 40.5 | 3.239 | 3.26 | 27 | 40 | 560 | 12 | 00000000 00000000 10000000 00001010 | 10101000 10100000 10000010 00000000
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
