natecostello/van_two_point_oh/blog/2021-8-2-adhesive-test/landau-cover.jpeg

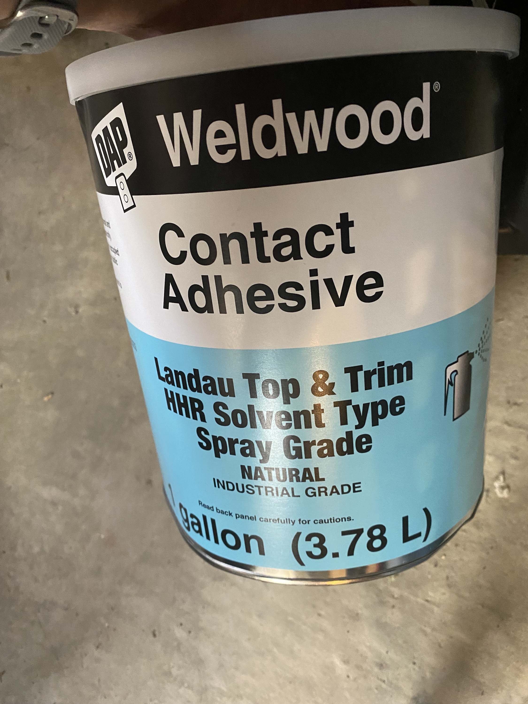
blog/2021-8-2-adhesive-test/landau-cover.jpeg
