natecostello/van_two_point_oh/blog/2021-8-5-bms-testing/Battery-Current-falling_temperature_test.png

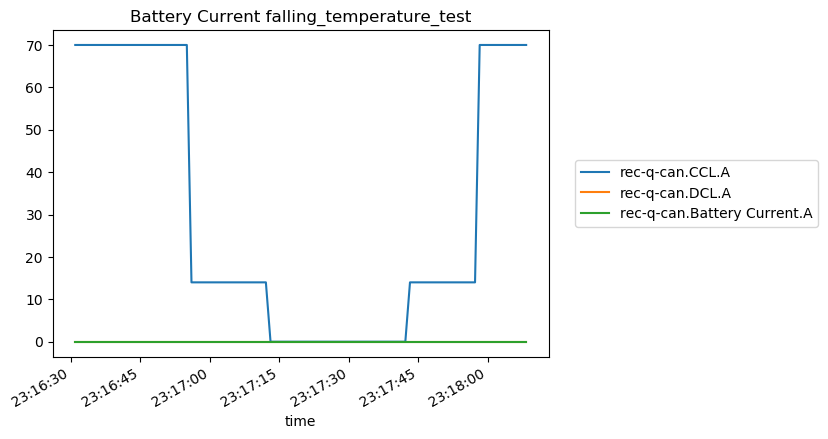
blog/2021-8-5-bms-testing/Battery-Current-falling_temperature_test.png
