natecostello/van_two_point_oh/blog/2021-8-5-bms-testing/battery-temperature-rising_temperature_test.png

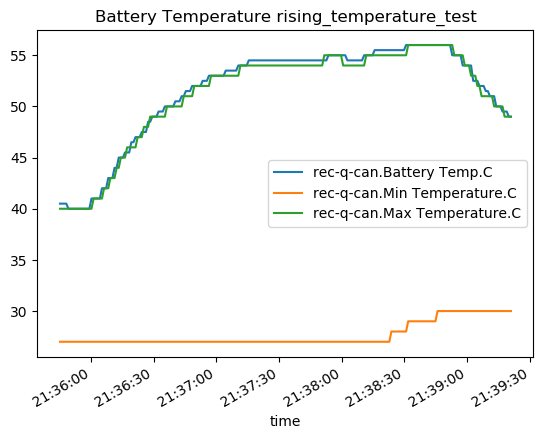
blog/2021-8-5-bms-testing/battery-temperature-rising_temperature_test.png
