natecostello/van_two_point_oh/blog/2021-8-5-bms-testing/battery-voltage-falling_voltage_test.png

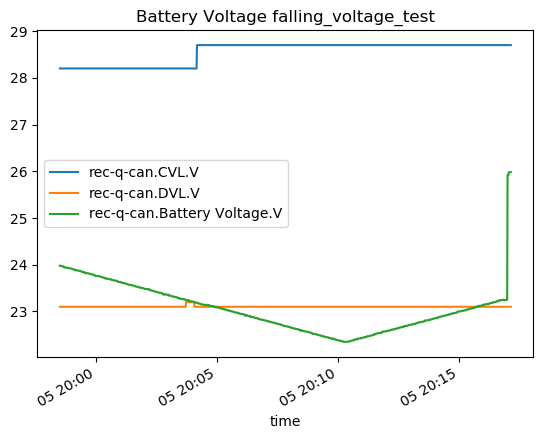
blog/2021-8-5-bms-testing/battery-voltage-falling_voltage_test.png
