natecostello/van_two_point_oh/blog/2021-8-5-bms-testing/max-cell-voltage-and-ccl-rising_voltage_test.png

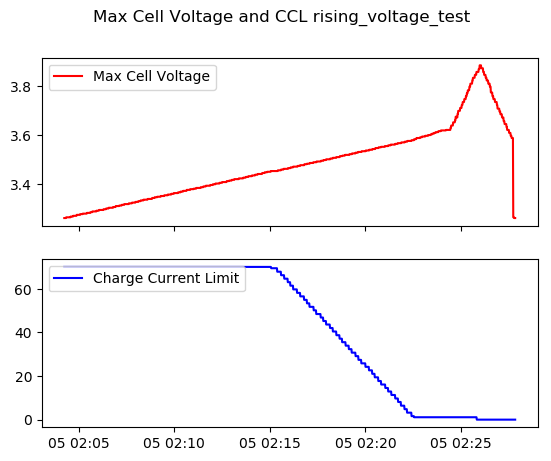
blog/2021-8-5-bms-testing/max-cell-voltage-and-ccl-rising_voltage_test.png
