natecostello/van_two_point_oh/blog/2021-8-5-bms-testing/mhmv2bmsctf-cover.jpeg

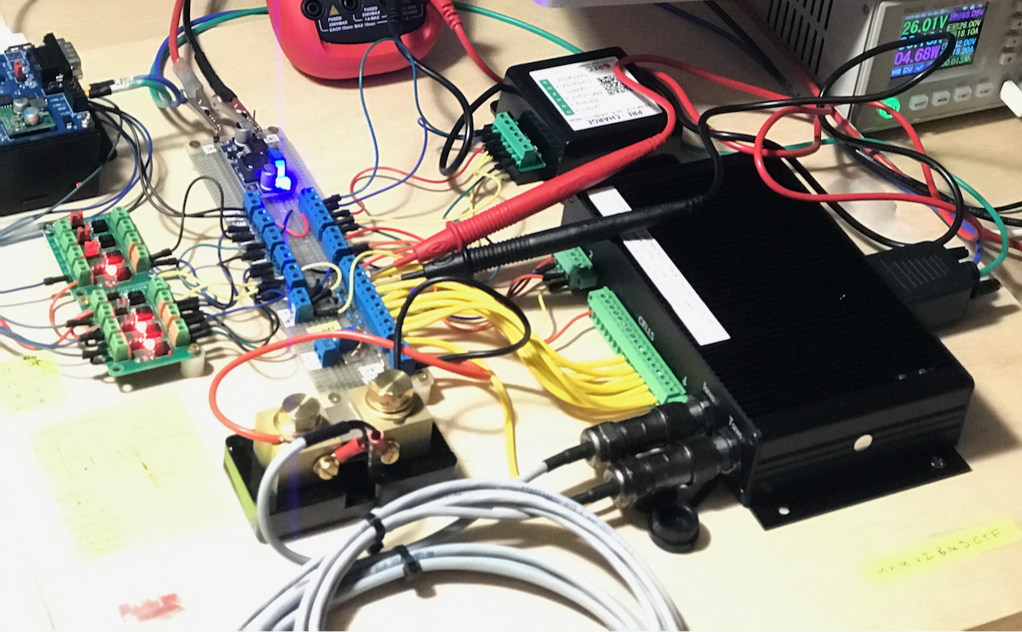
blog/2021-8-5-bms-testing/mhmv2bmsctf-cover.jpeg
