natecostello/van_two_point_oh/blog/2022-6-16-wakespeed-testing/cover.jpeg

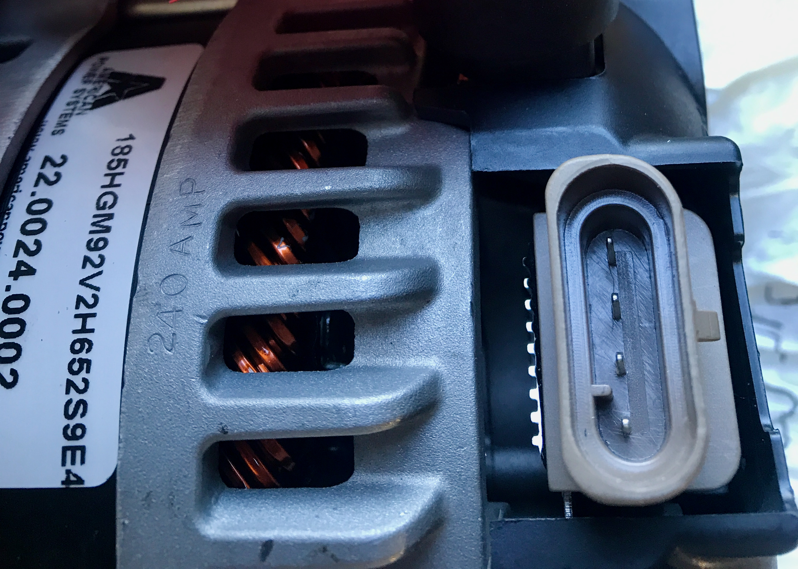
blog/2022-6-16-wakespeed-testing/cover.jpeg
