natecostello/van_two_point_oh/blog/2023-6-26-bms-failure/Rusalka_20230626-1600_to_20230626-2059.csv

timestamp | Gateway [0] | Gateway [0] | Gateway [0] | Gateway [0] | Gateway [0] | Gateway [0] | Gateway [0] | Gateway [0] | Gateway [0] | VE.Bus System [276] | VE.Bus System [276] | VE.Bus System [276] | VE.Bus System [276] | VE.Bus System [276] | VE.Bus System [276] | VE.Bus System [276] | VE.Bus System [276] | VE.Bus System [276] | VE.Bus System [276] | VE.Bus System [276] | VE.Bus System [276] | VE.Bus System [276] | VE.Bus System [276] | VE.Bus System [276] | VE.Bus System [276] | VE.Bus System [276] | VE.Bus System [276] | VE.Bus System [276] | VE.Bus System [276] | VE.Bus System [276] | VE.Bus System [276] | VE.Bus System [276] | VE.Bus System [276] | VE.Bus System [276] | VE.Bus System [276] | VE.Bus System [276] | VE.Bus System [276] | VE.Bus System [276] | VE.Bus System [276] | VE.Bus System [276] | VE.Bus System [276] | VE.Bus System [276] | VE.Bus System [276] | VE.Bus System [276] | VE.Bus System [276] | VE.Bus System [276] | Battery Monitor [512] | Battery Monitor [512] | Battery Monitor [512] | Battery Monitor [512] | Battery Monitor [512] | Battery Monitor [512] | Battery Monitor [512] | Battery Monitor [512] | Battery Monitor [512] | Battery Monitor [512] | Battery Monitor [512] | Battery Monitor [512] | Battery Monitor [512]
America/Indianapolis (-04:00) | VRM Log time offset | ESS Scheduled Charging | Relay 1 state | CCGX Relay 2 state | Generator run reason | Relay 1 function | Relay 2 function | Solar Irradiance | Solar Irradiance Forecast | Phase rotation | Input voltage phase 1 | Input current phase 1 | Input frequency 1 | Input power 1 | Output voltage phase 1 | Output current phase 1 | Output frequency | Output power 1 | Voltage | Current | Battery temperature | Active input | Active input current limit | VE.Bus state | VE.Bus Error | Switch Position | Temperature | Low battery | Overload | Temperatur sensor alarm | Voltage sensor alarm | High DC Ripple | Temperature L1 | Low battery L1 | Overload L1 | High DC Ripple L1 | Temperature L2 | Low battery L2 | Overload L2 | High DC Ripple L2 | Temperature L3 | Low battery L3 | Overload L3 | High DC Ripple L3 | Charge state | Ignore AC input | Minimum cell temperature | Maximum cell temperature | Voltage | Current | Battery temperature | State of charge | State of health | CVL - Charge Voltage Limit | DVL - Discharge Voltage Limit | CCL - Charge Current Limit | DCL - Discharge Current Limit | Low voltage alarm | High voltage alarm
 | s |  |  |  |  |  |  | W/m² | W/m² |  | V | A | Hz | W | V | A | Hz | W | V | A | C |  | A |  |  |  |  |  |  |  |  |  |  |  |  |  |  |  |  |  |  |  |  |  |  |  | C | C | V | A | C | % | % | V | V | A | A
2023-06-26 18:00:00 |  |  |  |  |  |  |  | 526 | 522
2023-06-26 18:00:06 | 2 | Not active | Closed | Closed | Manual start |  |  |  |  | Ok | 0.0 | 0.0 | 0.00 | 0 | 119.7 | 0.7 | 59.9 | 57 | 26.57 | -3.1 | 24 | Disconnected | 13.00 | Inverting | No error | On | Ok | Ok | Ok | Ok | Ok | Ok | Ok | Ok | Ok | Ok | Ok | Ok | Ok | Ok | Ok | Ok | Ok | Ok | Bulk | Not ignored | 26 | 26 | 26.57 | -5.30 | 26 | 96.0 | 100.0 | 27.1 | 23.1 | 0.0 | 279.9 | No alarm | No alarm
2023-06-26 18:00:17 | 0 | Not active | Closed | Closed | Manual start |  |  |  |  | Ok | 0.0 | 0.0 | 0.00 | 0 | 119.7 | 0.7 | 59.9 | 57 | 26.57 | -3.3 | 24 | Disconnected | 13.00 | Inverting | No error | On | Ok | Ok | Ok | Ok | Ok | Ok | Ok | Ok | Ok | Ok | Ok | Ok | Ok | Ok | Ok | Ok | Ok | Ok | Bulk | Not ignored | 26 | 26 | 26.57 | -5.00 | 26 | 96.0 | 100.0 | 27.1 | 23.1 | 0.0 | 279.9 | No alarm | No alarm
2023-06-26 18:00:59 | 2 | Not active | Closed | Closed | Manual start |  |  |  |  | Ok | 0.0 | 0.0 | 0.00 | 0 | 119.5 | 0.7 | 59.9 | 57 | 26.57 | -3.3 | 24 | Disconnected | 13.00 | Inverting | No error | On | Ok | Ok | Ok | Ok | Ok | Ok | Ok | Ok | Ok | Ok | Ok | Ok | Ok | Ok | Ok | Ok | Ok | Ok | Bulk | Not ignored | 26 | 26 | 26.57 | -5.20 | 26 | 96.0 | 100.0 | 27.1 | 23.1 | 0.0 | 279.9 | No alarm | No alarm
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
2023-06-26 18:20:00 | 2 | Not active | Closed | Closed | Manual start |  |  |  |  | Ok | 0.0 | 0.0 | 0.00 | 0 | 119.7 | 0.7 | 59.9 | 57 | 26.57 | -3.3 | 24 | Disconnected | 13.00 | Inverting | No error | On | Ok | Ok | Ok | Ok | Ok | Ok | Ok | Ok | Ok | Ok | Ok | Ok | Ok | Ok | Ok | Ok | Ok | Ok | Bulk | Not ignored | 26 | 26 | 26.57 | -5.10 | 26 | 96.0 | 100.0 | 27.1 | 23.1 | 0.0 | 279.9 | No alarm | No alarm
2023-06-26 18:20:59 | 1 | Not active | Closed | Closed | Manual start |  |  |  |  | Ok | 0.0 | 0.0 | 0.00 | 0 | 119.9 | 0.7 | 60.1 | 57 | 26.58 | -3.3 | 24 | Disconnected | 13.00 | Inverting | No error | On | Ok | Ok | Ok | Ok | Ok | Ok | Ok | Ok | Ok | Ok | Ok | Ok | Ok | Ok | Ok | Ok | Ok | Ok | Bulk | Not ignored | 26 | 26 | 26.57 | -4.90 | 26 | 95.0 | 100.0 | 27.1 | 23.1 | 0.0 | 279.9 | No alarm | No alarm
2023-06-26 18:21:59 | 2 | Not active | Closed | Closed | Manual start |  |  |  |  | Ok | 0.0 | 0.0 | 0.00 | 0 | 119.7 | 0.7 | 59.9 | 57 | 26.57 | -3.2 | 24 | Disconnected | 13.00 | Inverting | No error | On | Ok | Ok | Ok | Ok | Ok | Ok | Ok | Ok | Ok | Ok | Ok | Ok | Ok | Ok | Ok | Ok | Ok | Ok | Bulk | Not ignored | 26 | 26 | 26.57 | -4.90 | 26 | 95.0 | 100.0 | 27.1 | 23.1 | 0.0 | 279.9 | No alarm | No alarm
2023-06-26 18:22:49 | 1 |  |  |  |  | Generator start/stop | Manual
2023-06-26 18:22:59 | 1 | Not active | Closed | Closed | Manual start |  |  |  |  | Ok | 0.0 | 0.0 | 0.00 | 0 | 119.7 | 0.7 | 59.9 | 57 | 26.57 | -3.3 | 24 | Disconnected | 13.00 | Inverting | No error | On | Ok | Ok | Ok | Ok | Ok | Ok | Ok | Ok | Ok | Ok | Ok | Ok | Ok | Ok | Ok | Ok | Ok | Ok | Bulk | Not ignored | 26 | 26 | 26.57 | -4.90 | 26 | 95.0 | 100.0 | 27.1 | 23.1 | 0.0 | 279.9 | No alarm | No alarm
2023-06-26 18:23:59 | 1 | Not active | Closed | Closed | Manual start |  |  |  |  | Ok | 0.0 | 0.0 | 0.00 | 0 | 119.9 | 0.7 | 59.9 | 57 | 26.58 | -3.3 | 24 | Disconnected | 13.00 | Inverting | No error | On | Ok | Ok | Ok | Ok | Ok | Ok | Ok | Ok | Ok | Ok | Ok | Ok | Ok | Ok | Ok | Ok | Ok | Ok | Bulk | Not ignored | 26 | 26 | 26.57 | -5.00 | 26 | 95.0 | 100.0 | 27.1 | 23.1 | 0.0 | 279.9 | No alarm | No alarm
2023-06-26 18:24:42 | 1 | Not active | Closed | Closed | Manual start |  |  |  |  | Ok | 0.0 | 0.0 | 0.00 | 0 | 119.9 | 0.7 | 60.1 | 57 | 26.57 | -3.2 | 24 | Disconnected | 13.00 | Inverting | No error | On | Ok | Ok | Ok | Ok | Ok | Ok | Ok | Ok | Ok | Ok | Ok | Ok | Ok | Ok | Ok | Ok | Ok | Ok | Bulk | Not ignored | 26 | 26 | 26.57 | -5.10 | 26 | 95.0 | 100.0 | 27.1 | 23.1 | 0.0 | 279.9 | No alarm | No alarm
2023-06-26 18:24:46 | 1 |  |  |  |  | Generator start/stop | Manual
2023-06-26 18:25:00 | 2 | Not active | Closed | Closed | Manual start |  |  |  |  | Ok | 0.0 | 0.0 | 0.00 | 0 | 119.7 | 0.7 | 60.1 | 57 | 26.57 | -3.3 | 24 | Disconnected | 13.00 | Inverting | No error | On | Ok | Ok | Ok | Ok | Ok | Ok | Ok | Ok | Ok | Ok | Ok | Ok | Ok | Ok | Ok | Ok | Ok | Ok | Bulk | Not ignored | 26 | 26 | 26.57 | -5.10 | 26 | 95.0 | 100.0 | 27.1 | 23.1 | 0.0 | 279.9 | No alarm | No alarm
2023-06-26 18:25:59 | 1 | Not active | Closed | Closed | Manual start |  |  |  |  | Ok | 0.0 | 0.0 | 0.00 | 0 | 119.9 | 0.7 | 60.1 | 57 | 26.57 | -3.2 | 24 | Disconnected | 13.00 | Inverting | No error | On | Ok | Ok | Ok | Ok | Ok | Ok | Ok | Ok | Ok | Ok | Ok | Ok | Ok | Ok | Ok | Ok | Ok | Ok | Bulk | Not ignored | 26 | 26 | 26.57 | -3.70 | 26 | 95.0 | 100.0 | 27.1 | 23.1 | 0.0 | 279.9 | No alarm | No alarm
2023-06-26 18:27:00 | 1 | Not active | Closed | Closed | Manual start |  |  |  |  | Ok | 0.0 | 0.0 | 0.00 | 0 | 119.9 | 0.7 | 59.9 | 57 | 26.57 | -3.3 | 24 | Disconnected | 13.00 | Inverting | No error | On | Ok | Ok | Ok | Ok | Ok | Ok | Ok | Ok | Ok | Ok | Ok | Ok | Ok | Ok | Ok | Ok | Ok | Ok | Bulk | Not ignored | 26 | 26 | 26.57 | -3.60 | 26 | 95.0 | 100.0 | 27.1 | 23.1 | 0.0 | 279.9 | No alarm | No alarm
2023-06-26 18:28:00 | 1 | Not active | Closed | Closed | Manual start |  |  |  |  | Ok | 0.0 | 0.0 | 0.00 | 0 | 119.9 | 0.7 | 59.9 | 57 | 26.57 | -3.3 | 24 | Disconnected | 13.00 | Inverting | No error | On | Ok | Ok | Ok | Ok | Ok | Ok | Ok | Ok | Ok | Ok | Ok | Ok | Ok | Ok | Ok | Ok | Ok | Ok | Bulk | Not ignored | 26 | 26 | 26.57 | -3.20 | 26 | 95.0 | 100.0 | 27.1 | 23.1 | 0.0 | 279.9 | No alarm | No alarm
2023-06-26 18:28:59 | 2 | Not active | Closed | Closed | Manual start |  |  |  |  | Ok | 0.0 | 0.0 | 0.00 | 0 | 119.9 | 0.7 | 59.9 | 57 | 26.57 | -3.3 | 24 | Disconnected | 13.00 | Inverting | No error | On | Ok | Ok | Ok | Ok | Ok | Ok | Ok | Ok | Ok | Ok | Ok | Ok | Ok | Ok | Ok | Ok | Ok | Ok | Bulk | Not ignored | 26 | 26 | 26.57 | -3.40 | 26 | 95.0 | 100.0 | 27.1 | 23.1 | 0.0 | 279.9 | No alarm | No alarm
2023-06-26 18:29:09 | 1 |  |  |  |  | Generator start/stop | Manual
2023-06-26 18:29:59 | 1 | Not active | Closed | Closed | Manual start |  |  |  |  | Ok | 0.0 | 0.0 | 0.00 | 0 | 119.9 | 0.7 | 60.1 | 57 | 26.57 | -3.3 | 24 | Disconnected | 13.00 | Inverting | No error | On | Ok | Ok | Ok | Ok | Ok | Ok | Ok | Ok | Ok | Ok | Ok | Ok | Ok | Ok | Ok | Ok | Ok | Ok | Bulk | Not ignored | 26 | 26 | 26.57 | -3.80 | 26 | 95.0 | 100.0 | 27.1 | 23.1 | 0.0 | 279.9 | No alarm | No alarm
2023-06-26 18:30:36 | 1 | Not active | Closed | Closed | Manual start |  |  |  |  | Ok | 0.0 | 0.0 | 0.00 | 0 | 119.9 | 0.7 | 59.9 | 57 | 26.57 | -3.2 | 24 | Disconnected | 13.00 | Inverting | No error | On | Ok | Ok | Ok | Ok | Ok | Ok | Ok | Ok | Ok | Ok | Ok | Ok | Ok | Ok | Ok | Ok | Ok | Ok | Bulk | Not ignored | 26 | 26 | 26.57 | -3.40 | 26 | 95.0 | 100.0 | 27.1 | 23.1 | 0.0 | 279.9 | No alarm | No alarm
2023-06-26 18:30:40 | 1 |  |  |  |  | Generator start/stop | Manual
2023-06-26 18:31:00 | 2 | Not active | Closed | Closed | Manual start |  |  |  |  | Ok | 0.0 | 0.0 | 0.00 | 0 | 119.9 | 0.7 | 60.1 | 57 | 26.57 | -3.3 | 24 | Disconnected | 13.00 | Inverting | No error | On | Ok | Ok | Ok | Ok | Ok | Ok | Ok | Ok | Ok | Ok | Ok | Ok | Ok | Ok | Ok | Ok | Ok | Ok | Bulk | Not ignored | 26 | 26 | 26.57 | -3.20 | 26 | 95.0 | 100.0 | 27.1 | 23.1 | 0.0 | 279.9 | No alarm | No alarm
2023-06-26 18:32:00 | 0 | Not active | Closed | Closed | Manual start |  |  |  |  | Ok | 0.0 | 0.0 | 0.00 | 0 | 119.9 | 0.7 | 60.1 | 56 | 26.57 | -3.3 | 24 | Disconnected | 13.00 | Inverting | No error | On | Ok | Ok | Ok | Ok | Ok | Ok | Ok | Ok | Ok | Ok | Ok | Ok | Ok | Ok | Ok | Ok | Ok | Ok | Bulk | Not ignored | 26 | 26 | 26.58 | -3.40 | 26 | 95.0 | 100.0 | 27.1 | 23.1 | 0.0 | 279.9 | No alarm | No alarm
2023-06-26 18:33:00 | 1 | Not active | Closed | Closed | Manual start |  |  |  |  | Ok | 0.0 | 0.0 | 0.00 | 0 | 119.7 | 0.7 | 60.1 | 57 | 26.58 | -3.1 | 24 | Disconnected | 13.00 | Inverting | No error | On | Ok | Ok | Ok | Ok | Ok | Ok | Ok | Ok | Ok | Ok | Ok | Ok | Ok | Ok | Ok | Ok | Ok | Ok | Bulk | Not ignored | 26 | 26 | 26.58 | -3.80 | 26 | 95.0 | 100.0 | 27.1 | 23.1 | 0.0 | 279.9 | No alarm | No alarm
2023-06-26 18:34:00 | 2 | Not active | Closed | Closed | Manual start |  |  |  |  | Ok | 0.0 | 0.0 | 0.00 | 0 | 119.7 | 0.7 | 59.9 | 57 | 26.58 | -3.3 | 24 | Disconnected | 13.00 | Inverting | No error | On | Ok | Ok | Ok | Ok | Ok | Ok | Ok | Ok | Ok | Ok | Ok | Ok | Ok | Ok | Ok | Ok | Ok | Ok | Bulk | Not ignored | 26 | 26 | 26.58 | -3.30 | 26 | 95.0 | 100.0 | 27.1 | 23.1 | 0.0 | 279.9 | No alarm | No alarm
2023-06-26 18:34:14 | 576 | Not active | Closed | Closed | Manual start |  |  |  |  | Ok | 0.0 | 0.0 | 0.00 | 0 | 102.8 | 0.9 | 60.1 | 57 | 25.03 | -3.3 | 24 | Disconnected | 13.00 | Off | No error | On | Ok | Alarm | Ok | Ok | Ok | Ok | Ok | Alarm | Ok | Ok | Ok | Ok | Ok | Ok | Ok | Ok | Ok | Ok | Bulk | Not ignored | 26 | 26 | 26.58 | -3.60 | 26 | 95.0 | 100.0 | 27.1 | 23.1 | 0.0 | 279.9 | No alarm | No alarm
2023-06-26 18:34:15 | 575 | Not active | Closed | Closed | Manual start |  |  |  |  | Ok | 0.0 | 0.0 | 0.00 | 0 | 102.8 | 0.9 | 60.1 | 57 | 25.03 | -3.3 | 24 | Disconnected | 13.00 | Off | No error | On | Ok | Alarm | Ok | Ok | Ok | Ok | Ok | Alarm | Ok | Ok | Ok | Ok | Ok | Ok | Ok | Ok | Ok | Ok | Bulk | Not ignored | 26 | 26 | 26.58 | -3.60 | 26 | 95.0 | 100.0 | 27.1 | 23.1 | 0.0 | 279.9 | No alarm | No alarm
2023-06-26 18:34:17 | 572 | Not active | Closed | Closed | Manual start |  |  |  |  | Ok | 0.0 | 0.0 | 0.00 | 0 | 0.0 | 0.0 | 59.9 | 54 | 21.43 | 0.0 | 24 | Disconnected | 13.00 | Off | No error | On | Ok | Alarm | Ok | Ok | Ok | Ok | Ok | Alarm | Ok | Ok | Ok | Ok | Ok | Ok | Ok | Ok | Ok | Ok | Bulk | Not ignored | 26 | 26 | 26.58 | -3.60 | 26 | 95.0 | 100.0 | 27.1 | 23.1 | 0.0 | 279.9 | No alarm | No alarm
2023-06-26 18:34:18 | 571 | Not active | Closed | Closed | Manual start |  |  |  |  | Ok | 0.0 | 0.0 | 0.00 | 0 | 0.0 | 0.0 | 59.9 | 54 | 21.43 | 0.0 | 24 | Disconnected | 13.00 | Off | No error | On | Ok | Alarm | Ok | Ok | Ok | Ok | Ok | Alarm | Ok | Ok | Ok | Ok | Ok | Ok | Ok | Ok | Ok | Ok | Bulk | Not ignored
2023-06-26 18:34:19 | 570 |  |  |  |  | Generator start/stop | Manual
2023-06-26 18:34:20 | 569 | Not active | Closed | Closed | Manual start |  |  |  |  | Ok | 0.0 | 0.0 | 0.00 | 0 | 0.0 | 0.0 | 59.9 | 0 | 24.74 | 0.0 | 24 | Disconnected | 13.00 | Off | No error | On | Ok | Alarm | Ok | Ok | Ok | Ok | Ok | Alarm | Ok | Ok | Ok | Ok | Ok | Ok | Ok | Ok | Ok | Ok | Bulk | Not ignored | 26 | 26 | 26.59 | 0.00 | 26 | 95.0 | 100.0 | 27.6 | 23.1 | 41.9 | 279.9 | No alarm | No alarm
2023-06-26 18:34:23 | 566 | Not active | Closed | Closed | Manual start |  |  |  |  | Ok | 0.0 | 0.0 | 0.00 | 0 | 0.0 | 0.0 | 59.9 | 0 | 18.77 | 0.0 | 24 | Disconnected | 13.00 | Off | No error | On | Ok | Alarm | Ok | Ok | Ok | Ok | Ok | Alarm | Ok | Ok | Ok | Ok | Ok | Ok | Ok | Ok | Ok | Ok | Bulk | Not ignored | 26 | 26 | 26.59 | 0.00 | 26 | 95.0 | 100.0 | 27.6 | 23.1 | 43.9 | 279.9 | No alarm | No alarm
2023-06-26 18:34:25 | 564 |  |  |  |  | Generator start/stop | Manual
2023-06-26 18:34:26 | 563 | Not active | Closed | Closed | Manual start |  |  |  |  | Ok | 0.0 | 0.0 | 0.00 | 0 | 0.0 | 0.0 | 60.1 | 0 | 26.71 | 0.0 | 24 | Disconnected | 13.00 | Off | No error | On | Ok | Alarm | Ok | Ok | Ok | Ok | Ok | Alarm | Ok | Ok | Ok | Ok | Ok | Ok | Ok | Ok | Ok | Ok | Bulk | Not ignored | 26 | 26 | 26.59 | 0.00 | 26 | 95.0 | 100.0 | 27.6 | 23.1 | 45.9 | 279.9 | No alarm | No alarm
2023-06-26 18:34:27 | 562 | Not active | Closed | Closed | Manual start |  |  |  |  | Ok | 0.0 | 0.0 | 0.00 | 0 | 0.0 | 0.0 | 60.1 | 0 | 26.38 | 0.0 | 24 | Disconnected | 13.00 | Off | No error | On | Ok | Alarm | Ok | Ok | Ok | Ok | Ok | Alarm | Ok | Ok | Ok | Ok | Ok | Ok | Ok | Ok | Ok | Ok | Bulk | Not ignored | 26 | 26 | 26.60 | 0.00 | 26 | 95.0 | 100.0 | 27.6 | 23.1 | 45.9 | 279.9 | No alarm | No alarm
2023-06-26 18:34:32 | 557 | Not active | Closed | Closed | Manual start |  |  |  |  | Ok | 0.0 | 0.0 | 0.00 | 0 | 0.0 | 0.0 | 60.1 | 0 | 26.80 | 0.0 | 24 | Disconnected | 13.00 | Off | No error | On | Ok | Alarm | Ok | Ok | Ok | Ok | Ok | Alarm | Ok | Ok | Ok | Ok | Ok | Ok | Ok | Ok | Ok | Ok | Bulk | Not ignored
2023-06-26 18:34:34 | 555 | Not active | Closed | Closed | Manual start |  |  |  |  | Ok | 0.0 | 0.0 | 0.00 | 0 | 0.0 | 0.0 | 59.9 | 0 | 27.24 | 0.0 | 24 | Disconnected | 13.00 | Off | No error | On | Ok | Alarm | Ok | Ok | Ok | Ok | Ok | Alarm | Ok | Ok | Ok | Ok | Ok | Ok | Ok | Ok | Ok | Ok | Bulk | Not ignored | 26 | 26 | 26.60 | 0.00 | 26 | 95.0 | 100.0 | 27.6 | 23.1 | 41.9 | 279.9 | No alarm | No alarm
2023-06-26 18:34:35 | 554 | Not active | Closed | Closed | Manual start |  |  |  |  | Ok | 0.0 | 0.0 | 0.00 | 0 | 0.0 | 0.0 | 59.9 | 0 | 27.24 | 0.0 | 24 | Disconnected | 13.00 | Off | No error | On | Ok | Alarm | Ok | Ok | Ok | Ok | Ok | Alarm | Ok | Ok | Ok | Ok | Ok | Ok | Ok | Ok | Ok | Ok | Bulk | Not ignored | 26 | 26 | 26.60 | 0.00 | 26 | 95.0 | 100.0 | 27.6 | 23.1 | 41.9 | 279.9 | No alarm | No alarm
2023-06-26 18:34:37 | 552 | Not active | Closed | Closed | Manual start | Generator start/stop | Manual |  |  | Ok | 0.0 | 0.0 | 0.00 | 0 | 0.0 | 0.0 | 59.9 | 0 | 26.46 | 0.0 | 24 | Disconnected | 13.00 | Off | No error | On | Ok | Alarm | Ok | Ok | Ok | Ok | Ok | Alarm | Ok | Ok | Ok | Ok | Ok | Ok | Ok | Ok | Ok | Ok | Bulk | Not ignored | 26 | 26 | 26.60 | 0.00 | 26 | 95.0 | 100.0 | 27.6 | 23.1 | 43.9 | 279.9 | No alarm | No alarm
2023-06-26 18:34:40 | 549 | Not active | Closed | Closed | Manual start |  |  |  |  | Ok | 0.0 | 0.0 | 0.00 | 0 | 0.0 | 0.0 | 59.9 | 0 | 26.84 | 0.0 | 24 | Disconnected | 13.00 | Off | No error | On | Ok | Alarm | Ok | Ok | Ok | Ok | Ok | Alarm | Ok | Ok | Ok | Ok | Ok | Ok | Ok | Ok | Ok | Ok | Bulk | Not ignored | 26 | 26 | 26.60 | 0.00 | 26 | 95.0 | 100.0 | 27.6 | 23.1 | 44.9 | 279.9 | No alarm | No alarm
2023-06-26 18:34:44 | 545 | Not active | Closed | Closed | Manual start |  |  |  |  | Ok | 0.0 | 0.0 | 0.00 | 0 | 0.0 | 0.0 | 59.9 | 0 | 25.28 | 0.0 | 24 | Disconnected | 13.00 | Inverting | No error | On | Ok | Alarm | Ok | Ok | Ok | Ok | Ok | Alarm | Ok | Ok | Ok | Ok | Ok | Ok | Ok | Ok | Ok | Ok | Bulk | Not ignored | 26 | 26 | 26.63 | 17.40 | 26 | 95.0 | 100.0 | 27.6 | 23.1 | 46.9 | 279.9 | No alarm | No alarm
2023-06-26 18:34:45 | 544 | Not active | Closed | Closed | Manual start |  |  |  |  | Ok | 0.0 | 0.0 | 0.00 | 0 | 119.3 | 0.6 | 59.9 | 0 | 26.61 | -1.7 | 24 | Disconnected | 13.00 | Inverting | No error | On | Ok | Alarm | Ok | Ok | Ok | Ok | Ok | Alarm | Ok | Ok | Ok | Ok | Ok | Ok | Ok | Ok | Ok | Ok | Bulk | Not ignored | 26 | 26 | 26.63 | 16.50 | 26 | 95.0 | 100.0 | 27.6 | 23.1 | 48.9 | 279.9 | No alarm | No alarm
2023-06-26 18:34:47 | 542 | Not active | Closed | Closed | Manual start |  |  |  |  | Ok | 0.0 | 0.0 | 0.00 | 0 | 119.3 | 0.6 | 59.9 | 0 | 26.61 | -1.7 | 24 | Disconnected | 13.00 | Inverting | No error | On | Ok | Alarm | Ok | Ok | Ok | Ok | Ok | Alarm | Ok | Ok | Ok | Ok | Ok | Ok | Ok | Ok | Ok | Ok | Bulk | Not ignored | 26 | 26 | 26.63 | 15.70 | 26 | 95.0 | 100.0 | 27.6 | 23.1 | 49.9 | 279.9 | No alarm | No alarm
2023-06-26 18:34:48 | 541 | Not active | Closed | Closed | Manual start |  |  |  |  | Ok | 0.0 | 0.0 | 0.00 | 0 | 120.1 | 0.4 | 60.1 | 20 | 26.65 | -2.4 | 24 | Disconnected | 13.00 | Inverting | No error | On | Ok | Warning | Ok | Ok | Ok | Ok | Ok | Warning | Ok | Ok | Ok | Ok | Ok | Ok | Ok | Ok | Ok | Ok | Bulk | Not ignored | 26 | 26 | 26.64 | 14.80 | 26 | 95.0 | 100.0 | 27.6 | 23.1 | 50.9 | 279.9 | No alarm | No alarm
2023-06-26 18:35:00 | 530 | Not active | Closed | Closed | Manual start |  |  |  |  | Ok | 0.0 | 0.0 | 0.00 | 0 | 119.9 | 0.8 | 59.9 | 58 | 26.58 | -3.3 | 24 | Disconnected | 13.00 | Inverting | No error | On | Ok | Warning | Ok | Ok | Ok | Ok | Ok | Warning | Ok | Ok | Ok | Ok | Ok | Ok | Ok | Ok | Ok | Ok | Bulk | Not ignored | 26 | 26 | 26.71 | 35.60 | 26 | 95.0 | 100.0 | 27.6 | 23.1 | 58.9 | 279.9 | No alarm | No alarm
2023-06-26 18:35:06 | 524 | Not active | Closed | Closed | Manual start |  |  |  |  | Ok | 0.0 | 0.0 | 0.00 | 0 | 119.7 | 0.8 | 60.1 | 60 | 26.63 | -3.3 | 24 | Disconnected | 13.00 | Inverting | No error | On | Ok | Ok | Ok | Ok | Ok | Ok | Ok | Ok | Ok | Ok | Ok | Ok | Ok | Ok | Ok | Ok | Ok | Ok | Bulk | Not ignored | 26 | 26 | 26.67 | 81.60 | 26 | 95.0 | 100.0 | 27.6 | 23.1 | 61.9 | 279.9 | No alarm | No alarm
2023-06-26 18:35:07 | 523 | Not active | Closed | Closed | Manual start |  |  |  |  | Ok | 0.0 | 0.0 | 0.00 | 0 | 120.3 | 0.8 | 60.1 | 59 | 26.64 | -3.3 | 24 | Disconnected | 13.00 | Inverting | No error | On | Ok | Ok | Ok | Ok | Ok | Ok | Ok | Ok | Ok | Ok | Ok | Ok | Ok | Ok | Ok | Ok | Ok | Ok | Bulk | Not ignored | 26 | 26 | 26.78 | 37.10 | 26 | 95.0 | 100.0 | 27.6 | 23.1 | 62.9 | 279.9 | No alarm | No alarm
2023-06-26 18:35:17 | 513 | Not active | Closed | Closed | Manual start |  |  |  |  | Ok | 0.0 | 0.0 | 0.00 | 0 | 119.5 | 0.8 | 59.9 | 59 | 26.84 | -3.3 | 24 | Disconnected | 13.00 | Inverting | No error | On | Ok | Ok | Ok | Ok | Ok | Ok | Ok | Ok | Ok | Ok | Ok | Ok | Ok | Ok | Ok | Ok | Ok | Ok | Bulk | Not ignored | 26 | 26 | 26.69 | 30.00 | 26 | 95.0 | 100.0 | 27.6 | 23.1 | 69.9 | 279.9 | No alarm | No alarm
2023-06-26 18:35:27 | 503 | Not active | Closed | Closed | Manual start |  |  |  |  | Ok | 0.0 | 0.0 | 0.00 | 0 | 119.5 | 0.8 | 60.1 | 59 | 26.56 | -3.3 | 24 | Disconnected | 13.00 | Inverting | No error | On | Ok | Ok | Ok | Ok | Ok | Ok | Ok | Ok | Ok | Ok | Ok | Ok | Ok | Ok | Ok | Ok | Ok | Ok | Bulk | Not ignored | 26 | 26 | 26.88 | 89.60 | 26 | 95.0 | 100.0 | 27.6 | 23.1 | 76.9 | 279.9 | No alarm | No alarm
2023-06-26 18:35:47 | 483 | Not active | Closed | Closed | Manual start |  |  |  |  | Ok | 0.0 | 0.0 | 0.00 | 0 | 119.9 | 0.8 | 60.1 | 58 | 26.86 | -3.3 | 24 | Disconnected | 13.00 | Inverting | No error | On | Ok | Ok | Ok | Ok | Ok | Ok | Ok | Ok | Ok | Ok | Ok | Ok | Ok | Ok | Ok | Ok | Ok | Ok | Bulk | Not ignored | 26 | 26 | 26.90 | 97.30 | 26 | 95.0 | 100.0 | 27.6 | 23.1 | 90.9 | 279.9 | No alarm | No alarm
2023-06-26 18:35:59 | 471 | Not active | Closed | Closed | Manual start |  |  |  |  | Ok | 0.0 | 0.0 | 0.00 | 0 | 120.3 | 0.7 | 60.1 | 59 | 26.85 | -3.3 | 24 | Disconnected | 13.00 | Inverting | No error | On | Ok | Ok | Ok | Ok | Ok | Ok | Ok | Ok | Ok | Ok | Ok | Ok | Ok | Ok | Ok | Ok | Ok | Ok | Bulk | Not ignored | 26 | 26 | 26.98 | 110.60 | 26 | 95.0 | 100.0 | 27.6 | 23.1 | 98.9 | 279.9 | No alarm | No alarm
2023-06-26 18:36:16 | 454 | Not active | Closed | Closed | Manual start |  |  |  |  | Ok | 0.0 | 0.0 | 0.00 | 0 | 120.3 | 0.8 | 59.9 | 58 | 27.14 | -3.3 | 24 | Disconnected | 13.00 | Inverting | No error | On | Ok | Ok | Ok | Ok | Ok | Ok | Ok | Ok | Ok | Ok | Ok | Ok | Ok | Ok | Ok | Ok | Ok | Ok | Bulk | Not ignored | 26 | 26 | 26.88 | 31.20 | 26 | 95.0 | 100.0 | 27.6 | 23.1 | 109.9 | 279.9 | No alarm | No alarm
2023-06-26 18:36:26 | 444 | Not active | Closed | Closed | Manual start |  |  |  |  | Ok | 0.0 | 0.0 | 0.00 | 0 | 120.3 | 0.7 | 60.1 | 58 | 27.18 | -3.2 | 24 | Disconnected | 13.00 | Inverting | No error | On | Ok | Ok | Ok | Ok | Ok | Ok | Ok | Ok | Ok | Ok | Ok | Ok | Ok | Ok | Ok | Ok | Ok | Ok | Bulk | Not ignored | 26 | 26 | 26.99 | 82.10 | 26 | 95.0 | 100.0 | 27.6 | 23.1 | 116.9 | 279.9 | No alarm | No alarm
2023-06-26 18:36:57 | 414 | Not active | Closed | Closed | Manual start |  |  |  |  | Ok | 0.0 | 0.0 | 0.00 | 0 | 120.3 | 0.7 | 59.9 | 58 | 26.77 | -3.3 | 25 | Disconnected | 13.00 | Inverting | No error | On | Ok | Ok | Ok | Ok | Ok | Ok | Ok | Ok | Ok | Ok | Ok | Ok | Ok | Ok | Ok | Ok | Ok | Ok | Bulk | Not ignored | 26 | 26 | 27.05 | 59.30 | 26 | 96.0 | 100.0 | 27.6 | 23.1 | 136.9 | 279.9 | No alarm | No alarm
2023-06-26 18:37:00 | 411 | Not active | Closed | Closed | Manual start |  |  |  |  | Ok | 0.0 | 0.0 | 0.00 | 0 | 120.3 | 0.7 | 59.9 | 59 | 26.95 | -3.2 | 25 | Disconnected | 13.00 | Inverting | No error | On | Ok | Ok | Ok | Ok | Ok | Ok | Ok | Ok | Ok | Ok | Ok | Ok | Ok | Ok | Ok | Ok | Ok | Ok | Bulk | Not ignored | 26 | 26 | 27.09 | 93.00 | 26 | 96.0 | 100.0 | 27.6 | 23.1 | 138.9 | 279.9 | No alarm | No alarm
2023-06-26 18:37:07 | 404 | Not active | Closed | Closed | Manual start |  |  |  |  | Ok | 0.0 | 0.0 | 0.00 | 0 | 120.3 | 0.7 | 59.9 | 58 | 27.18 | -3.3 | 25 | Disconnected | 13.00 | Inverting | No error | On | Ok | Ok | Ok | Ok | Ok | Ok | Ok | Ok | Ok | Ok | Ok | Ok | Ok | Ok | Ok | Ok | Ok | Ok | Bulk | Not ignored | 26 | 26 | 26.98 | 113.00 | 26 | 96.0 | 100.0 | 27.6 | 23.1 | 143.9 | 279.9 | No alarm | No alarm
2023-06-26 18:38:00 | 351 | Not active | Closed | Closed | Manual start |  |  |  |  | Ok | 0.0 | 0.0 | 0.00 | 0 | 119.9 | 0.7 | 59.9 | 58 | 27.42 | -3.2 | 26 | Disconnected | 13.00 | Inverting | No error | On | Ok | Ok | Ok | Ok | Ok | Ok | Ok | Ok | Ok | Ok | Ok | Ok | Ok | Ok | Ok | Ok | Ok | Ok | Bulk | Not ignored | 26 | 26 | 27.40 | 170.80 | 26 | 96.0 | 100.0 | 27.6 | 23.1 | 178.9 | 279.9 | No alarm | No alarm
2023-06-26 18:38:27 | 324 | Not active | Closed | Closed | Manual start |  |  |  |  | Ok | 0.0 | 0.0 | 0.00 | 0 | 120.1 | 0.7 | 59.9 | 58 | 27.45 | -3.2 | 26 | Disconnected | 13.00 | Inverting | No error | On | Ok | Ok | Ok | Ok | Ok | Ok | Ok | Ok | Ok | Ok | Ok | Ok | Ok | Ok | Ok | Ok | Ok | Ok | Bulk | Not ignored | 26 | 27 | 27.45 | 178.30 | 27 | 96.0 | 100.0 | 27.6 | 23.1 | 196.9 | 279.9 | No alarm | No alarm
2023-06-26 18:38:37 | 314 | Not active | Closed | Closed | Manual start |  |  |  |  | Ok | 0.0 | 0.0 | 0.00 | 0 | 120.3 | 0.7 | 59.9 | 58 | 27.45 | -3.2 | 26 | Disconnected | 13.00 | Inverting | No error | On | Ok | Ok | Ok | Ok | Ok | Ok | Ok | Ok | Ok | Ok | Ok | Ok | Ok | Ok | Ok | Ok | Ok | Ok | Bulk | Not ignored | 26 | 27 | 27.45 | 177.10 | 27 | 96.0 | 100.0 | 27.6 | 23.1 | 203.9 | 279.9 | No alarm | No alarm
2023-06-26 18:39:00 | 291 | Not active | Closed | Closed | Manual start |  |  |  |  | Ok | 0.0 | 0.0 | 0.00 | 0 | 120.1 | 0.7 | 60.1 | 58 | 27.45 | -3.2 | 26 | Disconnected | 13.00 | Inverting | No error | On | Ok | Ok | Ok | Ok | Ok | Ok | Ok | Ok | Ok | Ok | Ok | Ok | Ok | Ok | Ok | Ok | Ok | Ok | Bulk | Not ignored | 26 | 27 | 27.45 | 174.50 | 27 | 96.0 | 100.0 | 27.6 | 23.1 | 218.9 | 279.9 | No alarm | No alarm
2023-06-26 18:39:07 | 284 | Not active | Closed | Closed | Manual start |  |  |  |  | Ok | 0.0 | 0.0 | 0.00 | 0 | 120.1 | 0.7 | 60.1 | 57 | 27.45 | -3.1 | 26 | Disconnected | 13.00 | Inverting | No error | On | Ok | Ok | Ok | Ok | Ok | Ok | Ok | Ok | Ok | Ok | Ok | Ok | Ok | Ok | Ok | Ok | Ok | Ok | Bulk | Not ignored | 26 | 27 | 27.45 | 174.20 | 27 | 97.0 | 100.0 | 27.6 | 23.1 | 223.9 | 279.9 | No alarm | No alarm
2023-06-26 18:39:17 | 274 | Not active | Closed | Closed | Manual start |  |  |  |  | Ok | 0.0 | 0.0 | 0.00 | 0 | 120.1 | 0.7 | 60.1 | 58 | 27.45 | -3.2 | 26 | Disconnected | 13.00 | Inverting | No error | On | Ok | Ok | Ok | Ok | Ok | Ok | Ok | Ok | Ok | Ok | Ok | Ok | Ok | Ok | Ok | Ok | Ok | Ok | Bulk | Not ignored | 26 | 27 | 27.46 | 173.50 | 27 | 97.0 | 100.0 | 27.6 | 23.1 | 229.9 | 279.9 | No alarm | No alarm
2023-06-26 18:40:00 | 231 | Not active | Closed | Closed | Manual start |  |  |  |  | Ok | 0.0 | 0.0 | 0.00 | 0 | 120.1 | 0.7 | 60.1 | 58 | 27.48 | -3.1 | 26 | Disconnected | 13.00 | Inverting | No error | On | Ok | Ok | Ok | Ok | Ok | Ok | Ok | Ok | Ok | Ok | Ok | Ok | Ok | Ok | Ok | Ok | Ok | Ok | Bulk | Not ignored | 26 | 27 | 27.47 | 170.90 | 27 | 97.0 | 100.0 | 27.6 | 23.1 | 259.9 | 279.9 | No alarm | No alarm
2023-06-26 18:40:48 | 183 | Not active | Closed | Closed | Manual start |  |  |  |  | Ok | 0.0 | 0.0 | 0.00 | 0 | 120.1 | 0.7 | 59.9 | 58 | 27.51 | -3.2 | 26 | Disconnected | 13.00 | Inverting | No error | On | Ok | Ok | Ok | Ok | Ok | Ok | Ok | Ok | Ok | Ok | Ok | Ok | Ok | Ok | Ok | Ok | Ok | Ok | Absorption | Not ignored | 26 | 27 | 27.50 | 170.20 | 27 | 97.0 | 100.0 | 27.6 | 23.1 | 279.9 | 279.9 | No alarm | No alarm
2023-06-26 18:41:00 | 171 | Not active | Closed | Closed | Manual start |  |  |  |  | Ok | 0.0 | 0.0 | 0.00 | 0 | 119.9 | 0.7 | 60.1 | 58 | 27.50 | -3.2 | 27 | Disconnected | 13.00 | Inverting | No error | On | Ok | Ok | Ok | Ok | Ok | Ok | Ok | Ok | Ok | Ok | Ok | Ok | Ok | Ok | Ok | Ok | Ok | Ok | Absorption | Not ignored | 26 | 27 | 27.51 | 169.60 | 27 | 98.0 | 100.0 | 27.6 | 23.1 | 279.9 | 279.9 | No alarm | No alarm
2023-06-26 18:42:00 | 111 | Not active | Closed | Closed | Manual start |  |  |  |  | Ok | 0.0 | 0.0 | 0.00 | 0 | 120.1 | 0.7 | 60.1 | 58 | 27.58 | -3.2 | 28 | Disconnected | 13.00 | Inverting | No error | On | Ok | Ok | Ok | Ok | Ok | Ok | Ok | Ok | Ok | Ok | Ok | Ok | Ok | Ok | Ok | Ok | Ok | Ok | Absorption | Not ignored | 26 | 27 | 27.59 | 167.70 | 28 | 98.0 | 100.0 | 27.1 | 23.1 | 0.0 | 279.9 | No alarm | No alarm
2023-06-26 18:42:02 | 109 | Not active | Closed | Closed | Manual start |  |  |  |  | Ok | 0.0 | 0.0 | 0.00 | 0 | 119.5 | 0.7 | 59.9 | 58 | 27.44 | -3.2 | 28 | Disconnected | 13.00 | Inverting | No error | On | Ok | Ok | Ok | Ok | Ok | Ok | Ok | Ok | Ok | Ok | Ok | Ok | Ok | Ok | Ok | Ok | Ok | Ok | Absorption | Not ignored | 26 | 27 | 27.17 | 13.00 | 28 | 100.0 | 100.0 | 27.1 | 23.1 | 0.0 | 279.9 | No alarm | No alarm
2023-06-26 18:42:07 | 104 | Not active | Closed | Closed | Manual start |  |  |  |  | Ok | 0.0 | 0.0 | 0.00 | 0 | 119.7 | 0.7 | 59.9 | 58 | 27.14 | -3.2 | 28 | Disconnected | 13.00 | Inverting | No error | On | Ok | Ok | Ok | Ok | Ok | Ok | Ok | Ok | Ok | Ok | Ok | Ok | Ok | Ok | Ok | Ok | Ok | Ok | Absorption | Not ignored | 26 | 27 | 27.09 | -2.80 | 28 | 100.0 | 100.0 | 27.1 | 23.1 | 0.0 | 279.9 | No alarm | No alarm
2023-06-26 18:42:17 | 94 | Not active | Closed | Closed | Manual start |  |  |  |  | Ok | 0.0 | 0.0 | 0.00 | 0 | 119.5 | 0.7 | 60.1 | 58 | 26.98 | -3.2 | 28 | Disconnected | 13.00 | Inverting | No error | On | Ok | Ok | Ok | Ok | Ok | Ok | Ok | Ok | Ok | Ok | Ok | Ok | Ok | Ok | Ok | Ok | Ok | Ok | Absorption | Not ignored | 26 | 27 | 26.99 | -4.70 | 28 | 100.0 | 100.0 | 27.1 | 23.1 | 0.0 | 279.9 | No alarm | No alarm
2023-06-26 18:42:37 | 74 | Not active | Closed | Closed | Manual start |  |  |  |  | Ok | 0.0 | 0.0 | 0.00 | 0 | 119.7 | 0.7 | 59.9 | 58 | 26.89 | -3.2 | 27 | Disconnected | 13.00 | Inverting | No error | On | Ok | Ok | Ok | Ok | Ok | Ok | Ok | Ok | Ok | Ok | Ok | Ok | Ok | Ok | Ok | Ok | Ok | Ok | Absorption | Not ignored | 26 | 27 | 26.88 | -4.90 | 28 | 100.0 | 100.0 | 27.1 | 23.1 | 0.0 | 279.9 | No alarm | No alarm
2023-06-26 18:42:47 | 64 | Not active | Closed | Closed | Manual start |  |  |  |  | Ok | 0.0 | 0.0 | 0.00 | 0 | 119.7 | 0.7 | 60.1 | 57 | 26.87 | -3.1 | 27 | Disconnected | 13.00 | Inverting | No error | On | Ok | Ok | Ok | Ok | Ok | Ok | Ok | Ok | Ok | Ok | Ok | Ok | Ok | Ok | Ok | Ok | Ok | Ok | Absorption | Not ignored | 26 | 27 | 26.86 | -4.80 | 28 | 100.0 | 100.0 | 27.1 | 23.1 | 0.0 | 279.9 | No alarm | No alarm
2023-06-26 18:43:00 | 51 | Not active | Closed | Closed | Manual start |  |  |  |  | Ok | 0.0 | 0.0 | 0.00 | 0 | 119.9 | 0.7 | 59.9 | 57 | 26.84 | -3.2 | 26 | Disconnected | 13.00 | Inverting | No error | On | Ok | Ok | Ok | Ok | Ok | Ok | Ok | Ok | Ok | Ok | Ok | Ok | Ok | Ok | Ok | Ok | Ok | Ok | Absorption | Not ignored | 26 | 27 | 26.83 | -4.80 | 28 | 100.0 | 100.0 | 27.1 | 23.1 | 0.0 | 279.9 | No alarm | No alarm
2023-06-26 18:43:17 | 34 | Not active | Closed | Closed | Manual start |  |  |  |  | Ok | 0.0 | 0.0 | 0.00 | 0 | 119.7 | 0.7 | 59.9 | 57 | 26.81 | -3.2 | 26 | Disconnected | 13.00 | Inverting | No error | On | Ok | Ok | Ok | Ok | Ok | Ok | Ok | Ok | Ok | Ok | Ok | Ok | Ok | Ok | Ok | Ok | Ok | Ok | Absorption | Not ignored | 26 | 27 | 26.81 | -5.00 | 28 | 100.0 | 100.0 | 27.1 | 23.1 | 0.0 | 279.9 | No alarm | No alarm
2023-06-26 18:43:27 | 24 | Not active | Closed | Closed | Manual start |  |  |  |  | Ok | 0.0 | 0.0 | 0.00 | 0 | 119.7 | 0.7 | 59.9 | 57 | 26.80 | -3.2 | 26 | Disconnected | 13.00 | Inverting | No error | On | Ok | Ok | Ok | Ok | Ok | Ok | Ok | Ok | Ok | Ok | Ok | Ok | Ok | Ok | Ok | Ok | Ok | Ok | Absorption | Not ignored | 26 | 27 | 26.80 | -4.90 | 28 | 100.0 | 100.0 | 27.1 | 23.1 | 0.0 | 279.9 | No alarm | No alarm
2023-06-26 18:43:56 | 1 | Not active | Closed | Closed | Manual start |  |  |  |  | Ok | 0.0 | 0.0 | 0.00 | 0 | 119.7 | 0.7 | 60.1 | 57 | 26.77 | -3.2 | 26 | Disconnected | 13.00 | Inverting | No error | On | Ok | Ok | Ok | Ok | Ok | Ok | Ok | Ok | Ok | Ok | Ok | Ok | Ok | Ok | Ok | Ok | Ok | Ok | Absorption | Not ignored | 26 | 27 | 26.77 | -4.90 | 28 | 100.0 | 100.0 | 27.1 | 23.1 | 0.0 | 279.9 | No alarm | No alarm
2023-06-26 18:43:59 | 2 | Not active | Closed | Closed | Manual start |  |  |  |  | Ok | 0.0 | 0.0 | 0.00 | 0 | 119.7 | 0.7 | 59.9 | 57 | 26.77 | -3.2 | 26 | Disconnected | 13.00 | Inverting | No error | On | Ok | Ok | Ok | Ok | Ok | Ok | Ok | Ok | Ok | Ok | Ok | Ok | Ok | Ok | Ok | Ok | Ok | Ok | Absorption | Not ignored | 26 | 27 | 26.77 | -4.90 | 28 | 100.0 | 100.0 | 27.1 | 23.1 | 0.0 | 279.9 | No alarm | No alarm
2023-06-26 18:44:07 | 1 | Not active | Closed | Closed | Manual start |  |  |  |  | Ok | 0.0 | 0.0 | 0.00 | 0 | 119.7 | 0.7 | 59.9 | 57 | 26.77 | -3.2 | 26 | Disconnected | 13.00 | Inverting | No error | On | Ok | Ok | Ok | Ok | Ok | Ok | Ok | Ok | Ok | Ok | Ok | Ok | Ok | Ok | Ok | Ok | Ok | Ok | Absorption | Not ignored | 26 | 27 | 26.76 | -4.60 | 28 | 100.0 | 100.0 | 27.1 | 23.1 | 0.0 | 279.9 | No alarm | No alarm
2023-06-26 18:44:37 | 1 | Not active | Closed | Closed | Manual start |  |  |  |  | Ok | 0.0 | 0.0 | 0.00 | 0 | 119.7 | 0.7 | 60.1 | 57 | 26.75 | -3.2 | 26 | Disconnected | 13.00 | Inverting | No error | On | Ok | Ok | Ok | Ok | Ok | Ok | Ok | Ok | Ok | Ok | Ok | Ok | Ok | Ok | Ok | Ok | Ok | Ok | Absorption | Not ignored | 26 | 27 | 26.75 | -4.70 | 28 | 100.0 | 100.0 | 27.1 | 23.1 | 0.0 | 279.9 | No alarm | No alarm
2023-06-26 18:44:56 | 2 | Not active | Closed | Closed | Manual start |  |  |  |  | Ok | 0.0 | 0.0 | 0.00 | 0 | 119.7 | 0.7 | 59.9 | 57 | 26.74 | -3.2 | 26 | Disconnected | 13.00 | Inverting | No error | On | Ok | Ok | Ok | Ok | Ok | Ok | Ok | Ok | Ok | Ok | Ok | Ok | Ok | Ok | Ok | Ok | Ok | Ok | Absorption | Not ignored | 26 | 27 | 26.74 | -4.80 | 28 | 100.0 | 100.0 | 27.1 | 23.1 | 0.0 | 279.9 | No alarm | No alarm
2023-06-26 18:45:00 | 1 | Not active | Closed | Closed | Manual start |  |  |  |  | Ok | 0.0 | 0.0 | 0.00 | 0 | 119.7 | 0.7 | 59.9 | 57 | 26.74 | -3.2 | 26 | Disconnected | 13.00 | Inverting | No error | On | Ok | Ok | Ok | Ok | Ok | Ok | Ok | Ok | Ok | Ok | Ok | Ok | Ok | Ok | Ok | Ok | Ok | Ok | Absorption | Not ignored | 26 | 27 | 26.74 | -4.80 | 28 | 100.0 | 100.0 | 27.1 | 23.1 | 0.0 | 279.9 | No alarm | No alarm
2023-06-26 18:45:19 | 0 |  |  |  |  | Generator start/stop | Manual
2023-06-26 18:45:25 | 2 | Not active | Closed | Closed | Manual start |  |  |  |  | Ok | 0.0 | 0.0 | 0.00 | 0 | 119.5 | 0.7 | 60.1 | 57 | 26.74 | -3.2 | 26 | Disconnected | 13.00 | Inverting | No error | On | Ok | Ok | Ok | Ok | Ok | Ok | Ok | Ok | Ok | Ok | Ok | Ok | Ok | Ok | Ok | Ok | Ok | Ok | Absorption | Not ignored | 26 | 27 | 26.73 | -5.40 | 28 | 100.0 | 100.0 | 27.1 | 23.1 | 0.0 | 279.9 | No alarm | No alarm
2023-06-26 18:45:30 | 1 |  |  |  |  | Generator start/stop | Manual
2023-06-26 18:45:57 | 1 | Not active | Closed | Closed | Manual start |  |  |  |  | Ok | 0.0 | 0.0 | 0.00 | 0 | 119.7 | 0.7 | 60.1 | 58 | 26.72 | -3.2 | 26 | Disconnected | 13.00 | Inverting | No error | On | Ok | Ok | Ok | Ok | Ok | Ok | Ok | Ok | Ok | Ok | Ok | Ok | Ok | Ok | Ok | Ok | Ok | Ok | Absorption | Not ignored | 26 | 27 | 26.72 | -5.10 | 28 | 100.0 | 100.0 | 27.1 | 23.1 | 0.0 | 279.9 | No alarm | No alarm
2023-06-26 18:46:00 | 2 | Not active | Closed | Closed | Manual start |  |  |  |  | Ok | 0.0 | 0.0 | 0.00 | 0 | 119.7 | 0.7 | 60.1 | 57 | 26.72 | -3.2 | 26 | Disconnected | 13.00 | Inverting | No error | On | Ok | Ok | Ok | Ok | Ok | Ok | Ok | Ok | Ok | Ok | Ok | Ok | Ok | Ok | Ok | Ok | Ok | Ok | Absorption | Not ignored | 26 | 27 | 26.72 | -4.90 | 28 | 100.0 | 100.0 | 27.1 | 23.1 | 0.0 | 279.9 | No alarm | No alarm
2023-06-26 18:46:06 | 2 | Not active | Closed | Closed | Manual start |  |  |  |  | Ok | 0.0 | 0.0 | 0.00 | 0 | 119.7 | 0.7 | 59.9 | 57 | 26.72 | -3.2 | 26 | Disconnected | 13.00 | Inverting | No error | On | Ok | Ok | Ok | Ok | Ok | Ok | Ok | Ok | Ok | Ok | Ok | Ok | Ok | Ok | Ok | Ok | Ok | Ok | Absorption | Not ignored | 26 | 27 | 26.72 | -4.80 | 28 | 100.0 | 100.0 | 27.1 | 23.1 | 0.0 | 279.9 | No alarm | No alarm
2023-06-26 18:46:46 | 2 | Not active | Closed | Closed | Manual start |  |  |  |  | Ok | 0.0 | 0.0 | 0.00 | 0 | 119.7 | 0.7 | 60.1 | 57 | 26.72 | -3.2 | 26 | Disconnected | 13.00 | Inverting | No error | On | Ok | Ok | Ok | Ok | Ok | Ok | Ok | Ok | Ok | Ok | Ok | Ok | Ok | Ok | Ok | Ok | Ok | Ok | Absorption | Not ignored | 26 | 27 | 26.71 | -5.00 | 28 | 100.0 | 100.0 | 27.1 | 23.1 | 0.0 | 279.9 | No alarm | No alarm
2023-06-26 18:46:57 | 2 | Not active | Closed | Closed | Manual start |  |  |  |  | Ok | 0.0 | 0.0 | 0.00 | 0 | 119.7 | 0.7 | 60.1 | 57 | 26.71 | -3.2 | 26 | Disconnected | 13.00 | Inverting | No error | On | Ok | Ok | Ok | Ok | Ok | Ok | Ok | Ok | Ok | Ok | Ok | Ok | Ok | Ok | Ok | Ok | Ok | Ok | Absorption | Not ignored | 26 | 27 | 26.70 | -5.00 | 28 | 100.0 | 100.0 | 27.1 | 23.1 | 0.0 | 279.9 | No alarm | No alarm
2023-06-26 18:47:00 | 1 | Not active | Closed | Closed | Manual start |  |  |  |  | Ok | 0.0 | 0.0 | 0.00 | 0 | 119.7 | 0.7 | 60.1 | 57 | 26.71 | -3.2 | 26 | Disconnected | 13.00 | Inverting | No error | On | Ok | Ok | Ok | Ok | Ok | Ok | Ok | Ok | Ok | Ok | Ok | Ok | Ok | Ok | Ok | Ok | Ok | Ok | Absorption | Not ignored | 26 | 27 | 26.71 | -3.80 | 28 | 100.0 | 100.0 | 27.1 | 23.1 | 0.0 | 279.9 | No alarm | No alarm
2023-06-26 18:47:06 | 1 | Not active | Closed | Closed | Manual start |  |  |  |  | Ok | 0.0 | 0.0 | 0.00 | 0 | 119.7 | 0.7 | 59.9 | 57 | 26.71 | -3.2 | 26 | Disconnected | 13.00 | Inverting | No error | On | Ok | Ok | Ok | Ok | Ok | Ok | Ok | Ok | Ok | Ok | Ok | Ok | Ok | Ok | Ok | Ok | Ok | Ok | Absorption | Not ignored | 26 | 27 | 26.71 | -3.40 | 28 | 100.0 | 100.0 | 27.1 | 23.1 | 0.0 | 279.9 | No alarm | No alarm
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
2023-06-26 19:15:05 | 578 | Not active | Closed | Closed | Manual start |  |  |  |  | Ok | 0.0 | 0.0 | 0.00 | 0 | 99.3 | 0.7 | 60.1 | 45 | 23.32 | -2.8 | 26 | Disconnected | 13.00 | Off | No error | On | Ok | Alarm | Ok | Ok | Ok | Ok | Ok | Alarm | Ok | Ok | Ok | Ok | Ok | Ok | Ok | Ok | Ok | Ok | Bulk | Not ignored | 26 | 27 | 26.63 | -3.90 | 27 | 100.0 | 100.0 | 27.1 | 23.1 | 0.0 | 279.9 | No alarm | No alarm
2023-06-26 19:15:07 | 576 | Not active | Closed | Closed | Manual start |  |  |  |  | Ok | 0.0 | 0.0 | 0.00 | 0 | 0.0 | 0.0 | 59.9 | 41 | 13.08 | 0.0 | 26 | Disconnected | 13.00 | Off | No error | On | Ok | Alarm | Ok | Ok | Ok | Ok | Ok | Alarm | Ok | Ok | Ok | Ok | Ok | Ok | Ok | Ok | Ok | Ok | Bulk | Not ignored
2023-06-26 19:15:08 | 575 |  |  |  |  | Generator start/stop | Manual
2023-06-26 19:15:13 | 570 | Not active | Closed | Closed | Manual start |  |  |  |  | Ok | 0.0 | 0.0 | 0.00 | 0 | 0.0 | 0.0 | 59.9 | 0 | 17.32 | 0.0 | 26 | Disconnected | 13.00 | Off | No error | On | Ok | Alarm | Ok | Ok | Ok | Ok | Ok | Alarm | Ok | Ok | Ok | Ok | Ok | Ok | Ok | Ok | Ok | Ok | Bulk | Not ignored
2023-06-26 19:15:16 | 567 | Not active | Closed | Closed | Manual start |  |  |  |  | Ok | 0.0 | 0.0 | 0.00 | 0 | 0.0 | 0.0 | 59.9 | 0 | 18.51 | 0.0 | 26 | Disconnected | 13.00 | Off | No error | On | Ok | Alarm | Ok | Ok | Ok | Ok | Ok | Alarm | Ok | Ok | Ok | Ok | Ok | Ok | Ok | Ok | Ok | Ok | Bulk | Not ignored | 26 | 27 | 26.64 | 0.00 | 27 | 50.0 | 100.0 | 27.6 | 23.1 | 41.9 | 279.9 | No alarm | No alarm
2023-06-26 19:15:18 | 565 | Not active | Closed | Closed | Manual start |  |  |  |  | Ok | 0.0 | 0.0 | 0.00 | 0 | 0.0 | 0.0 | 60.1 | 0 | 21.86 | 0.0 | 26 | Disconnected | 13.00 | Off | No error | On | Ok | Alarm | Ok | Ok | Ok | Ok | Ok | Alarm | Ok | Ok | Ok | Ok | Ok | Ok | Ok | Ok | Ok | Ok | Bulk | Not ignored | 26 | 27 | 26.64 | 0.00 | 27 | 50.0 | 100.0 | 27.6 | 23.1 | 43.9 | 279.9 | No alarm | No alarm
2023-06-26 19:15:21 | 562 | Not active | Closed | Closed | Manual start | Generator start/stop | Manual |  |  | Ok | 0.0 | 0.0 | 0.00 | 0 | 0.0 | 0.0 | 59.9 | 0 | 24.95 | 0.0 | 26 | Disconnected | 13.00 | Off | No error | On | Ok | Alarm | Ok | Ok | Ok | Ok | Ok | Alarm | Ok | Ok | Ok | Ok | Ok | Ok | Ok | Ok | Ok | Ok | Bulk | Not ignored | 26 | 27 | 26.64 | 0.00 | 27 | 50.0 | 100.0 | 27.6 | 23.1 | 45.9 | 279.9 | No alarm | No alarm
2023-06-26 19:15:26 | 557 | Not active | Closed | Closed | Manual start |  |  |  |  | Ok | 0.0 | 0.0 | 0.00 | 0 | 0.0 | 0.0 | 60.1 | 0 | 26.64 | 0.0 | 26 | Disconnected | 13.00 | Off | No error | On | Ok | Alarm | Ok | Ok | Ok | Ok | Ok | Alarm | Ok | Ok | Ok | Ok | Ok | Ok | Ok | Ok | Ok | Ok | Bulk | Not ignored | 26 | 27 | 26.65 | 6.80 | 27 | 50.0 | 100.0 | 27.6 | 23.1 | 48.9 | 279.9 | No alarm | No alarm
2023-06-26 19:15:27 | 556 | Not active | Closed | Closed | Manual start |  |  |  |  | Ok | 0.0 | 0.0 | 0.00 | 0 | 0.0 | 0.0 | 60.1 | 0 | 26.66 | 0.0 | 26 | Disconnected | 13.00 | Off | No error | On | Ok | Alarm | Ok | Ok | Ok | Ok | Ok | Alarm | Ok | Ok | Ok | Ok | Ok | Ok | Ok | Ok | Ok | Ok | Bulk | Not ignored | 26 | 27 | 26.66 | 4.90 | 27 | 50.0 | 100.0 | 27.6 | 23.1 | 48.9 | 279.9 | No alarm | No alarm
2023-06-26 19:15:34 | 549 | Not active | Closed | Closed | Manual start |  |  |  |  | Ok | 0.0 | 0.0 | 0.00 | 0 | 0.0 | 0.0 | 60.1 | 0 | 26.67 | 0.0 | 26 | Disconnected | 13.00 | Inverting | No error | On | Ok | Alarm | Ok | Ok | Ok | Ok | Ok | Alarm | Ok | Ok | Ok | Ok | Ok | Ok | Ok | Ok | Ok | Ok | Bulk | Not ignored | 26 | 27 | 26.66 | 5.80 | 27 | 50.0 | 100.0 | 27.6 | 23.1 | 52.9 | 279.9 | No alarm | No alarm
2023-06-26 19:15:38 | 545 | Not active | Closed | Closed | Manual start |  |  |  |  | Ok | 0.0 | 0.0 | 0.00 | 0 | 120.3 | 0.4 | 59.9 | 6 | 26.70 | -2.3 | 26 | Disconnected | 13.00 | Inverting | No error | On | Ok | Warning | Ok | Ok | Ok | Ok | Ok | Warning | Ok | Ok | Ok | Ok | Ok | Ok | Ok | Ok | Ok | Ok | Bulk | Not ignored | 26 | 27 | 26.73 | 22.30 | 27 | 50.0 | 100.0 | 27.6 | 23.1 | 55.9 | 279.9 | No alarm | No alarm
2023-06-26 19:15:53 | 532 | Not active | Closed | Closed | Manual start |  |  |  |  | Ok | 0.0 | 0.0 | 0.00 | 0 | 120.1 | 0.6 | 60.1 | 47 | 26.89 | -2.8 | 26 | Disconnected | 13.00 | Inverting | No error | On | Ok | Ok | Ok | Ok | Ok | Ok | Ok | Ok | Ok | Ok | Ok | Ok | Ok | Ok | Ok | Ok | Ok | Ok | Bulk | Not ignored | 26 | 27 | 26.77 | 18.60 | 27 | 50.0 | 100.0 | 27.6 | 23.1 | 67.9 | 279.9 | No alarm | No alarm
2023-06-26 19:15:59 | 526 | Not active | Closed | Closed | Manual start |  |  |  |  | Ok | 0.0 | 0.0 | 0.00 | 0 | 119.3 | 0.6 | 59.9 | 46 | 26.87 | -2.8 | 26 | Disconnected | 13.00 | Inverting | No error | On | Ok | Ok | Ok | Ok | Ok | Ok | Ok | Ok | Ok | Ok | Ok | Ok | Ok | Ok | Ok | Ok | Ok | Ok | Bulk | Not ignored | 26 | 27 | 26.77 | 80.30 | 27 | 50.0 | 100.0 | 27.6 | 23.1 | 72.9 | 279.9 | No alarm | No alarm
2023-06-26 19:16:54 | 471 | Not active | Closed | Closed | Manual start |  |  |  |  | Ok | 0.0 | 0.0 | 0.00 | 0 | 120.3 | 0.6 | 60.1 | 46 | 27.00 | -2.8 | 26 | Disconnected | 13.00 | Inverting | No error | On | Ok | Ok | Ok | Ok | Ok | Ok | Ok | Ok | Ok | Ok | Ok | Ok | Ok | Ok | Ok | Ok | Ok | Ok | Bulk | Not ignored | 26 | 27 | 26.85 | 9.40 | 27 | 50.0 | 100.0 | 27.6 | 23.1 | 108.9 | 279.9 | No alarm | No alarm
2023-06-26 19:16:55 | 470 | Not active | Closed | Closed | Manual start |  |  |  |  | Ok | 0.0 | 0.0 | 0.00 | 0 | 120.3 | 0.6 | 60.1 | 46 | 27.00 | -2.8 | 26 | Disconnected | 13.00 | Off | No error | On | Ok | Alarm | Ok | Ok | Ok | Warning | Ok | Alarm | Ok | Warning | Ok | Ok | Ok | Ok | Ok | Ok | Ok | Ok | Absorption | Not ignored | 26 | 27 | 26.85 | 9.40 | 27 | 50.0 | 100.0 | 27.6 | 23.1 | 108.9 | 279.9 | No alarm | No alarm
2023-06-26 19:16:56 | 469 | Not active | Closed | Closed | Manual start |  |  |  |  | Ok | 0.0 | 0.0 | 0.00 | 0 | 0.0 | 0.0 | 60.1 | 46 | 31.83 | 0.0 | 26 | Disconnected | 13.00 | Off | No error | On | Ok | Alarm | Ok | Ok | Ok | Warning | Ok | Alarm | Ok | Warning | Ok | Ok | Ok | Ok | Ok | Ok | Ok | Ok | Absorption | Not ignored | 26 | 27 | 26.85 | 9.40 | 27 | 50.0 | 100.0 | 27.6 | 23.1 | 108.9 | 279.9 | No alarm | No alarm
2023-06-26 19:16:58 | 467 | Not active | Closed | Closed | Manual start |  |  |  |  | Ok | 0.0 | 0.0 | 0.00 | 0 | 0.0 | 0.0 | 60.1 | 46 | 31.83 | 0.0 | 26 | Disconnected | 13.00 | Off | No error | On | Ok | Alarm | Ok | Ok | Ok | Warning | Ok | Alarm | Ok | Warning | Ok | Ok | Ok | Ok | Ok | Ok | Ok | Ok | Absorption | Not ignored
2023-06-26 19:16:59 | 466 | Not active | Closed | Closed | Manual start |  |  |  |  | Ok | 0.0 | 0.0 | 0.00 | 0 | 0.0 | 0.0 | 60.1 | 0 | 33.17 | 0.0 | 26 | Disconnected | 13.00 | Off | No error | On | Ok | Alarm | Ok | Ok | Ok | Warning | Ok | Alarm | Ok | Warning | Ok | Ok | Ok | Ok | Ok | Ok | Ok | Ok | Absorption | Not ignored
2023-06-26 19:17:01 | 464 | Not active | Closed | Closed | Manual start |  |  |  |  | Ok | 0.0 | 0.0 | 0.00 | 0 | 0.0 | 0.0 | 60.1 | 0 | 33.17 | 0.0 | 26 | Disconnected | 13.00 | Off | No error | On | Ok | Alarm | Ok | Ok | Ok | Warning | Ok | Alarm | Ok | Warning | Ok | Ok | Ok | Ok | Ok | Ok | Ok | Ok | Absorption | Not ignored | 26 | 27 | 26.81 | 0.00 | 27 | 50.0 | 100.0 | 27.6 | 23.1 | 41.9 | 279.9 | No alarm | No alarm
2023-06-26 19:17:03 | 462 | Not active | Closed | Closed | Manual start | Generator start/stop | Manual |  |  | Ok | 0.0 | 0.0 | 0.00 | 0 | 0.0 | 0.0 | 60.1 | 0 | 28.76 | 0.0 | 26 | Disconnected | 13.00 | Off | No error | On | Ok | Alarm | Ok | Ok | Ok | Warning | Ok | Alarm | Ok | Warning | Ok | Ok | Ok | Ok | Ok | Ok | Ok | Ok | Absorption | Not ignored | 26 | 27 | 26.81 | 0.00 | 27 | 50.0 | 100.0 | 27.6 | 23.1 | 43.9 | 279.9 | No alarm | No alarm
2023-06-26 19:17:06 | 459 | Not active | Closed | Closed | Manual start |  |  |  |  | Ok | 0.0 | 0.0 | 0.00 | 0 | 0.0 | 0.0 | 59.9 | 0 | 25.00 | 0.0 | 26 | Disconnected | 13.00 | Off | No error | On | Ok | Alarm | Ok | Ok | Ok | Warning | Ok | Alarm | Ok | Warning | Ok | Ok | Ok | Ok | Ok | Ok | Ok | Ok | Absorption | Not ignored | 26 | 27 | 26.79 | 0.00 | 27 | 50.0 | 100.0 | 27.6 | 23.1 | 44.9 | 279.9 | No alarm | No alarm
2023-06-26 19:17:14 | 451 | Not active | Closed | Closed | Manual start |  |  |  |  | Ok | 0.0 | 0.0 | 0.00 | 0 | 0.0 | 0.0 | 59.9 | 0 | 26.79 | 0.0 | 26 | Disconnected | 13.00 | Off | No error | On | Ok | Alarm | Ok | Ok | Ok | Warning | Ok | Alarm | Ok | Warning | Ok | Ok | Ok | Ok | Ok | Ok | Ok | Ok | Bulk | Not ignored | 26 | 27 | 26.79 | 2.60 | 27 | 50.0 | 100.0 | 27.6 | 23.1 | 49.9 | 279.9 | No alarm | No alarm
2023-06-26 19:17:24 | 441 | Not active | Closed | Closed | Manual start |  |  |  |  | Ok | 0.0 | 0.0 | 0.00 | 0 | 0.0 | 0.0 | 60.1 | 0 | 26.76 | 0.0 | 26 | Disconnected | 13.00 | Inverting | No error | On | Ok | Alarm | Ok | Ok | Ok | Warning | Ok | Alarm | Ok | Warning | Ok | Ok | Ok | Ok | Ok | Ok | Ok | Ok | Bulk | Not ignored | 26 | 27 | 26.78 | 2.50 | 27 | 50.0 | 100.0 | 27.6 | 23.1 | 56.9 | 279.9 | No alarm | No alarm
2023-06-26 19:17:28 | 437 | Not active | Closed | Closed | Manual start |  |  |  |  | Ok | 0.0 | 0.0 | 0.00 | 0 | 119.7 | 0.4 | 60.1 | 6 | 26.77 | -2.2 | 26 | Disconnected | 13.00 | Inverting | No error | On | Ok | Warning | Ok | Ok | Ok | Warning | Ok | Warning | Ok | Warning | Ok | Ok | Ok | Ok | Ok | Ok | Ok | Ok | Bulk | Not ignored | 26 | 27 | 26.77 | 0.50 | 27 | 50.0 | 100.0 | 27.6 | 23.1 | 58.9 | 279.9 | No alarm | No alarm
2023-06-26 19:17:29 | 437 | Not active | Closed | Closed | Manual start |  |  |  |  | Ok | 0.0 | 0.0 | 0.00 | 0 | 119.7 | 0.4 | 60.1 | 6 | 26.77 | -2.2 | 26 | Disconnected | 13.00 | Inverting | No error | On | Ok | Warning | Ok | Ok | Ok | Warning | Ok | Warning | Ok | Warning | Ok | Ok | Ok | Ok | Ok | Ok | Ok | Ok | Bulk | Not ignored | 26 | 27 | 26.77 | 0.50 | 27 | 50.0 | 100.0 | 27.6 | 23.1 | 58.9 | 279.9 | No alarm | No alarm
2023-06-26 19:17:47 | 419 | Not active | Closed | Closed | Manual start |  |  |  |  | Ok | 0.0 | 0.0 | 0.00 | 0 | 119.7 | 0.6 | 59.9 | 47 | 26.74 | -2.9 | 26 | Disconnected | 13.00 | Inverting | No error | On | Ok | Ok | Ok | Ok | Ok | Ok | Ok | Ok | Ok | Ok | Ok | Ok | Ok | Ok | Ok | Ok | Ok | Ok | Bulk | Not ignored | 26 | 27 | 26.76 | 0.00 | 27 | 50.0 | 100.0 | 27.6 | 23.1 | 70.9 | 279.9 | No alarm | No alarm
2023-06-26 19:18:00 | 406 | Not active | Closed | Closed | Manual start |  |  |  |  | Ok | 0.0 | 0.0 | 0.00 | 0 | 119.5 | 0.6 | 59.9 | 46 | 26.76 | -2.8 | 26 | Disconnected | 13.00 | Inverting | No error | On | Ok | Ok | Ok | Ok | Ok | Ok | Ok | Ok | Ok | Ok | Ok | Ok | Ok | Ok | Ok | Ok | Ok | Ok | Bulk | Not ignored | 26 | 27 | 26.76 | 1.30 | 27 | 50.0 | 100.0 | 27.6 | 23.1 | 80.9 | 279.9 | No alarm | No alarm
2023-06-26 19:18:30 | 376 | Not active | Closed | Closed | Manual start |  |  |  |  | Ok | 0.0 | 0.0 | 0.00 | 0 | 119.7 | 0.6 | 60.1 | 45 | 26.74 | -2.9 | 26 | Disconnected | 13.00 | Inverting | No error | On | Ok | Ok | Ok | Ok | Ok | Ok | Ok | Ok | Ok | Ok | Ok | Ok | Ok | Ok | Ok | Ok | Ok | Ok | Bulk | Not ignored | 26 | 27 | 26.74 | -0.20 | 27 | 50.0 | 100.0 | 27.6 | 23.1 | 100.9 | 279.9 | No alarm | No alarm
2023-06-26 19:19:00 | 346 | Not active | Closed | Closed | Manual start |  |  |  |  | Ok | 0.0 | 0.0 | 0.00 | 0 | 119.9 | 0.6 | 60.1 | 46 | 26.74 | -2.8 | 26 | Disconnected | 13.00 | Inverting | No error | On | Ok | Ok | Ok | Ok | Ok | Ok | Ok | Ok | Ok | Ok | Ok | Ok | Ok | Ok | Ok | Ok | Ok | Ok | Bulk | Not ignored | 26 | 27 | 26.74 | 0.40 | 27 | 50.0 | 100.0 | 27.6 | 23.1 | 120.9 | 279.9 | No alarm | No alarm
2023-06-26 19:20:00 | 286 | Not active | Closed | Closed | Manual start |  |  |  |  | Ok | 0.0 | 0.0 | 0.00 | 0 | 119.7 | 0.6 | 60.1 | 45 | 26.73 | -2.7 | 26 | Disconnected | 13.00 | Inverting | No error | On | Ok | Ok | Ok | Ok | Ok | Ok | Ok | Ok | Ok | Ok | Ok | Ok | Ok | Ok | Ok | Ok | Ok | Ok | Bulk | Not ignored | 26 | 27 | 26.73 | -0.60 | 27 | 50.0 | 100.0 | 27.6 | 23.1 | 160.9 | 279.9 | No alarm | No alarm
2023-06-26 19:21:00 | 226 | Not active | Closed | Closed | Manual start |  |  |  |  | Ok | 0.0 | 0.0 | 0.00 | 0 | 119.9 | 0.6 | 60.1 | 46 | 26.79 | -2.9 | 26 | Disconnected | 13.00 | Inverting | No error | On | Ok | Ok | Ok | Ok | Ok | Ok | Ok | Ok | Ok | Ok | Ok | Ok | Ok | Ok | Ok | Ok | Ok | Ok | Bulk | Not ignored | 26 | 27 | 26.75 | 5.00 | 27 | 50.0 | 100.0 | 27.6 | 23.1 | 201.9 | 279.9 | No alarm | No alarm
2023-06-26 19:22:00 | 166 | Not active | Closed | Closed | Manual start |  |  |  |  | Ok | 0.0 | 0.0 | 0.00 | 0 | 120.1 | 0.6 | 60.1 | 45 | 26.79 | -2.8 | 26 | Disconnected | 13.00 | Inverting | No error | On | Ok | Ok | Ok | Ok | Ok | Ok | Ok | Ok | Ok | Ok | Ok | Ok | Ok | Ok | Ok | Ok | Ok | Ok | Bulk | Not ignored | 26 | 27 | 26.77 | 6.40 | 27 | 50.0 | 100.0 | 27.6 | 23.1 | 240.9 | 279.9 | No alarm | No alarm
2023-06-26 19:23:00 | 106 | Not active | Closed | Closed | Manual start |  |  |  |  | Ok | 0.0 | 0.0 | 0.00 | 0 | 119.9 | 0.6 | 59.9 | 45 | 26.76 | -2.8 | 26 | Disconnected | 13.00 | Inverting | No error | On | Ok | Ok | Ok | Ok | Ok | Ok | Ok | Ok | Ok | Ok | Ok | Ok | Ok | Ok | Ok | Ok | Ok | Ok | Bulk | Not ignored | 26 | 27 | 26.76 | 7.50 | 27 | 50.0 | 100.0 | 27.6 | 23.1 | 279.9 | 279.9 | No alarm | No alarm
2023-06-26 19:23:27 | 79 | Not active | Closed | Closed | Manual start |  |  |  |  | Ok | 0.0 | 0.0 | 0.00 | 0 | 120.1 | 0.6 | 59.9 | 45 | 26.76 | -2.8 | 26 | Disconnected | 13.00 | Inverting | No error | On | Ok | Ok | Ok | Ok | Ok | Ok | Ok | Ok | Ok | Ok | Ok | Ok | Ok | Ok | Ok | Ok | Ok | Ok | Bulk | Not ignored | 26 | 27 | 26.76 | 8.20 | 27 | 50.0 | 100.0 | 27.6 | 23.1 | 279.9 | 279.9 | No alarm | No alarm
2023-06-26 19:23:37 | 69 | Not active | Closed | Closed | Manual start |  |  |  |  | Ok | 0.0 | 0.0 | 0.00 | 0 | 120.1 | 0.6 | 59.9 | 45 | 26.77 | -2.8 | 26 | Disconnected | 13.00 | Inverting | No error | On | Ok | Ok | Ok | Ok | Ok | Ok | Ok | Ok | Ok | Ok | Ok | Ok | Ok | Ok | Ok | Ok | Ok | Ok | Bulk | Not ignored | 26 | 27 | 26.77 | 7.30 | 27 | 50.0 | 100.0 | 27.6 | 23.1 | 279.9 | 279.9 | No alarm | No alarm
2023-06-26 19:24:00 | 46 | Not active | Closed | Closed | Manual start |  |  |  |  | Ok | 0.0 | 0.0 | 0.00 | 0 | 120.1 | 0.6 | 60.1 | 44 | 26.77 | -2.8 | 26 | Disconnected | 13.00 | Inverting | No error | On | Ok | Ok | Ok | Ok | Ok | Ok | Ok | Ok | Ok | Ok | Ok | Ok | Ok | Ok | Ok | Ok | Ok | Ok | Bulk | Not ignored | 26 | 27 | 26.77 | 8.50 | 27 | 50.0 | 100.0 | 27.6 | 23.1 | 279.9 | 279.9 | No alarm | No alarm
2023-06-26 19:25:00 | 0 | Not active | Closed | Closed | Manual start |  |  |  |  | Ok | 0.0 | 0.0 | 0.00 | 0 | 119.7 | 0.6 | 59.9 | 45 | 26.73 | -2.7 | 26 | Disconnected | 13.00 | Inverting | No error | On | Ok | Ok | Ok | Ok | Ok | Ok | Ok | Ok | Ok | Ok | Ok | Ok | Ok | Ok | Ok | Ok | Ok | Ok | Bulk | Not ignored | 26 | 27 | 26.73 | -3.40 | 27 | 50.0 | 100.0 | 27.6 | 23.1 | 279.9 | 279.9 | No alarm | No alarm
2023-06-26 19:25:57 | 2 | Not active | Closed | Closed | Manual start |  |  |  |  | Ok | 0.0 | 0.0 | 0.00 | 0 | 119.5 | 0.6 | 59.9 | 45 | 26.76 | -2.8 | 26 | Disconnected | 13.00 | Inverting | No error | On | Ok | Ok | Ok | Ok | Ok | Ok | Ok | Ok | Ok | Ok | Ok | Ok | Ok | Ok | Ok | Ok | Ok | Ok | Bulk | Not ignored | 26 | 27 | 26.73 | 2.40 | 27 | 50.0 | 100.0 | 27.6 | 23.1 | 279.9 | 279.9 | No alarm | No alarm
2023-06-26 19:26:00 | 1 | Not active | Closed | Closed | Manual start |  |  |  |  | Ok | 0.0 | 0.0 | 0.00 | 0 | 119.7 | 0.6 | 60.1 | 45 | 26.72 | -2.8 | 26 | Disconnected | 13.00 | Inverting | No error | On | Ok | Ok | Ok | Ok | Ok | Ok | Ok | Ok | Ok | Ok | Ok | Ok | Ok | Ok | Ok | Ok | Ok | Ok | Bulk | Not ignored | 26 | 27 | 26.75 | -5.40 | 27 | 50.0 | 100.0 | 27.6 | 23.1 | 279.9 | 279.9 | No alarm | No alarm
2023-06-26 19:26:06 | 1 | Not active | Closed | Closed | Manual start |  |  |  |  | Ok | 0.0 | 0.0 | 0.00 | 0 | 119.5 | 0.6 | 59.9 | 45 | 26.73 | -2.7 | 26 | Disconnected | 13.00 | Inverting | No error | On | Ok | Ok | Ok | Ok | Ok | Ok | Ok | Ok | Ok | Ok | Ok | Ok | Ok | Ok | Ok | Ok | Ok | Ok | Bulk | Not ignored | 26 | 27 | 26.72 | -5.70 | 27 | 50.0 | 100.0 | 27.6 | 23.1 | 279.9 | 279.9 | No alarm | No alarm
2023-06-26 19:27:11 | 2 | Not active | Closed | Closed | Manual start |  |  |  |  | Ok | 0.0 | 0.0 | 0.00 | 0 | 119.7 | 0.6 | 60.1 | 45 | 26.70 | -2.8 | 26 | Disconnected | 13.00 | Inverting | No error | On | Ok | Ok | Ok | Ok | Ok | Ok | Ok | Ok | Ok | Ok | Ok | Ok | Ok | Ok | Ok | Ok | Ok | Ok | Bulk | Not ignored | 26 | 27 | 26.72 | 4.30 | 27 | 50.0 | 100.0 | 27.6 | 23.1 | 279.9 | 279.9 | No alarm | No alarm
2023-06-26 19:28:00 | 1 | Not active | Closed | Closed | Manual start |  |  |  |  | Ok | 0.0 | 0.0 | 0.00 | 0 | 119.9 | 0.6 | 60.1 | 46 | 26.72 | -2.9 | 26 | Disconnected | 13.00 | Inverting | No error | On | Ok | Ok | Ok | Ok | Ok | Ok | Ok | Ok | Ok | Ok | Ok | Ok | Ok | Ok | Ok | Ok | Ok | Ok | Bulk | Not ignored | 26 | 27 | 26.72 | 5.10 | 27 | 50.0 | 100.0 | 27.6 | 23.1 | 279.9 | 279.9 | No alarm | No alarm
2023-06-26 19:29:09 | 2 | Not active | Closed | Closed | Manual start |  |  |  |  | Ok | 0.0 | 0.0 | 0.00 | 0 | 119.9 | 0.6 | 60.1 | 45 | 26.71 | -2.7 | 26 | Disconnected | 13.00 | Inverting | No error | On | Ok | Ok | Ok | Ok | Ok | Ok | Ok | Ok | Ok | Ok | Ok | Ok | Ok | Ok | Ok | Ok | Ok | Ok | Bulk | Not ignored | 26 | 27 | 26.71 | -2.60 | 27 | 50.0 | 100.0 | 27.6 | 23.1 | 279.9 | 279.9 | No alarm | No alarm
2023-06-26 19:29:59 | 2 | Not active | Closed | Closed | Manual start |  |  |  |  | Ok | 0.0 | 0.0 | 0.00 | 0 | 119.7 | 0.6 | 59.9 | 44 | 26.71 | -2.7 | 26 | Disconnected | 13.00 | Inverting | No error | On | Ok | Ok | Ok | Ok | Ok | Ok | Ok | Ok | Ok | Ok | Ok | Ok | Ok | Ok | Ok | Ok | Ok | Ok | Bulk | Not ignored | 26 | 27 | 26.70 | -2.80 | 27 | 50.0 | 100.0 | 27.6 | 23.1 | 279.9 | 279.9 | No alarm | No alarm
2023-06-26 19:31:00 | 2 | Not active | Closed | Closed | Manual start |  |  |  |  | Ok | 0.0 | 0.0 | 0.00 | 0 | 119.7 | 0.6 | 60.1 | 44 | 26.69 | -2.8 | 26 | Disconnected | 13.00 | Inverting | No error | On | Ok | Ok | Ok | Ok | Ok | Ok | Ok | Ok | Ok | Ok | Ok | Ok | Ok | Ok | Ok | Ok | Ok | Ok | Bulk | Not ignored | 26 | 27 | 26.69 | -2.50 | 27 | 50.0 | 100.0 | 27.6 | 23.1 | 279.9 | 279.9 | No alarm | No alarm
2023-06-26 19:31:59 | 3 | Not active | Closed | Closed | Manual start | Generator start/stop | Manual |  |  | Ok | 0.0 | 0.0 | 0.00 | 0 | 120.1 | 0.6 | 60.1 | 45 | 26.72 | -2.8 | 26 | Disconnected | 13.00 | Inverting | No error | On | Ok | Ok | Ok | Ok | Ok | Ok | Ok | Ok | Ok | Ok | Ok | Ok | Ok | Ok | Ok | Ok | Ok | Ok | Bulk | Not ignored | 26 | 27 | 26.72 | 7.50 | 27 | 50.0 | 100.0 | 27.6 | 23.1 | 279.9 | 279.9 | No alarm | No alarm
2023-06-26 19:32:44 | 1 | Not active | Closed | Closed | Manual start |  |  |  |  | Ok | 0.0 | 0.0 | 0.00 | 0 | 119.7 | 0.6 | 59.9 | 45 | 26.71 | -2.8 | 25 | Disconnected | 13.00 | Inverting | No error | On | Ok | Ok | Ok | Ok | Ok | Ok | Ok | Ok | Ok | Ok | Ok | Ok | Ok | Ok | Ok | Ok | Ok | Ok | Bulk | Not ignored | 26 | 27 | 26.71 | -1.90 | 27 | 50.0 | 100.0 | 27.6 | 23.1 | 279.9 | 279.9 | No alarm | No alarm
2023-06-26 19:32:49 | 0 |  |  |  |  | Generator start/stop | Manual
2023-06-26 19:32:56 | 1 | Not active | Closed | Closed | Manual start |  |  |  |  | Ok | 0.0 | 0.0 | 0.00 | 0 | 120.1 | 0.6 | 60.1 | 45 | 26.74 | -2.8 | 25 | Disconnected | 13.00 | Inverting | No error | On | Ok | Ok | Ok | Ok | Ok | Ok | Ok | Ok | Ok | Ok | Ok | Ok | Ok | Ok | Ok | Ok | Ok | Ok | Bulk | Not ignored | 26 | 27 | 26.72 | 5.70 | 27 | 50.0 | 100.0 | 27.6 | 23.1 | 279.9 | 279.9 | No alarm | No alarm
2023-06-26 19:33:00 | 2 | Not active | Closed | Closed | Manual start |  |  |  |  | Ok | 0.0 | 0.0 | 0.00 | 0 | 120.1 | 0.6 | 59.9 | 45 | 26.72 | -2.8 | 25 | Disconnected | 13.00 | Inverting | No error | On | Ok | Ok | Ok | Ok | Ok | Ok | Ok | Ok | Ok | Ok | Ok | Ok | Ok | Ok | Ok | Ok | Ok | Ok | Bulk | Not ignored | 26 | 27 | 26.74 | 11.20 | 27 | 50.0 | 100.0 | 27.6 | 23.1 | 279.9 | 279.9 | No alarm | No alarm
2023-06-26 19:33:07 | 1 | Not active | Closed | Closed | Manual start |  |  |  |  | Ok | 0.0 | 0.0 | 0.00 | 0 | 120.1 | 0.6 | 59.9 | 45 | 26.74 | -2.9 | 25 | Disconnected | 13.00 | Inverting | No error | On | Ok | Ok | Ok | Ok | Ok | Ok | Ok | Ok | Ok | Ok | Ok | Ok | Ok | Ok | Ok | Ok | Ok | Ok | Bulk | Not ignored | 26 | 27 | 26.74 | 10.90 | 27 | 50.0 | 100.0 | 27.6 | 23.1 | 279.9 | 279.9 | No alarm | No alarm
2023-06-26 19:34:00 | 0 | Not active | Closed | Closed | Manual start |  |  |  |  | Ok | 0.0 | 0.0 | 0.00 | 0 | 120.3 | 0.6 | 59.9 | 45 | 26.77 | -2.8 | 25 | Disconnected | 13.00 | Inverting | No error | On | Ok | Ok | Ok | Ok | Ok | Ok | Ok | Ok | Ok | Ok | Ok | Ok | Ok | Ok | Ok | Ok | Ok | Ok | Bulk | Not ignored | 26 | 27 | 26.77 | 11.20 | 27 | 50.0 | 100.0 | 27.6 | 23.1 | 279.9 | 279.9 | No alarm | No alarm
2023-06-26 19:34:59 | 1 | Not active | Closed | Closed | Manual start |  |  |  |  | Ok | 0.0 | 0.0 | 0.00 | 0 | 120.1 | 0.6 | 60.1 | 45 | 26.76 | -2.8 | 25 | Disconnected | 13.00 | Inverting | No error | On | Ok | Ok | Ok | Ok | Ok | Ok | Ok | Ok | Ok | Ok | Ok | Ok | Ok | Ok | Ok | Ok | Ok | Ok | Bulk | Not ignored | 26 | 27 | 26.76 | 9.40 | 27 | 50.0 | 100.0 | 27.6 | 23.1 | 279.9 | 279.9 | No alarm | No alarm
2023-06-26 19:36:00 | 1 | Not active | Closed | Closed | Manual start |  |  |  |  | Ok | 0.0 | 0.0 | 0.00 | 0 | 120.1 | 0.6 | 60.1 | 45 | 26.77 | -2.8 | 25 | Disconnected | 13.00 | Inverting | No error | On | Ok | Ok | Ok | Ok | Ok | Ok | Ok | Ok | Ok | Ok | Ok | Ok | Ok | Ok | Ok | Ok | Ok | Ok | Bulk | Not ignored | 26 | 27 | 26.76 | 7.90 | 27 | 50.0 | 100.0 | 27.6 | 23.1 | 279.9 | 279.9 | No alarm | No alarm
2023-06-26 19:36:47 | 2 | Not active | Closed | Closed | Manual start |  |  |  |  | Ok | 0.0 | 0.0 | 0.00 | 0 | 120.1 | 0.6 | 59.9 | 45 | 26.73 | -2.8 | 25 | Disconnected | 13.00 | Inverting | No error | On | Ok | Ok | Ok | Ok | Ok | Ok | Ok | Ok | Ok | Ok | Ok | Ok | Ok | Ok | Ok | Ok | Ok | Ok | Bulk | Not ignored | 26 | 27 | 26.76 | 8.10 | 27 | 50.0 | 100.0 | 27.6 | 23.1 | 279.9 | 279.9 | No alarm | No alarm
2023-06-26 19:36:56 | 1 | Not active | Closed | Closed | Manual start |  |  |  |  | Ok | 0.0 | 0.0 | 0.00 | 0 | 119.9 | 0.6 | 60.1 | 45 | 26.77 | -2.7 | 25 | Disconnected | 13.00 | Inverting | No error | On | Ok | Ok | Ok | Ok | Ok | Ok | Ok | Ok | Ok | Ok | Ok | Ok | Ok | Ok | Ok | Ok | Ok | Ok | Bulk | Not ignored | 26 | 27 | 26.76 | 8.10 | 27 | 50.0 | 100.0 | 27.6 | 23.1 | 279.9 | 279.9 | No alarm | No alarm
2023-06-26 19:36:59 | 1 |  |  |  |  | Generator start/stop | Manual
2023-06-26 19:37:00 | 2 | Not active | Closed | Closed | Manual start |  |  |  |  | Ok | 0.0 | 0.0 | 0.00 | 0 | 120.1 | 0.6 | 60.1 | 45 | 26.76 | -2.7 | 25 | Disconnected | 13.00 | Inverting | No error | On | Ok | Ok | Ok | Ok | Ok | Ok | Ok | Ok | Ok | Ok | Ok | Ok | Ok | Ok | Ok | Ok | Ok | Ok | Bulk | Not ignored | 26 | 27 | 26.76 | 8.30 | 27 | 50.0 | 100.0 | 27.6 | 23.1 | 279.9 | 279.9 | No alarm | No alarm
2023-06-26 19:37:27 | 1 | Not active | Closed | Closed | Manual start |  |  |  |  | Ok | 0.0 | 0.0 | 0.00 | 0 | 120.1 | 0.6 | 60.1 | 44 | 26.74 | -2.7 | 25 | Disconnected | 13.00 | Inverting | No error | On | Ok | Ok | Ok | Ok | Ok | Ok | Ok | Ok | Ok | Ok | Ok | Ok | Ok | Ok | Ok | Ok | Ok | Ok | Bulk | Not ignored | 26 | 27 | 26.73 | -1.10 | 27 | 50.0 | 100.0 | 27.6 | 23.1 | 279.9 | 279.9 | No alarm | No alarm
2023-06-26 19:37:36 | 2 | Not active | Closed | Closed | Manual start |  |  |  |  | Ok | 0.0 | 0.0 | 0.00 | 0 | 119.9 | 0.6 | 60.1 | 45 | 26.73 | -2.7 | 25 | Disconnected | 13.00 | Inverting | No error | On | Ok | Ok | Ok | Ok | Ok | Ok | Ok | Ok | Ok | Ok | Ok | Ok | Ok | Ok | Ok | Ok | Ok | Ok | Bulk | Not ignored | 26 | 27 | 26.72 | -1.60 | 27 | 50.0 | 100.0 | 27.6 | 23.1 | 279.9 | 279.9 | No alarm | No alarm
2023-06-26 19:38:00 | 1 | Not active | Closed | Closed | Manual start |  |  |  |  | Ok | 0.0 | 0.0 | 0.00 | 0 | 119.9 | 0.6 | 60.1 | 45 | 26.76 | -2.8 | 25 | Disconnected | 13.00 | Inverting | No error | On | Ok | Ok | Ok | Ok | Ok | Ok | Ok | Ok | Ok | Ok | Ok | Ok | Ok | Ok | Ok | Ok | Ok | Ok | Bulk | Not ignored | 26 | 27 | 26.76 | 7.80 | 27 | 50.0 | 100.0 | 27.6 | 23.1 | 279.9 | 279.9 | No alarm | No alarm
2023-06-26 19:38:20 | 1 | Not active | Closed | Closed | Manual start |  |  |  |  | Ok | 0.0 | 0.0 | 0.00 | 0 | 120.1 | 0.6 | 59.9 | 45 | 26.76 | -2.7 | 25 | Disconnected | 13.00 | Inverting | No error | On | Ok | Ok | Ok | Ok | Ok | Ok | Ok | Ok | Ok | Ok | Ok | Ok | Ok | Ok | Ok | Ok | Ok | Ok | Bulk | Not ignored | 26 | 27 | 26.77 | 8.90 | 27 | 50.0 | 100.0 | 27.6 | 23.1 | 279.9 | 279.9 | No alarm | No alarm
2023-06-26 19:38:26 | 0 |  |  |  |  | Generator start/stop | Manual
2023-06-26 19:39:00 | 0 | Not active | Closed | Closed | Manual start |  |  |  |  | Ok | 0.0 | 0.0 | 0.00 | 0 | 119.9 | 0.6 | 60.1 | 45 | 26.73 | -2.8 | 25 | Disconnected | 13.00 | Inverting | No error | On | Ok | Ok | Ok | Ok | Ok | Ok | Ok | Ok | Ok | Ok | Ok | Ok | Ok | Ok | Ok | Ok | Ok | Ok | Bulk | Not ignored | 26 | 27 | 26.74 | -6.10 | 27 | 50.0 | 100.0 | 27.6 | 23.1 | 279.9 | 279.9 | No alarm | No alarm
2023-06-26 19:39:59 | 1 | Not active | Closed | Closed | Manual start |  |  |  |  | Ok | 0.0 | 0.0 | 0.00 | 0 | 120.1 | 0.6 | 60.1 | 44 | 26.77 | -2.8 | 25 | Disconnected | 13.00 | Inverting | No error | On | Ok | Ok | Ok | Ok | Ok | Ok | Ok | Ok | Ok | Ok | Ok | Ok | Ok | Ok | Ok | Ok | Ok | Ok | Bulk | Not ignored | 26 | 27 | 26.78 | 8.00 | 27 | 50.0 | 100.0 | 27.6 | 23.1 | 279.9 | 279.9 | No alarm | No alarm
2023-06-26 19:41:00 | 1 | Not active | Closed | Closed | Manual start |  |  |  |  | Ok | 0.0 | 0.0 | 0.00 | 0 | 120.3 | 0.6 | 59.9 | 45 | 26.78 | -2.8 | 25 | Disconnected | 13.00 | Inverting | No error | On | Ok | Ok | Ok | Ok | Ok | Ok | Ok | Ok | Ok | Ok | Ok | Ok | Ok | Ok | Ok | Ok | Ok | Ok | Bulk | Not ignored | 26 | 27 | 26.78 | 6.10 | 27 | 50.0 | 100.0 | 27.6 | 23.1 | 279.9 | 279.9 | No alarm | No alarm
2023-06-26 19:41:07 | 2 | Not active | Closed | Closed | Manual start |  |  |  |  | Ok | 0.0 | 0.0 | 0.00 | 0 | 120.1 | 0.6 | 60.1 | 45 | 26.78 | -2.8 | 25 | Disconnected | 13.00 | Inverting | No error | On | Ok | Ok | Ok | Ok | Ok | Ok | Ok | Ok | Ok | Ok | Ok | Ok | Ok | Ok | Ok | Ok | Ok | Ok | Bulk | Not ignored | 26 | 27 | 26.78 | 6.20 | 27 | 50.0 | 100.0 | 27.6 | 23.1 | 279.9 | 279.9 | No alarm | No alarm
2023-06-26 19:41:16 | 1 | Not active | Closed | Closed | Manual start |  |  |  |  | Ok | 0.0 | 0.0 | 0.00 | 0 | 120.1 | 0.6 | 60.1 | 46 | 26.78 | -2.7 | 25 | Disconnected | 13.00 | Inverting | No error | On | Ok | Ok | Ok | Ok | Ok | Ok | Ok | Ok | Ok | Ok | Ok | Ok | Ok | Ok | Ok | Ok | Ok | Ok | Bulk | Not ignored | 26 | 27 | 26.78 | 6.10 | 27 | 50.0 | 100.0 | 27.6 | 23.1 | 279.9 | 279.9 | No alarm | No alarm
2023-06-26 19:41:27 | 1 | Not active | Closed | Closed | Manual start |  |  |  |  | Ok | 0.0 | 0.0 | 0.00 | 0 | 120.1 | 0.6 | 59.9 | 45 | 26.77 | -2.7 | 25 | Disconnected | 13.00 | Inverting | No error | On | Ok | Ok | Ok | Ok | Ok | Ok | Ok | Ok | Ok | Ok | Ok | Ok | Ok | Ok | Ok | Ok | Ok | Ok | Bulk | Not ignored | 26 | 27 | 26.79 | 6.20 | 27 | 50.0 | 100.0 | 27.6 | 23.1 | 279.9 | 279.9 | No alarm | No alarm
2023-06-26 19:41:37 | 1 | Not active | Closed | Closed | Manual start |  |  |  |  | Ok | 0.0 | 0.0 | 0.00 | 0 | 119.9 | 0.6 | 59.9 | 45 | 26.78 | -2.7 | 25 | Disconnected | 13.00 | Inverting | No error | On | Ok | Ok | Ok | Ok | Ok | Ok | Ok | Ok | Ok | Ok | Ok | Ok | Ok | Ok | Ok | Ok | Ok | Ok | Bulk | Not ignored | 26 | 27 | 26.78 | 6.10 | 27 | 50.0 | 100.0 | 27.6 | 23.1 | 279.9 | 279.9 | No alarm | No alarm
2023-06-26 19:41:38 | 0 |  |  |  |  | Generator start/stop | Manual
2023-06-26 19:41:59 | 1 | Not active | Closed | Closed | Manual start |  |  |  |  | Ok | 0.0 | 0.0 | 0.00 | 0 | 120.1 | 0.6 | 60.1 | 45 | 26.77 | -2.8 | 25 | Disconnected | 13.00 | Inverting | No error | On | Ok | Ok | Ok | Ok | Ok | Ok | Ok | Ok | Ok | Ok | Ok | Ok | Ok | Ok | Ok | Ok | Ok | Ok | Bulk | Not ignored | 26 | 27 | 26.78 | 6.00 | 27 | 50.0 | 100.0 | 27.6 | 23.1 | 279.9 | 279.9 | No alarm | No alarm
2023-06-26 19:42:08 | 1 | Not active | Closed | Closed | Manual start |  |  |  |  | Ok | 0.0 | 0.0 | 0.00 | 0 | 120.3 | 0.6 | 59.9 | 45 | 26.77 | -2.8 | 25 | Disconnected | 13.00 | Inverting | No error | On | Ok | Ok | Ok | Ok | Ok | Ok | Ok | Ok | Ok | Ok | Ok | Ok | Ok | Ok | Ok | Ok | Ok | Ok | Bulk | Not ignored | 26 | 27 | 26.78 | 5.90 | 27 | 50.0 | 100.0 | 27.6 | 23.1 | 279.9 | 279.9 | No alarm | No alarm
2023-06-26 19:42:18 | 1 | Not active | Closed | Closed | Manual start |  |  |  |  | Ok | 0.0 | 0.0 | 0.00 | 0 | 120.3 | 0.6 | 59.9 | 45 | 26.77 | -2.8 | 25 | Disconnected | 13.00 | Inverting | No error | On | Ok | Ok | Ok | Ok | Ok | Ok | Ok | Ok | Ok | Ok | Ok | Ok | Ok | Ok | Ok | Ok | Ok | Ok | Bulk | Not ignored | 26 | 27 | 26.79 | 6.10 | 27 | 50.0 | 100.0 | 27.6 | 23.1 | 279.9 | 279.9 | No alarm | No alarm
2023-06-26 19:42:47 | 0 | Not active | Closed | Closed | Manual start |  |  |  |  | Ok | 0.0 | 0.0 | 0.00 | 0 | 119.9 | 0.6 | 59.9 | 45 | 26.77 | -2.8 | 25 | Disconnected | 13.00 | Inverting | No error | On | Ok | Ok | Ok | Ok | Ok | Ok | Ok | Ok | Ok | Ok | Ok | Ok | Ok | Ok | Ok | Ok | Ok | Ok | Bulk | Not ignored | 26 | 27 | 26.78 | 2.60 | 27 | 50.0 | 100.0 | 27.6 | 23.1 | 279.9 | 279.9 | No alarm | No alarm
2023-06-26 19:42:57 | 0 | Not active | Closed | Closed | Manual start |  |  |  |  | Ok | 0.0 | 0.0 | 0.00 | 0 | 120.1 | 0.6 | 59.9 | 45 | 26.78 | -2.8 | 25 | Disconnected | 13.00 | Inverting | No error | On | Ok | Ok | Ok | Ok | Ok | Ok | Ok | Ok | Ok | Ok | Ok | Ok | Ok | Ok | Ok | Ok | Ok | Ok | Bulk | Not ignored | 26 | 27 | 26.78 | 2.30 | 27 | 50.0 | 100.0 | 27.6 | 23.1 | 279.9 | 279.9 | No alarm | No alarm
2023-06-26 19:43:00 | 2 | Not active | Closed | Closed | Manual start |  |  |  |  | Ok | 0.0 | 0.0 | 0.00 | 0 | 119.9 | 0.6 | 60.1 | 45 | 26.78 | -2.7 | 25 | Disconnected | 13.00 | Inverting | No error | On | Ok | Ok | Ok | Ok | Ok | Ok | Ok | Ok | Ok | Ok | Ok | Ok | Ok | Ok | Ok | Ok | Ok | Ok | Bulk | Not ignored | 26 | 27 | 26.77 | -0.40 | 27 | 50.0 | 100.0 | 27.6 | 23.1 | 279.9 | 279.9 | No alarm | No alarm
2023-06-26 19:44:00 | 2 | Not active | Closed | Closed | Manual start |  |  |  |  | Ok | 0.0 | 0.0 | 0.00 | 0 | 120.3 | 0.6 | 60.1 | 46 | 26.80 | -2.7 | 25 | Disconnected | 13.00 | Inverting | No error | On | Ok | Ok | Ok | Ok | Ok | Ok | Ok | Ok | Ok | Ok | Ok | Ok | Ok | Ok | Ok | Ok | Ok | Ok | Bulk | Not ignored | 26 | 27 | 26.78 | 6.10 | 27 | 50.0 | 100.0 | 27.6 | 23.1 | 279.9 | 279.9 | No alarm | No alarm
2023-06-26 19:44:59 | 1 | Not active | Closed | Closed | Manual start |  |  |  |  | Ok | 0.0 | 0.0 | 0.00 | 0 | 120.1 | 0.6 | 59.9 | 44 | 26.79 | -2.8 | 25 | Disconnected | 13.00 | Inverting | No error | On | Ok | Ok | Ok | Ok | Ok | Ok | Ok | Ok | Ok | Ok | Ok | Ok | Ok | Ok | Ok | Ok | Ok | Ok | Bulk | Not ignored | 26 | 27 | 26.79 | 5.80 | 27 | 50.0 | 100.0 | 27.6 | 23.1 | 279.9 | 279.9 | No alarm | No alarm
2023-06-26 19:45:58 | 1 | Not active | Closed | Closed | Manual start |  |  |  |  | Ok | 0.0 | 0.0 | 0.00 | 0 | 120.3 | 0.6 | 59.9 | 45 | 26.79 | -2.7 | 25 | Disconnected | 13.00 | Inverting | No error | On | Ok | Ok | Ok | Ok | Ok | Ok | Ok | Ok | Ok | Ok | Ok | Ok | Ok | Ok | Ok | Ok | Ok | Ok | Bulk | Not ignored | 26 | 27 | 26.80 | 6.00 | 27 | 50.0 | 100.0 | 27.6 | 23.1 | 279.9 | 279.9 | No alarm | No alarm
2023-06-26 19:46:00 | 1 | Not active | Closed | Closed | Manual start |  |  |  |  | Ok | 0.0 | 0.0 | 0.00 | 0 | 120.1 | 0.6 | 60.1 | 45 | 26.79 | -2.7 | 25 | Disconnected | 13.00 | Inverting | No error | On | Ok | Ok | Ok | Ok | Ok | Ok | Ok | Ok | Ok | Ok | Ok | Ok | Ok | Ok | Ok | Ok | Ok | Ok | Bulk | Not ignored | 26 | 27 | 26.79 | 5.50 | 27 | 50.0 | 100.0 | 27.6 | 23.1 | 279.9 | 279.9 | No alarm | No alarm
2023-06-26 19:46:07 | 0 | Not active | Closed | Closed | Manual start |  |  |  |  | Ok | 0.0 | 0.0 | 0.00 | 0 | 120.1 | 0.6 | 59.9 | 45 | 26.80 | -2.8 | 25 | Disconnected | 13.00 | Inverting | No error | On | Ok | Ok | Ok | Ok | Ok | Ok | Ok | Ok | Ok | Ok | Ok | Ok | Ok | Ok | Ok | Ok | Ok | Ok | Bulk | Not ignored | 26 | 27 | 26.79 | 5.60 | 27 | 50.0 | 100.0 | 27.6 | 23.1 | 279.9 | 279.9 | No alarm | No alarm
2023-06-26 19:46:57 | 0 | Not active | Closed | Closed | Manual start |  |  |  |  | Ok | 0.0 | 0.0 | 0.00 | 0 | 120.1 | 0.6 | 59.9 | 45 | 26.79 | -2.7 | 25 | Disconnected | 13.00 | Inverting | No error | On | Ok | Ok | Ok | Ok | Ok | Ok | Ok | Ok | Ok | Ok | Ok | Ok | Ok | Ok | Ok | Ok | Ok | Ok | Bulk | Not ignored | 26 | 27 | 26.80 | 5.90 | 27 | 50.0 | 100.0 | 27.6 | 23.1 | 279.9 | 279.9 | No alarm | No alarm
2023-06-26 19:47:00 | 2 | Not active | Closed | Closed | Manual start |  |  |  |  | Ok | 0.0 | 0.0 | 0.00 | 0 | 120.1 | 0.6 | 59.9 | 44 | 26.80 | -2.8 | 25 | Disconnected | 13.00 | Inverting | No error | On | Ok | Ok | Ok | Ok | Ok | Ok | Ok | Ok | Ok | Ok | Ok | Ok | Ok | Ok | Ok | Ok | Ok | Ok | Bulk | Not ignored | 26 | 27 | 26.80 | 5.90 | 27 | 50.0 | 100.0 | 27.6 | 23.1 | 279.9 | 279.9 | No alarm | No alarm
2023-06-26 19:47:08 | 0 | Not active | Closed | Closed | Manual start |  |  |  |  | Ok | 0.0 | 0.0 | 0.00 | 0 | 120.3 | 0.6 | 59.9 | 45 | 26.80 | -2.8 | 25 | Disconnected | 13.00 | Inverting | No error | On | Ok | Ok | Ok | Ok | Ok | Ok | Ok | Ok | Ok | Ok | Ok | Ok | Ok | Ok | Ok | Ok | Ok | Ok | Bulk | Not ignored | 26 | 27 | 26.80 | 6.00 | 27 | 50.0 | 100.0 | 27.6 | 23.1 | 279.9 | 279.9 | No alarm | No alarm
2023-06-26 19:47:17 | 1 | Not active | Closed | Closed | Manual start |  |  |  |  | Ok | 0.0 | 0.0 | 0.00 | 0 | 120.3 | 0.6 | 59.9 | 45 | 26.80 | -2.8 | 25 | Disconnected | 13.00 | Inverting | No error | On | Ok | Ok | Ok | Ok | Ok | Ok | Ok | Ok | Ok | Ok | Ok | Ok | Ok | Ok | Ok | Ok | Ok | Ok | Bulk | Not ignored | 26 | 27 | 26.80 | 5.80 | 27 | 50.0 | 100.0 | 27.6 | 23.1 | 279.9 | 279.9 | No alarm | No alarm
2023-06-26 19:47:28 | 1 | Not active | Closed | Closed | Manual start |  |  |  |  | Ok | 0.0 | 0.0 | 0.00 | 0 | 120.1 | 0.6 | 59.9 | 45 | 26.80 | -2.8 | 25 | Disconnected | 13.00 | Inverting | No error | On | Ok | Ok | Ok | Ok | Ok | Ok | Ok | Ok | Ok | Ok | Ok | Ok | Ok | Ok | Ok | Ok | Ok | Ok | Bulk | Not ignored | 26 | 27 | 26.80 | 5.90 | 27 | 50.0 | 100.0 | 27.6 | 23.1 | 279.9 | 279.9 | No alarm | No alarm
2023-06-26 19:47:58 | 1 | Not active | Closed | Closed | Manual start |  |  |  |  | Ok | 0.0 | 0.0 | 0.00 | 0 | 120.1 | 0.6 | 59.9 | 45 | 26.80 | -2.7 | 25 | Disconnected | 13.00 | Inverting | No error | On | Ok | Ok | Ok | Ok | Ok | Ok | Ok | Ok | Ok | Ok | Ok | Ok | Ok | Ok | Ok | Ok | Ok | Ok | Bulk | Not ignored | 26 | 27 | 26.80 | 5.70 | 27 | 50.0 | 100.0 | 27.6 | 23.1 | 279.9 | 279.9 | No alarm | No alarm
2023-06-26 19:47:59 | 2 | Not active | Closed | Closed | Manual start |  |  |  |  | Ok | 0.0 | 0.0 | 0.00 | 0 | 120.1 | 0.6 | 60.1 | 45 | 26.80 | -2.8 | 25 | Disconnected | 13.00 | Inverting | No error | On | Ok | Ok | Ok | Ok | Ok | Ok | Ok | Ok | Ok | Ok | Ok | Ok | Ok | Ok | Ok | Ok | Ok | Ok | Bulk | Not ignored | 26 | 27 | 26.80 | 5.70 | 27 | 50.0 | 100.0 | 27.6 | 23.1 | 279.9 | 279.9 | No alarm | No alarm
2023-06-26 19:48:07 | 0 | Not active | Closed | Closed | Manual start |  |  |  |  | Ok | 0.0 | 0.0 | 0.00 | 0 | 120.3 | 0.6 | 60.1 | 45 | 26.80 | -2.7 | 25 | Disconnected | 13.00 | Inverting | No error | On | Ok | Ok | Ok | Ok | Ok | Ok | Ok | Ok | Ok | Ok | Ok | Ok | Ok | Ok | Ok | Ok | Ok | Ok | Bulk | Not ignored | 26 | 27 | 26.80 | 5.40 | 27 | 50.0 | 100.0 | 27.6 | 23.1 | 279.9 | 279.9 | No alarm | No alarm
2023-06-26 19:48:19 | 1 |  |  |  |  | Generator start/stop | Manual
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
