natecostello/van_two_point_oh/blog/2023-6-26-bms-failure/firmware-update.png

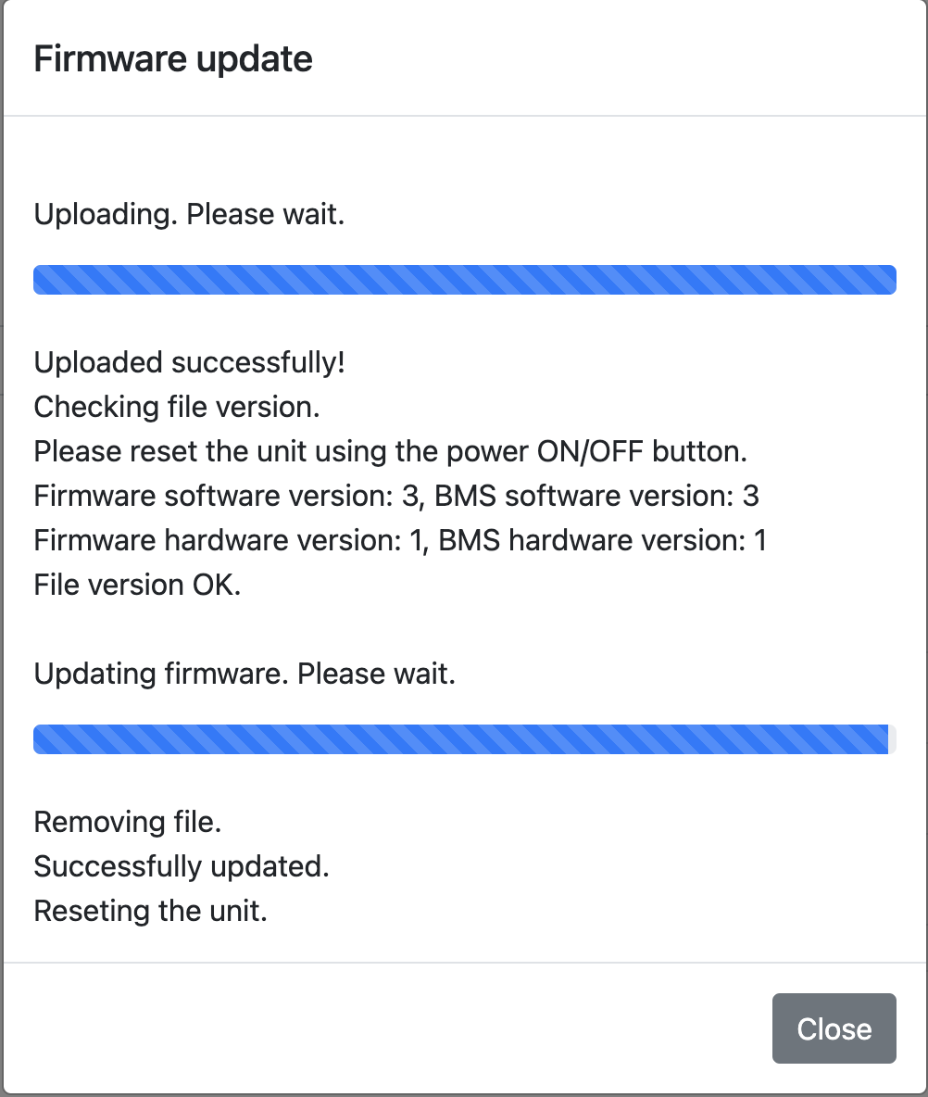
blog/2023-6-26-bms-failure/firmware-update.png
