natecostello/van_two_point_oh/blog/2022-5-14-BMS-firmware-update/2022-5-14-max_cell_vs_CCL_new_firmware.pdf

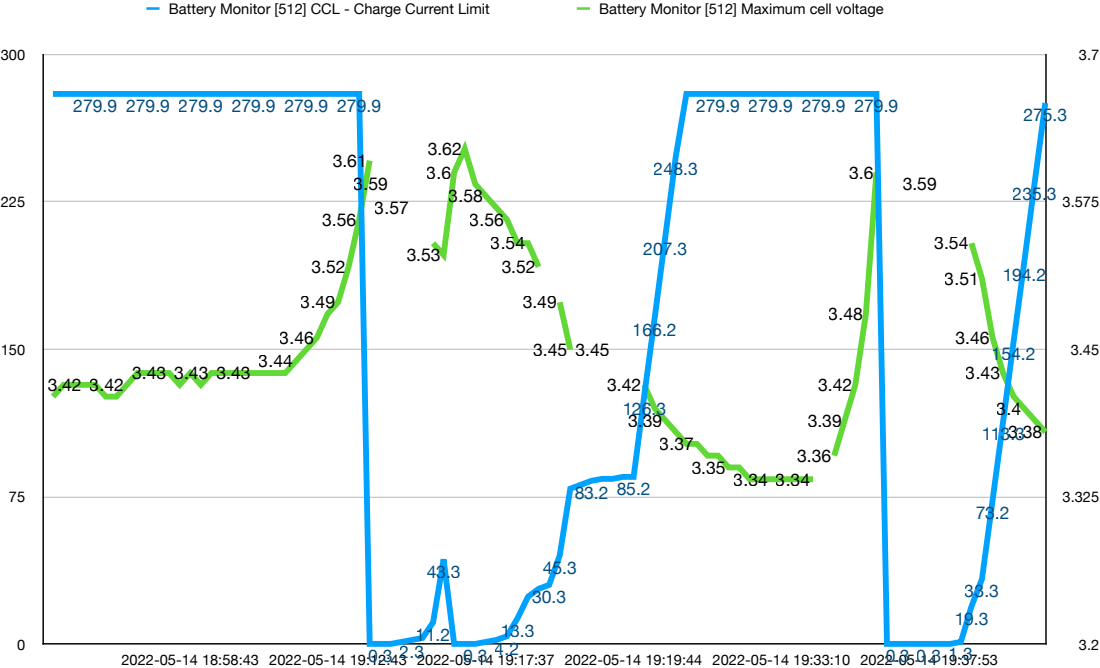
[picture p523: page 1]
Battery Monitor [512] CCL - Charge Current Limit; Battery Monitor [512] Maximum cell voltage
