natecostello/van_two_point_oh/van/structural/reading-light-mount/bottom-plate-spec-a.pdf

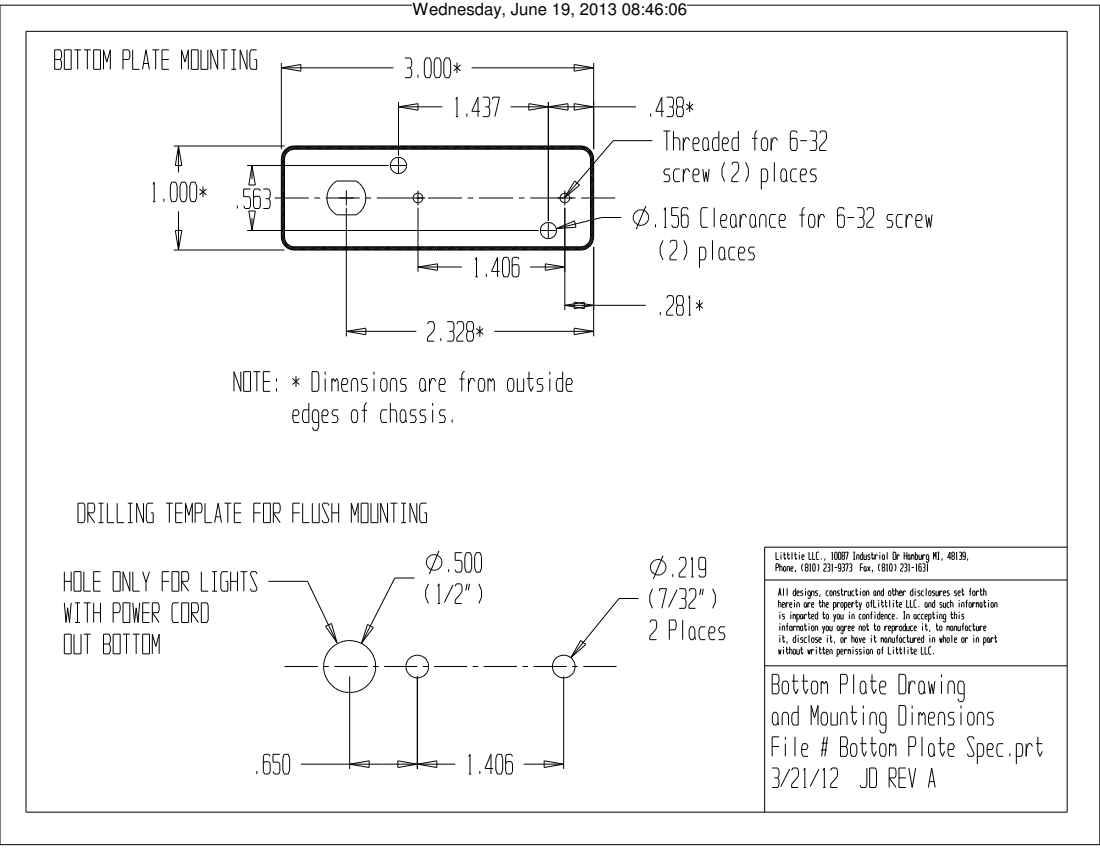
[picture p524: page 1]
Wednesday, June 19, 2013 08:46:06
