natecostello/van_two_point_oh/van/vehicular/weight-balance/factory-weight-specs.pdf

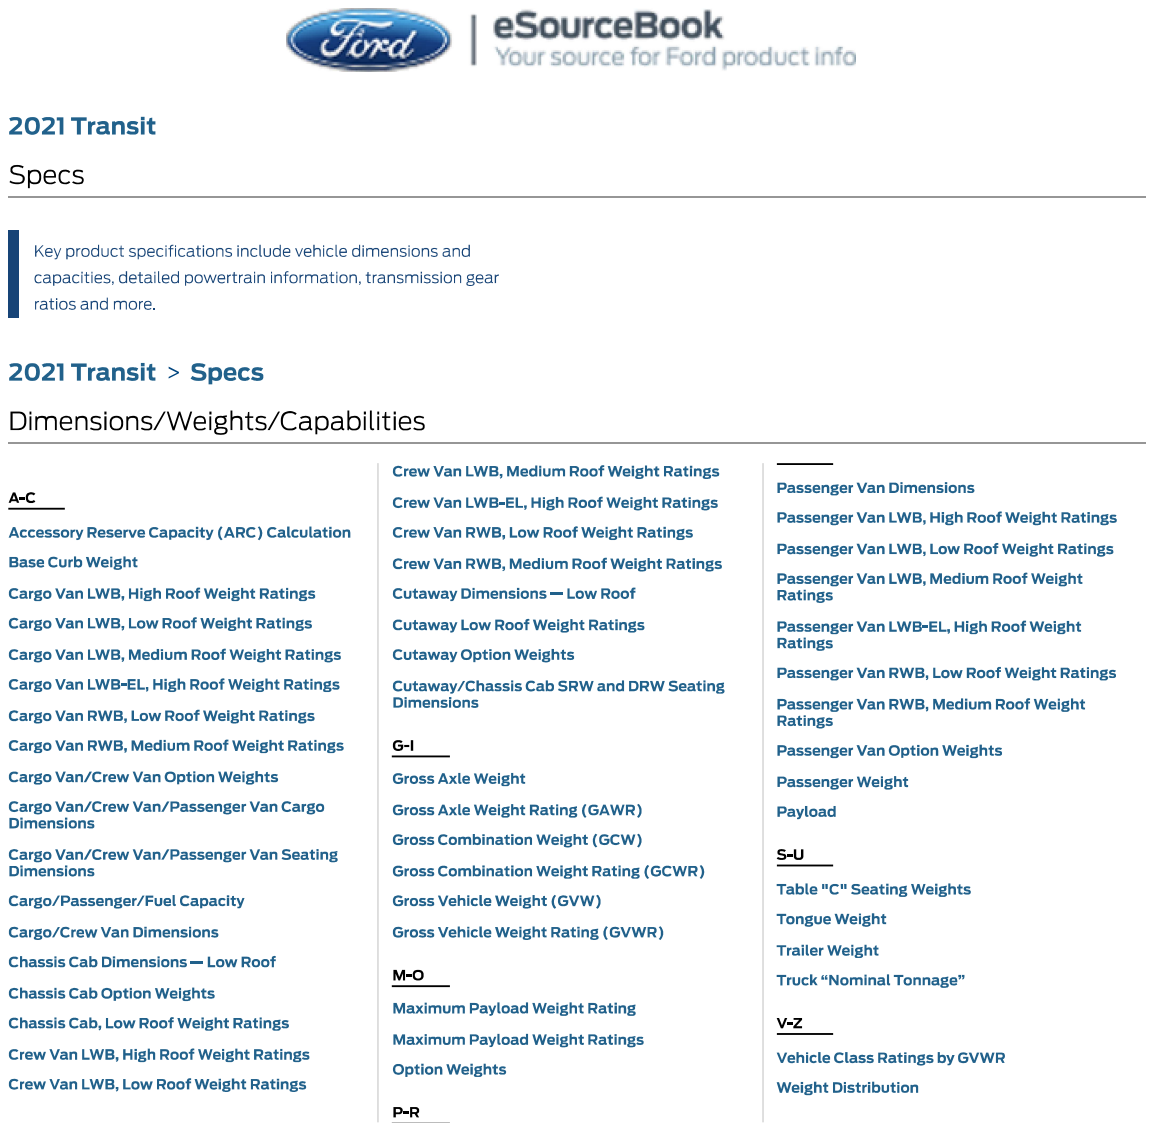
[picture p525: page 1]

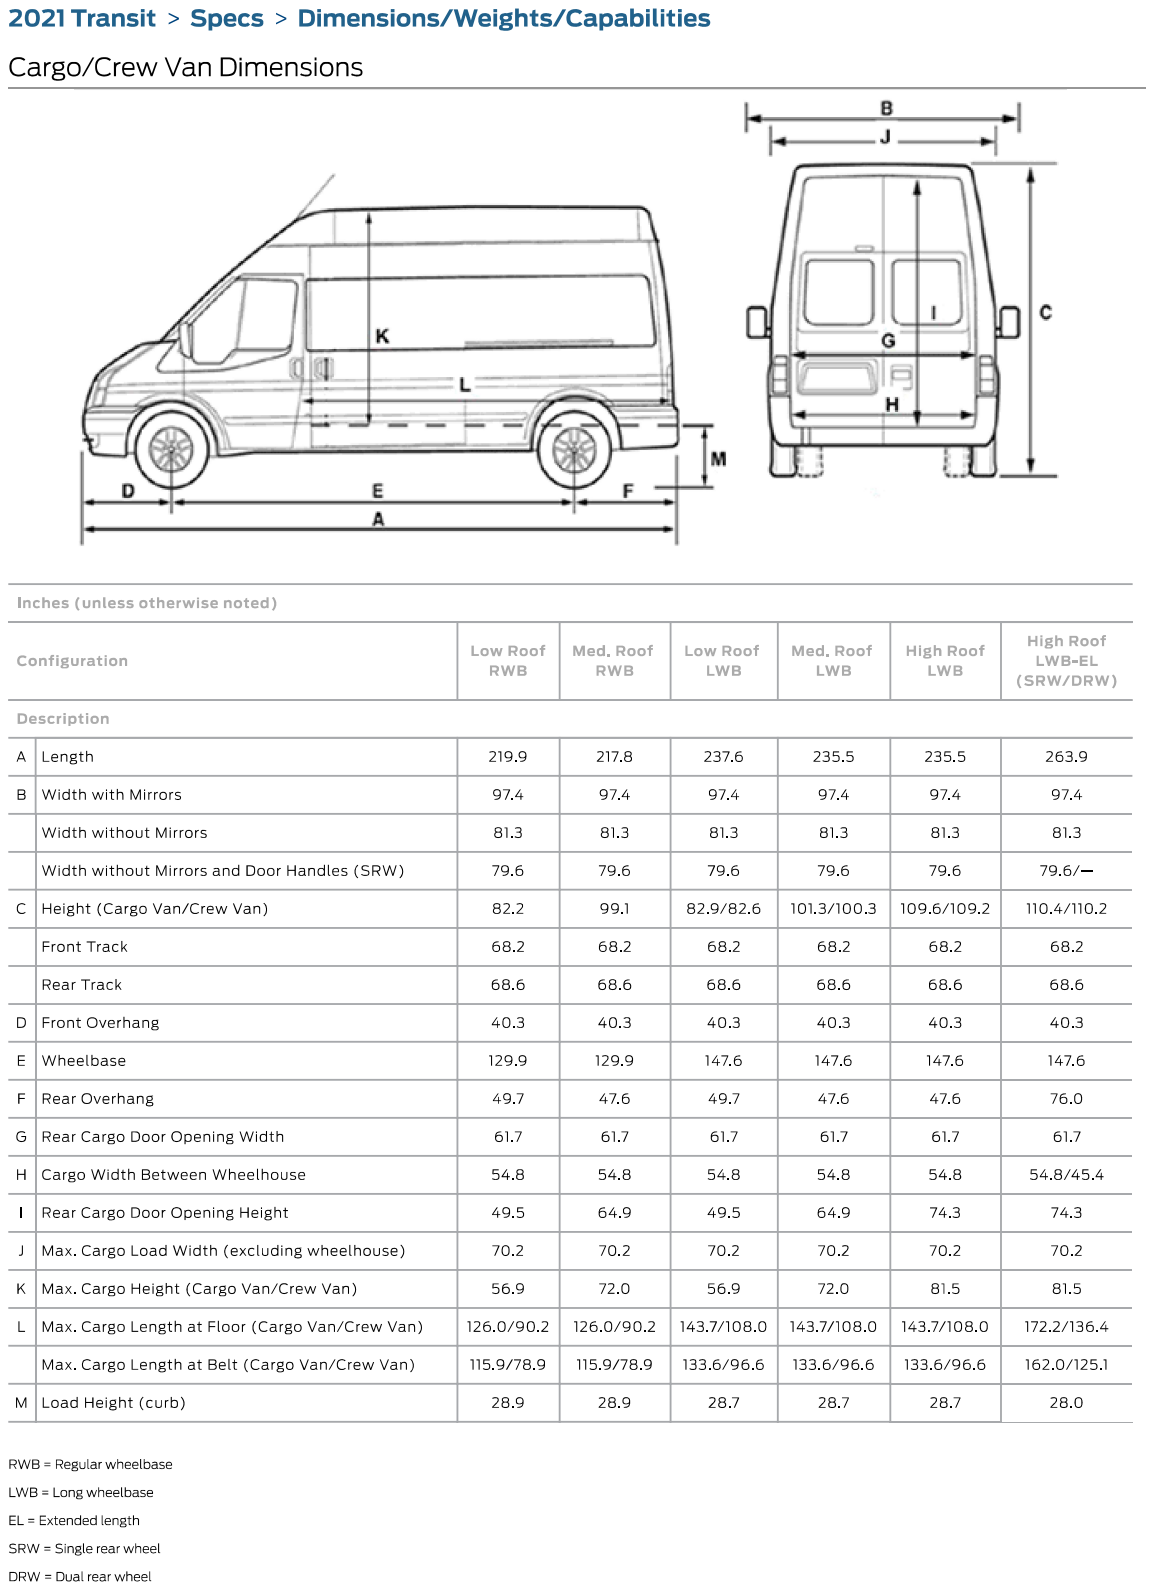
[picture p526: page 2]

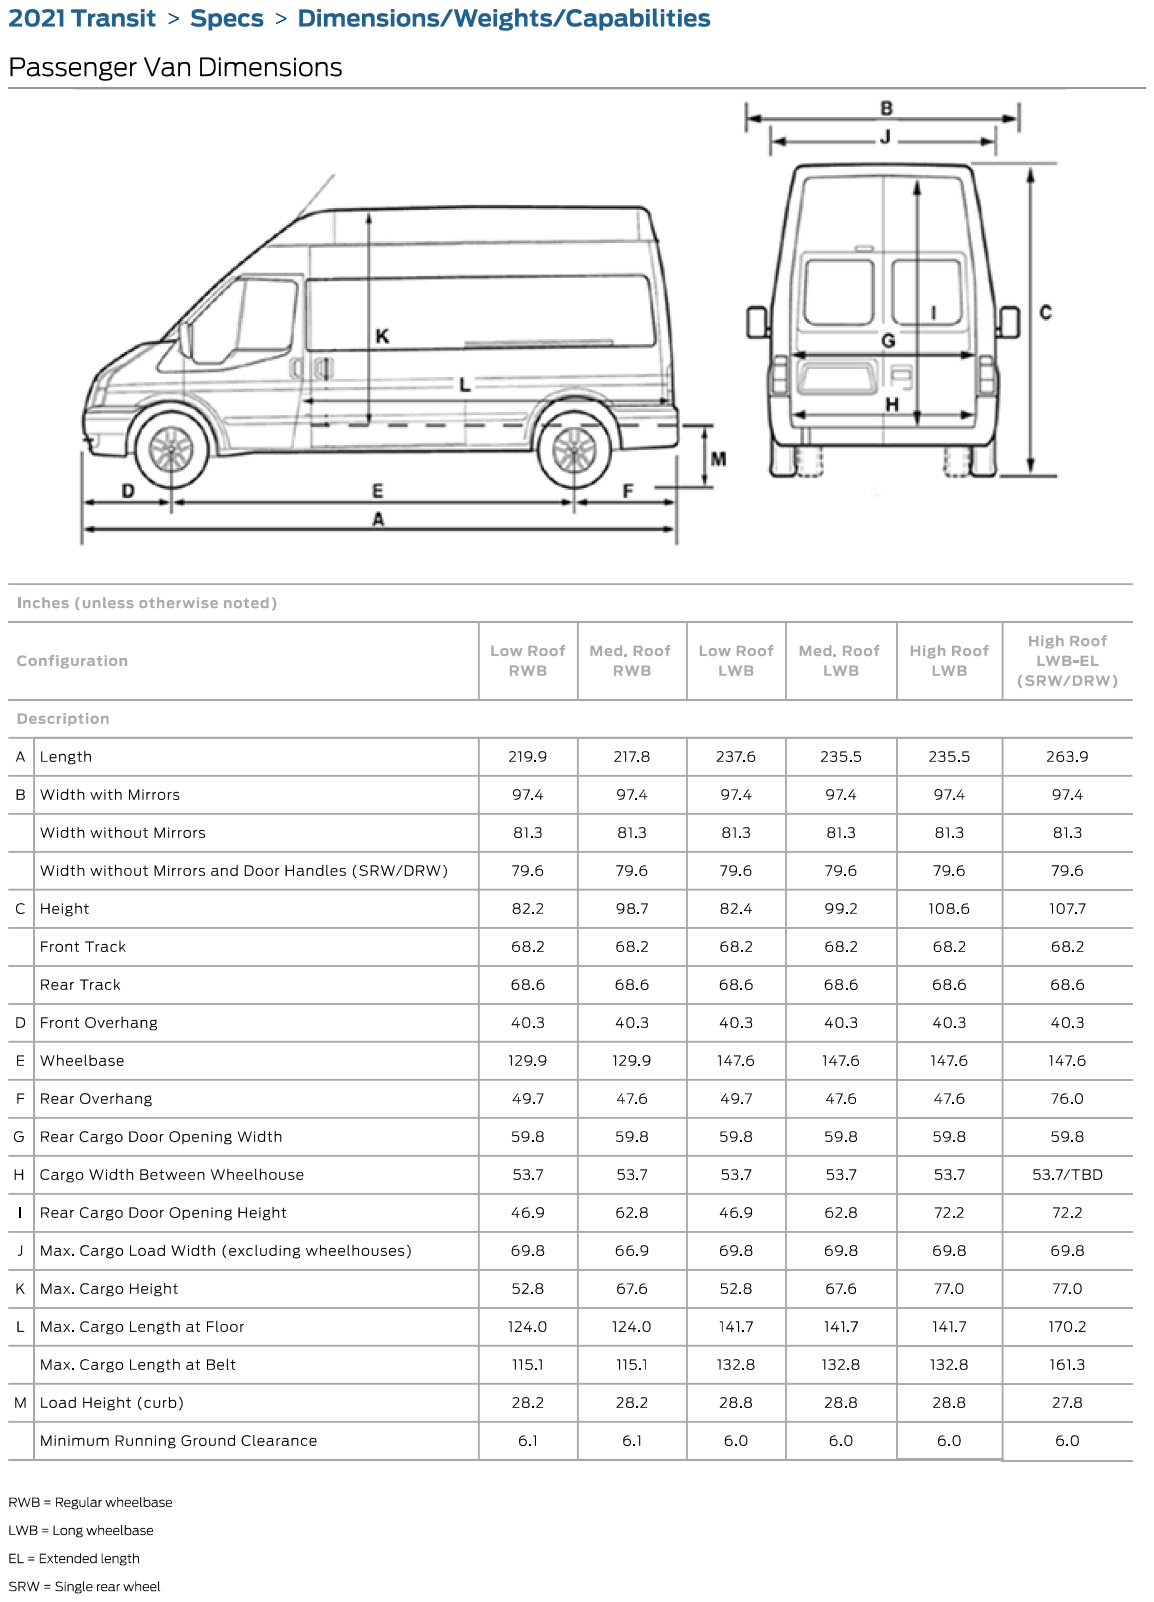
[picture p527: page 4]

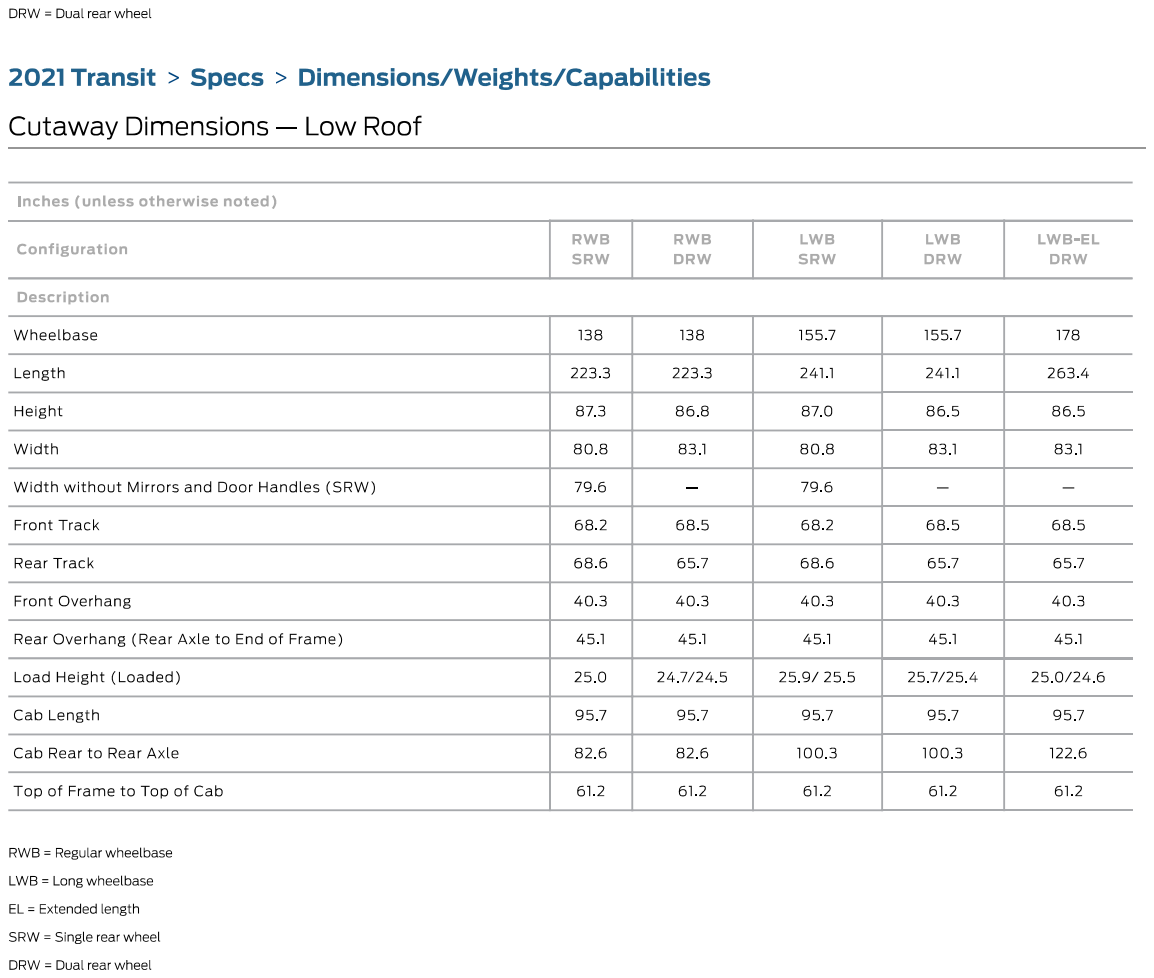
[picture p528: page 5]

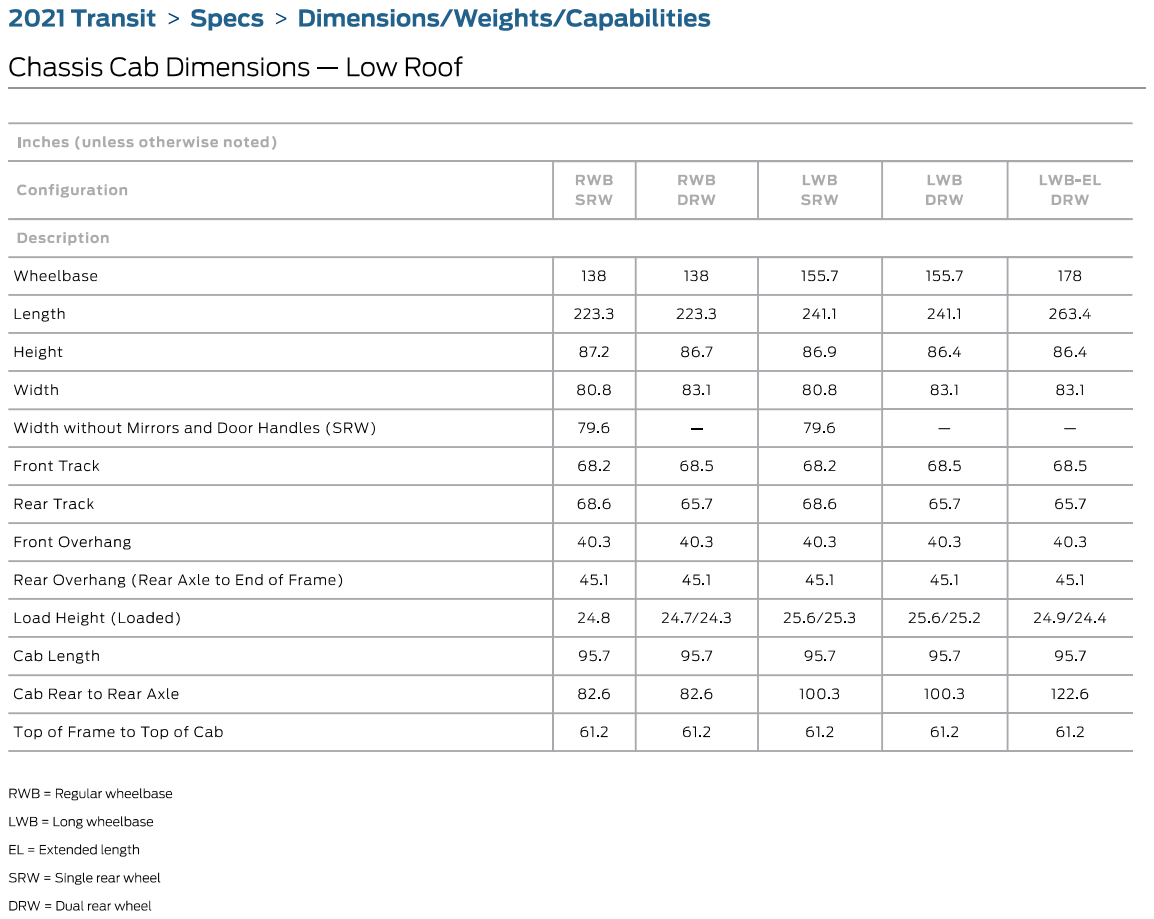
[picture p529: page 6]

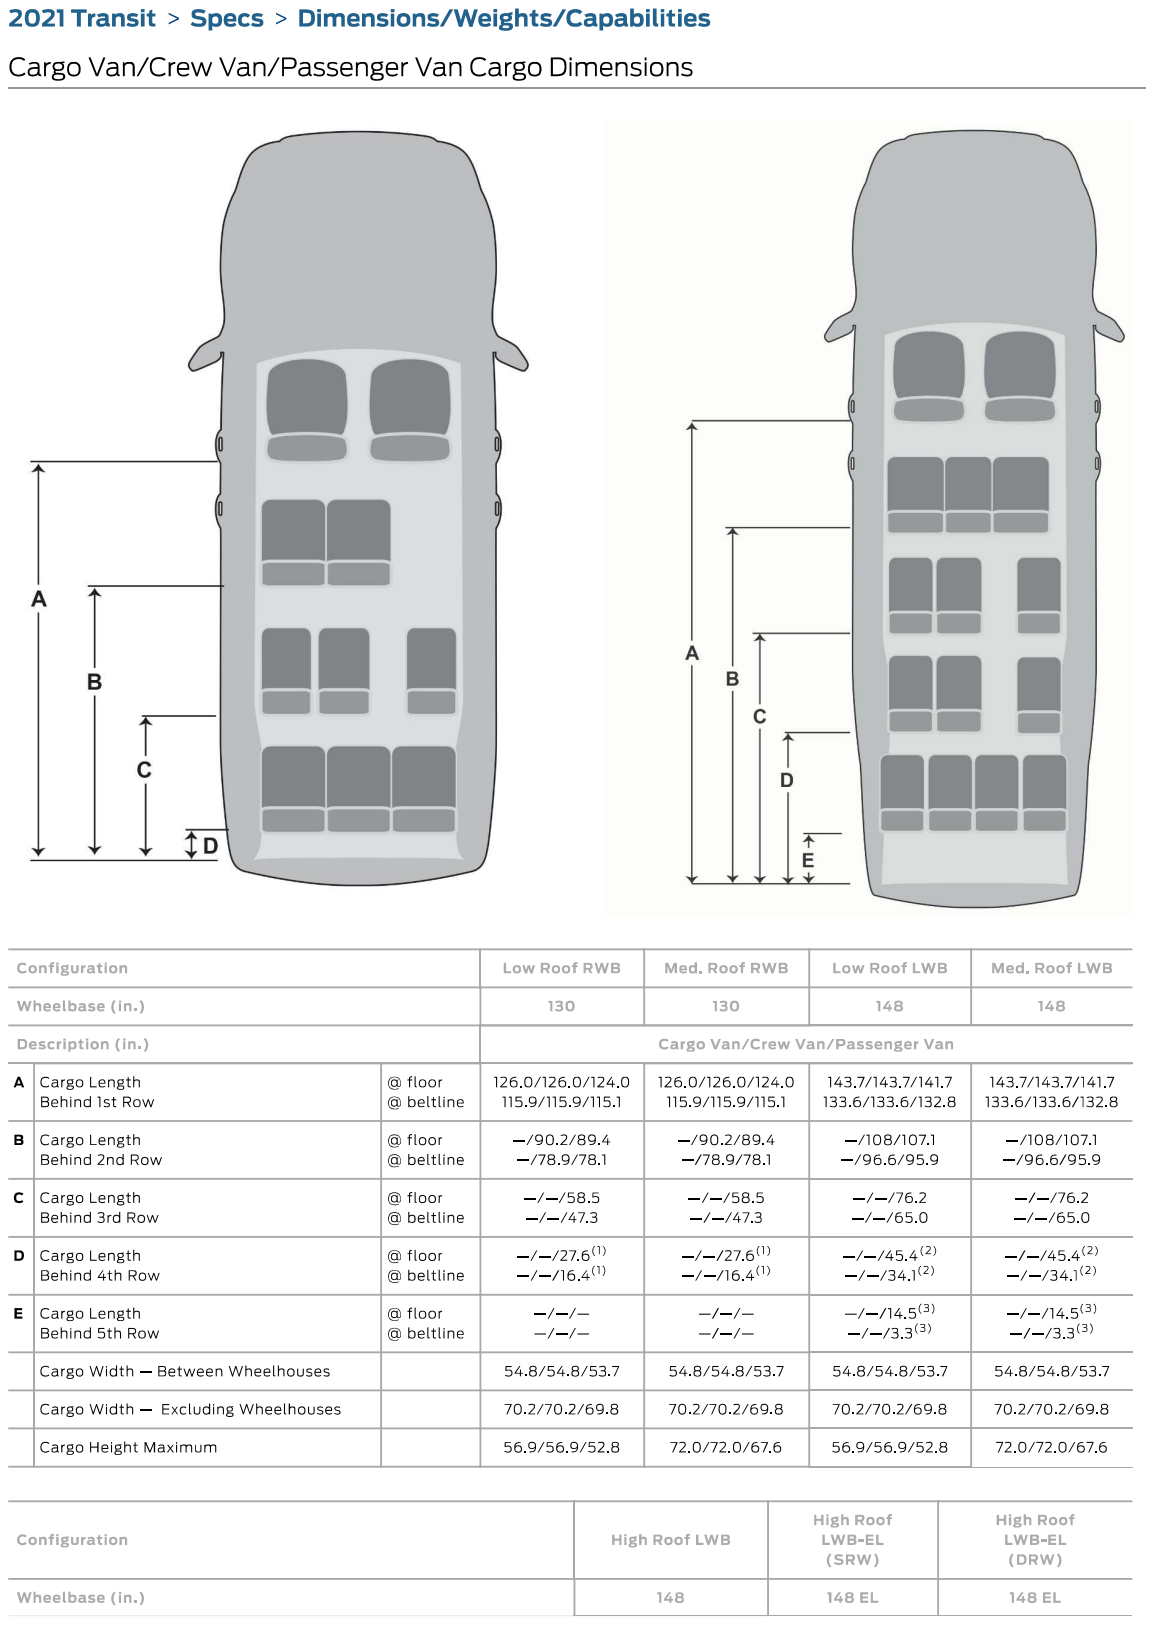
[picture p530: page 7]

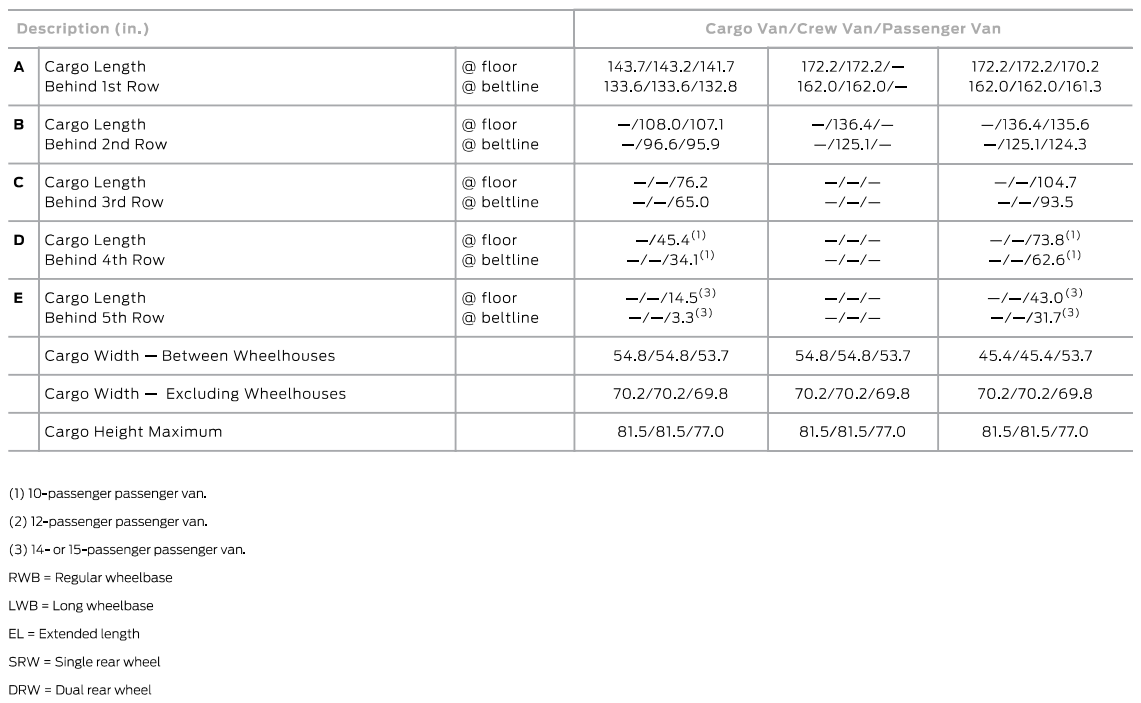
[picture p531: page 8]

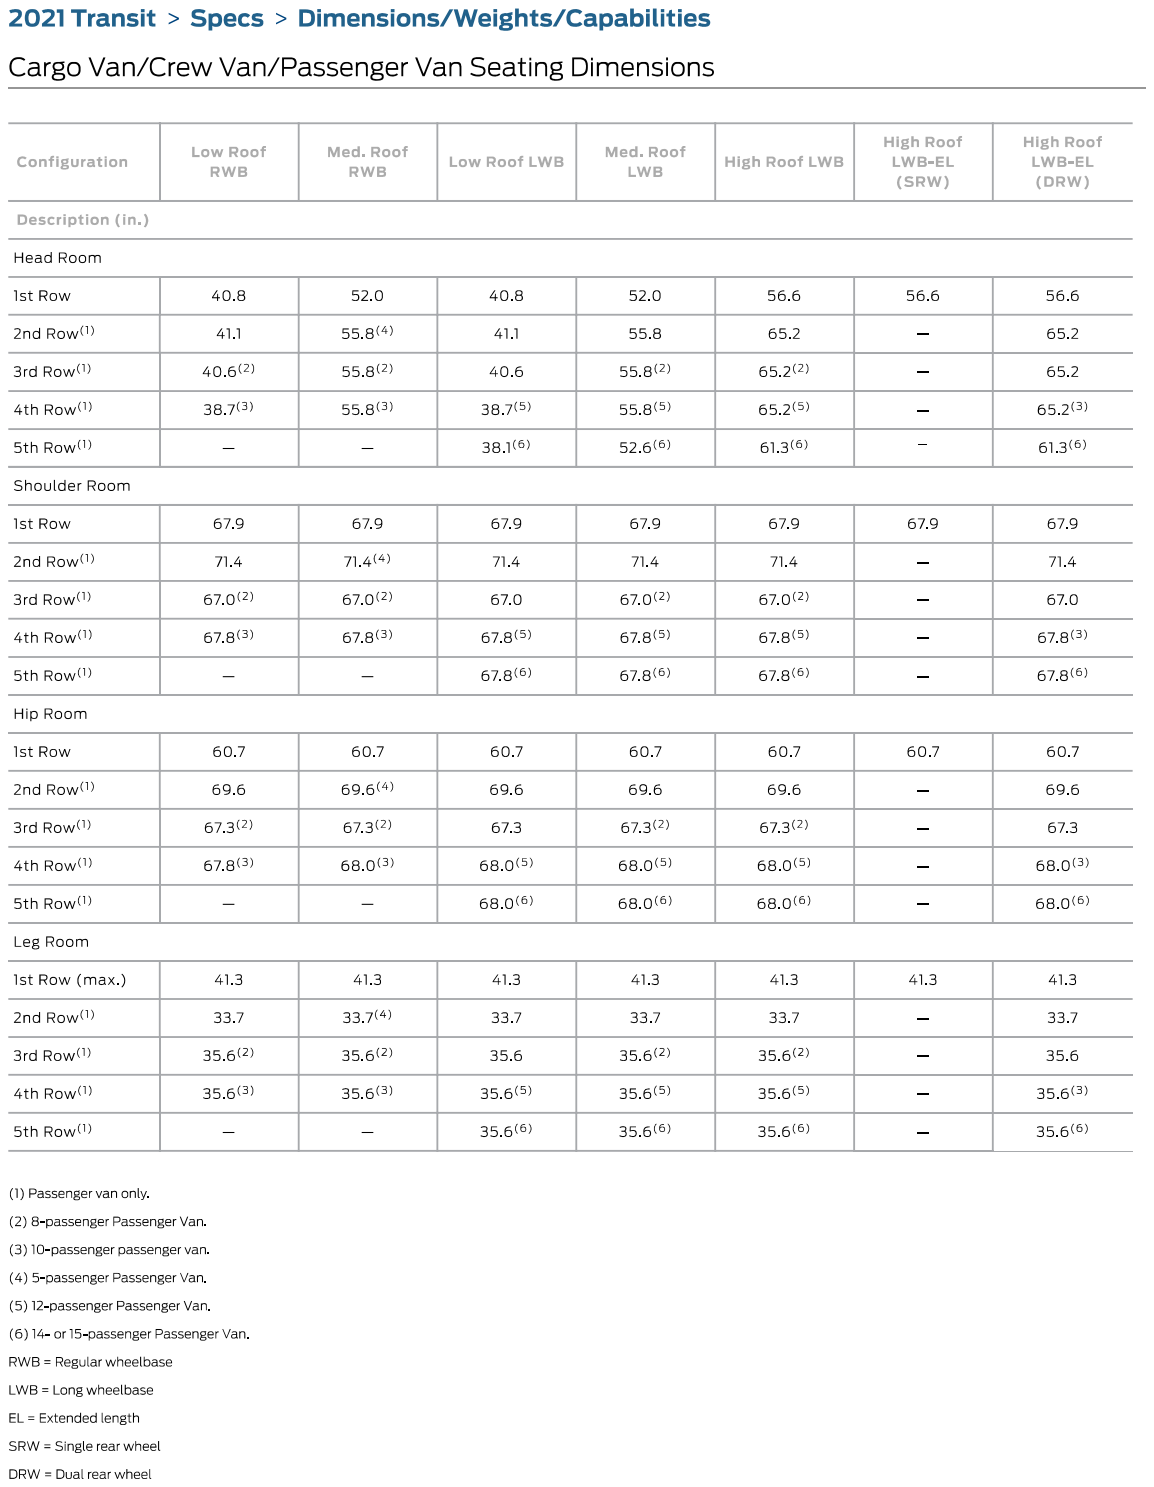
[picture p532: page 9]

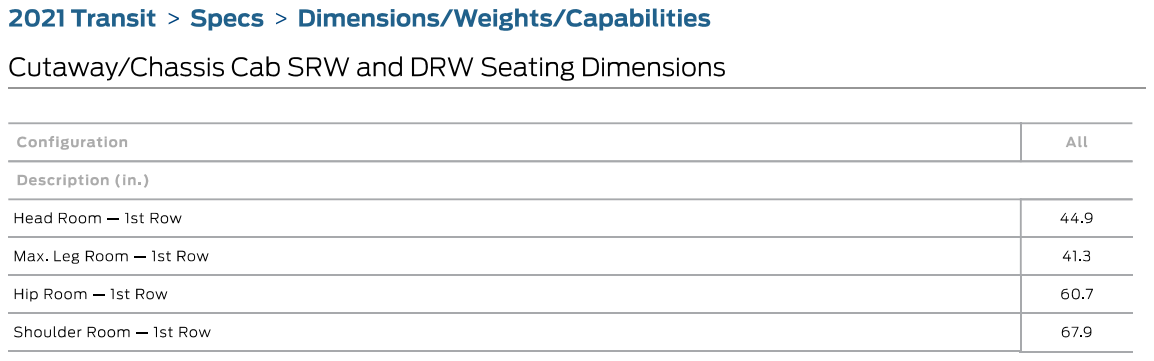
[picture p533: page 10]

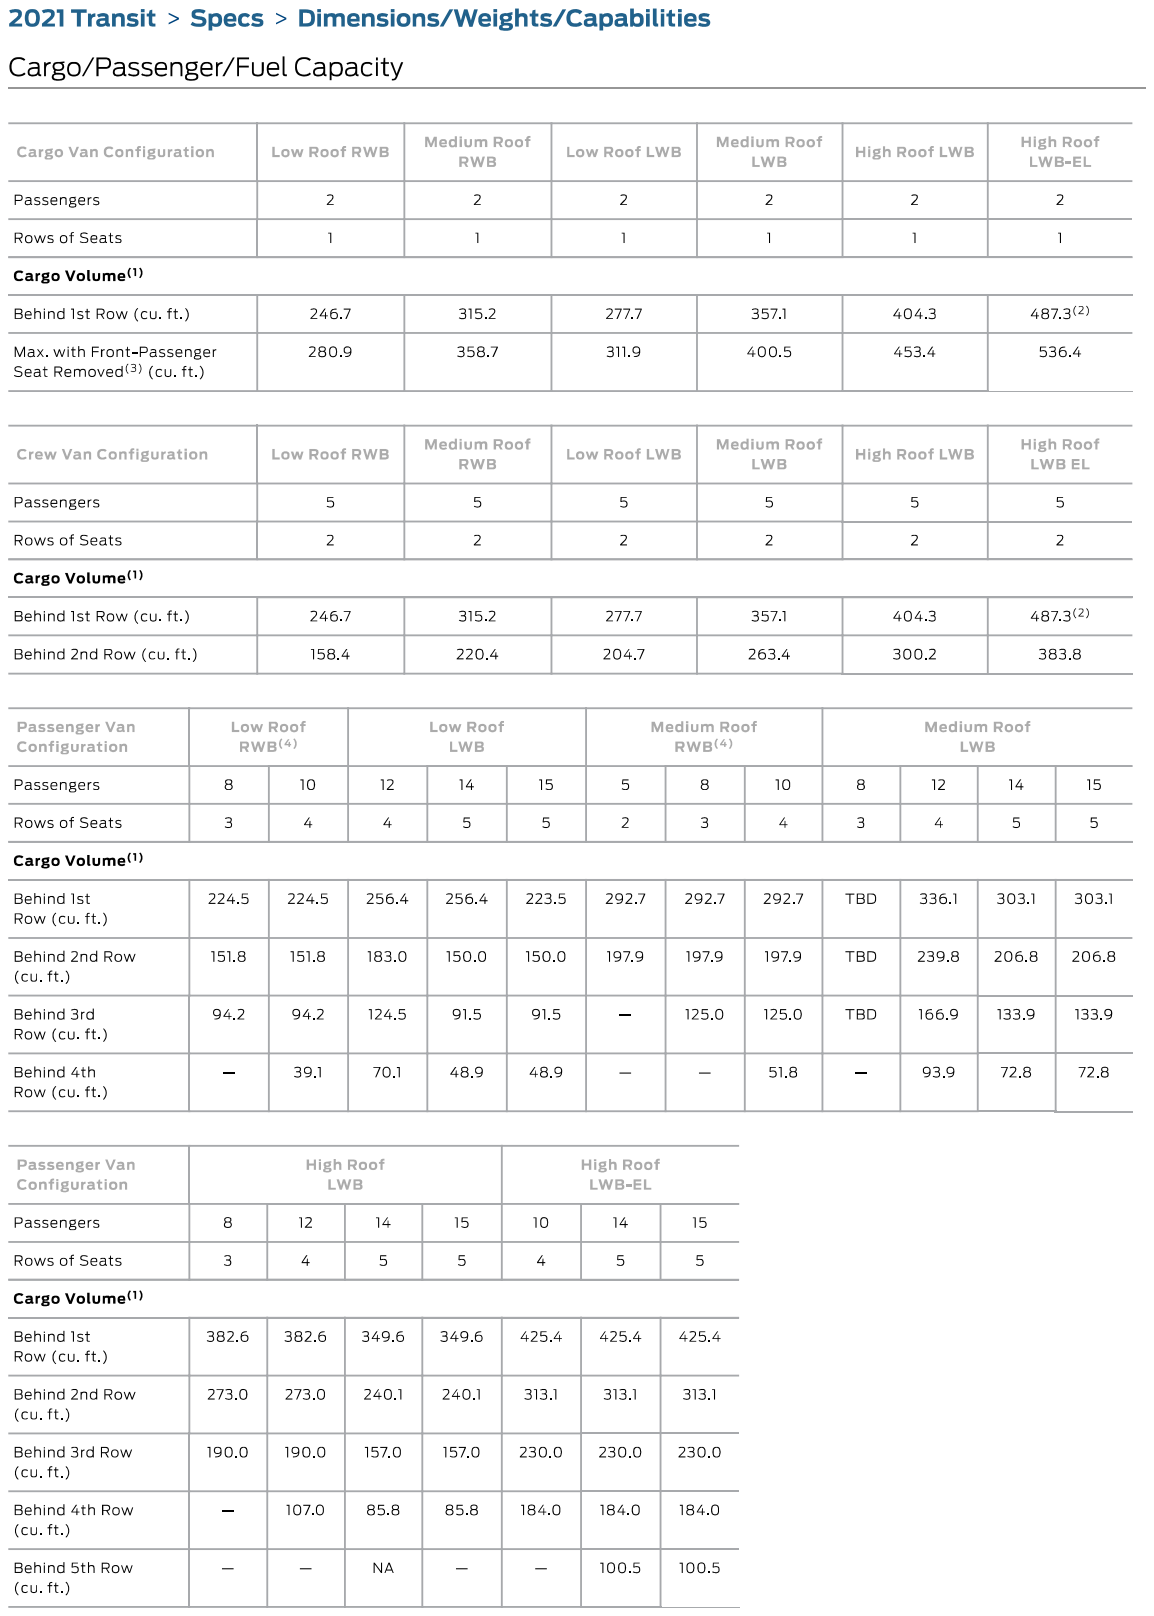
[picture p534: page 11]

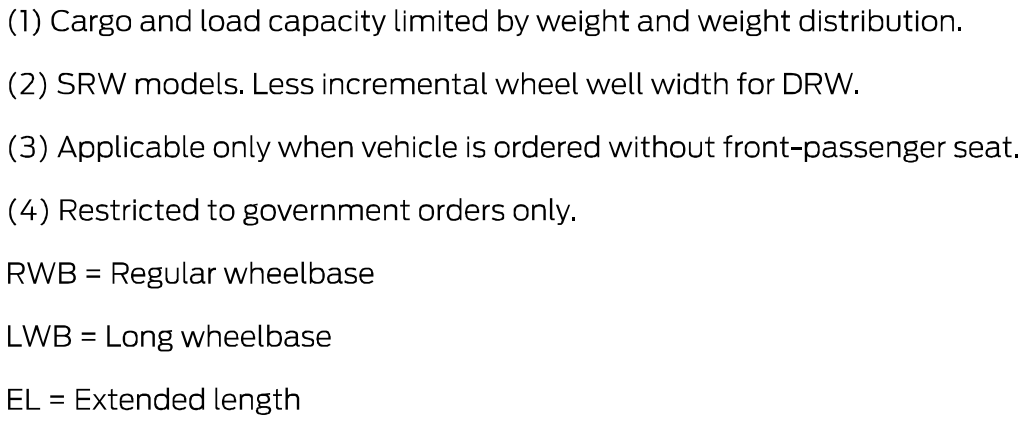
[picture p535: page 12]

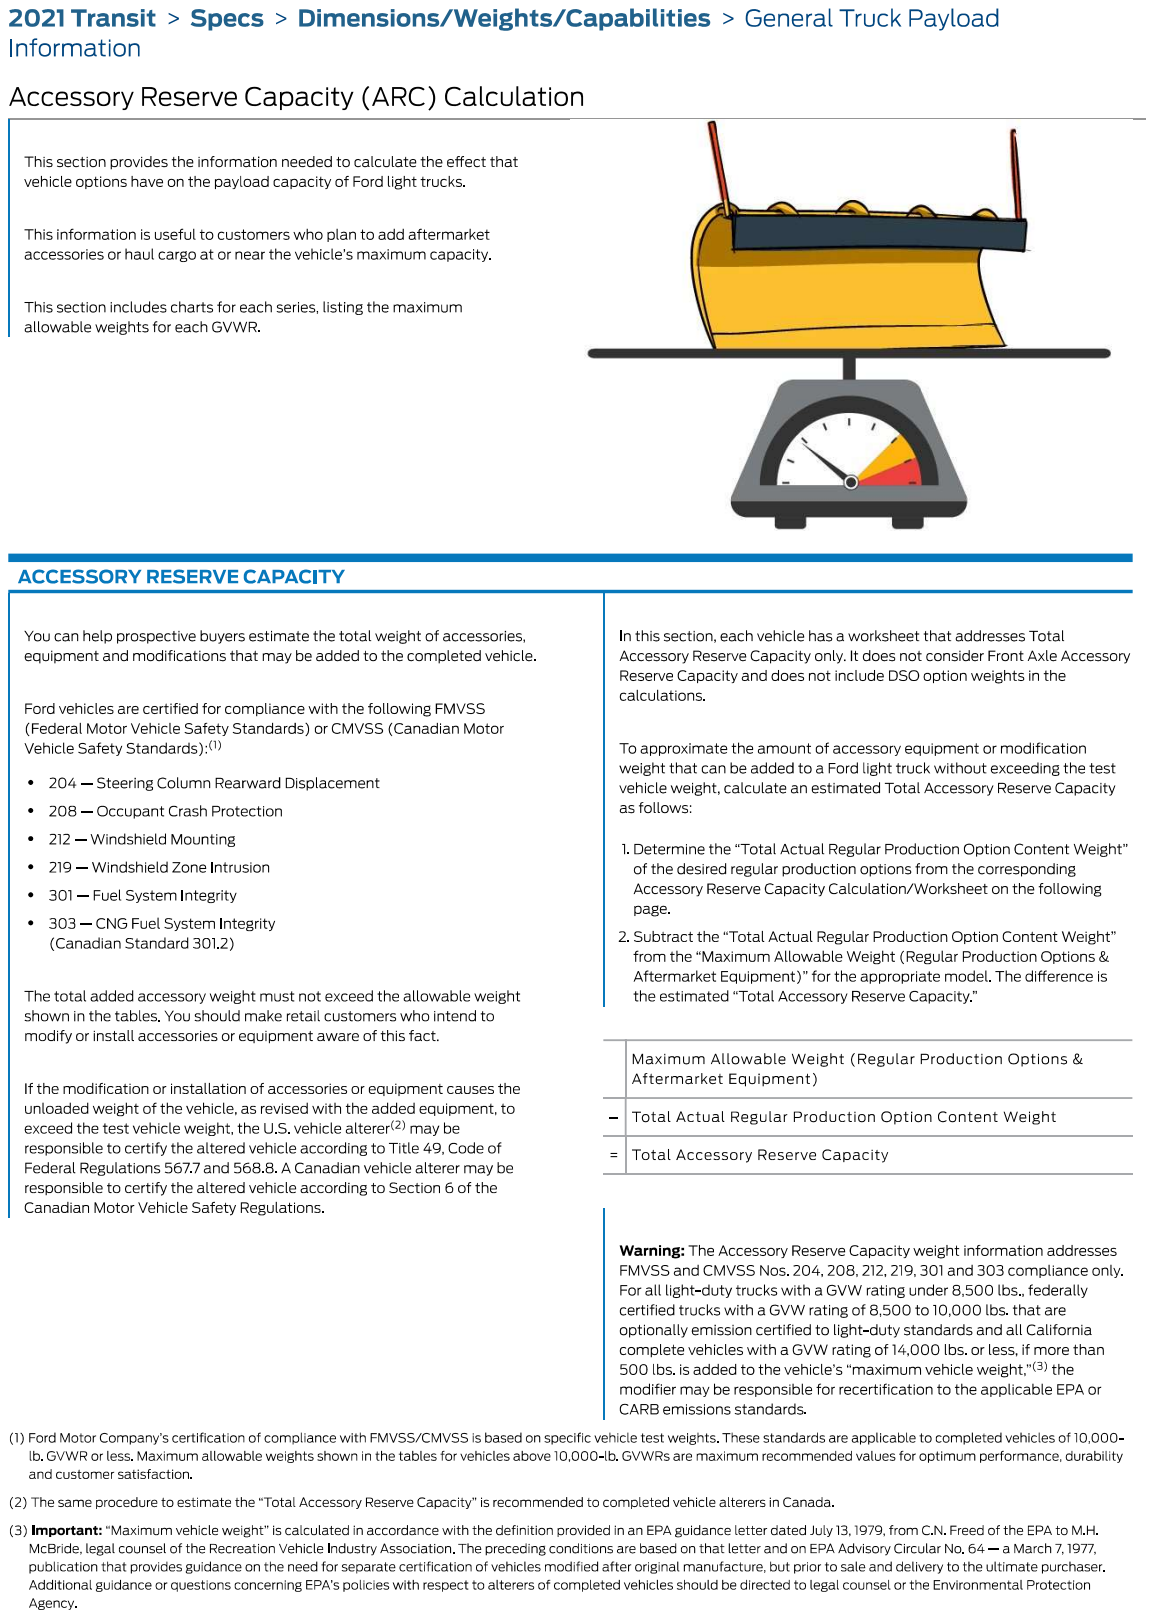
[picture p536: page 13]

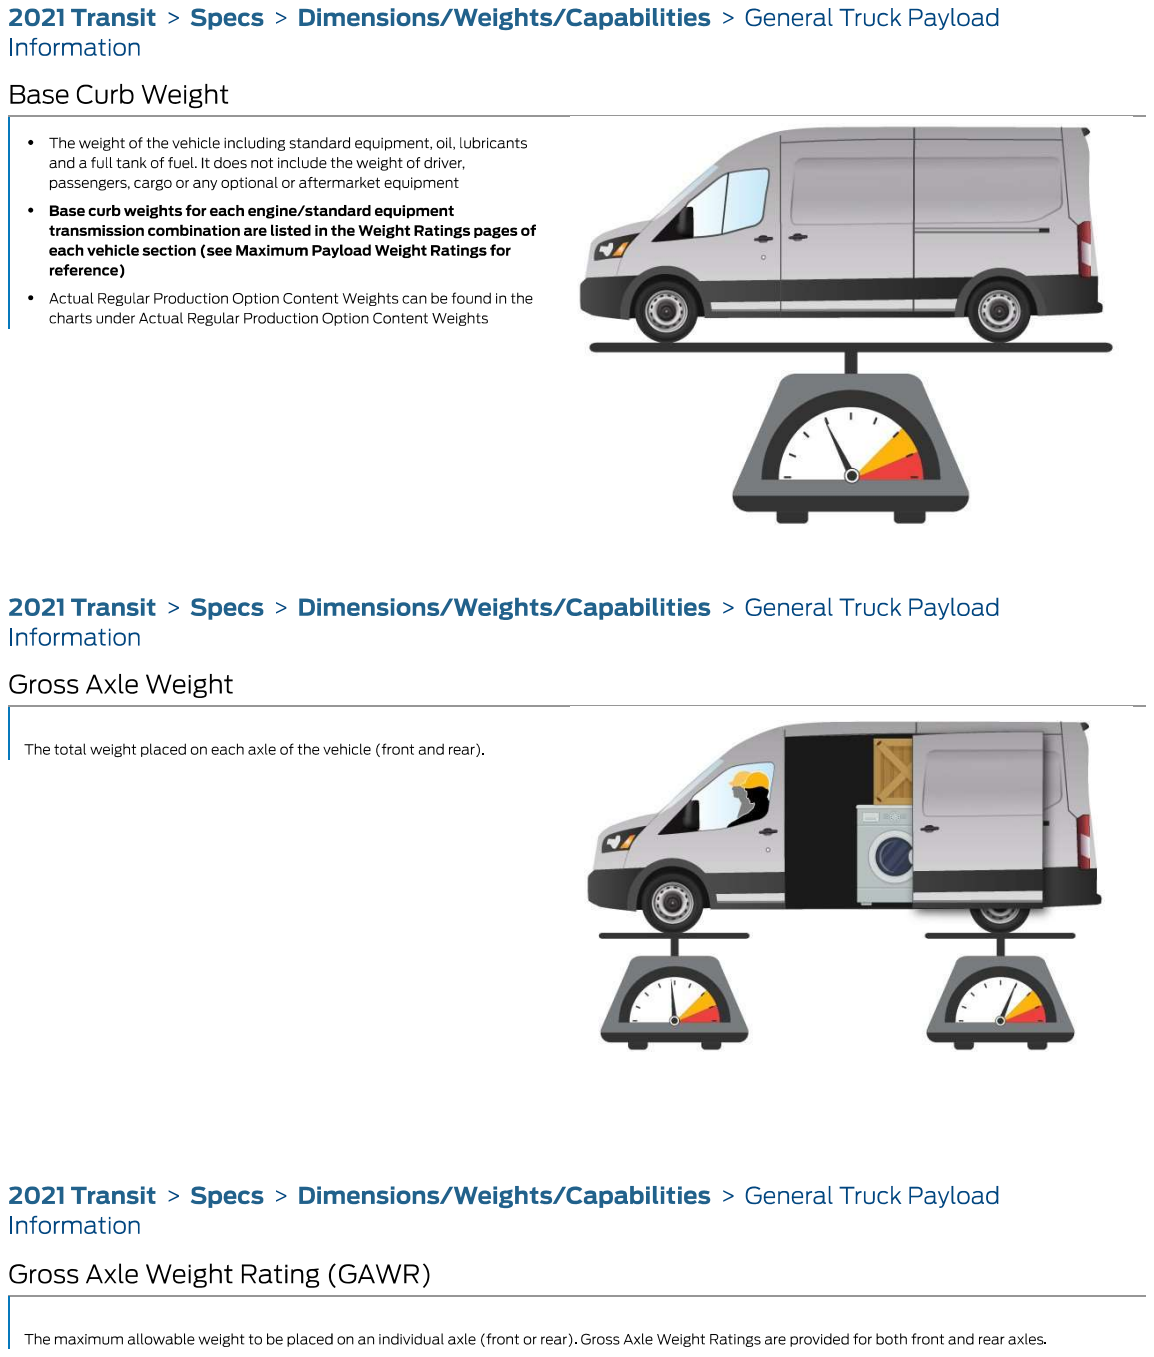
[picture p537: page 14]

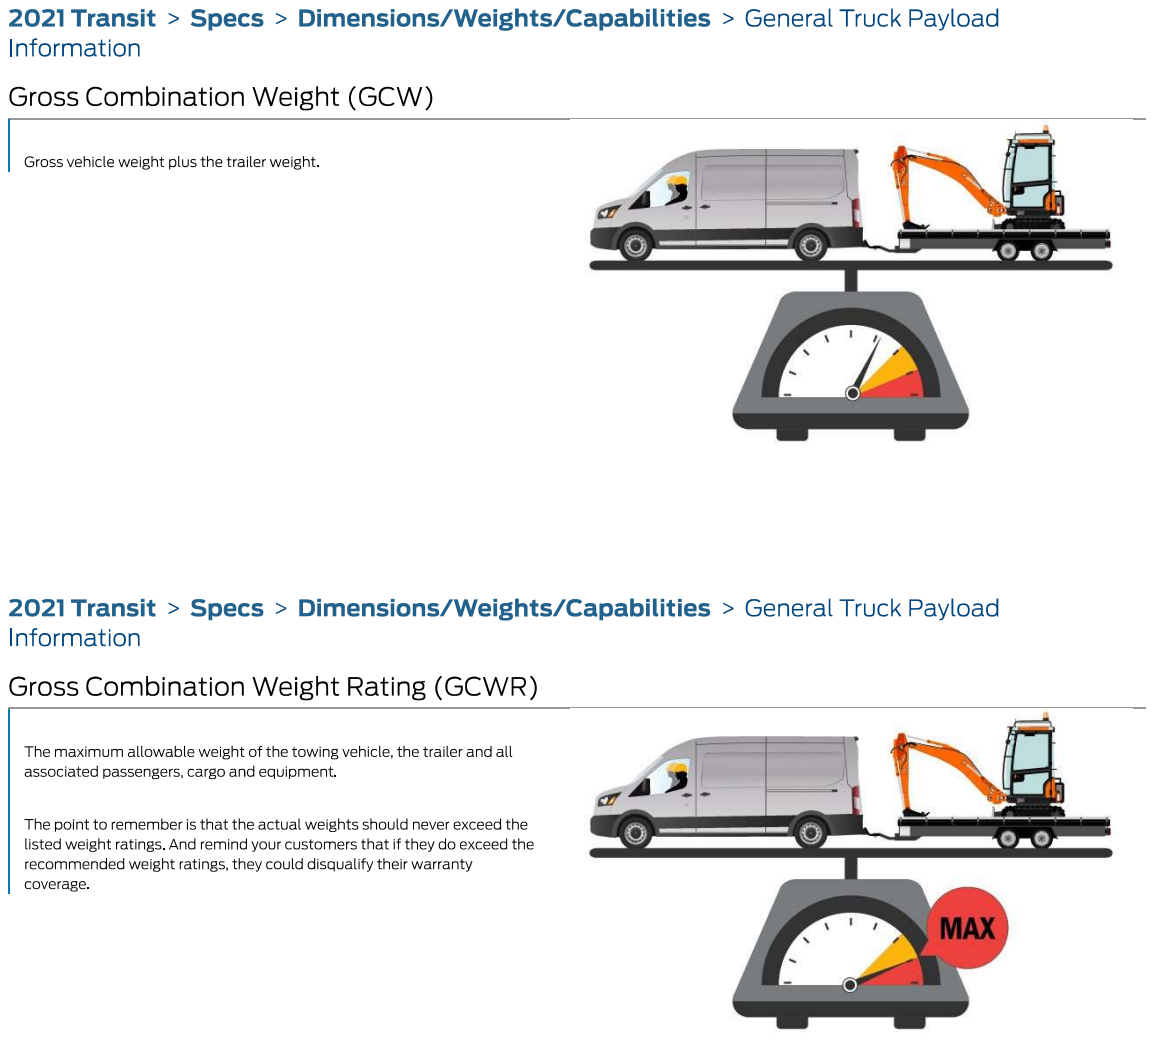
[picture p538: page 15]

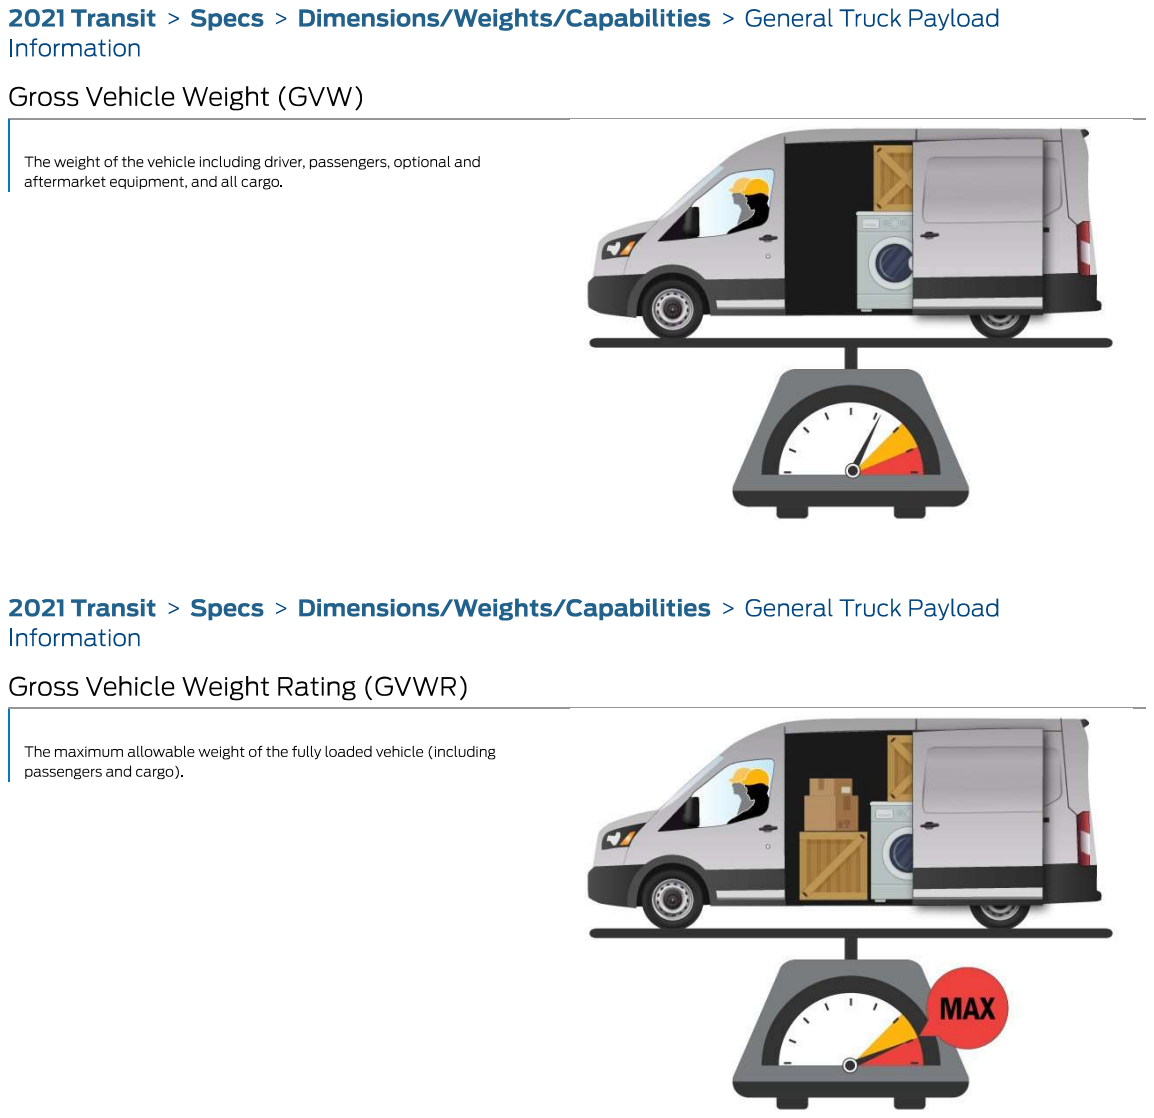
[picture p539: page 16]

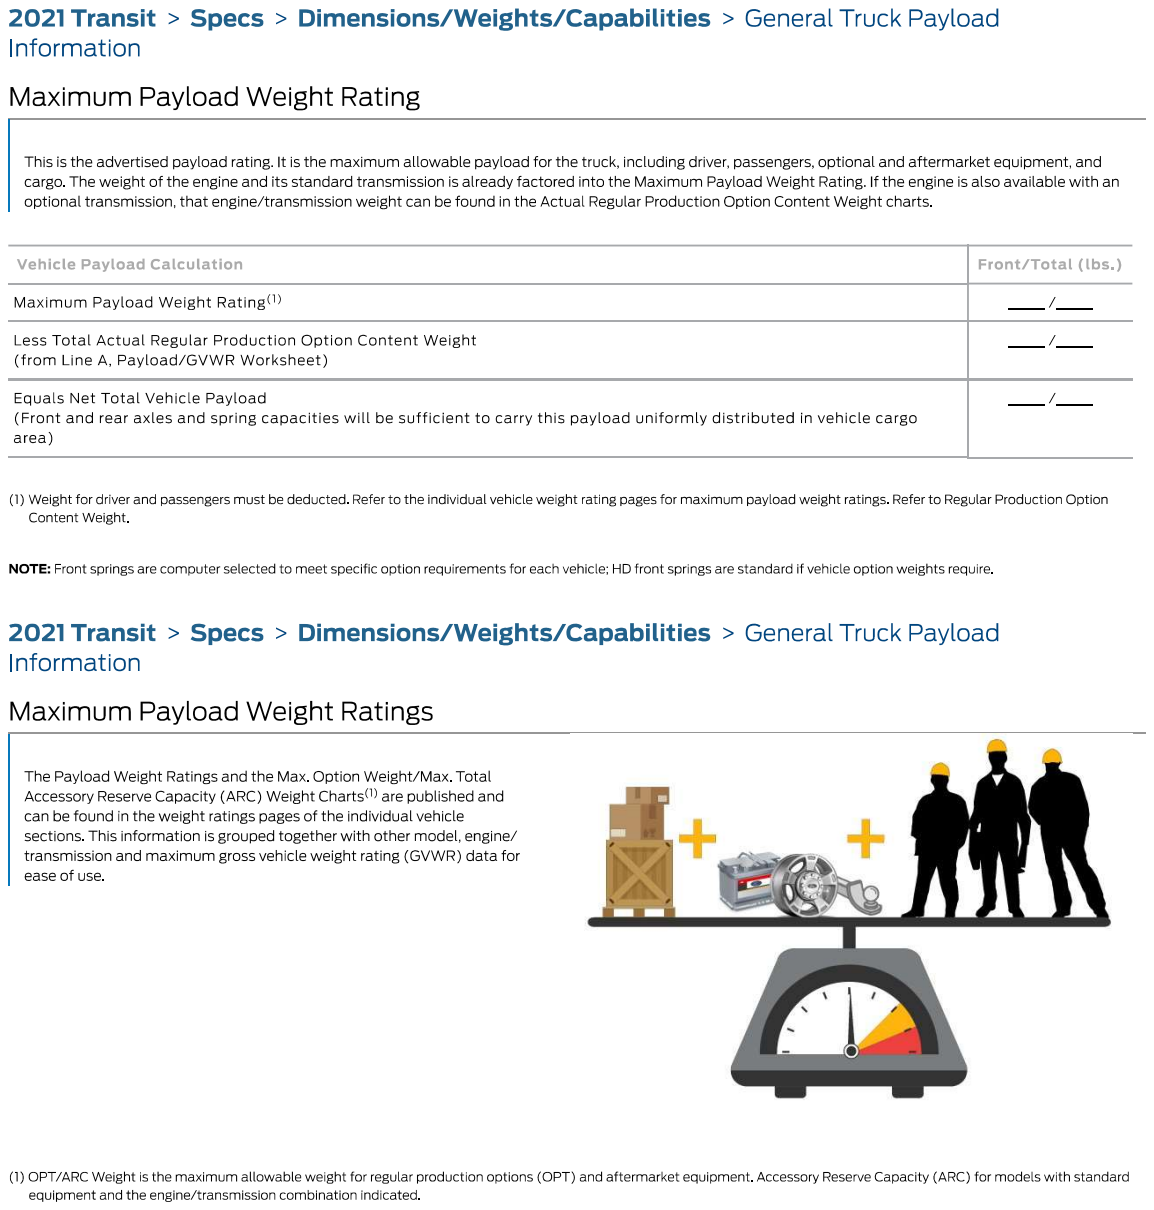
[picture p540: page 17]

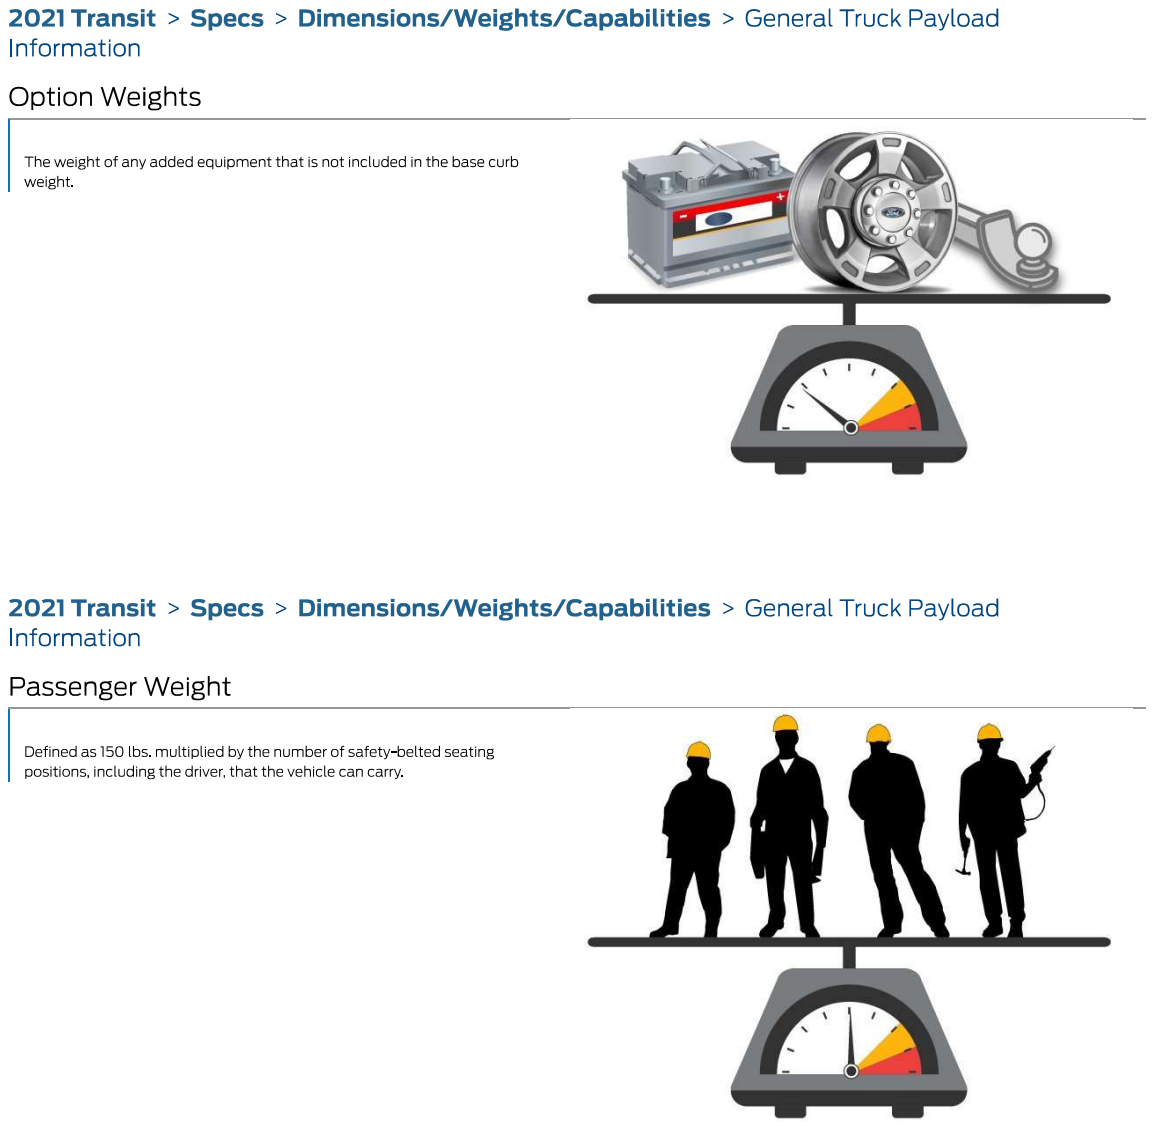
[picture p541: page 18]

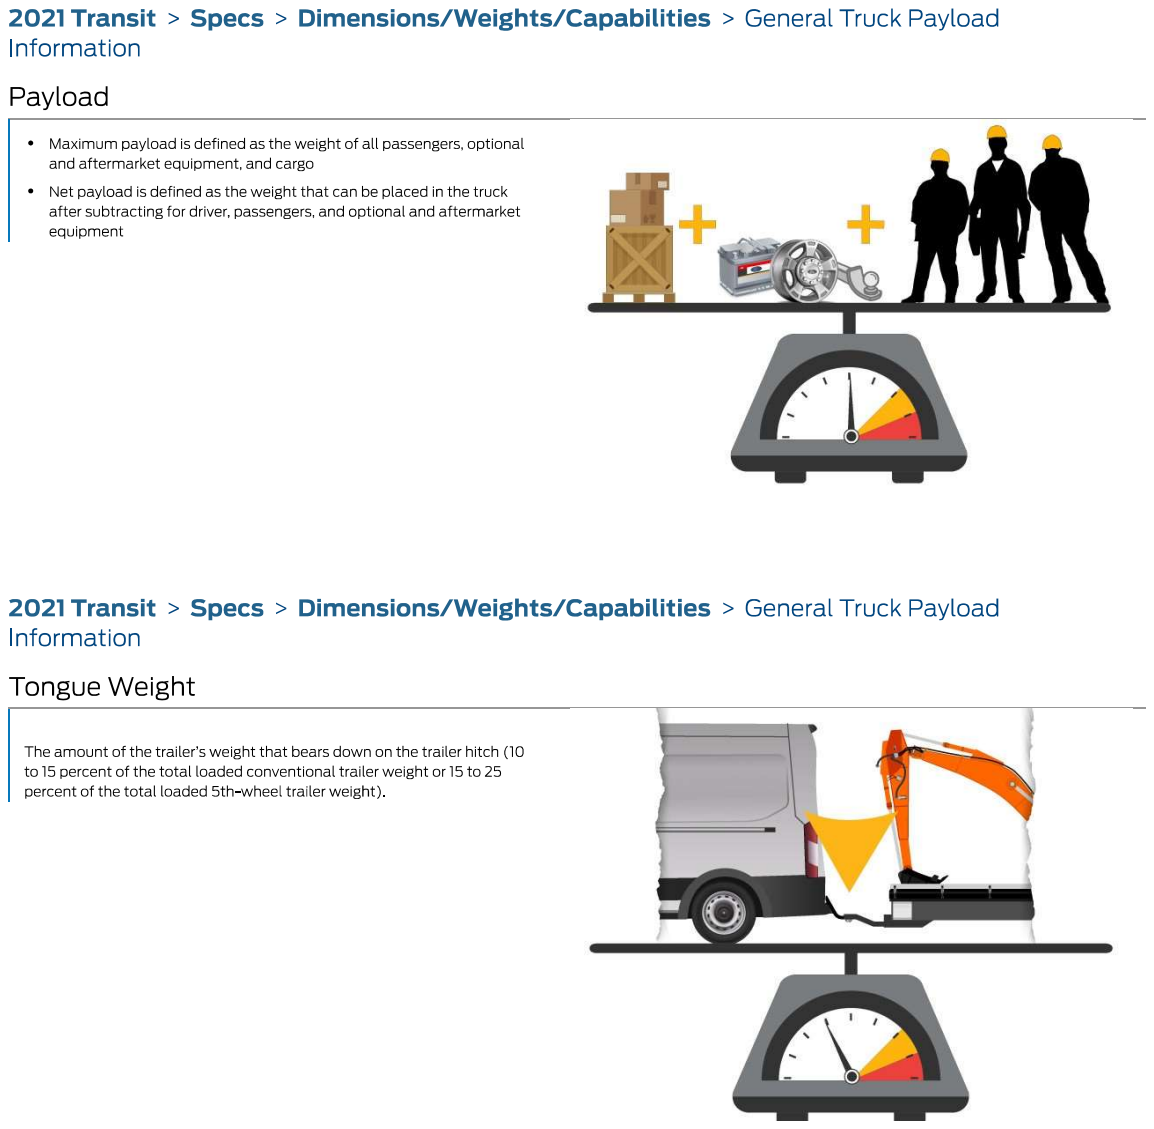
[picture p542: page 19]

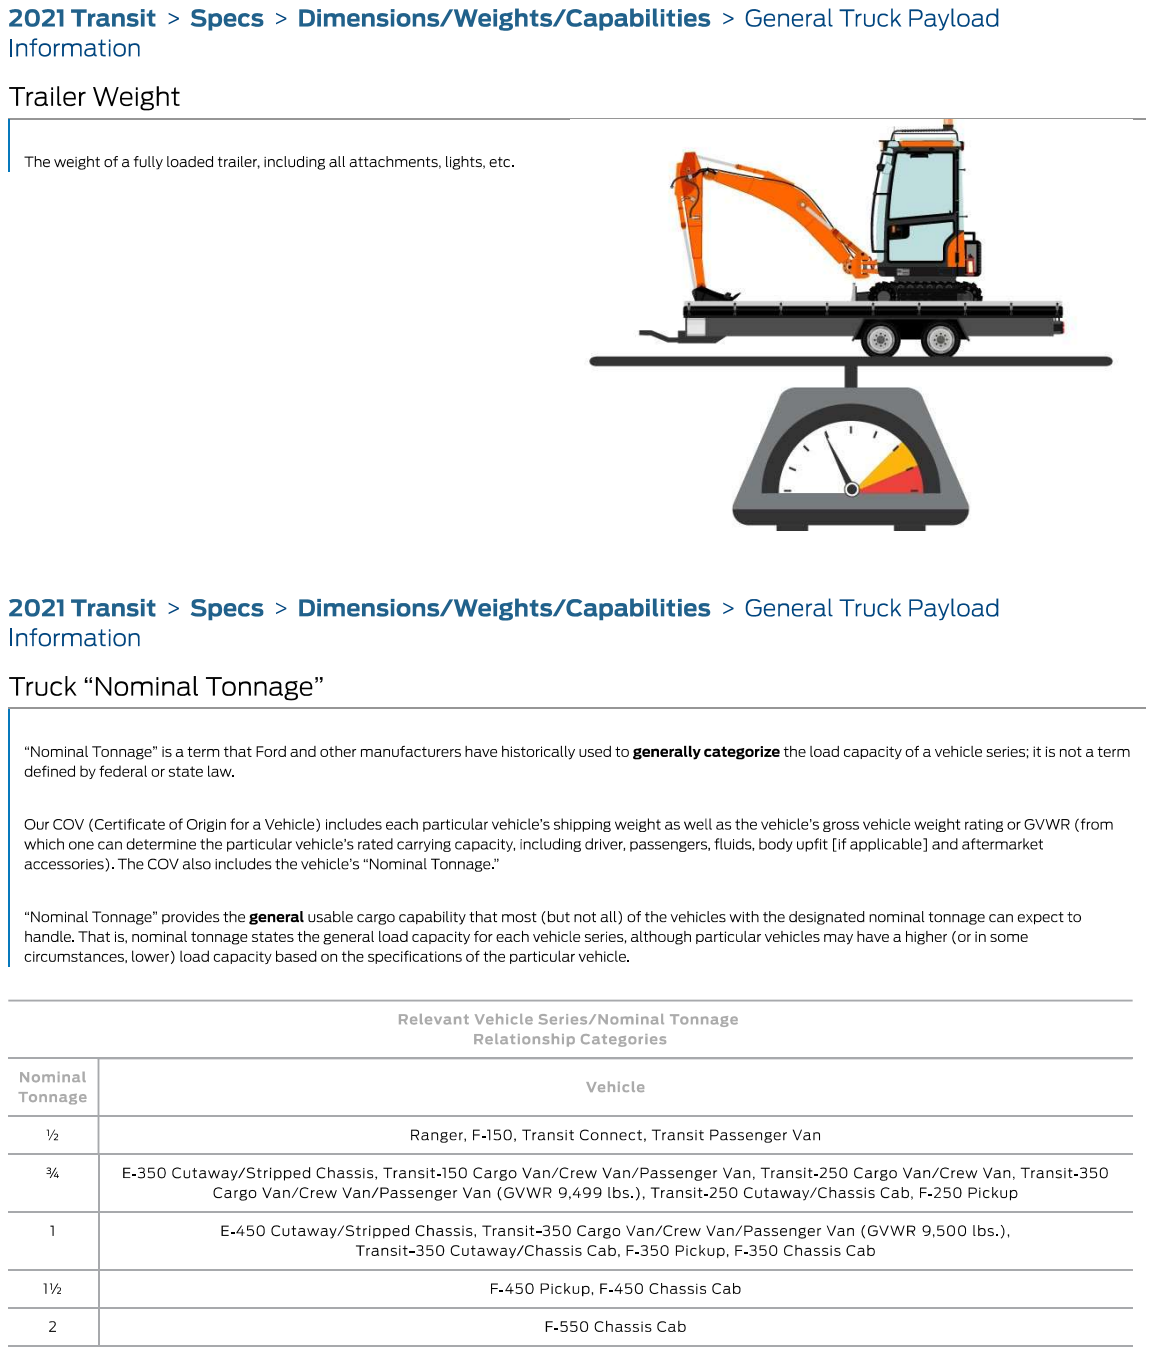
[picture p543: page 20]

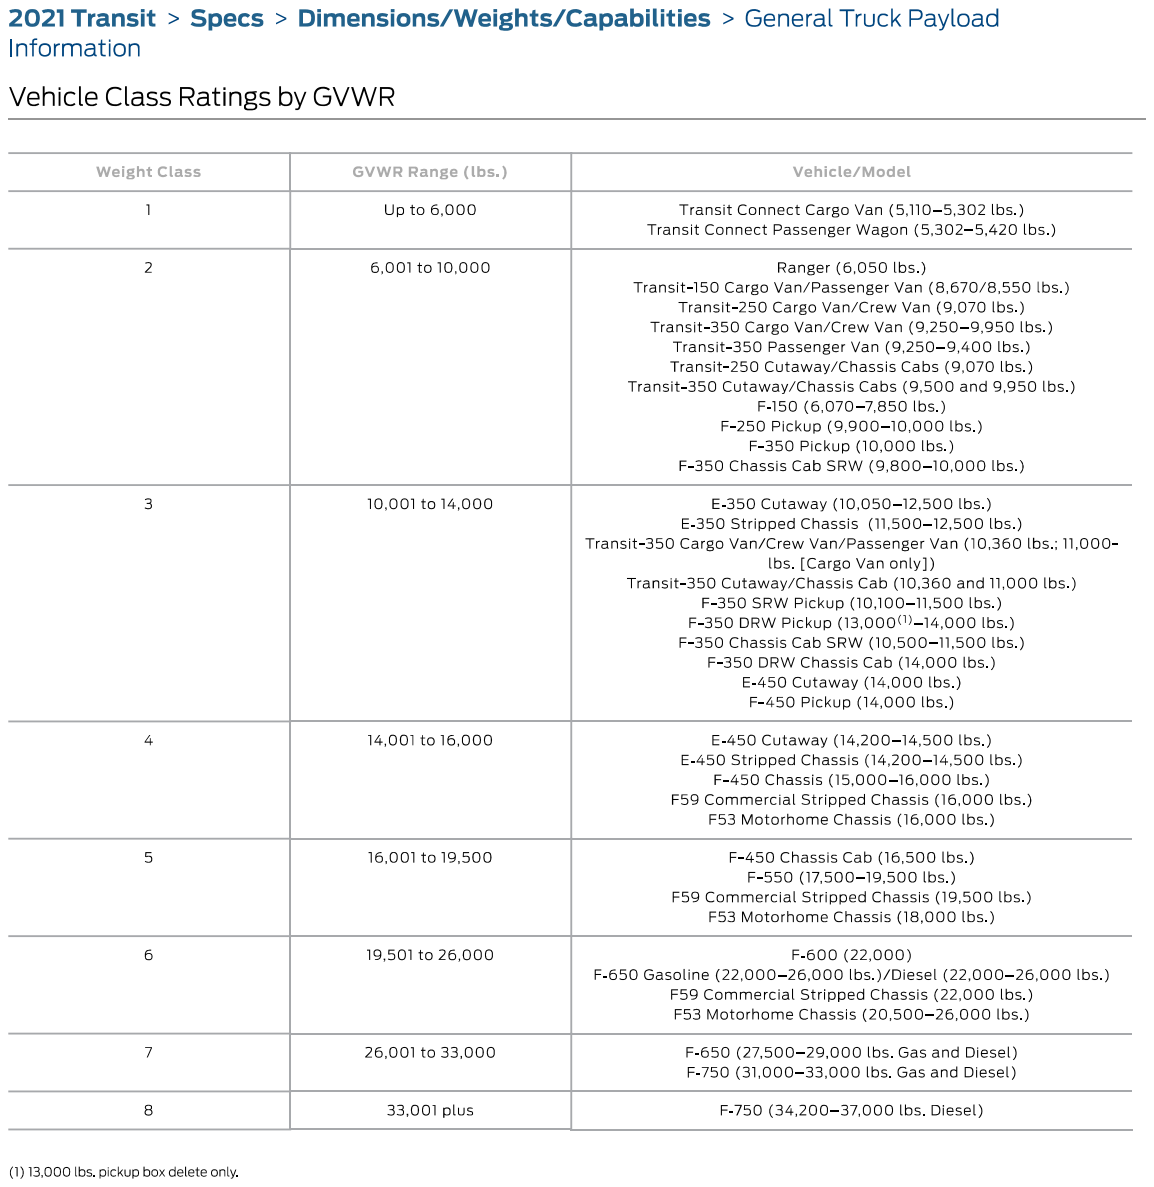
[picture p544: page 21]

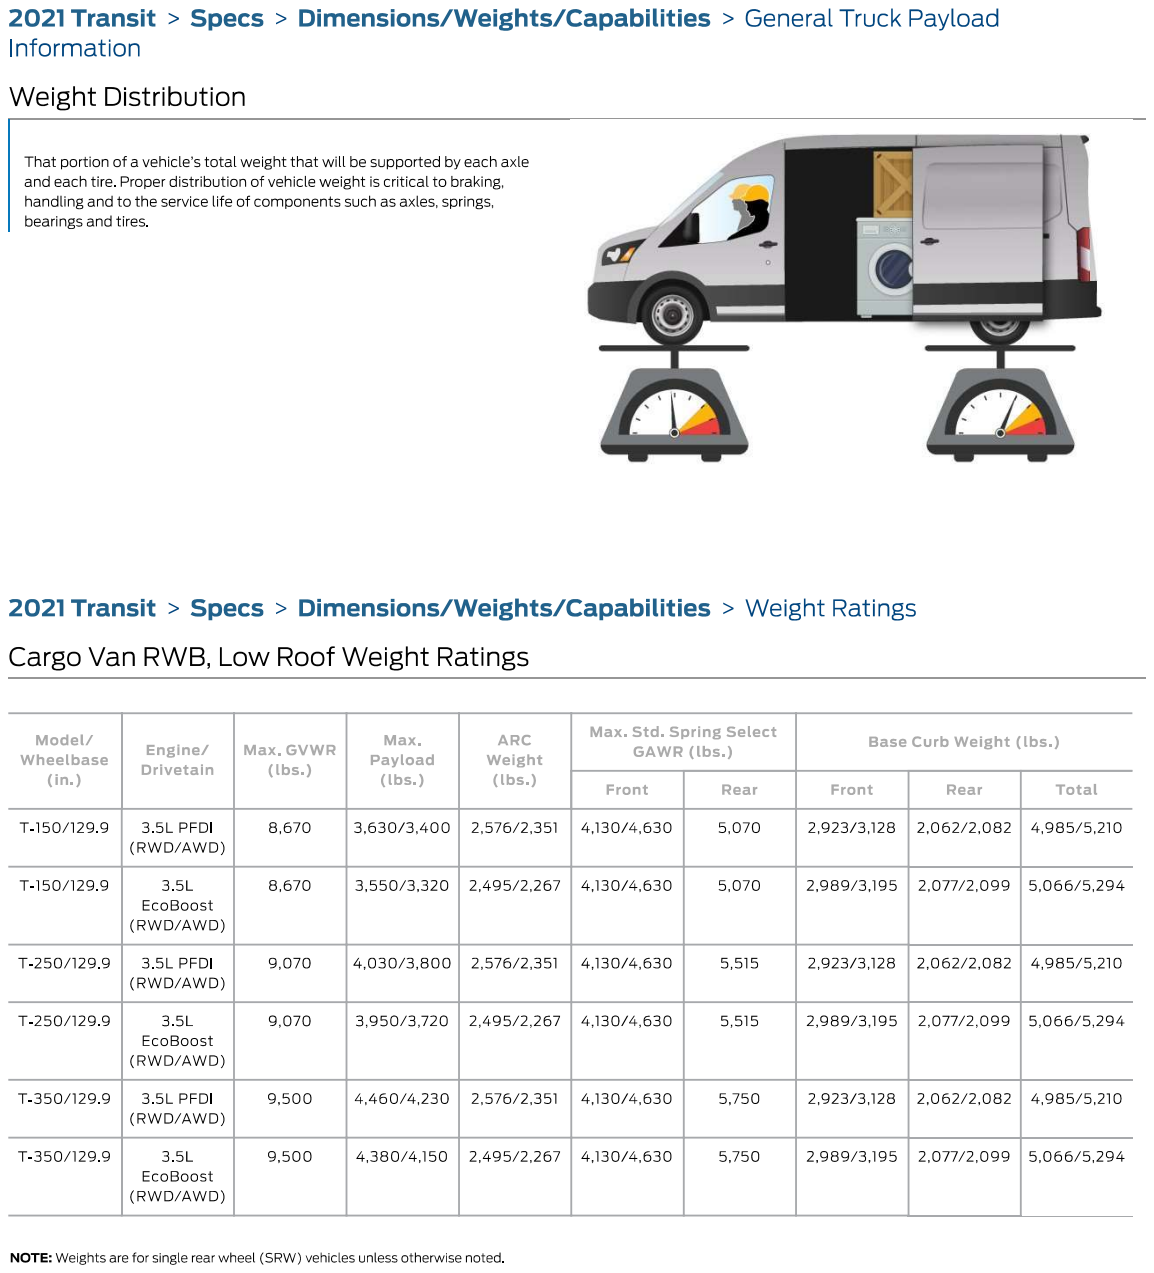
[picture p545: page 22]

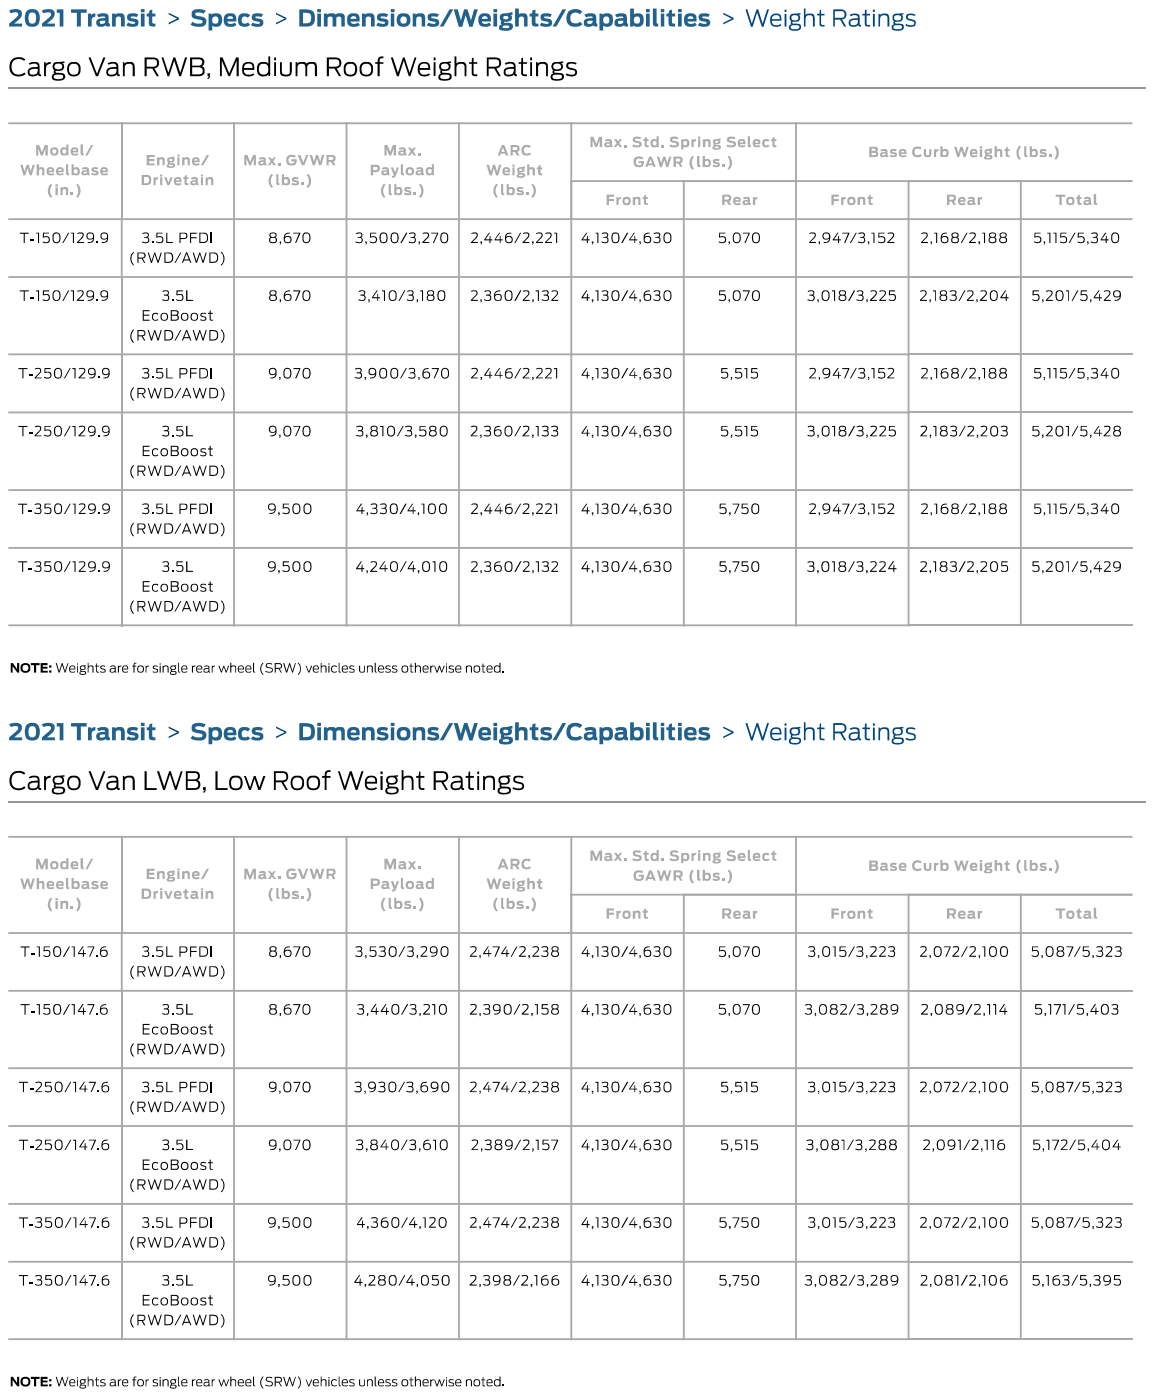
[picture p546: page 23]

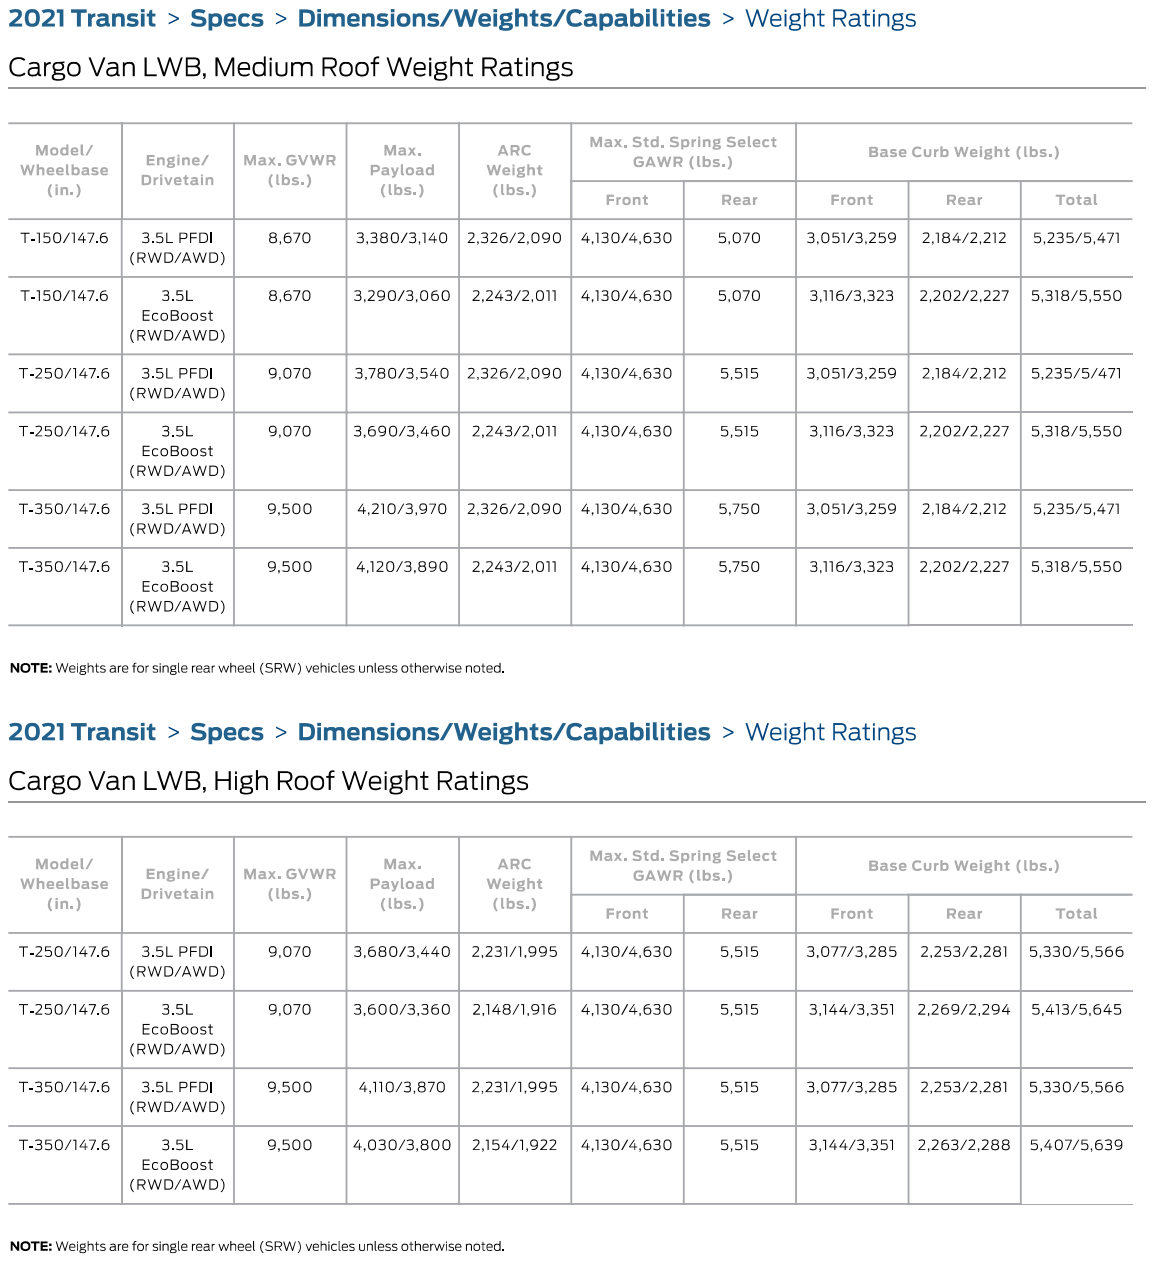
[picture p547: page 24]

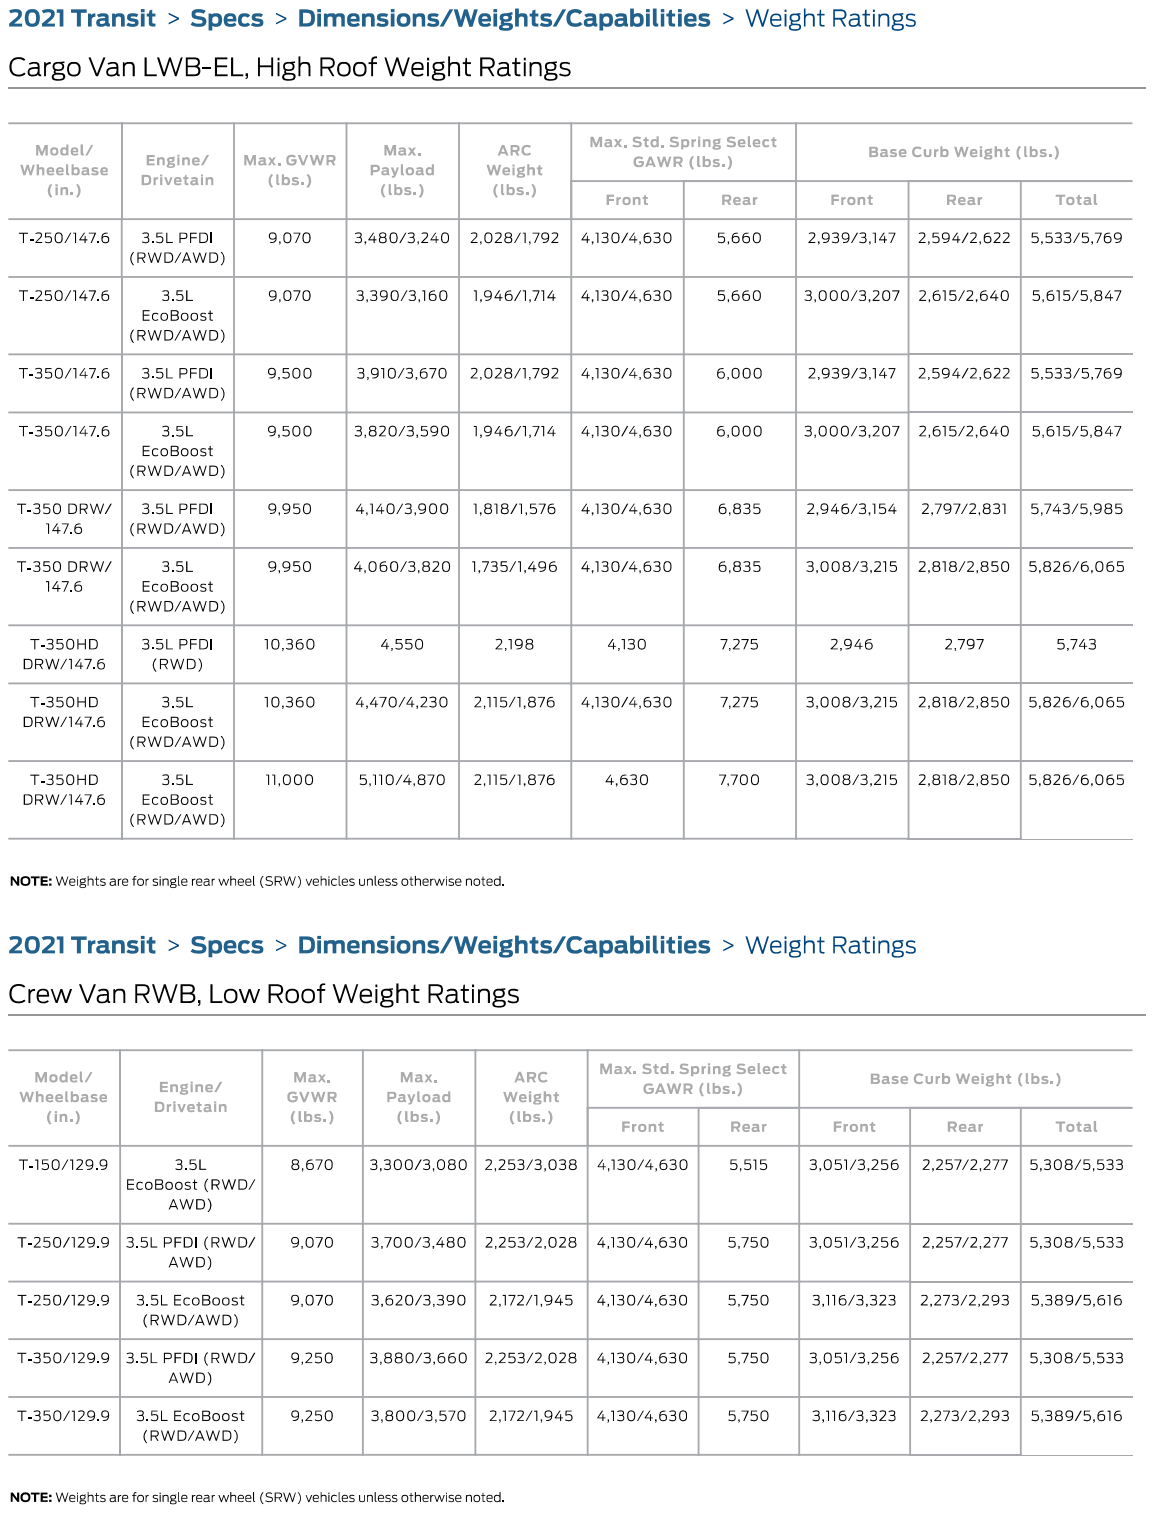
[picture p548: page 25]

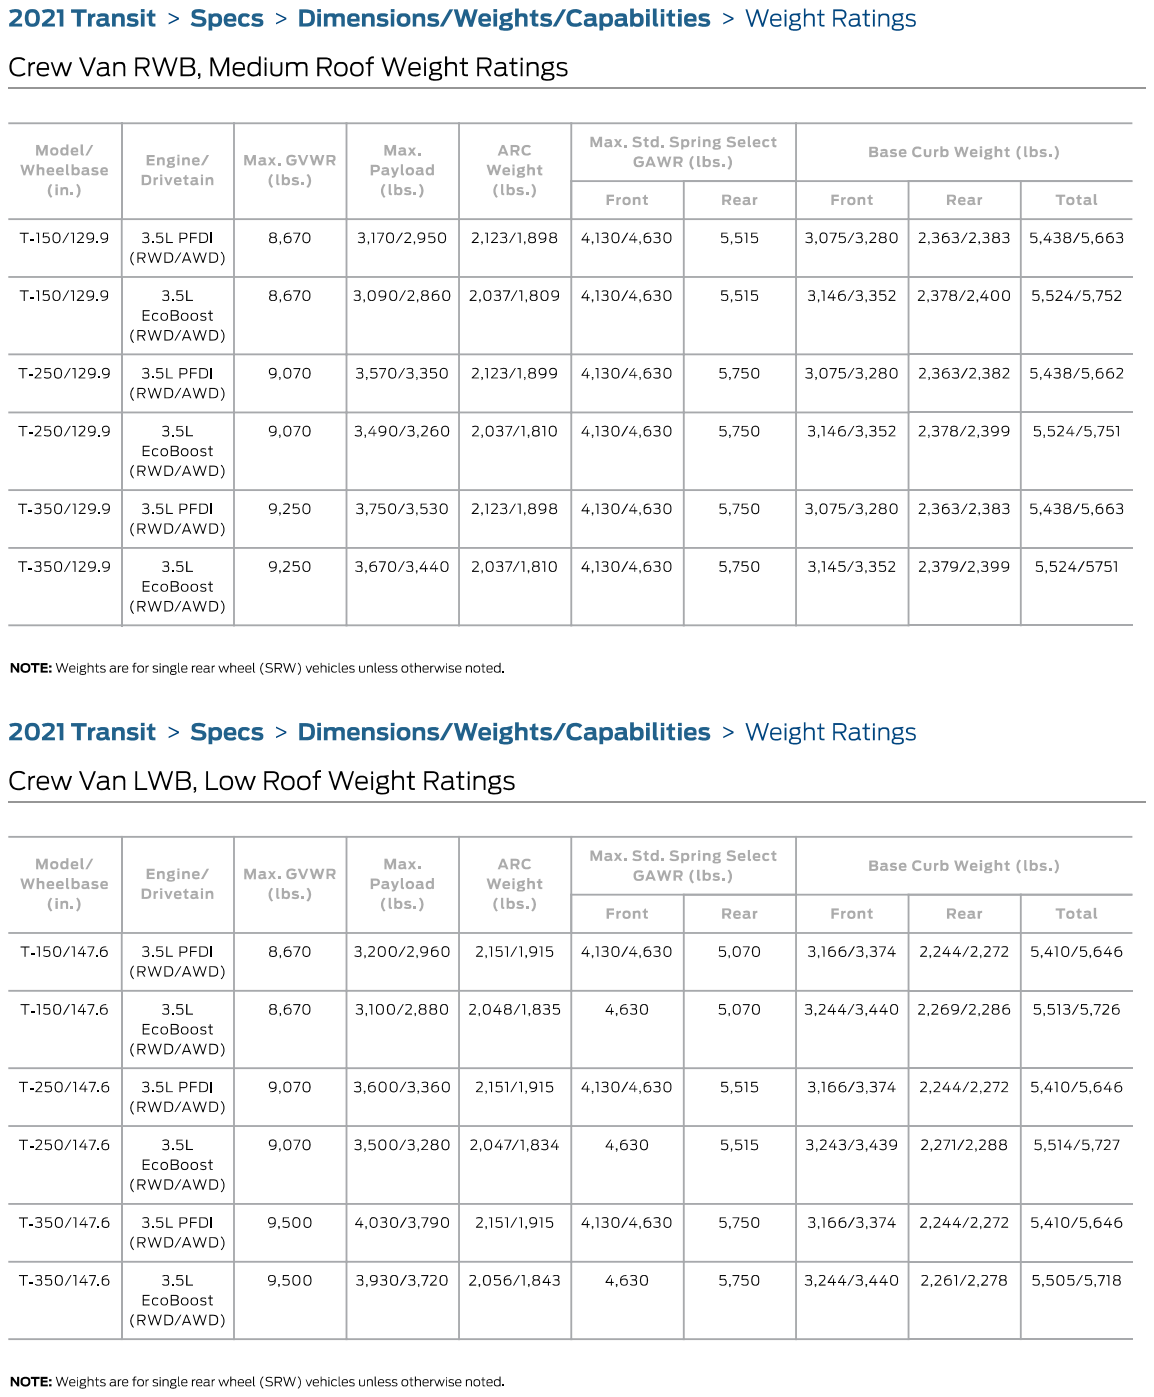
[picture p549: page 26]

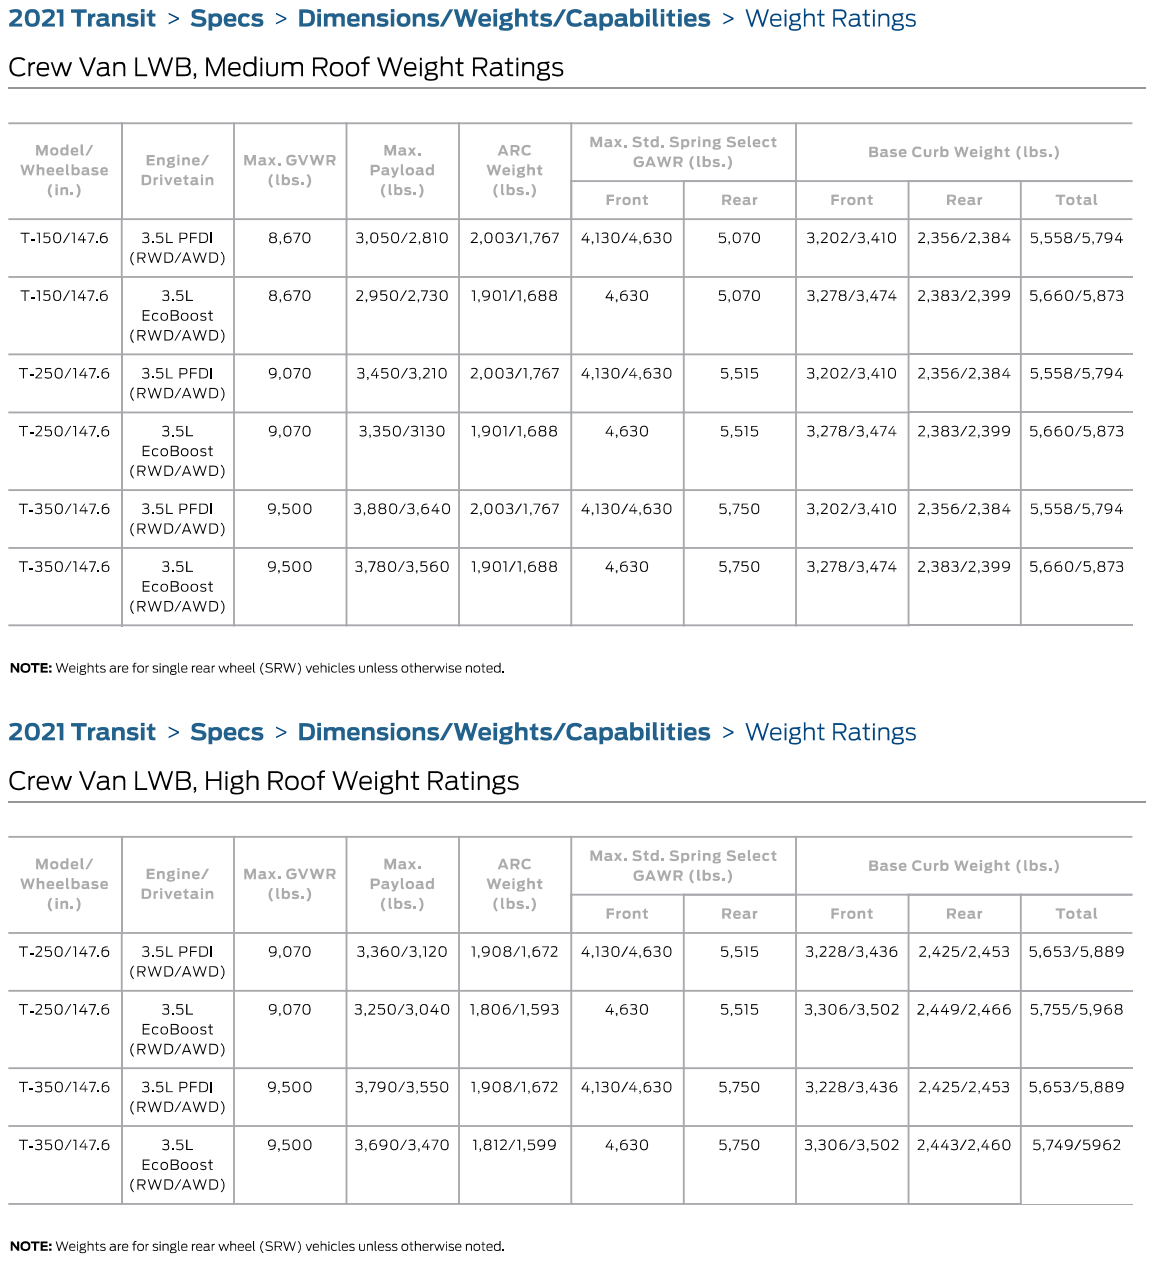
[picture p550: page 27]

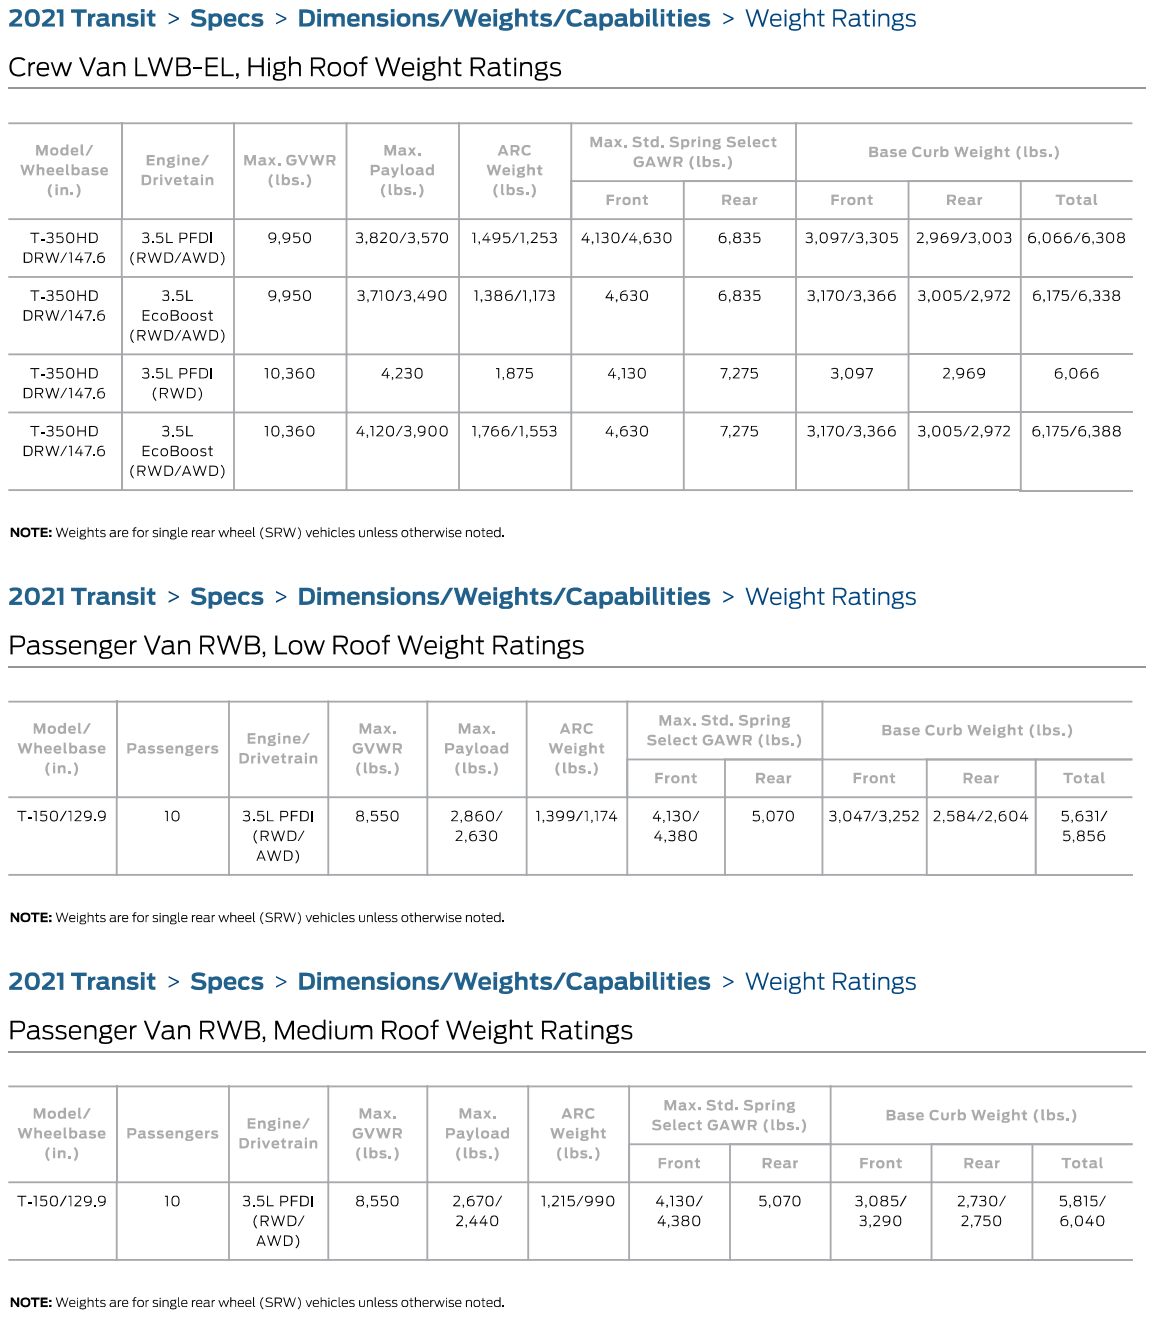
[picture p551: page 28]

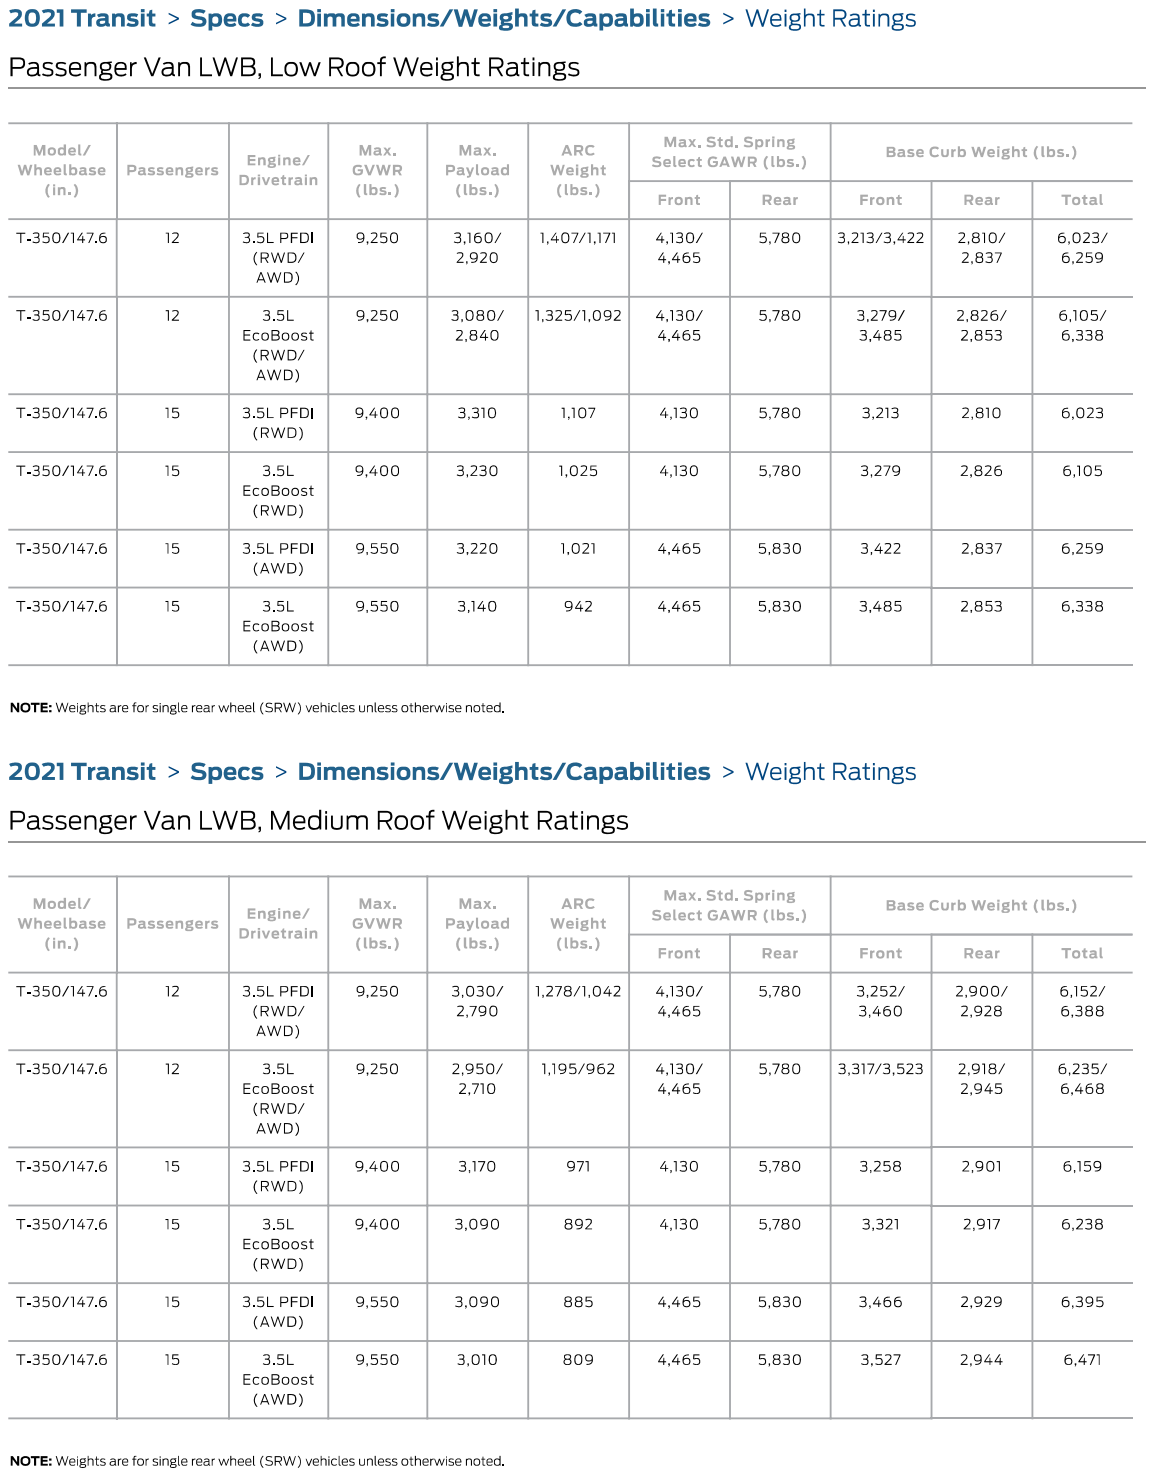
[picture p552: page 29]

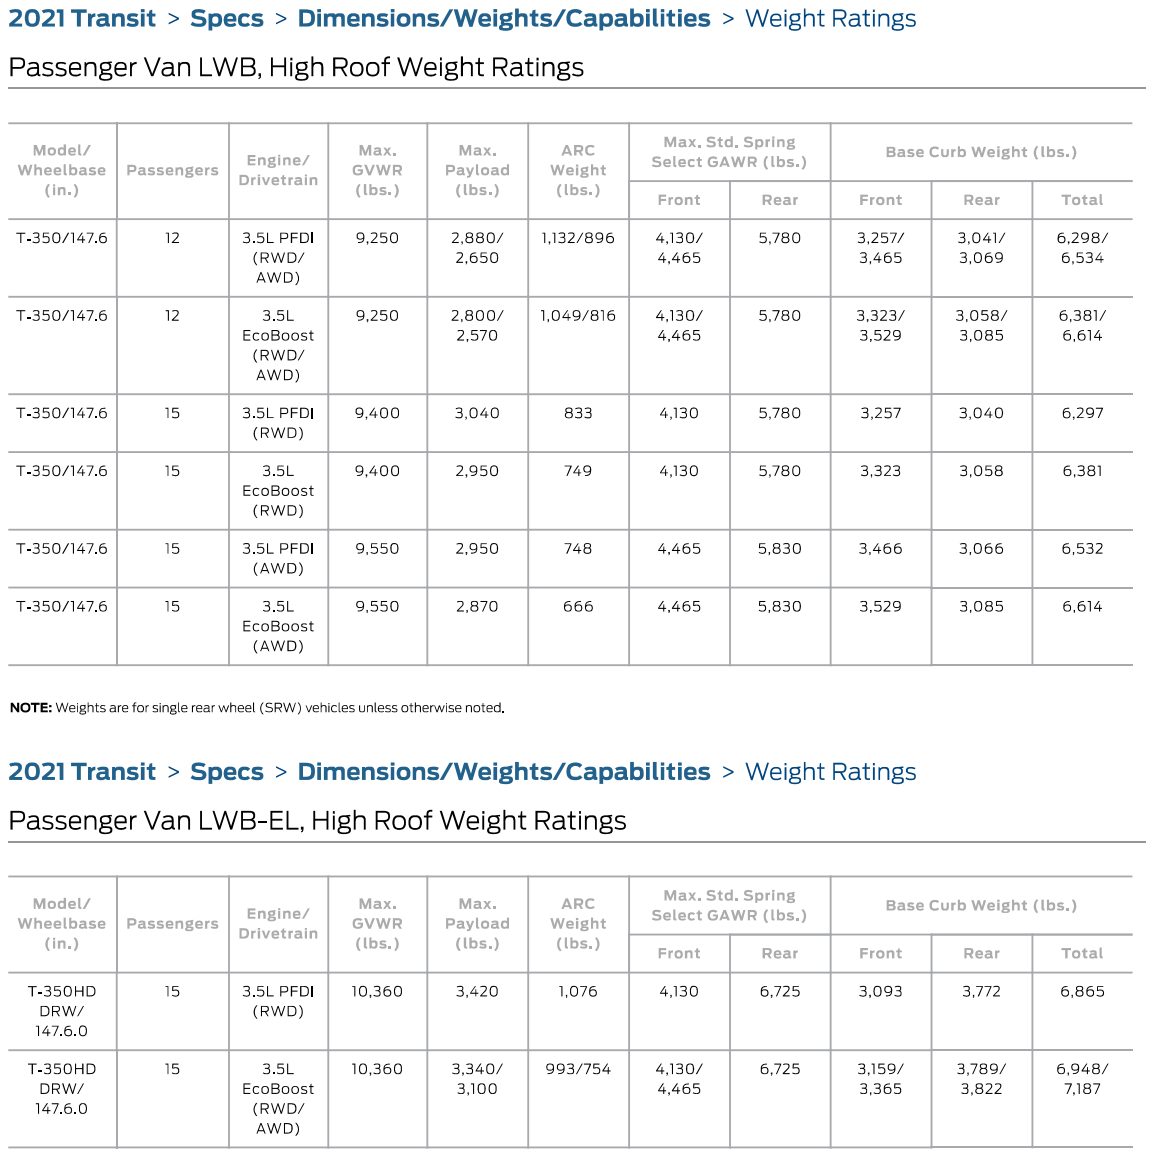
[picture p553: page 30]

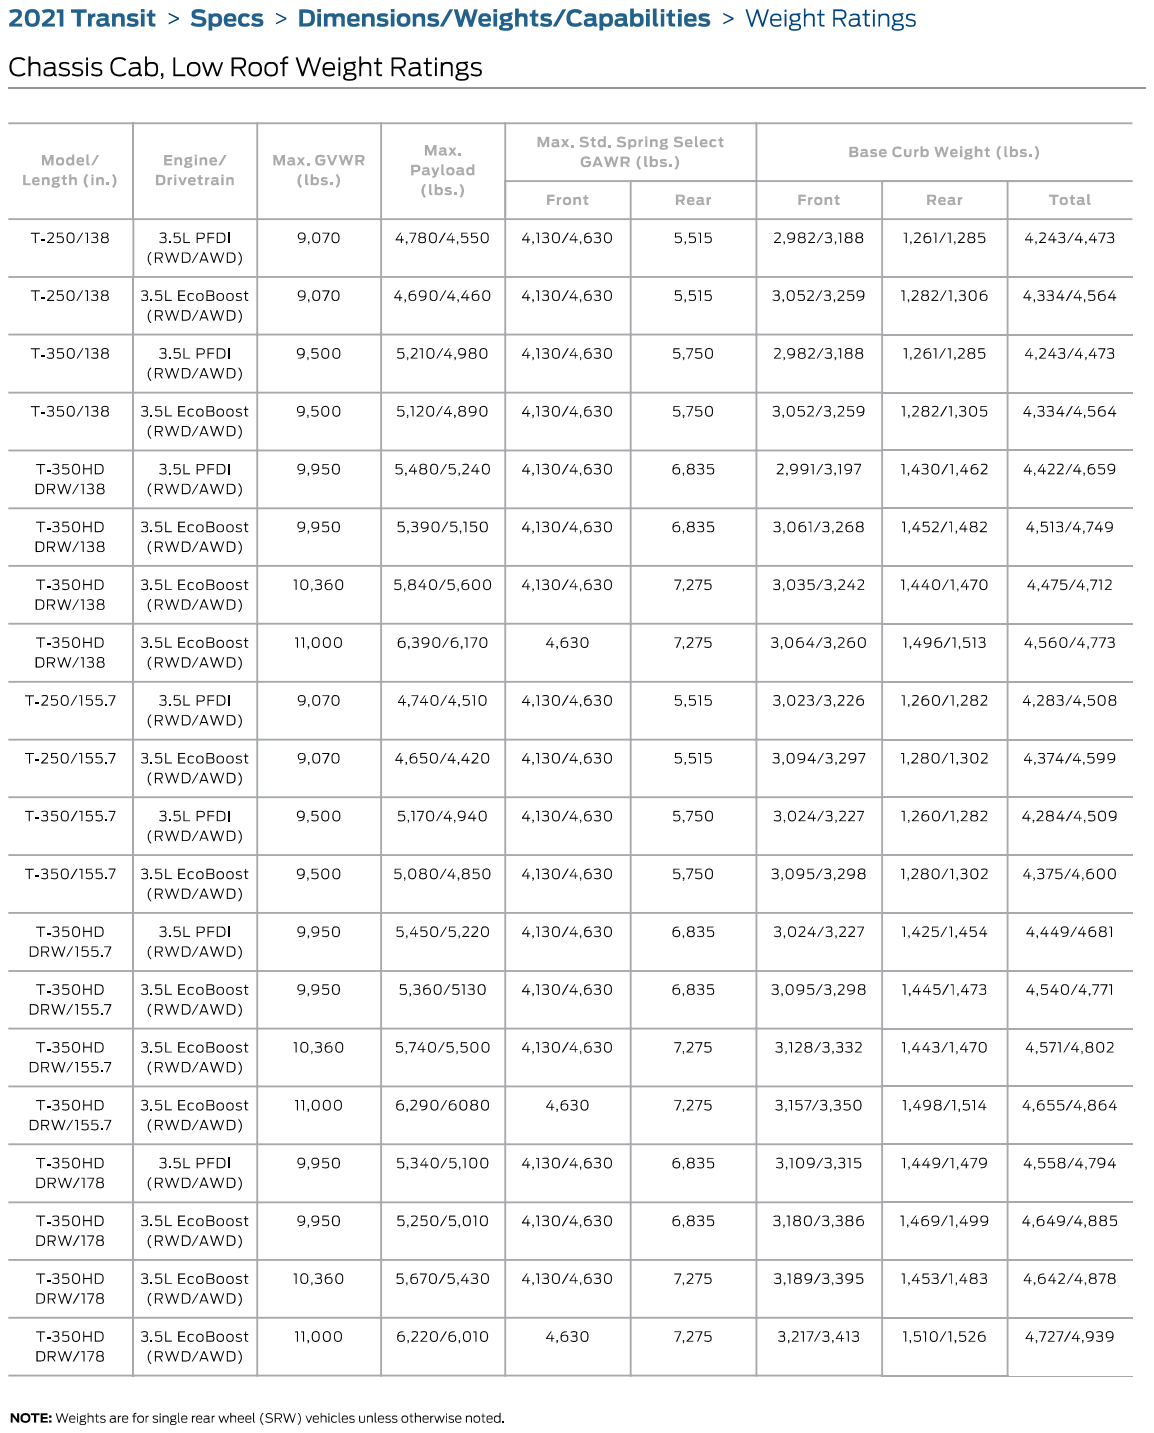
[picture p554: page 31]

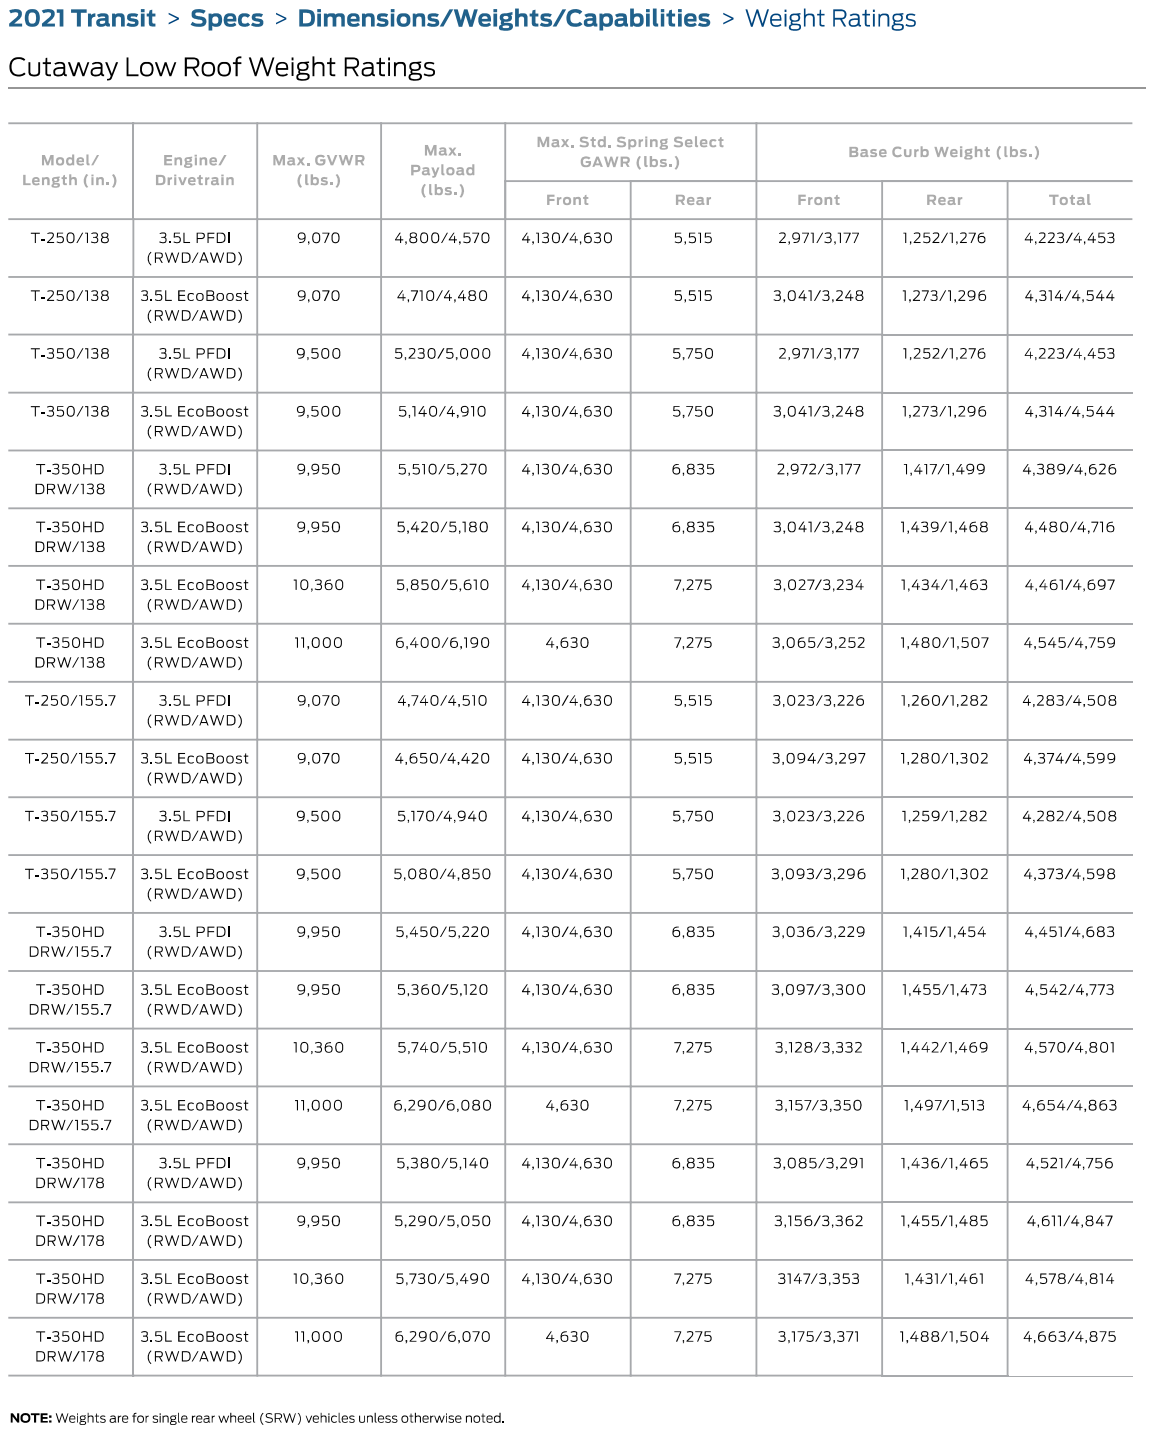
[picture p555: page 32]

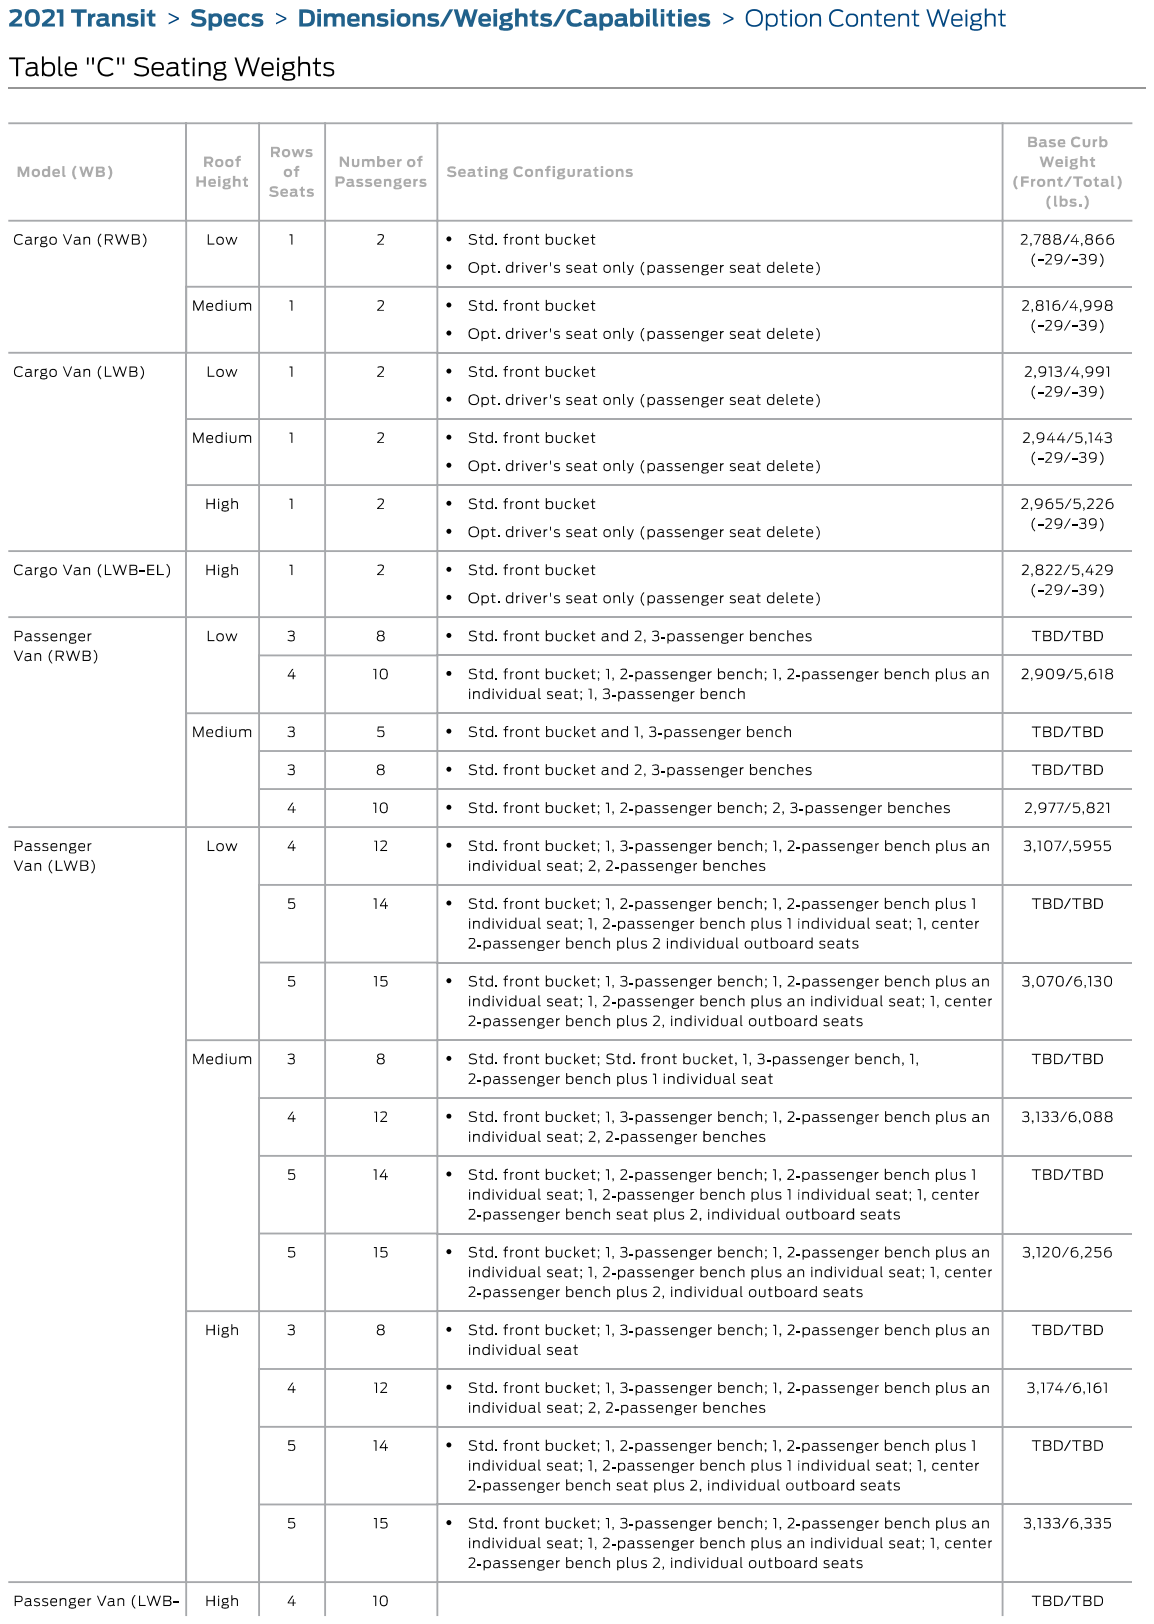
[picture p556: page 33]

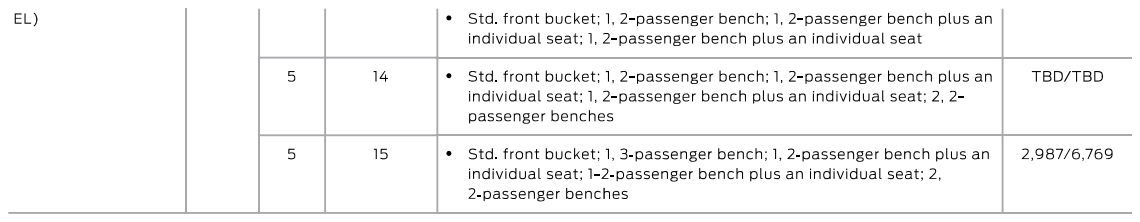
[picture p557: page 34]

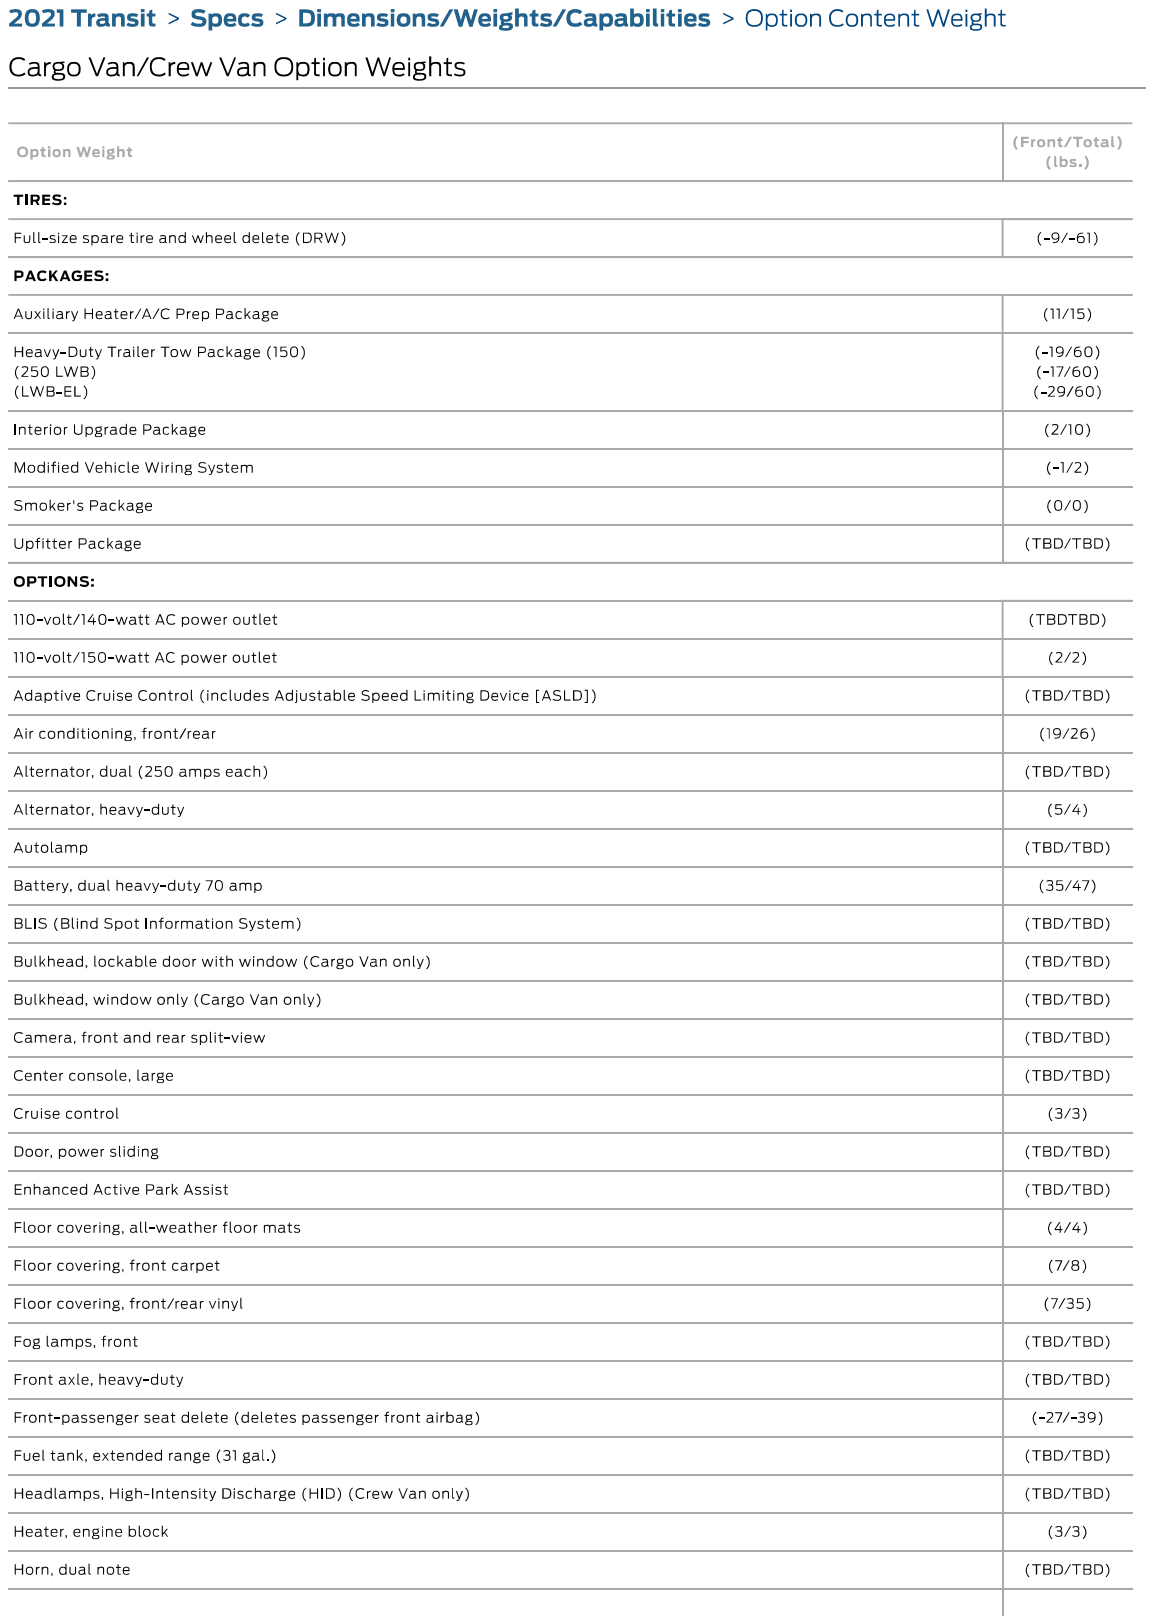
[picture p558: page 35]

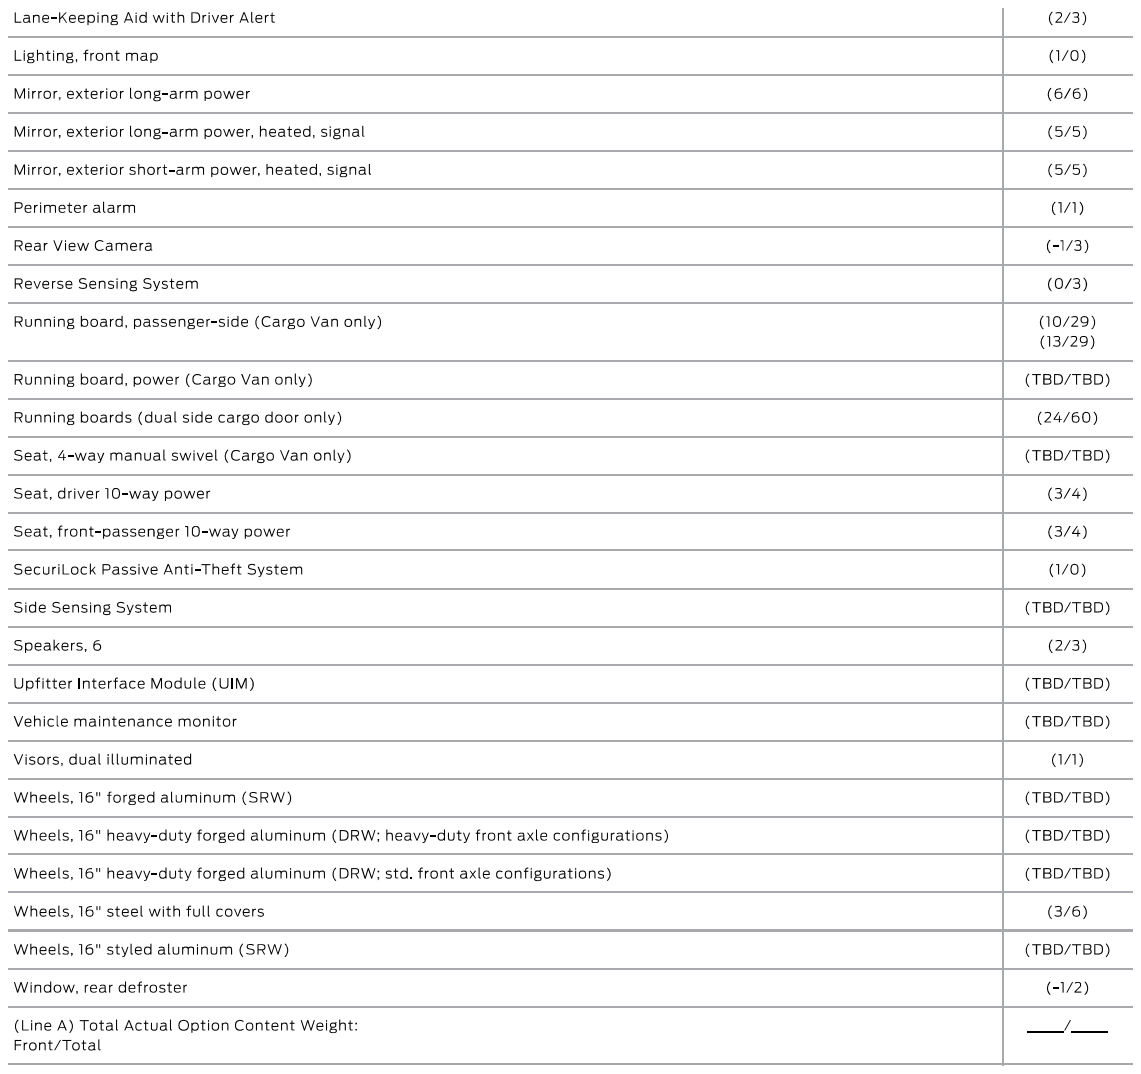
[picture p559: page 36]

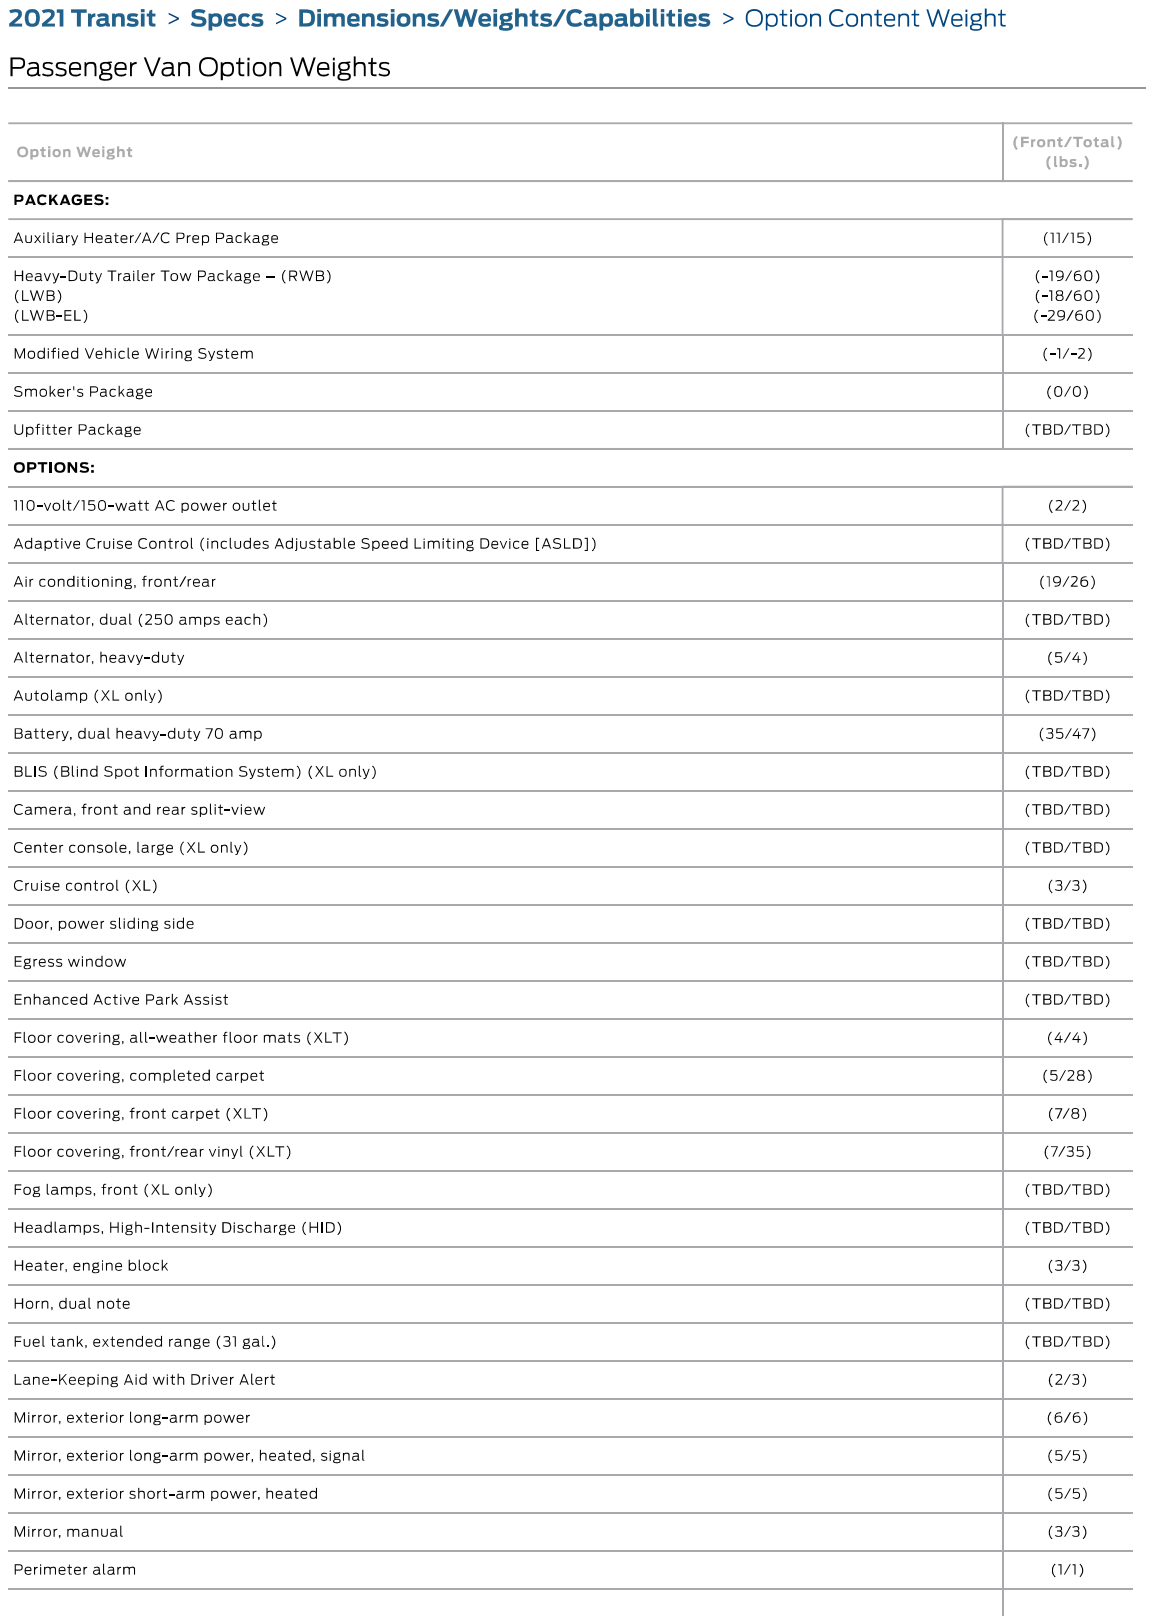
[picture p560: page 37]

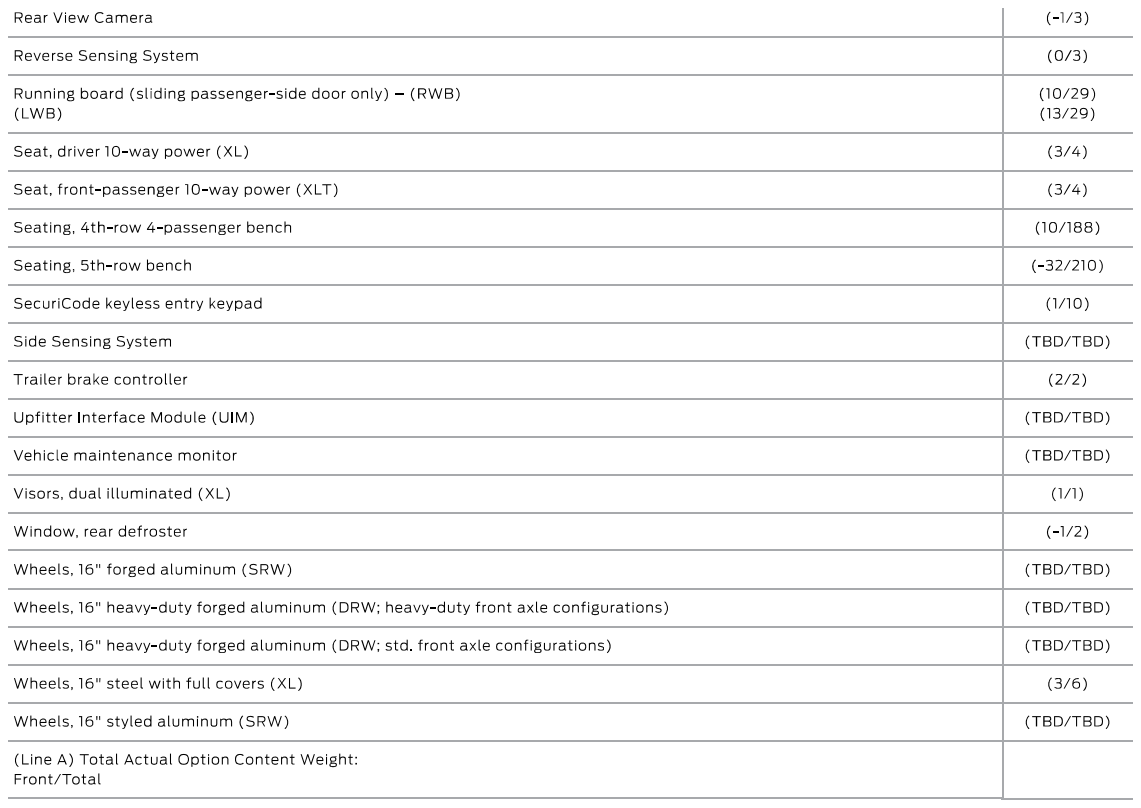
[picture p561: page 38]

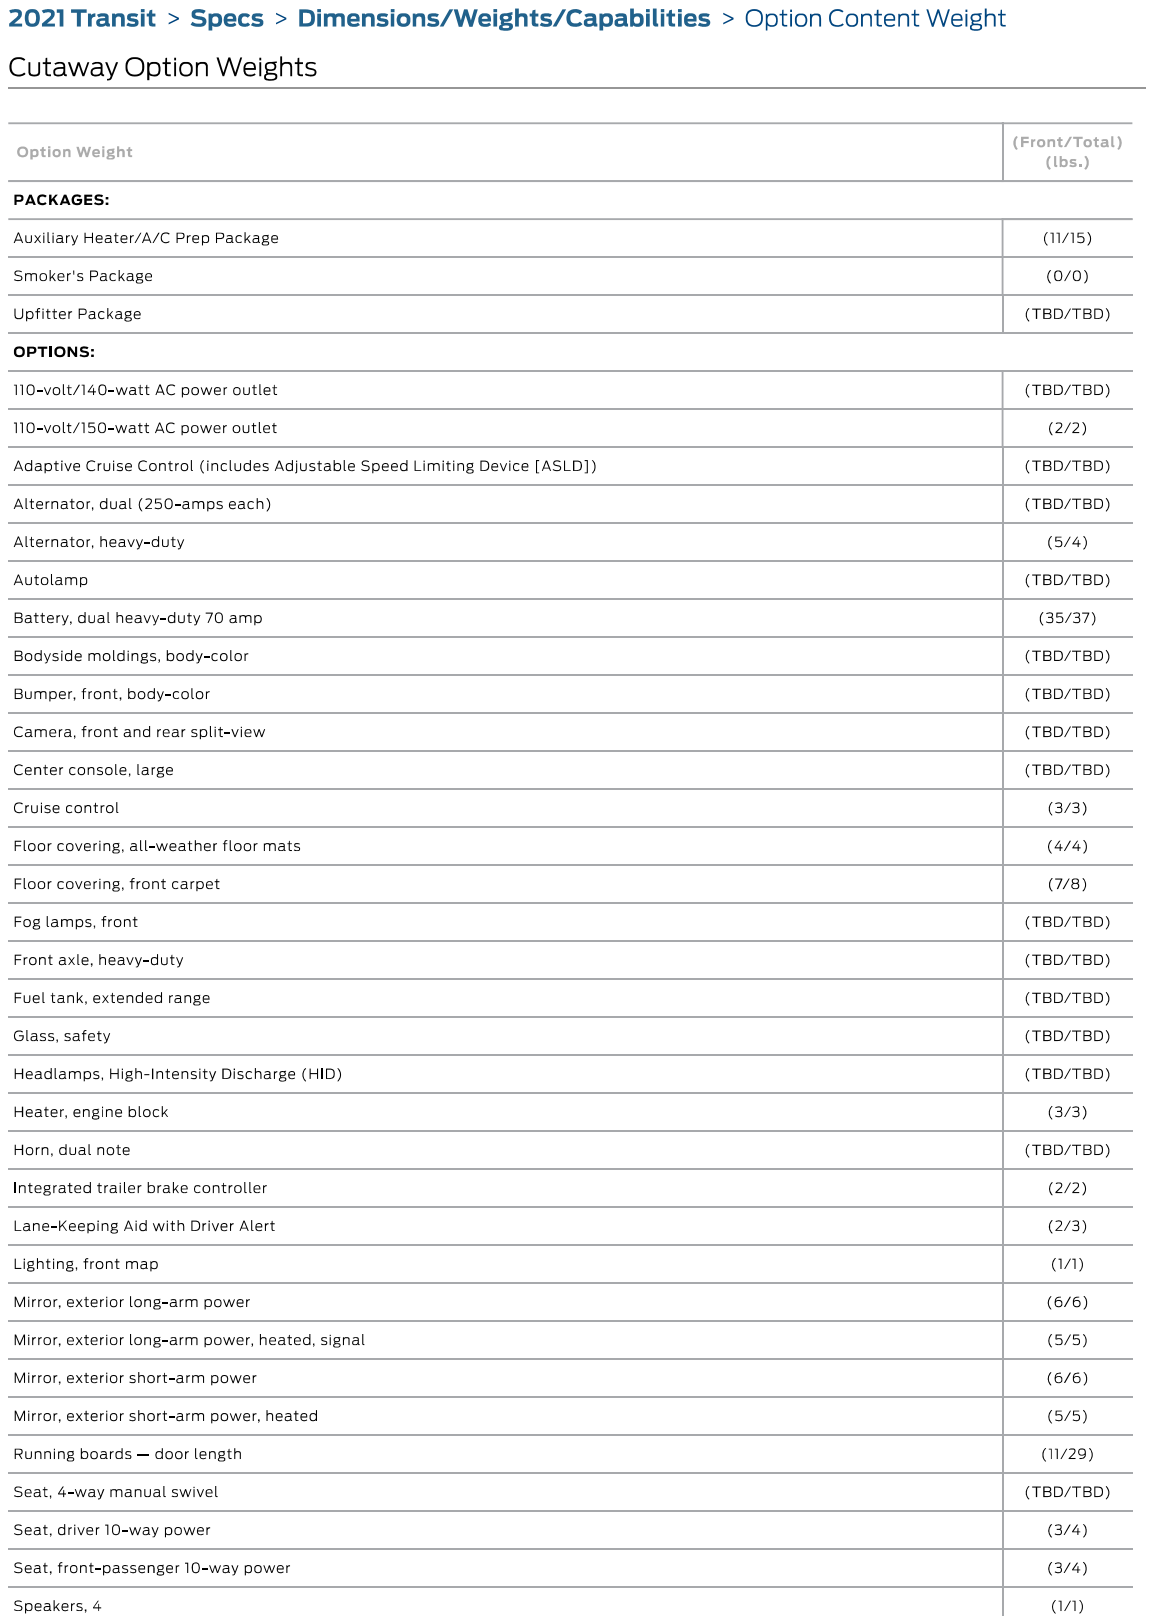
[picture p562: page 39]

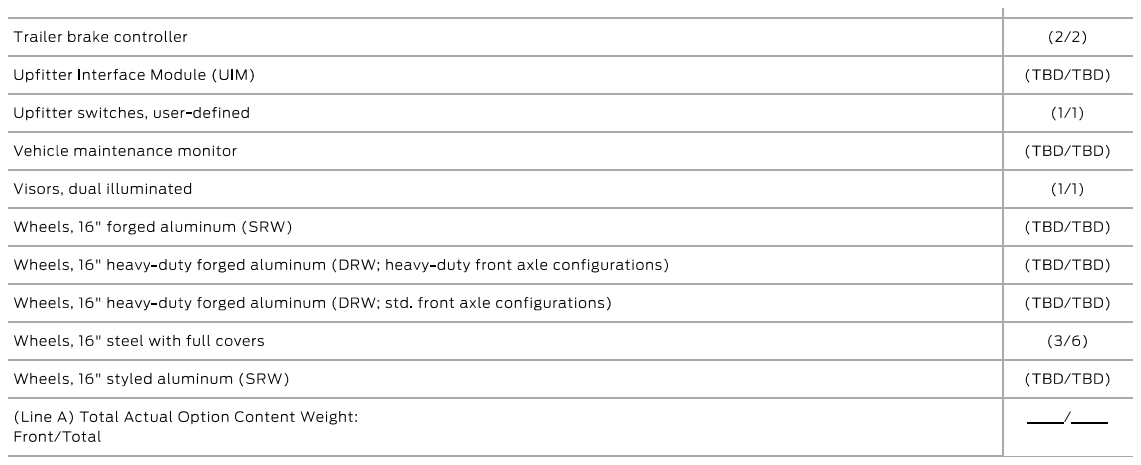
[picture p563: page 40]

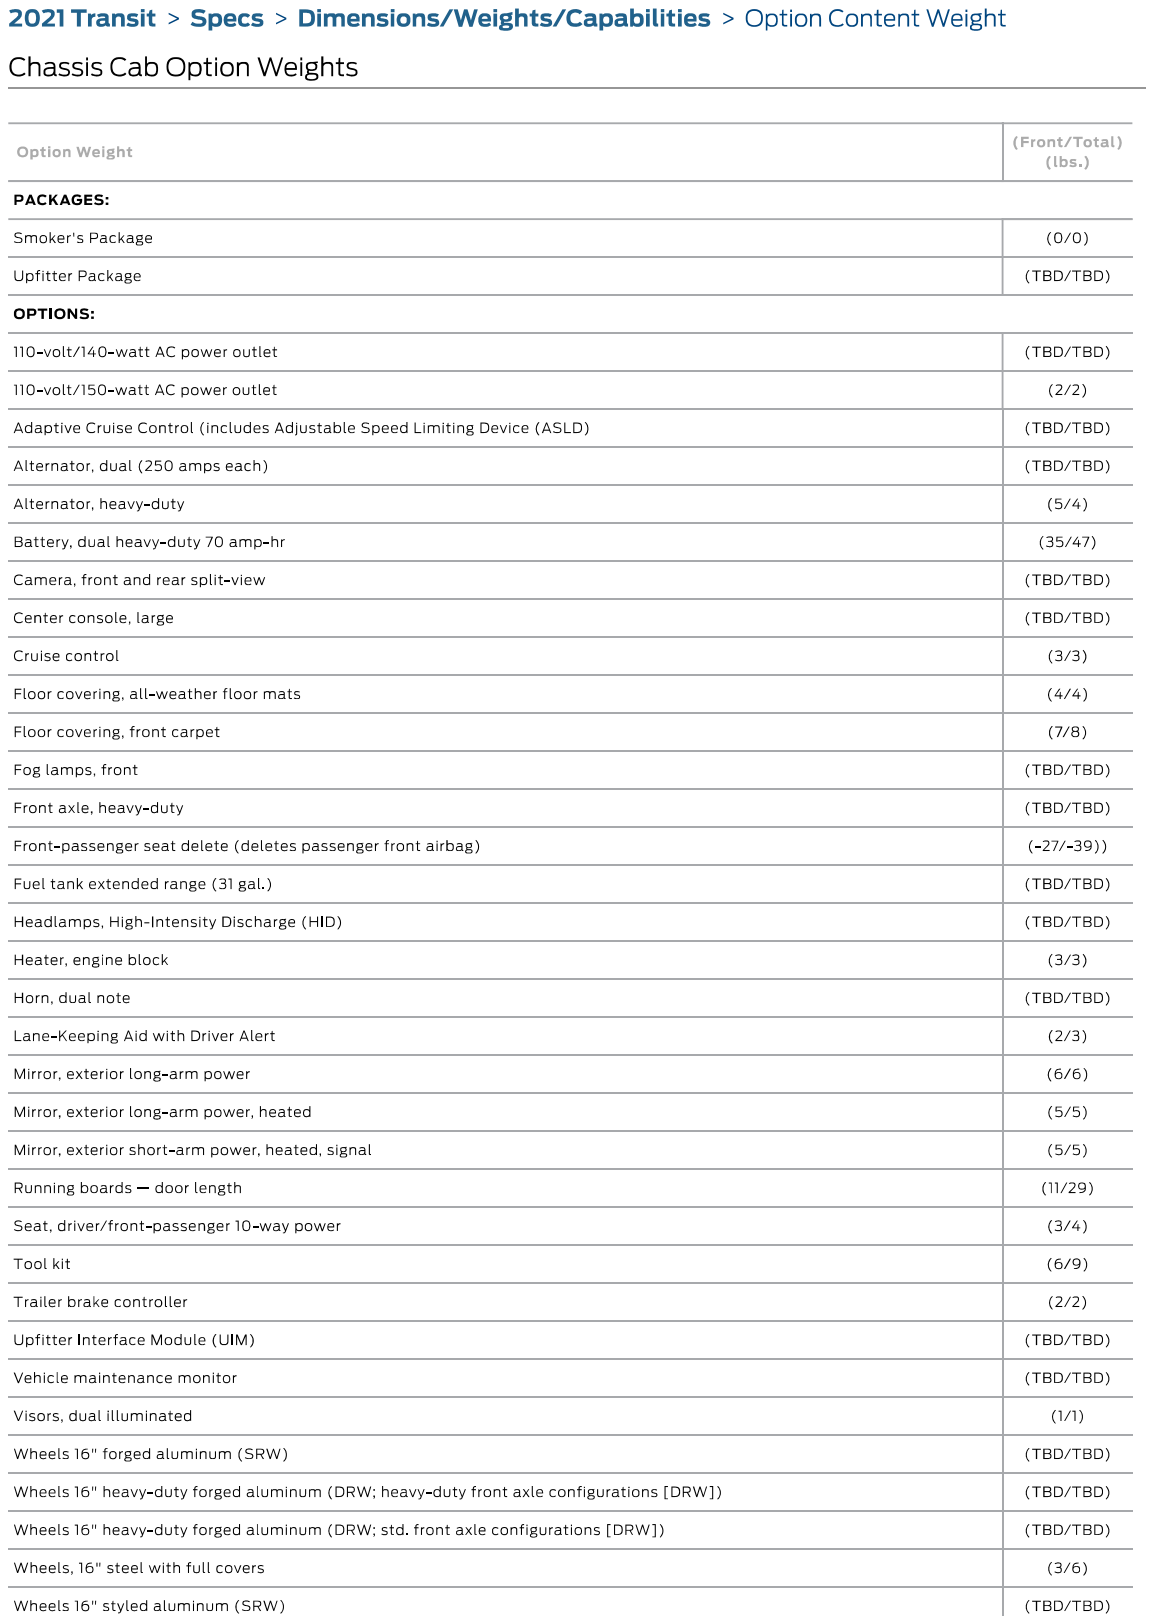
[picture p564: page 41]

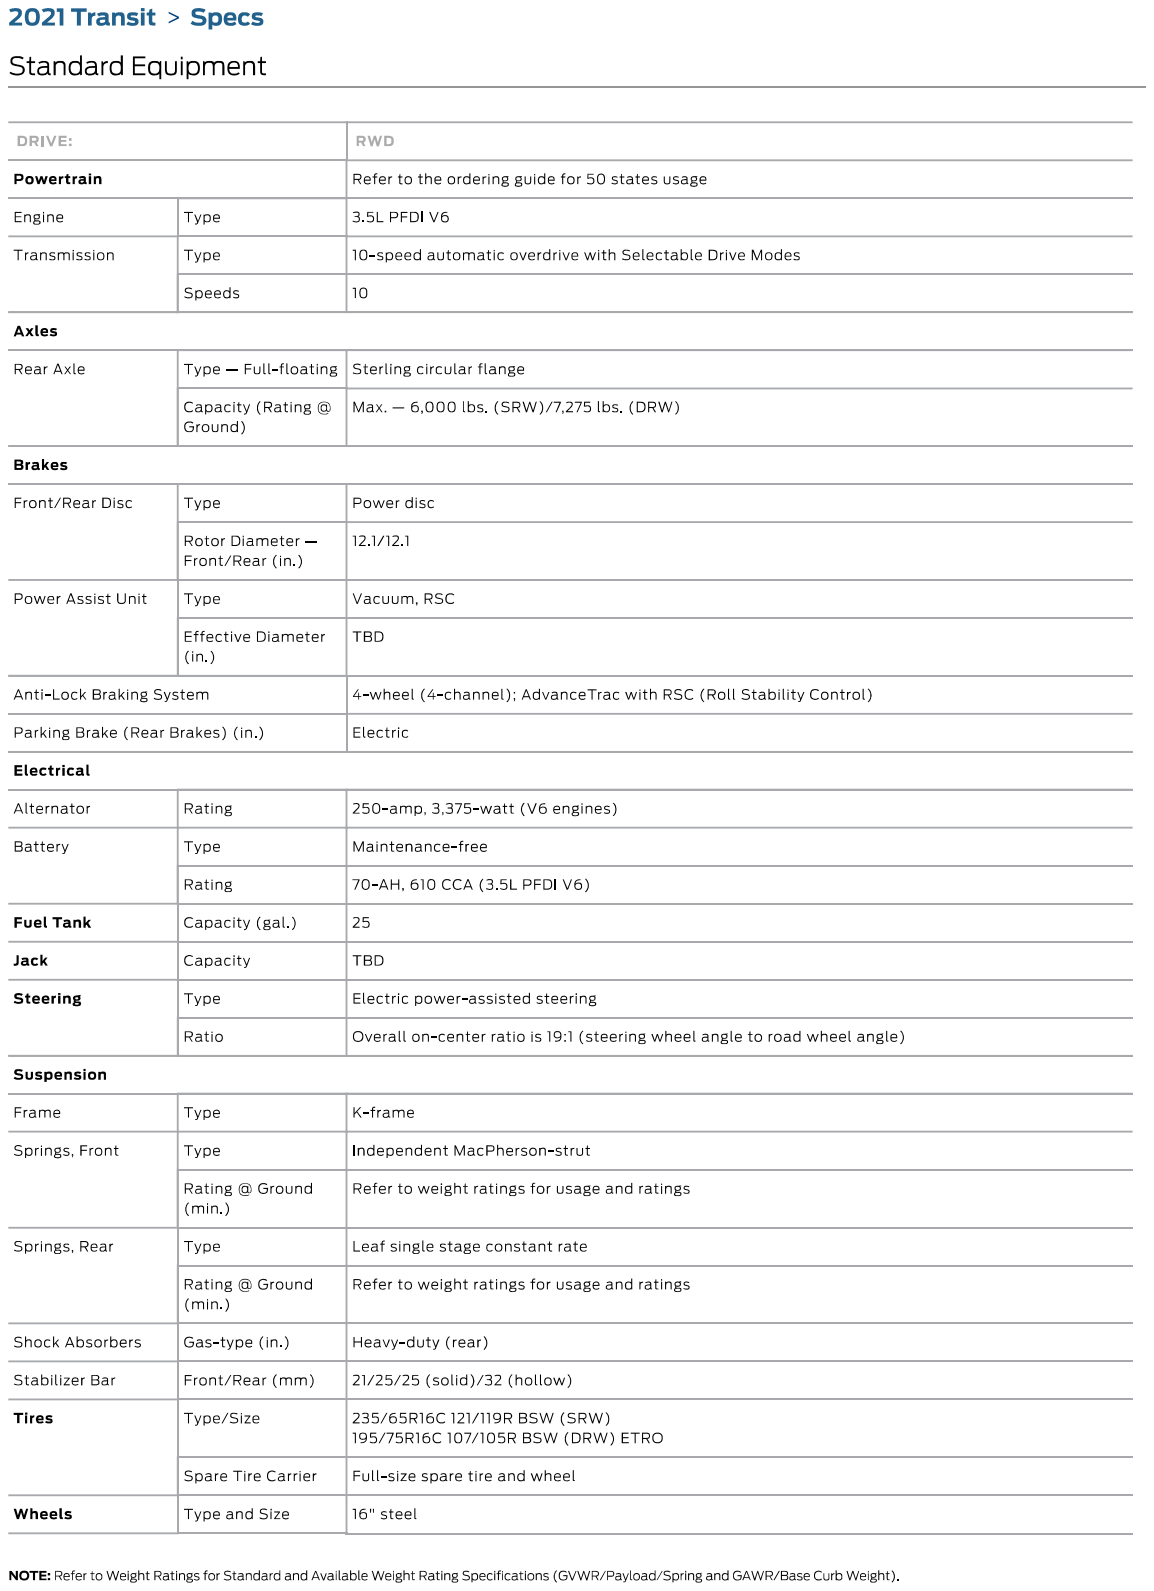
[picture p565: page 43]

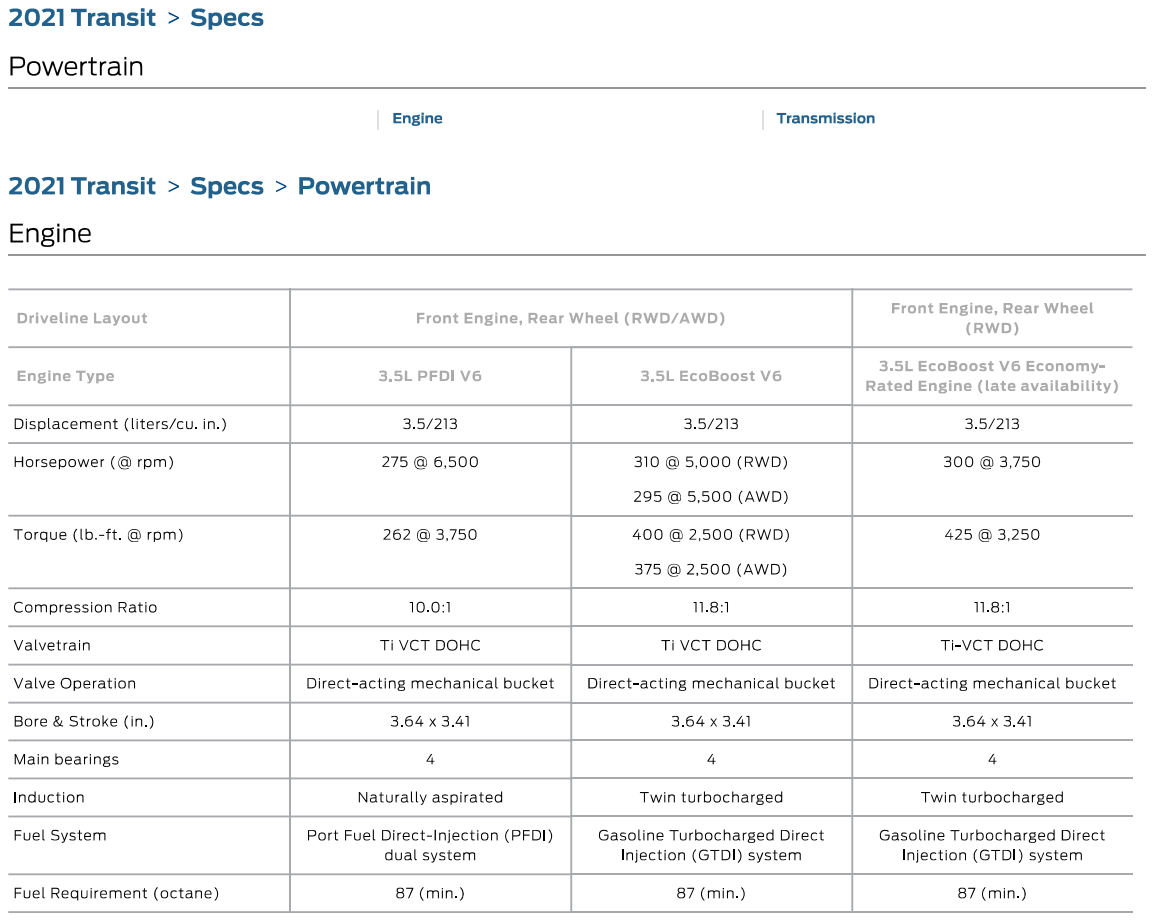
[picture p566: page 44]

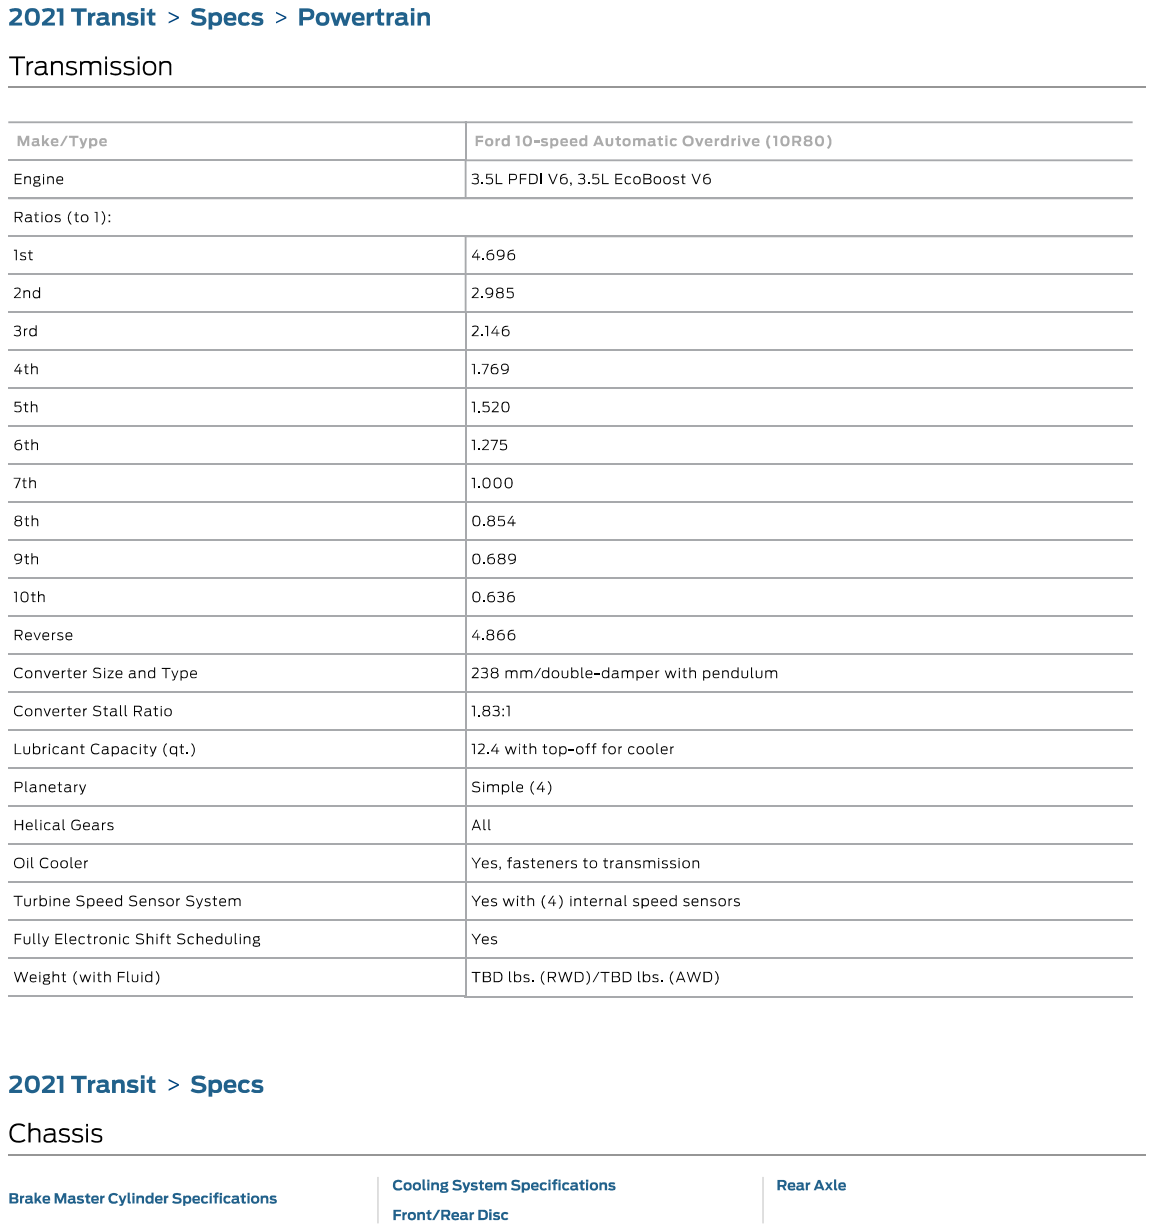
[picture p567: page 45]

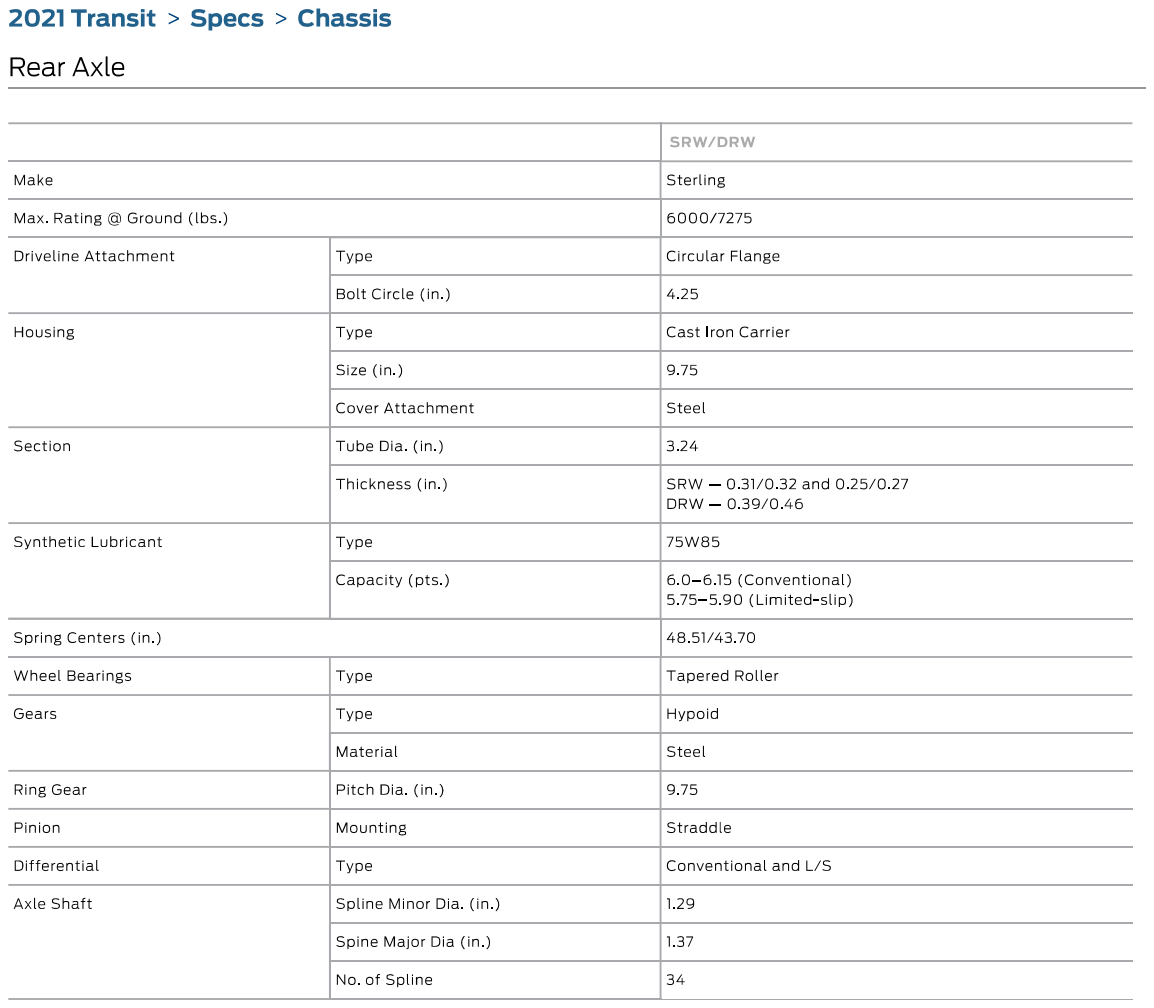
[picture p568: page 46]

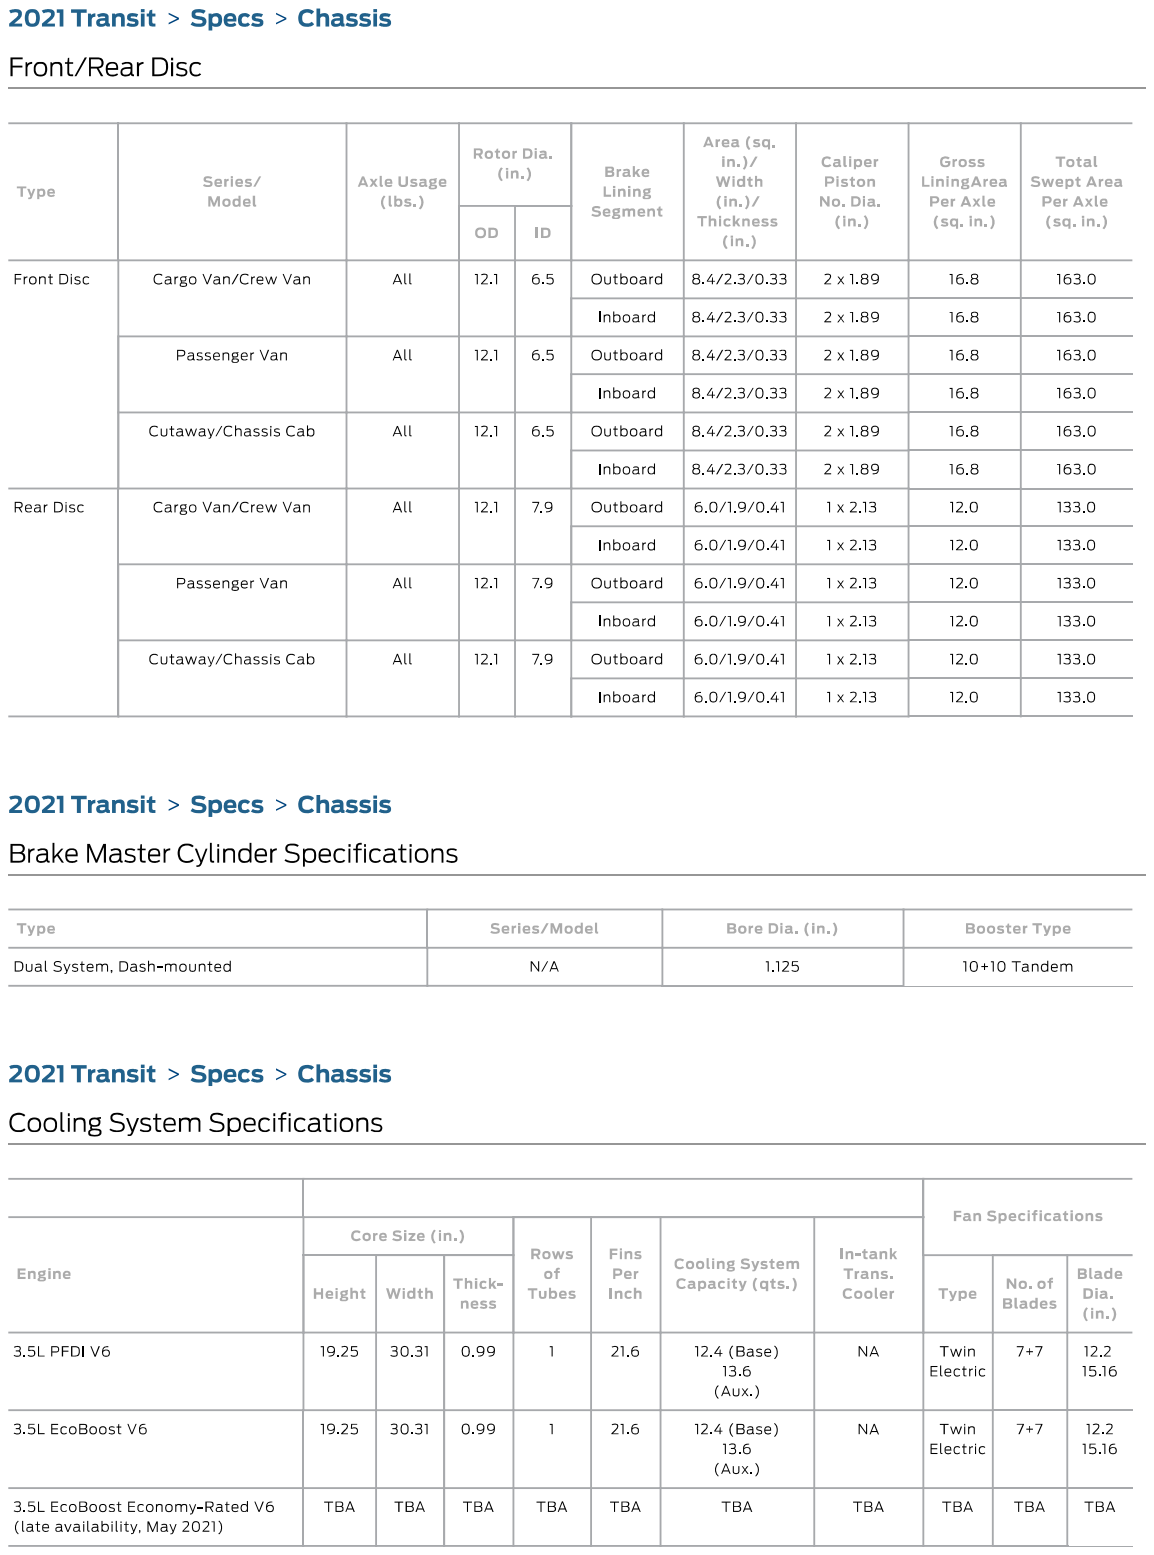
[picture p569: page 47]

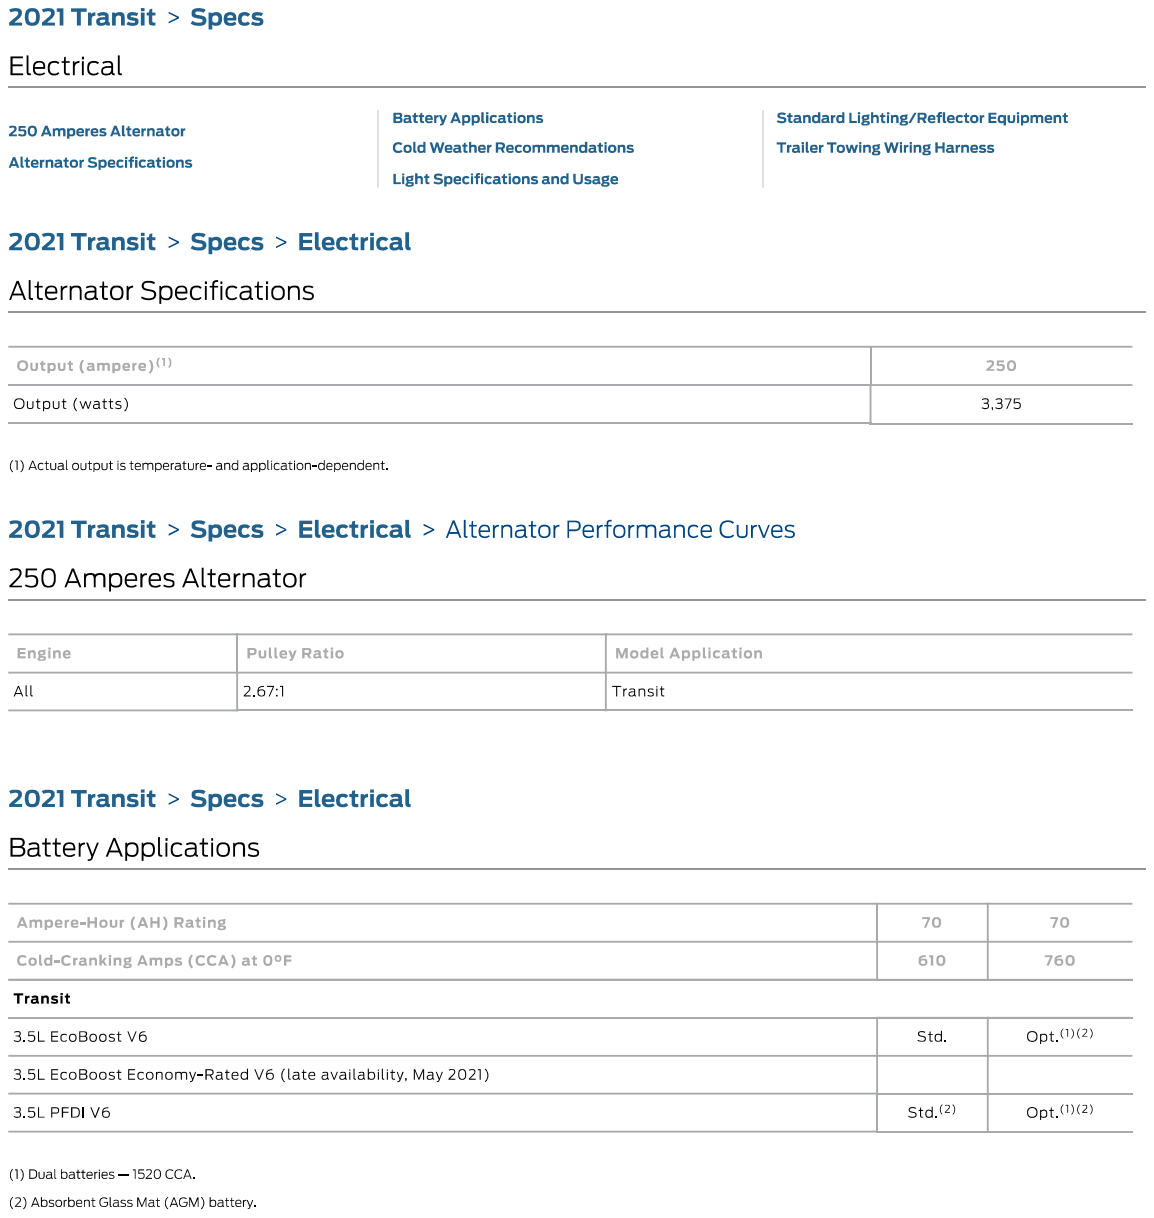
[picture p570: page 48]

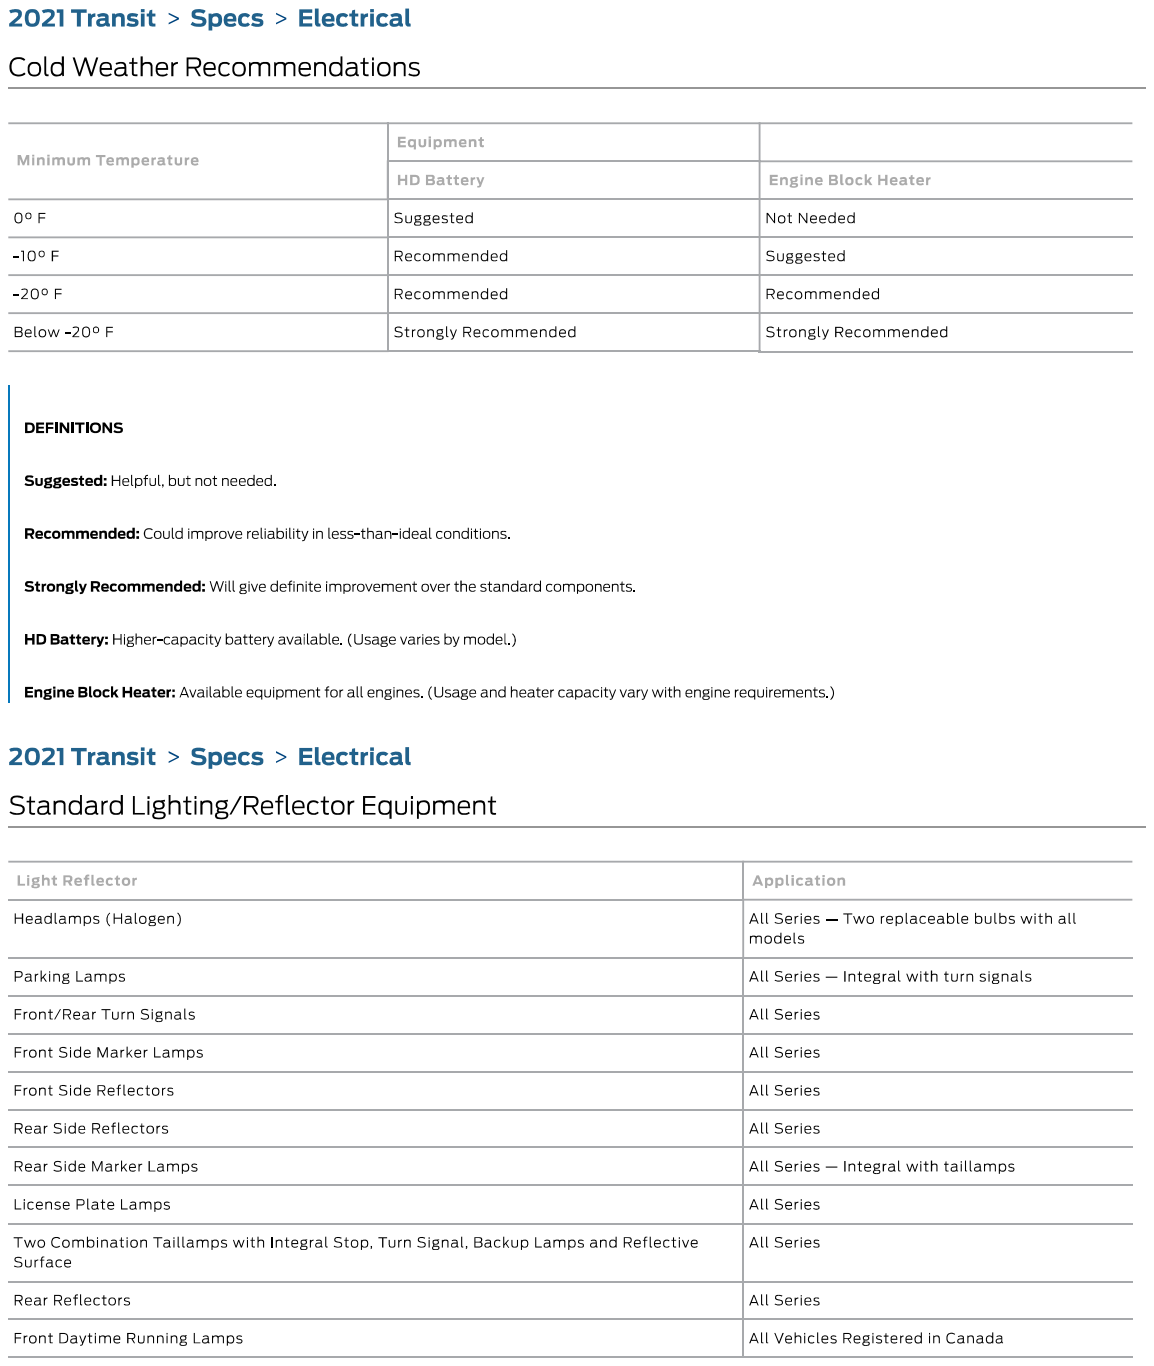
[picture p571: page 49]

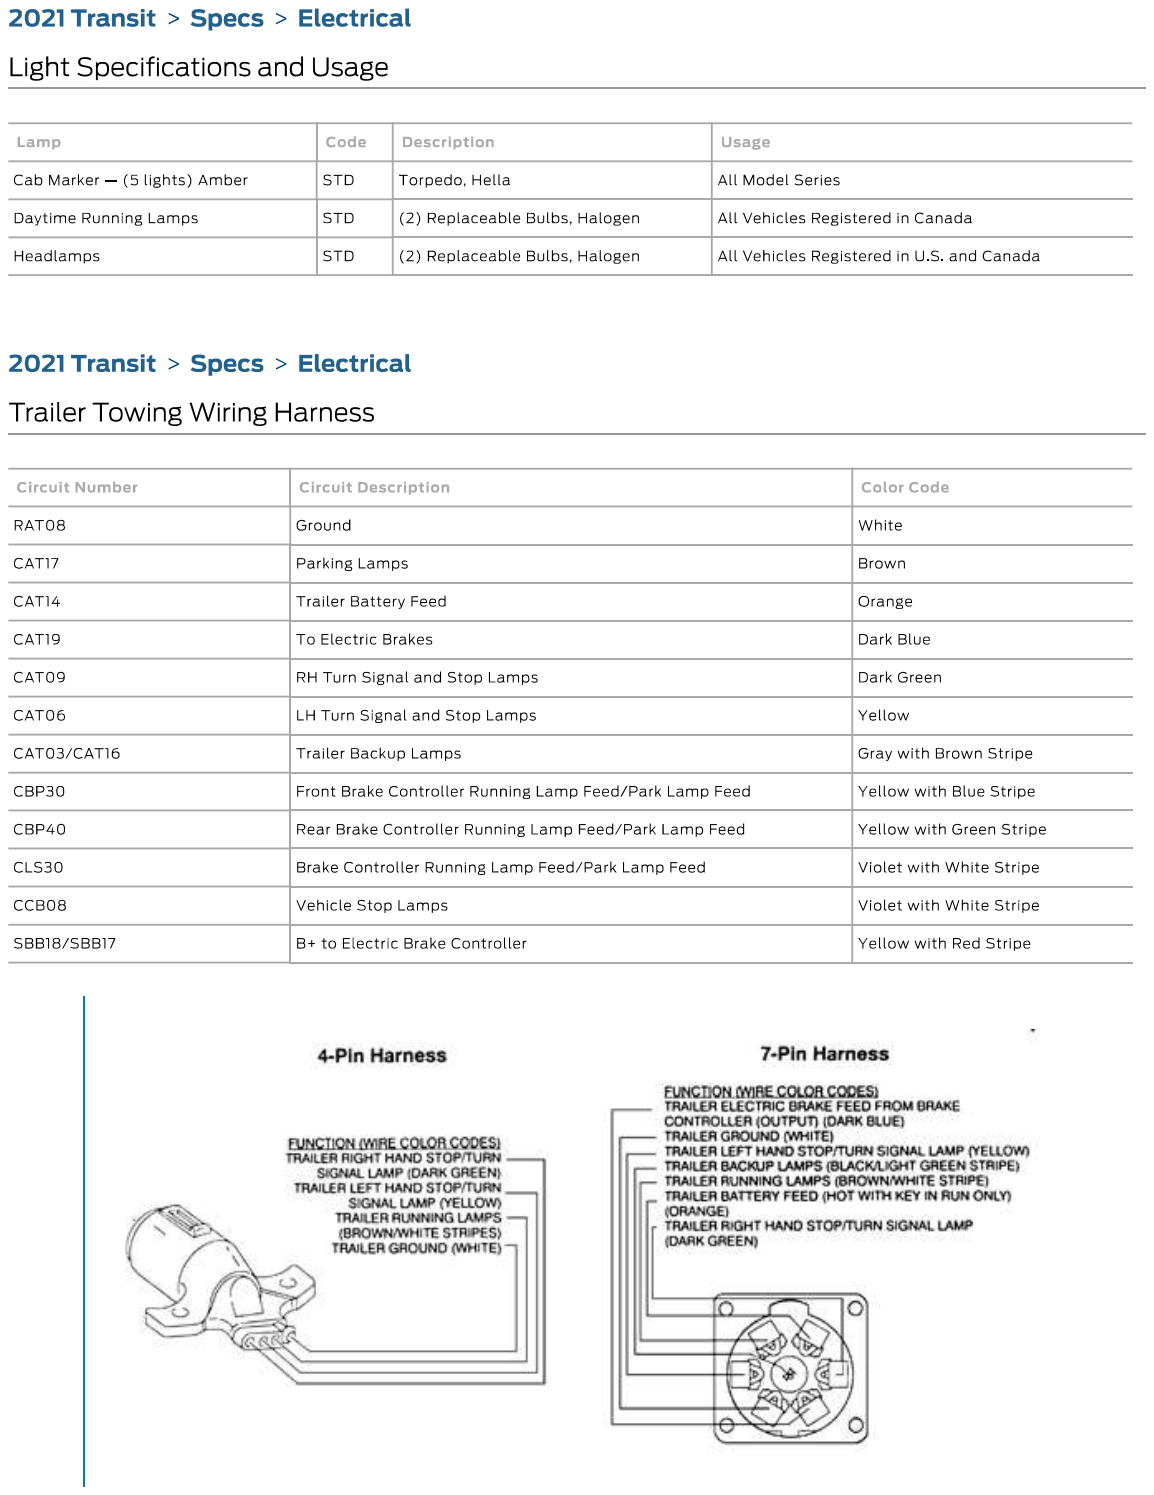
[picture p572: page 50]

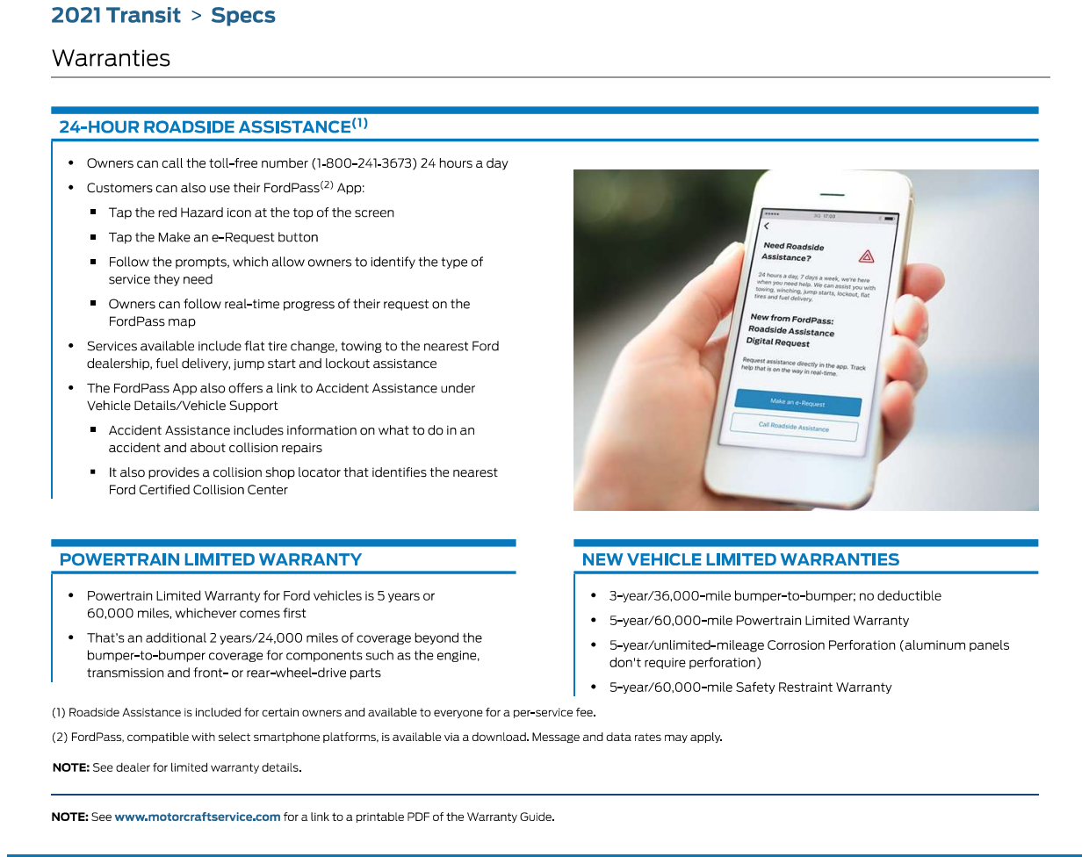
[picture p573: page 51]
