natecostello/van_two_point_oh/van/parietal/insulation/ceiling_thermal_model_thinsulate.asc

R1: res; 0.004840026
R2: res; 0.000014841
R3: res; 0.000001582
R4: res; 0.169855644
R5: res; 0.016332273
R6: res; 0.012739173
R7: res; 0.016332273
R8: res; 4.614687585
R9: res; 0.443719960
R10: res; 0.346101569
R11: res; 0.443719960
R12: res; 0.085903851
R13: res; 0.040538896
R14: res; 2.080996671
R15: res; 0.000761843
R16: res; 0.000014841
R17: res; 11.415753169
R18: res; 2.058457185
R19: res; 0.147829606
R20: res; 0
R21: res; 0.147810610
R22: res; 0.115292276
R23: res; 0.147810610
R24: res; 0.000329344
R25: res; 0.017367154
V1: voltage; 30; Rser=0
Named nets: 0
.op
